2AMLogic/gf180-rcosc/spec/README.md

# spec — ratified spec + decision records

The ratified target spec table lives in the top-level
[`README.md`](../README.md#target-specification-ratified-2026-08-20-see-issues-1-and-3).
This directory holds the **decision records** that justify each ratified
value and any future change to it: per CLAUDE.md, spec changes go through a
decision record here — agents do not relax the ratified spec to make
results pass.

```
spec/
  README.md               this file
  decision-records/
    TEMPLATE.md            copy this to start a new record
    NNNN-<slug>.md          one decision per record, numbered sequentially
```

## Decision records

One page per decision: the context that forced it, the decision itself
(stated as a concrete spec change), alternatives considered, and
consequences. See [`decision-records/TEMPLATE.md`](decision-records/TEMPLATE.md)
for the format and the numbering rule (next unused `NNNN`, checked against
every filename in this directory on `main`, including superseded records).

| Record | Title | Status |
|---|---|---|
| [0001](decision-records/0001-relaxation-oscillator-topology.md) | Relaxation-oscillator topology for the trimmable RC core | Ratified |
| [0002](decision-records/0002-target-spec-ratification.md) | Target spec ratification — frequency, trim, and PVT accuracy budget | Ratified (process spread, trim range/resolution, post-trim accuracy, and Iq rows superseded by 0003) |
| [0003](decision-records/0003-pdk-sourced-process-spread-tcr-and-iq.md) | PDK-sourced process spread, temperature drift, and Iq — superseding four rows of 0002 | Ratified (Row 3 — post-trim PVT accuracy — superseded by 0016; Rows 1, 2, 4 stand) |
| [0004](decision-records/0004-no-active-tc-compensation-runtime-discipline.md) | No active temperature-coefficient compensation — rely on runtime discipline | Ratified |
| [0005](decision-records/0005-pvt-campaign-frequency-shortfall-spec-unchanged.md) | PVT campaign confirms a frequency/accuracy shortfall in the current schematic — ratified spec unchanged | Ratified (records evidence; supersedes nothing) |
| [0006](decision-records/0006-post-resize-pvt-campaign-trim-range-and-accuracy-still-unmet.md) | Post-#16-resize PVT campaign — trim range and post-trim accuracy still unmet, ratified spec unchanged | Ratified (records evidence; realized trim-curve figures superseded by 0008) |
| [0007](decision-records/0007-quiescent-current-exceeds-target-post-resize.md) | Post-#16 quiescent current exceeds DR-0003 Row 4's target — ratified spec unchanged | Ratified (records evidence; Row 4 verdict superseded by 0008) |
| [0008](decision-records/0008-iq-metric-correction-and-bias-rebalance.md) | Bias re-balance brings Iq under DR-0003 Row 4 — and the `.op` figure 0007 used is not the quantity Row 4 names | Ratified (supersedes 0007's Row 4 verdict and 0006's trim-curve figures; supersedes no ratified target; `RBIAS` sizing and trim-curve figures superseded by 0009, metric finding not) |
| [0009](decision-records/0009-running-iq-metric-basis-and-partial-trim-range-recovery.md) | Row 4's verdict basis moves to the running Iq metric — `RBIAS` re-derived, partial trim-range recovery | Ratified (supersedes 0008's `RBIAS` sizing and trim-curve figures, not its metric finding; supersedes no ratified target) |
| [0010](decision-records/0010-postlayout-pex-pvt-frequency-shift.md) | Post-layout (PEX-extracted) PVT re-verification — layout parasitics shift frequency further below the schematic-level model, ratified spec unchanged | Ratified (records evidence; supersedes nothing; post-layout figures for the post-#39 schematic superseded by 0013 — 0010 remains valid for the pre-#39 GDS pair) |
| [0011](decision-records/0011-iq-pvt-corner-factorial-row-4-exceeds-off-reference.md) | Quiescent-current PVT-corner factorial — DR-0003 Row 4 met at the reference corner, exceeds off-reference (fast process corner, hot, high supply); ratified spec unchanged | Ratified (records evidence; supersedes nothing) |
| [0012](decision-records/0012-comparator-bias-path-pvt-revision.md) | Comparator/bias-path PVT revision — self-biased current reference, post-trim residuals re-measured, ratified rows unchanged | Ratified (records evidence; supersedes no ratified row; its "layout consequence" paragraph retired by 0013) |
| [0013](decision-records/0013-bias-cell-respin-postlayout-pex-reverification.md) | Bias-cell layout re-spin against the post-#39 schematic + post-layout (PEX) PVT re-verification — parasitic shift deepens (−11.24 % … −41.42 %), ratified rows unchanged | Ratified (records evidence; supersedes 0010's post-layout figures for the post-#39 schematic) |
| [0014](decision-records/0014-trim-bank-pass-switch-restructure.md) | Trim-bank pass-switch restructure — per-position transmission-gate shunts with locally inverted pfet gates, trim range restored (±51.36 %, first `met` since DR-0005), residual supply sensitivity re-attributed | Ratified (records evidence; supersedes no ratified row; its "layout consequence" paragraph retired by 0015) |
| [0015](decision-records/0015-trim-bank-respin-postlayout-pex-reverification.md) | Trim-bank layout re-spin against the post-#43 schematic + post-layout (PEX) PVT re-verification — parasitic shift deepens on the mean (−17.46 % … −40.92 %, mean −27.32 %), ratified rows unchanged | Ratified (records evidence; supersedes 0010's and 0013's post-layout figures for the post-#43 schematic — 0013 remains valid for the post-#39, pre-#43 GDS pair) |
| [0016](decision-records/0016-comparator-latch-delay-residue-budget.md) | Comparator/latch delay residue measured and budgeted — the delay term (62–82% of the post-trim supply span) enters the post-trim accuracy arithmetic; schematic unchanged | Ratified (supersedes 0003 Row 3: at-calibration −9.2%/+6.5%, full-range +13.4%/−17.1%; circuit-side follow-up is #57) |
| [0017](decision-records/0017-low-side-comparator-pmos-respin-supply-slope.md) | Low-side comparator re-referenced to a complementary PMOS-input cell — `t_cmp_l`'s supply span collapses 24× (delay share 62–82% → 7.6–33%), Row 4's Iq margin widens 1.24 → 24.2 µA | Ratified (supersedes 0016's Row-3 re-derivation: at-calibration −2.9%/+2.0%, full-range +8.8%/−10.8%; DR-0016's instrumentation and stage findings stand) |
| [0018](decision-records/0018-comparator-pmos-respin-postlayout-pex-reverification.md) | Comparator PMOS re-spin post-layout (PEX) PVT re-verification — always-slower −18.78%…−36.86% (mean −25.65%), worst `ff`/−40 °C/3.6 V; both DR-0017 guardrails hold extracted-side (guardrail cell −31.16% under basis; every corner calibrates inner-range, `ss` at `0xF7` with ≈+4.7% headroom — the named risk) | Ratified (supersedes 0010/0013/0015 post-layout figures for the post-#60 hierarchy; no ratified spec row changes; retires 0017's post-layout deferral) |
| [0019](decision-records/0019-statistical-vs-deterministic-spec-rows-and-monte-carlo-evidence-plan.md) | Statistical vs deterministic spec rows, and the Monte Carlo evidence plan (`klt yield`, batch-fleet `monte_carlo`, after #66) | Proposed (classification and evidence plan only; no ratified spec row changes) |
| [0020](decision-records/0020-startup-time-trimmed-accuracy-band-definition.md) | Startup-time row — "within trimmed accuracy" band definition left ambiguous, bench reports all readings | Ratified (operator ruling 2026-10-16; ratified bound not changed) |
| [0021](decision-records/0021-runtime-discipline-trim-resolution-sof-loop-model.md) | Runtime-discipline row: behavioural SOF-loop model on the committed freq-vs-code data - 8-bit/0.314 %/code interface does not meet +/-0.25 % per frame (realized step 0.41-0.47 %/code mean, 0.83 % max, four non-monotone carries); meets it as a 16-64 ms mean only with a fractional-code dither; post-layout `ss` saturates at -40 C/3.0 V (-0.343 %) | Proposed (evidence record; no ratified row changed, DR-0019 row 6 stays reserved) |
| [0022](decision-records/0022-mc-matching-model-trim-ladder-resistors-and-mim-capacitor.md) | Monte Carlo matching model for the trim-ladder resistors and MIM capacitor - injected area-scaled mismatch (flagged-assumption sigmas), netlist-body multipliers, controls, claim limits | Proposed (no ratified row changed) |
| [0024](decision-records/0024-free-running-interface-no-enable-pin.md) | `rcosc_top` stays free-running - no enable/standby pin, Iq-off is not a specified quantity (operator ruling, #131); startup origin left to #82 / 0020 | Proposed (no ratified row changed) |
| [0030](decision-records/0030-item-6-monte-carlo-campaign-results-s2-ss-and-s3-ff-fail-controls-incomplete.md) | Item-6 Monte Carlo campaign results (#202): row 4 fails at `ss` (supply span wider than the ratified window), row 5 fails at `ff`, negative controls incomplete so passing cells carry no verdict; ratified spec unchanged | Proposed (records evidence; no ratified row changed) |
| [0031](decision-records/0031-row45-cause-attribution-process-offset-dominates.md) | Rows 4/5 at the fixed code (#236): process offset (ff +28.7 %, ss -20.3 %) dominates, supply/temperature terms are a few points; ideal supply or TC levers still fail (9/21, 27/63); on the DR-0017 per-die basis both rows pass; ratified spec unchanged | Proposed (records attribution; no ratified row changed) |
| [0032](decision-records/0032-rows-4-5-per-die-calibrated-basis-and-monte-carlo-on-dr0028.md) | Rows 4/5 on the DR-0017 per-die-calibrated basis (#236, ruling 2026-11-11): Monte Carlo on the DR-0028 netlist still fails row 4 at `ss` (0 %, span 5.5-6.7 vs 4.9 points) and row 5 at `ff` (92.6 %, 85 C / 3.0 V); design change proposed, ratified spec unchanged | Proposed (records basis and evidence; no ratified row changed) |
| [0033](decision-records/0033-rows-4-5-stage-attribution-and-candidate-levers.md) | Rows 4/5 stage-level attribution on the DR-0028 netlist (#314): `ss` supply span is 49 % trim-bank charge path (3.03 of 6.13 pt), `ff` 85 C / 3.0 V skew is comparator H (+6.27 of +6.88 pt); one candidate lever per row proposed, ratified spec unchanged | Proposed (attribution only; no ratified row changed) |
(docs(spec): renumber the delay-residue record 0015 -> 0016 (collision with the concurrently-landed trim-bank re-spin record))

A record is never deleted or rewritten once ratified — a later change
supersedes it with a new record rather than editing history in place (same
append-only convention as `sim/`, see [`sim/README.md`](../sim/README.md)).
A record that supersedes only *part* of an earlier one leaves that record's
own Status field alone (0002 is still "Ratified" in its own file) and is
annotated here in the index instead — `TEMPLATE.md`'s Status field models
supersession as all-or-nothing, and rewriting it would violate the
append-only rule above.
