2AMLogic/gf180-rcosc/sim/pvt-postlayout/README.md

# sim/pvt-postlayout — post-layout (PEX-extracted) PVT re-verification (issue #28)

Per `CLAUDE.md` ("Verification is the product... `sim/` results are
append-only evidence"), this directory holds the post-layout counterpart to
`sim/pvt/`'s schematic-level PVT campaign: the same corner-endpoint subset
(process = `tt`/`ff`/`ss` x temperature = -40/+27/+85 C x
VDD = 3.0/3.3/3.6 V, 27 points) re-simulated against a parasitic-annotated
netlist extracted from the full-hierarchy `layout/cells/rcosc_top.gds`
(issue #27), at the fixed post-#24 (DR-0009) single-code post-trim
methodology's own calibration code.

```
sim/pvt-postlayout/
  README.md               this file
  pex_pvt_sweep.py         the driver (issue #28)
  run-pex-pvt-sweep.sh     wrapper: regenerates netlists, then runs pex_pvt_sweep.py
  corners/<runid>/         raw ngspice logs, one per (side, operating point)
  results/<runid>/         results.csv, manifest.json, summary.md, plus the
                            extracted netlist (rcosc_top.pex.spice) and the
                            `klt extract` JSON report -- exactly what was
                            compared, committed as evidence
```

**Regenerate / extend the evidence**:

```bash
# Requires: ngspice, xschem, klt, python3, and a gf180mcuC PDK resolvable
# the same way design/regen-netlist.sh resolves it.
sim/pvt-postlayout/run-pex-pvt-sweep.sh
```

Default `--jobs` is 2 (shared hosts); grids of more than a handful of corners belong in a `klt sim` corners request (see sim/startup/README.md, Run section); this driver is for single-unit/debug use or dedicated simulation hosts.

Two knobs added by issue #61, both opt-in (the default path is
byte-identical to issue #28's flow):

- `--guardrails` additionally re-verifies the current decision record's
  schematic-basis guardrails against the extracted netlist inside the same
  run — since DR-0018, DR-0017's two: the Row-4 guardrail cell
  (`0x80`/`ff`/85 °C/3.6 V) on both sides vs the schematic baseline's own
  `pretrim` row at that cell, and a per-process (`tt`/`ff`/`ss`)
  single-point trim calibration at 27 °C/3.3 V against the ratified
  48.000 MHz target on both sides (the same binary search
  `sim/pvt/pvt_sweep.py`'s `calibrate` performs). Results land in the
  run's `guardrails.csv`, the manifest's `guardrails` key, and the
  summary's guardrail sections.
- `--baseline-runid <runid>` selects the schematic campaign explicitly.
  The default auto-picks the newest `sim/pvt/results/<runid>/` — which is
  wrong the moment the newest run is a probe campaign whose manifest
  carries no `calibration_spec_target` (exactly what happened when
  DR-0017's `20260923T030905Z` delay-probe run landed): pass
  `--baseline-runid` naming the calibration campaign the comparison
  should anchor to.

## Methodology

Each of the 27 points is simulated **twice**, sharing everything (the
`design/netlist/pvt_tb.spice` harness -- VDD/VT0..VT7 sources, transient
measurement window) except the DUT body:

- **schematic side**: `design/netlist/pvt_tb.spice` unmodified -- the exact
  netlist `sim/pvt/pvt_sweep.py` itself simulates.
- **extracted side**: the same harness with only the embedded
  `.subckt rcosc_top ... .ends` region swapped for `klt extract
  --parasitics`'s own output (header pin order rewritten to match, see
  `pex_pvt_sweep.py`'s `reorder_extracted_header` docstring).

## Why not `klt pex` / `klt sim` request JSON files verbatim

`klt pex --help` (confirmed on the installed build, `klt 0.4.0`) is real and
does exactly what its docstring says: "extract a parasitic-annotated
netlist from a routed layout (`klt extract --parasitics`), re-run one or
more `klt sim` testbench requests against it per corner, and report a
per-corner, per-spec-row schematic-vs-extracted delta." It was not used
directly here for two concrete, checked reasons:

1. **No `--deck-option`/`--pins` passthrough.** `klt extract` (the
   subcommand `klt pex` drives internally) accepts `--deck-option
   poly_res=1k --deck-option mim_cap=cap_mim_1f0_m4m5_noshield` to select
   the exact resistor sheet-rho and MiM-cap density this design commits to
   (`layout/run_checks.sh`, DR-0003 sec 5.1/6.1) -- `klt pex`'s own
   `--help` output has no equivalent flags. `poly_res` happens to default
   to this design's `1k` choice, but `mim_cap` defaults to
   `cap_mim_2f0_m4m5_noshield` (2x this design's actual 1.0 fF/um^2
   density) -- running `klt pex` directly would silently extract the
   *wrong* MiM-cap density for this design's own drawn timing capacitor,
   invalidating every delta it reports. Confirmed by reading
   `klayout_tools/decks/gf180mcu.py`'s own flavour-default documentation,
   not assumed.
2. Even with that gap fixed, `klt sim`'s request-JSON `corners.supply_v`
   axis only supports `alter <source>=<value>` (an independent-source
   magnitude), not a `.param` sweep -- and this testbench's `.meas ...
   when v(clk)=<vdd/2> rise=N` threshold needs the VDD value at `.meas`-card
   authoring time, not post-elaboration. Reusing `sim/pvt/pvt_sweep.py`'s
   own already-proven deck composition (`compose_deck`, run per point) both
   sidesteps this and is the literal "reuse `sim/pvt/`'s existing
   testbench/sweep infrastructure" the issue asks for.

`klt extract --parasitics` (the extraction half) **is** used directly, with
the correct deck options -- see `pex_pvt_sweep.py`'s `run_extract`. Both
gaps above, plus a third (`klt extract --pdk <variant> --parasitics`
annotating its one recognised MiM-cap *device* card with a non-numeric,
non-`.model`-backed flavour-name token that ngspice's native `C`-element
parser refuses to parse -- see `pex_pvt_sweep.py`'s
`CAP_MODEL_TAG_RE`/`strip_capacitor_model_annotations` docstring for the
full mechanism and the one-line fix applied here) were filed as friction
against `2AMLogic/klayout-tools` per `CLAUDE.md`'s friction protocol
(tool-generic description, no design-specific detail):
[2AMLogic/klayout-tools#1558](https://github.com/2AMLogic/klayout-tools/issues/1558).

## Committed runs

| Run id | Notes |
|---|---|
| [`20260907T131703Z`](results/20260907T131703Z/summary.md) | First post-layout PEX PVT re-verification (issue #27's `rcosc_top.gds`, issue #28). 27-point corner-endpoint subset, both sides, 0 failed runs. **Materially diverges**: schematic-vs-extracted delta is negative (slower) at every point, -1.88% to -29.52%, exceeding the +-1.1% calibration-point accuracy budget on its own. See [DR-0010](../../spec/decision-records/0010-postlayout-pex-pvt-frequency-shift.md). *Superseded for the post-#39 schematic by the issue-#44 run below; figures valid only against the pre-#39 GDS pair.* |
| [`20260921T164434Z`](results/20260921T164434Z/summary.md) | Post-layout PEX PVT re-verification of the **re-spun** bias cell (issue #44's `rcosc_bias.gds`/`rcosc_top.gds`, against the post-#39 schematic campaign `sim/pvt/results/20260921T075822Z/` at its own calibration code `0xD0`). 27-point corner-endpoint subset, both sides, 0 failed runs, 203.4 s at 8 jobs. **Materially diverges, deeper than the pre-#39 pass**: delta negative (slower) at every point, -11.24% to -41.42% (mean -19.56%), worst at `ff`/-40 C/3.6 V; in-run schematic-side cross-check vs the committed campaign: 0.00% at matched points. See [DR-0013](../../spec/decision-records/0013-bias-cell-respin-postlayout-pex-reverification.md). *Superseded for the post-#43 schematic by the issue-#50 run below; figures valid only against the pre-#43 GDS pair.* |
| [`20260922T004322Z`](results/20260922T004322Z/summary.md) | Post-layout PEX PVT re-verification of the **re-spun** trim bank (issue #50's `rcosc_trim_bank.gds`/`rcosc_top.gds`, against the post-#43 schematic campaign `sim/pvt/results/20260921T173529Z/` at its own auto-read ratified-target calibration code `0x9D`). 27-point corner-endpoint subset, both sides, 0 failed runs, 338.0 s at 8 jobs. **Materially diverges, deeper on the mean than the pre-#43 pass**: delta negative (slower) at every point, -17.46% to -40.92% (mean -27.32%), worst at `ff`/-40 C/3.6 V; in-run schematic-side cross-check vs the committed post-#43 campaign: 0.18% at matched points. See [DR-0015](../../spec/decision-records/0015-trim-bank-respin-postlayout-pex-reverification.md). *Superseded for the post-#60 schematic by the issue-#61 run below; figures valid only against the pre-#57 GDS pair.* |
| [`20260923T152954Z`](results/20260923T152954Z/summary.md) | Post-layout PEX PVT re-verification of the **DR-0017 re-spun** comparator hierarchy (`rcosc_comparator_p`/`rcosc_top.gds`, against the post-#60 schematic campaign `sim/pvt/results/20260923T030125Z/` at its own calibration code `0xA3`, selected via `--baseline-runid` — the newest `sim/pvt/results/` run is DR-0017's delay-probe campaign, which carries no calibration manifest). 27-point corner-endpoint subset, both sides, 0 failed runs, 166.3 s at 8 jobs (`klt 0.4.0` pinned per `layout/run_checks.sh`, ngspice-46, Linux host). **Materially diverges, same always-slower sign and worst-corner signature**: delta negative at every point, -18.78% to -36.86% (mean -25.65%), worst at `ff`/-40 C/3.6 V; in-run schematic-side cross-check vs the committed DR-0017 campaign: 0.00% at matched points. **Both DR-0017 guardrails hold extracted-side** (this run's `--guardrails` pass): the Row-4 guardrail cell `0x80`/`ff`/85 C/3.6 V runs 31.16% below its DR-0017 campaign basis, and every corner still calibrates inner-range against 48.000 MHz (`tt 0xA3→0xD9`, `ff 0x59→0xB3`, `ss 0xCD→0xF7`), none saturated — `ss` with 8 LSBs / ≈+4.7% headroom to `0xFF`. See [DR-0018](../../spec/decision-records/0018-comparator-pmos-respin-postlayout-pex-reverification.md). |

## `klt pex` layer (issue #70)

`klt-pex/` holds the `klt pex` testbench requests for the grader-readable
item-7 layer (`signoff/README.md`): `gen_requests.py` writes three requests
(one per VDD, tt/ff/ss x -40/27/85 C), their testbench bodies, and a schematic
DUT wrapper from `design/netlist/pvt_tb.spice`. Trim code `0xA3`. The earlier
"why not `klt pex`" reasons are resolved in the pinned build: `--deck-option` and
`--pins` now exist. Two remaining gaps are filed as klayout-tools#2890 (pin
order) and #2891 (relative include on the local backend).

Status: the 27-point grid is **not yet run**; the batch fleet runner (klt 0.5.0)
rejects every batch-capable client. The only committed `klt pex` output is the
single-corner probe in `results/20261008T220500Z/klt-pex-probe/` (tt / 27 C /
3.3 V; command in `COMMAND.txt`). The probe's testbench carries an absolute
include path (local backend), so it is not portable. To produce the full report
once a compatible client exists, run `klt pex layout/cells/rcosc_top.gds
sim/pvt-postlayout/klt-pex/request_v{30,33,36}.json` with the flags in
`COMMAND.txt` and `--backend batch`, one run per request.

## PDK revision provenance (issue #65)

New manifests carry `pdk_revision` (an open_pdks commit, or `"unknown"` with
`pdk_revision_reason`), `pdk_revision_source`, and a root-relative
`model_dir`; no absolute install paths. See [`../README.md`](../README.md)
and [`../pdk_provenance.py`](../pdk_provenance.py).

Committed runs predate the field and are not rewritten. The simulation half
of each records only family and install path; the only revision evidence is
the committed `klt extract` envelope: `open_pdks c6d73a35...` for
`20260923T152954Z`, `open_pdks f6eeac7d...` for `20260921T164434Z` and
`20260922T004322Z`. Earlier runs are not asserted here.
