2AMLogic/gf180-rcosc/WORK_PLAN.md

# Work Plan

This roadmap is generated from the current GitHub label state by the Loom Guide role.

<!-- guide:plan-body:start -->
## Operator Attention: Merge-Risk-Hold Pileup

Judge-approved PRs under a hold (`loom:blocked` or `loom:operator`) — only a human merge decision is missing.

_None._

## Very Important

`loom:very-important` (one counts per workspace); every stage takes these first.

_None._

## Important

`loom:important`; taken before unlabelled work.

- **#70**: Item 7: produce a grader-readable klt pex report for the current rcosc_top layout
- **#87**: Dense 256-code freq-vs-code sweep and trim-bank monotonicity verdict (DR-0021 follow-ups a, b)

## Ready

Human-approved issues ready for implementation (`loom:issue`).

_None._

## In Progress

Issues currently being built (`loom:building`).

- **#87**: Dense 256-code freq-vs-code sweep and trim-bank monotonicity verdict (DR-0021 follow-ups a, b)
- **#321**: Row 5: make comparator-H trip track supply to fix ff hot/low-V delay collapse

## PRs Awaiting Review

PRs waiting on Judge (`loom:review-requested`).

- **#312**: sim(trim-dense): run slice 41, 42 more sch_ff curve jobs on batch fleet (948/1536)

## Approved (Awaiting Merge)

PRs that passed review and are queued for Champion auto-merge (`loom:pr`).

_None._

## Proposed

Issues carrying `loom:curated`.

- **#87**: Dense 256-code freq-vs-code sweep and trim-bank monotonicity verdict (DR-0021 follow-ups a, b) *(curated)*
- **#204**: Move layout geometry pin klt 0.4.0 → 0.8.0 and regenerate committed cells/reports *(curated)*
- **#321**: Row 5: make comparator-H trip track supply to fix ff hot/low-V delay collapse *(curated)*

## Proposed (Architect / Hermit)

_None._

## Epics

- **#5**: Track the gap to T1 sim-validated / bronze (klayout-tools design-evidence tiers)

## Backlog Balance

| Bucket | Count |
|---|---|
| Operator merge-risk holds | 0 |
| Very important | 0 |
| Important | 2 |
| Ready (`loom:issue`) | 0 |
| In Progress (`loom:building`) | 2 |
| PRs awaiting review | 1 |
| Approved PRs awaiting merge | 0 |
| Curated | 3 |
| Architect / Hermit proposals | 0 |
| Active epics | 1 |
<!-- guide:plan-body:end -->
