2AMLogic/gf180-rcosc/.loom/docs/repo-owned-files.md

# Repo-owned files inside `.loom/`

`.loom/` is a Loom-managed tree, but it is not *exclusively* Loom's. Some of it
is an **extension point**: `.loom/hooks/post-worktree.sh`, for example, is a
file Loom never ships and always invokes (`worktree.sh` runs it after creating
a worktree), so a repo that wants per-worktree setup is *expected* to add its
own file there.

This page states the ownership rule the installer applies, and how a repo
declares "this file is mine" so an upgrade cannot delete it.

## The rule

On reinstall (`install.sh --confirm-reinstall`, `loom update`, a direct
`loom-daemon init --force`), Loom cleans each managed `.loom/` directory —
`roles/`, `scripts/`, `hooks/`, `docs/`, `runtimes/`, `bin/` — before copying
the new version in. A file already sitting in one of those directories is
**deleted only when Loom can attribute it to itself**:

| Evidence | Outcome |
|---|---|
| The current `defaults/` tree ships a file at that path | **Removed**, then immediately re-copied (net effect: refreshed) |
| The path is pinned in `.loom/resync-ignore` | **Preserved** — declared repo-owned |
| The path is listed in `.loom/install-metadata.json`'s `installed_files` | **Removed** — Loom installed it, so Loom may retire it |
| None of the above | **Preserved** and reported as unmanaged |
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
