2AMLogic/gf180-rcosc/signoff/testbench-inventory.md

# Testbench inventory (T1 item 9)

The audited artifact `signoff/testbench-envelope.json` is bound to (the
envelope pins this file's sha256; `klt signoff` re-hashes it on every grade,
and `signoff/verify-report.py` re-checks the pin in CI). Editing this file
without refreshing the envelope and the manifest pin turns item 9 `unmet`
(`stale_evidence`) and fails the verifier.

What the binding proves, and what it does not: it proves that this list is
the exact text that was audited. `klt signoff` does not re-audit a testbench
list, and it does not open the benches or the result directories named here.
`signoff/verify-report.py` additionally checks that every path in the first
column of the tables below exists in the tree. Whether each claim is
*correct* is a separate question, answered by the ratified-spec verdicts in
`docs/chipalooza/challenge-5-proposal.md` §4 (item 8), not by this list.

## Benches and their cold-start commands

Commands run from the repository root on a host with `ngspice`, `xschem`,
`python3` and a gf180mcuC PDK install (resolved from `PDK_ROOT`, or
`klt pdk find --pdk gf180mcuC`). The post-layout bench also needs `klt`.
Every wrapper regenerates `design/netlist/*.spice` from the committed
schematics first (`design/regen-netlist.sh`), so a cold start always runs
against the current design.

| path | bench | cold-start command |
|---|---|---|
| `sim/pvt/run-pvt-sweep.sh` | PVT-corner campaign: `design/pvt_tb.sch` (netlisted to `design/netlist/pvt_tb.spice`) driven by `sim/pvt/pvt_sweep.py` (full 7-process x 3-temperature x 3-supply factorial, trim curve, single-point calibration, pre-/post-trim passes) | `sim/pvt/run-pvt-sweep.sh` |
| `sim/pvt/delay_probe.py` | comparator/latch stage-delay instrumentation (issue #51); reuses `pvt_sweep.py`'s deck composition. **No wrapper script**: it does not regenerate the netlist itself | `design/regen-netlist.sh && python3 sim/pvt/delay_probe.py --cal-from sim/pvt/results/<calibration runid>` |
| `sim/iq/run-iq-sweep.sh` | quiescent-current sweep: `design/smoke_test.sch` (netlisted to `design/netlist/smoke_test.spice`, its `.control` replaced) driven by `sim/iq/iq_sweep.py` over the full 63-point PVT grid at a fixed code set | `sim/iq/run-iq-sweep.sh` |
| `sim/pvt-postlayout/run-pex-pvt-sweep.sh` | post-layout re-verification: `klt extract --parasitics` on `layout/cells/rcosc_top.gds`, then `sim/pvt-postlayout/pex_pvt_sweep.py` simulates schematic vs extracted netlist on the 27-point corner-endpoint subset | `sim/pvt-postlayout/run-pex-pvt-sweep.sh --guardrails --baseline-runid <calibration runid>` |
| `sim/startup/gen_requests.py` | startup-time bench (issue #78): `klt sim` corners requests `sim/startup/request_v{30,33,36}.json` (7 process x 3 T each, one per supply = 63 points; corner definitions imported from `sim/pvt/pvt_sweep.py`), post-processed by `sim/startup/startup_report.py`. No ngspice wrapper: the factorial is a `klt sim` batch request | `python3 sim/startup/gen_requests.py && klt sim sim/startup/request_v33.json -o OUT/v33 --format json` (see `sim/startup/README.md`) |
| `sim/mc-groundwork/run-groundwork.sh` | item-6 Monte Carlo **groundwork** (issue #77), not a spec-row claim: per-sample trim-code selection bench (`sim/mc-groundwork/tb_trimsel_nomm.spice`, `tb_trimsel_mm.spice`), fixed-code reference (`tb_fixedcode.spice`) and the `klt sim` requests, generated by `sim/mc-groundwork/gen_bench.py` from `design/netlist/pvt_tb.spice`; the committed smoke run (3-sample zero-mismatch control, 5-sample mismatch smoke) is `sim/mc-groundwork/results/20261008T235620Z/`. Records the model mismatch-feasibility verdict in `sim/mc-groundwork/README.md`. **No yield is run or claimed** | `sim/mc-groundwork/run-groundwork.sh` (needs `klt`; the multi-sample requests go to the batch fleet on a host exporting `KLT_SIM_BACKEND=batch`, which was not usable on 2026-10-08; the committed smoke run was a `--backend local` fallback, a deviation from the batch-only host rule, see its README) |
| `sim/mc/run-campaign.sh` | item-6 Monte Carlo **campaign** (issue #202; DR-0019 S1-S3, DR-0022 matching model): per-die trim-selection bench on the **P3 extracted netlist** (`sim/recentre/p3/rcosc_top_p3.spice`, DR-0023, proposed) with the DR-0022 injector applied, generated by `sim/mc/gen_campaign.py`; each die is calibrated at 27 C / 3.3 V then holds its code at 3 supplies x 3 temperatures; 500 samples per process corner (tt/ff/ss), seed 20261008, `klt sim` `monte_carlo` requests sharded on the batch fleet; controls: zero-mismatch, 3x inflated, injected-term sensitivity. Graded by `sim/mc/grade.sh` (`klt yield` at the repo pin) into `sim/mc/results/20261106T072000Z/`; raw reports in `sim/mc/results/20261106T051700Z/`, `20261106T061800Z/`, `20261106T070700Z/`. Pipeline validation runs: `20261106T052000Z`, `20261106T052500Z`, `20261106T053000Z`. Result and verdict: `sim/mc/README.md`, DR-0030 | `sim/mc/run-campaign.sh <new runid> [case ...]` then `sim/mc/grade.sh <new gradeid> <run dir> ...` (needs `klt` with batch access; every case is a `klt sim` request and none runs a local ngspice loop) |
| `sim/temperature/prepare.py` | interior-temperature curvature bench (issue #125), **offline preparation only, measured status pending**: three `klt sim` requests (tt/ss/ff, 12 temperatures -40..85 C including 27 C, 3.3 V, no added clk load = 36 points) at the per-process ratified-target codes held from `sim/pvt/results/20260923T030125Z` (0xA3/0xCD/0x59), reusing `sim/waveform/prepare.py`'s DUT extraction, bench and request builders; post-processed by `sim/temperature/analyze.py` (slopes, residual vs the -40/27/85 C piecewise-linear interpolation, 100 ppm diagnostic tolerance). Generated files are written to a new directory, not committed. Schematic equivalence with the calibration revision is recorded as unverified. **No measurement exists and no figure is claimed** | `python3 -I sim/temperature/prepare.py --cal-run sim/pvt/results/20260923T030125Z --out <new dir>`, then `klt sim <new dir>/request_t12_<proc>.json -o OUT/<proc> --format json --backend batch` (later campaign; see `sim/temperature/README.md`) |
| `design/run-smoke-test.sh` | functional/DC bring-up bench `design/smoke_test.sch`: `.op` plus a short transient at code `0x80`. Appends to `design/netlist/smoke_test.log`. **Not a spec-row claim** | `design/run-smoke-test.sh` |

Supporting bench sources (each listed so it is visible that it is committed):

| path | role |
|---|---|
| `design/pvt_tb.sch` | the PVT testbench schematic (DUT + VDD/VT0..VT7 sources + measurement window) |
| `design/smoke_test.sch` | the bring-up testbench schematic; also the DUT harness the Iq sweep reuses |
| `sim/pvt/pvt_sweep.py` | PVT campaign driver; owns the process-corner, temperature and supply definitions the other drivers import |
| `sim/iq/iq_sweep.py` | Iq sweep driver |
| `sim/pvt-postlayout/pex_pvt_sweep.py` | post-layout sweep driver |
| `sim/startup/startup_report.py` | startup-time post-processor |
| `sim/mc-groundwork/gen_bench.py` | Monte Carlo groundwork bench and request generator (issue #77) |
| `sim/mc/gen_campaign.py` | item-6 campaign bench, request and limits generator (issue #202); offline tests in `sim/mc/test_gen_campaign.py` |
| `sim/mc/analyze.py` | control and per-die summary of a graded campaign (issue #202) |
| `sim/mc/grade.sh` | `klt yield-samples` + `klt yield` grading of the campaign reports (issue #202) |
| `sim/temperature/analyze.py` | interior-temperature slope/curvature analyzer (issue #125); tested on synthetic fixtures only |

A cold start reproduces the *method* against the *current* design. It does
not reproduce a historical run's numbers when the design has changed since
then. To reproduce a historical figure, check out the run's recorded
`git_sha`. Several runs below record `git_dirty: true` (uncommitted changes
were present when they ran), so that checkout is close to the run's tree,
not guaranteed identical to it.

## Claimed measurements, bench, and recorded PDK identity

Every measured figure the top-level `README.md` spec table and maturity
ladder, or `docs/chipalooza/challenge-5-proposal.md` §4, currently quotes is
listed here against the committed run it comes from. Superseded runs under
`sim/*/results/` were produced by the same benches and remain as
append-only history (indexed in `sim/README.md`). They are not current
claims, so they are not listed one by one.

| path | claim(s) it backs | bench | git sha (dirty?) | PDK identity the run records |
|---|---|---|---|---|
| `sim/pvt/results/20260907T090653Z/summary.md` | char. report rows 1-4, 8, 11: max reachable 58.9870 MHz; trim range ±35.50%; 0.4317 %/code average step; untrimmed spread −26.34%/+42.68%; 3.0/3.3/3.6 V and −40/27/85 °C exercised | `sim/pvt/run-pvt-sweep.sh` | `1362e1a` (dirty) | family `gf180mcuC` + install root path only. **No revision** |
| `sim/pvt/results/20260921T075822Z/summary.md` | char. report rows 5-6: post-trim accuracy, global-code and per-corner-code methodologies, calibration point and full temperature range | `sim/pvt/run-pvt-sweep.sh` | `1ac4434` (dirty) | family `gf180mcuC` + install root path only. **No revision** |
| `sim/pvt/results/20260923T030125Z/summary.md` | README spec table: measured supply span at per-corner calibrated codes (−2.07%/+1.17%) behind the DR-0017 post-trim rows; also the calibration baseline the post-layout run anchors to | `sim/pvt/run-pvt-sweep.sh` | `ed26786` (clean) | family `gf180mcuC` + install root path only. **No revision** |
| `sim/pvt/results/20260922T004823Z/summary.md` | README spec table: delay share of the supply span before the issue #57 re-reference (62-82%, DR-0016) | `sim/pvt/delay_probe.py` | `bd57830` (dirty) | family `gf180mcuC` + install root path only. **No revision** |
| `sim/pvt/results/20260923T030905Z/summary.md` | README spec table: delay share of the supply span after the issue #57 re-reference (7.6-33%) | `sim/pvt/delay_probe.py` (`--cal-from` `20260923T030125Z`) | `ed26786` (dirty) | family `gf180mcuC` + install root path only. **No revision** |
| `sim/iq/results/20260921T091042Z/README.md` | char. report row 9: running Iq at the reference corner (worst 330.38 µA at `0xFF`) and over the full 63-point grid (541.85 µA at `0xC0`, `ff`/85 °C/3.6 V) | `sim/iq/run-iq-sweep.sh` | `1ac4434` (dirty) | `manifest.json` records the install root path only. The family name `gf180mcuC` appears only in the generated `README.md`. **No revision** |
| `sim/pvt-postlayout/results/20260923T152954Z/summary.md` | char. report post-layout divergence note and README maturity ladder: extracted runs −18.78% to −36.86% slower than the schematic at `0xA3` (mean −25.65%); DR-0017 guardrails held extracted-side; `ss` calibrates at `0xF7` | `sim/pvt-postlayout/run-pex-pvt-sweep.sh` (`--guardrails --baseline-runid 20260923T030125Z`) | `89399c6` (dirty) | `manifest.json`: family `gf180mcuC` + install root path. The committed `rcosc_top.pex.extract.json` (the `klt extract` half) records `open_pdks c6d73a35f524070e85faff4a6a9eef49553ebc2b` for the install it resolved under the same root. The simulation half does not record a revision of its own |
| `sim/startup/results/20261106T052948Z/summary.md` | char. report row 10, **simulated** (ngspice-46, pre-layout schematic netlist) on the **pre-re-centre schematic at `0xA3`** (before DR-0023/DR-0028; history, not the current design): 61/63 PASS, 2 FAIL, under the DR-0020 definition (+/-1.1% of final mean period, 8-cycle windows, <= 10 µs from ramp start, trim `0xA3`): worst passing settle 1.174 µs (`ss`/-40 °C/3.0 V); `ff`/-40 °C at 3.3 V and 3.6 V FAIL the settled-tail steadiness check (0.78% / 0.61% vs 0.5%). Relative settling only: not a target-accurate / USB-ready clock claim | `sim/startup/gen_requests.py` + `klt sim` on the batch backend (jobs `klt-sim-971dfc731fe7`, `klt-sim-b591e450d02c`, `klt-sim-fbe71ced6e21`) + `startup_report.py` | `d157152e` (base; tree dirty with the result dir only) | `klt sim` reports record the models-lib sha256; runner `eda-batch-runner` v11, family `gf180mcuC`, open_pdks `f6eeac7`; no revision |
| `sim/startup-settled/results/20261106T061500Z/summary.md` | char. report row 10, **simulated**, current design before DR-0028 (settled P3 netlist, trim `0xA9`, DR-0020 analysis): 61/63 start; `fs`/-40 °C at 3.3 V and 3.6 V NON-START (#227) | `sim/startup-settled/` requests + `klt sim` on the batch backend + `settled_report.py` | per the run's `manifest.json` | batch-fleet `klt sim` reports; PDK revision not independently re-checked in this PR |
| `sim/startup-settled/results/20261106T0735Z/summary.md` | char. report row 10, **simulated**, current design on the DR-0028 comparator-H stage (trim `0xA9`): 63/63 pass the primary band, worst settle 1.54 µs, 0 NON-START | same, with `sim/cmph-fix/` netlist (#229) | per the run's `manifest.json` | batch-fleet `klt sim` reports (jobs `klt-sim-829a270ff52b`, `klt-sim-58ef1d67a0ce`, `klt-sim-4e366a98ed46`); PDK revision not independently re-checked in this PR |
| `sim/startup/results/20261008T235538Z/summary.md` | char. report row 10 (**partial**): two single-corner local probes only (`ss`/-40 °C/3.0 V settles 1.174 µs, `tt`/27 °C/3.3 V 0.891 µs, at ±1.1%); the 63-point factorial did not run (fleet runner klt 0.5.0 vs client 0.7.0; failed submissions in `sim/startup/batch-attempts/`) | `sim/startup/gen_requests.py` + `klt sim` (`--backend local` for the probes) | `b5d4f5c` (base; the bench files were uncommitted when run) | `klt sim` report records the models-lib sha256; family `gf180mcuC`; no revision |
| `design/netlist/smoke_test.log` | bring-up only: the block oscillates at `0x80`, `.op` sanity values. **No spec-row claim** | `design/run-smoke-test.sh` | not recorded | **None**: the log records the ngspice version and run time, not the PDK family or revision |

### PDK identity, stated plainly

- **Family name only, no revision:** every pre-layout PVT campaign and both
  delay-probe runs above. Their manifests record `pdk: "gf180mcuC"` and the
  install root path, nothing that identifies the open_pdks/volare revision
  of the model files.
- **Install path only in the manifest, family name only in the README:**
  the Iq run.
- **Revision recorded (extraction only):** the current post-layout run's
  `klt extract` envelope records an open_pdks commit. The ngspice side of
  the same run records family and root only. Earlier post-layout runs
  record a different commit
  (`20260921T164434Z`/`20260922T004322Z`: `open_pdks
  f6eeac7dad085ffcc829ccfd721f7b4ce39edcf7`). Different runs were
  therefore not guaranteed to use the same PDK revision.
- **Nothing recorded:** the smoke-test log.

The historical revision behind a family-only run is **unknown**. It is not
reconstructed here and must not be assumed. New runs
(issue #65) record `pdk_revision`, or an explicit `"unknown"` with a reason,
through the shared `sim/pdk_provenance.py`, with no absolute install path.
Every record listed above predates that and is unchanged; its PDK identity
stays as disclosed here.

## Spec rows with no measurement claimed (no bench expected)

- Ratified row "Runtime-disciplined accuracy" (characterization report
  row 7): reserved, not designed (DR-0004). No measurement is claimed and
  no bench exists.
- Ratified row "Startup time" (characterization report row 10): **simulated
  (not measured; no silicon exists)** (issue #82) under the operator-ratified
  DR-0020 definition (relative settling, +/-1.1% of final mean period,
  <= 10 µs from ramp start). Two designs are graded: the pre-re-centre
  schematic at fixed trim `0xA3` (`sim/startup/results/20261106T052948Z/`,
  history) is 61/63 PASS, 2 FAIL (`ff`/-40 °C at 3.3 V and 3.6 V fail the
  settled-tail steadiness check); the current design is in
  `sim/startup-settled/results/` at trim `0xA9`: 61/63 on the DR-0023 settled
  netlist (`fs`/-40 °C NON-START, #227) and 63/63 on the DR-0028 stage (worst
  settle 1.54 µs). The trim-code clause of DR-0020 (`0xA3` vs the design's
  `0xA9`) awaits an operator ruling, so the row is not claimed as passed
  under a conforming code. Relative
  settling does not imply target-accurate or USB-ready clock availability;
  that is graded by the separate frequency and PVT-accuracy rows.
- Monte Carlo / statistical (item 6): **run, and not a pass.** The campaign
  (issue #202, `sim/mc/`) ran 500 samples per process corner on the P3 netlist
  under the DR-0022 flagged matching model. Row 4 fails at `ss` (0 % yield) and
  row 5 fails at `ff` (60.4 % yield); the remaining row sets pass at the
  point-estimate level, but the negative controls were not detected for most of
  them and the sensitivity control missed on one transition, so those carry no
  verdict (`sim/mc/README.md`, DR-0030). Item 6 grades `unmet`. The
  groundwork `sim/mc-groundwork/` (issue #77) holds the per-sample bench
  and the mismatch-model feasibility verdict.
- Interior-temperature curvature (between the -40/27/85 C grid points):
  **prepared offline only, measured status pending** (issue #125). The
  bench `sim/temperature/` exists and is exercised by synthetic-fixture
  tests; no corner has been simulated, so no curvature or monotonicity is
  claimed. The discipline plant (DR-0021, `sim/discipline/`) stays based on
  the three committed temperatures.

## Audit (issue #64, against `origin/main` @ `dfb95bf`)

- Every path above is committed (`git ls-files`).
- Each claim row was checked against the cited run's committed
  `manifest.json`/`summary.md` (git sha, dirty flag, PDK fields) and the
  figure as quoted in `README.md` / `docs/chipalooza/challenge-5-proposal.md`.
- The committed testbench netlists `design/netlist/pvt_tb.spice` and
  `design/netlist/smoke_test.spice` were re-derived from the committed
  schematics into a scratch directory and compared after the same
  normalisation as item 1's audit (continuations, blank lines, `sch_path`/
  `sym_path` comments): **identical**.
- No simulation was re-run for this audit.
