2AMLogic/gf180-rcosc/sim/iq/results/20260923T031214Z/README.md

# Quiescent current (Iq) PVT-corner sweep 20260923T031214Z — issue #35

Generated by `sim/iq/iq_sweep.py` (issue #22, extended #24, extended
to a full PVT-corner factorial by issue #35). Append-only evidence:
this file, `results.csv`, `manifest.json` and every raw log under
`sim/iq/corners/20260923T031214Z/` belong to this run id and are never
rewritten by a later run.

| | |
|---|---|
| git sha | `ed26786191202a85a71b6938563c45a1eaaa5582` (dirty tree) |
| ngspice | ** ngspice-46 : Circuit level simulation program |
| PDK | gf180mcuC @ `/home/ubuntu/.volare` |
| netlist | `design/netlist/smoke_test.spice` (from `design/smoke_test.sch`) |
| sizing | `as-committed` only (see module docstring for why `pre-22` is not part of the grid) |
| subset | `full` (7 process corner(s) x 3 T x 3 V = 63 points/code) |
| codes | 0x00, 0x80, 0xC0, 0xFF |
| total grid points | 252 (0 failed) |
| wall clock | 221.7 s at 8 jobs |
| target | DR-0003 Row 4: `< 500 µA` (running) |
| Row 4 verdict basis | `iq_run` (DR-0009) -- `iq_op` reported for continuity only, per DR-0008/DR-0009 |

## Two metrics, reported together

- **`iq_op`** — `-1e6*i(vdd)` at the `.op` point: the measurement
  issue #20 introduced and [DR-0007] quoted. A relaxation oscillator
  has no stable DC operating point, so this solve converges on the
  unstable equilibrium, which pins the charge-complete comparator
  `XCMPH` at its own output inverter's trip point — holding that
  buffer, and the SR-latch NOR gate its mid-rail output drives, in
  full crowbar conduction, a state the running circuit passes through
  but never rests in. The `.op` node voltages printed into every raw
  log under `../../corners/` show this directly. Reported unchanged
  for continuity with DR-0007.
- **`iq_run`** — `-i(vdd)` averaged over 20 whole oscillation periods
  (rising edges 5..25 of `clk`, startup skipped). This is the quantity
  DR-0003 Row 4 names: `< 500 µA` **(running)**, anchored to ST
  DS9826's `IDDA(HSI48)` — a datasheet supply current for an
  oscillator that is oscillating.

**Issue #35 addition**: both metrics are now measured at every grid
point of the full process x temperature x supply factorial, not just
the single reference corner (`tt`/27 °C/3.3 V) prior runs used. Row 4's
verdict per code below is stated at the **worst-case corner** (the
grid point with the highest `iq_run` at that code), with the
reference-corner value given alongside it for continuity with
DR-0009's own reference-corner figures.

## Sweep matrix

| Axis | Values | Count |
|---|---|---|
| process (fets / res / mimcap `.lib` sections) | `tt`, `ff`, `ss`, `fs`, `sf`, `rc_f`, `rc_s` | 7 |
| temperature | -40 °C, 27 °C, 85 °C | 3 |
| supply | 3 V, 3.3 V, 3.6 V | 3 |
| trim code | 0x00, 0x80, 0xC0, 0xFF | 4 |
| **grid points, this run** | | **252** |

Corner definitions (`PROCESS_CORNERS`/`TEMPS_C`/`VDDS_V`/
`corner_include()`) are imported from `sim/pvt/pvt_sweep.py`
verbatim, not re-typed, so the frequency and Iq campaigns cannot
disagree about what a corner is (issue #35).

## Full grid results (every point)

One matrix per trim code. Each cell is `iq_run (iq_op)` in µA;
`iq_run` is **bold** where it is at or above the 500 µA target
(Row 4's verdict basis, DR-0009). `iq_op` is reported alongside for
continuity only — see "Two metrics" above.

### code `0x00`

| process | T (°C) | 3 V | 3.3 V | 3.6 V |
|---|---|---|---|---|
| `tt` | -40 | 156.21 (414.15) | 180.38 (542.75) | 210.82 (685.83) |
| `tt` | 27 | 202.36 (437.19) | 226.48 (547.21) | 255.75 (668.68) |
| `tt` | 85 | 249.06 (470.60) | 273.95 (569.32) | 302.77 (677.26) |
| `ff` | -40 | 227.38 (592.30) | 264.26 (747.89) | 308.49 (916.97) |
| `ff` | 27 | 293.17 (616.50) | 329.25 (748.62) | 370.34 (891.06) |
| `ff` | 85 | 361.45 (659.83) | 398.82 (777.08) | 438.88 (902.57) |
| `ss` | -40 | 113.96 (272.22) | 130.43 (149.89) | 150.99 (505.42) |
| `ss` | 27 | 149.12 (309.28) | 165.78 (398.51) | 185.79 (499.50) |
| `ss` | 85 | 183.82 (338.93) | 201.01 (419.80) | 221.25 (510.32) |
| `fs` | -40 | 166.13 (415.26) | 193.18 (544.95) | 224.32 (689.10) |
| `fs` | 27 | 209.53 (436.81) | 235.01 (547.42) | 264.13 (669.33) |
| `fs` | 85 | 253.78 (468.42) | 279.06 (567.32) | 307.56 (675.15) |
| `sf` | -40 | 150.13 (414.98) | 173.97 (541.58) | 204.71 (682.57) |
| `sf` | 27 | 199.43 (439.09) | 223.87 (547.87) | 253.46 (668.05) |
| `sf` | 85 | 249.55 (474.22) | 274.75 (572.14) | 304.19 (679.35) |
| `rc_f` | -40 | 203.93 (455.76) | 231.22 (586.55) | 264.94 (732.13) |
| `rc_f` | 27 | 272.87 (501.54) | 300.75 (614.20) | 333.52 (738.45) |
| `rc_f` | 85 | 337.70 (560.14) | 372.85 (662.62) | 407.24 (773.82) |
| `rc_s` | -40 | 127.26 (389.41) | 149.42 (516.55) | 177.41 (657.97) |
| `rc_s` | 27 | 161.18 (400.42) | 183.20 (508.77) | 209.99 (628.41) |
| `rc_s` | 85 | 194.86 (420.64) | 217.20 (517.40) | 243.40 (623.26) |

### code `0x80`

| process | T (°C) | 3 V | 3.3 V | 3.6 V |
|---|---|---|---|---|
| `tt` | -40 | 176.70 (175.97) | 204.22 (146.33) | 237.46 (693.06) |
| `tt` | 27 | 224.00 (443.63) | 251.41 (554.44) | 283.61 (676.77) |
| `tt` | 85 | 271.61 (477.54) | 299.68 (577.18) | 331.58 (686.23) |
| `ff` | -40 | 253.78 (599.73) | 294.90 (756.25) | 342.57 (926.35) |
| `ff` | 27 | 321.38 (624.85) | 360.95 (758.20) | 406.23 (902.11) |
| `ff` | 85 | 390.94 (669.49) | 431.97 (788.11) | 475.78 (915.30) |
| `ss` | -40 | 130.09 (288.98) | 149.10 (355.00) | 172.53 (511.36) |
| `ss` | 27 | 166.36 (314.56) | 185.57 (404.40) | 208.39 (506.05) |
| `ss` | 85 | 201.77 (344.53) | 221.55 (426.09) | 244.61 (517.34) |
| `fs` | -40 | 186.54 (421.07) | 216.73 (551.42) | 250.93 (696.27) |
| `fs` | 27 | 231.24 (443.27) | 259.78 (554.65) | 292.25 (677.44) |
| `fs` | 85 | 276.95 (475.77) | 305.09 (575.42) | 336.91 (684.31) |
| `sf` | -40 | 170.52 (420.91) | 197.23 (548.20) | 231.23 (689.94) |
| `sf` | 27 | 220.90 (445.60) | 248.24 (555.17) | 280.86 (676.22) |
| `sf` | 85 | 271.74 (481.17) | 300.01 (580.00) | 332.47 (688.25) |
| `rc_f` | -40 | 228.42 (463.06) | 259.97 (594.75) | 297.60 (741.25) |
| `rc_f` | 27 | 299.32 (509.61) | 330.82 (623.27) | 367.43 (748.58) |
| `rc_f` | 85 | 366.33 (569.39) | 404.64 (672.67) | 442.45 (785.01) |
| `rc_s` | -40 | 144.47 (130.45) | 169.58 (521.91) | 200.36 (663.91) |
| `rc_s` | 27 | 179.60 (405.74) | 204.25 (514.75) | 233.66 (635.12) |
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
| `rc_f` | 85 | 403.96 (582.27) | 446.56 (686.94) | 489.17 (801.04) |
| `rc_s` | -40 | 168.49 (401.62) | 197.31 (530.37) | 232.21 (673.46) |
| `rc_s` | 27 | 204.78 (413.77) | 233.21 (523.97) | 266.60 (645.55) |
| `rc_s` | 85 | 240.03 (434.88) | 268.93 (533.74) | 301.38 (642.01) |

### code `0xFF`

| process | T (°C) | 3 V | 3.3 V | 3.6 V |
|---|---|---|---|---|
| `tt` | -40 | 311.37 (462.20) | 362.31 (598.98) | 419.37 (751.38) |
| `tt` | 27 | 354.70 (485.10) | 405.66 (603.79) | 461.65 (734.97) |
| `tt` | 85 | 399.03 (518.85) | 449.86 (626.50) | **504.78** (744.60) |
| `ff` | -40 | 424.63 (653.52) | 493.65 (820.68) | **569.41** (1002.84) |
| `ff` | 27 | 486.63 (678.53) | **554.20** (822.75) | **627.59** (978.98) |
| `ff` | 85 | **556.87** (726.04) | **622.25** (854.61) | **691.71** (993.85) |
| `ss` | -40 | 239.29 (323.85) | 277.59 (433.21) | 321.00 (558.25) |
| `ss` | 27 | 271.80 (348.37) | 310.87 (444.19) | 353.91 (552.49) |
| `ss` | 85 | 303.67 (377.64) | 343.14 (465.37) | 386.10 (563.45) |
| `fs` | -40 | 320.71 (461.71) | 374.90 (600.71) | 434.12 (755.38) |
| `fs` | 27 | 363.24 (483.83) | 415.73 (603.89) | 472.07 (736.31) |
| `fs` | 85 | 409.81 (519.21) | 459.13 (626.02) | **512.98** (743.71) |
| `sf` | -40 | 306.88 (465.68) | 355.51 (599.83) | 412.11 (749.22) |
| `sf` | 27 | 351.39 (489.21) | 401.23 (606.01) | 456.81 (735.11) |
| `sf` | 85 | 397.73 (524.05) | 448.10 (630.37) | **503.33** (746.97) |
| `rc_f` | -40 | 381.38 (510.62) | 440.43 (650.98) | **506.29** (807.41) |
| `rc_f` | 27 | 446.01 (555.88) | **504.10** (678.48) | **568.64** (813.83) |
| `rc_f` | 85 | **514.70** (618.17) | **575.81** (729.00) | **638.33** (850.63) |
| `rc_s` | -40 | 264.50 (432.16) | 310.00 (566.43) | 361.13 (716.01) |
| `rc_s` | 27 | 297.86 (443.38) | 343.16 (559.40) | 392.96 (687.67) |
| `rc_s` | 85 | 329.87 (463.95) | 374.86 (568.80) | 423.79 (683.90) |

## Per-code worst case (Row 4 verdict basis)

| code | worst-case corner | `iq_run` (µA) | verdict | reference corner (`tt`/27 °C/3.3 V) `iq_run` (µA) | verdict |
|---|---|---|---|---|---|
| `0x00` | `ff` / 85 °C / 3.6 V | 438.88 | met | 226.48 | met |
| `0x80` | `ff` / 85 °C / 3.6 V | 475.78 | met | 251.41 | met |
| `0xC0` | `ff` / 85 °C / 3.6 V | 525.07 | **exceeds** | 285.21 | met |
| `0xFF` | `ff` / 85 °C / 3.6 V | 691.71 | **exceeds** | 405.66 | met |

**DR-0003 Row 4 verdict, per code, at the worst-case corner over the
full grid** — see table above. A code's verdict is `met`
only if `iq_run` stays under 500 µA at every one of that code's
63 grid points; the worst-case
row is exactly the maximum over that grid, so "met" in the table
above means met everywhere for that code.

[DR-0007]: ../../../../spec/decision-records/0007-quiescent-current-exceeds-target-post-resize.md
