2AMLogic/gf180-rcosc/sim/iq/results/20260921T181049Z/README.md

# Quiescent current (Iq) PVT-corner sweep 20260921T181049Z — issue #35

Generated by `sim/iq/iq_sweep.py` (issue #22, extended #24, extended
to a full PVT-corner factorial by issue #35). Append-only evidence:
this file, `results.csv`, `manifest.json` and every raw log under
`sim/iq/corners/20260921T181049Z/` belong to this run id and are never
rewritten by a later run.

| | |
|---|---|
| git sha | `bfeb95d917d10a18201b232296ea0cefff7586c4` (dirty tree) |
| ngspice | ** ngspice-46 : Circuit level simulation program |
| PDK | gf180mcuC @ `/Users/rwalters/.ciel` |
| netlist | `design/netlist/smoke_test.spice` (from `design/smoke_test.sch`) |
| sizing | `as-committed` only (see module docstring for why `pre-22` is not part of the grid) |
| subset | `full` (7 process corner(s) x 3 T x 3 V = 63 points/code) |
| codes | 0x00, 0x80, 0xC0, 0xFF |
| total grid points | 252 (0 failed) |
| wall clock | 699.7 s at 6 jobs |
| target | DR-0003 Row 4: `< 500 µA` (running) |
| Row 4 verdict basis | `iq_run` (DR-0009) -- `iq_op` reported for continuity only, per DR-0008/DR-0009 |

## Two metrics, reported together

- **`iq_op`** — `-1e6*i(vdd)` at the `.op` point: the measurement
  issue #20 introduced and [DR-0007] quoted. A relaxation oscillator
  has no stable DC operating point, so this solve converges on the
  unstable equilibrium, which pins the charge-complete comparator
  `XCMPH` at its own output inverter's trip point — holding that
  buffer, and the SR-latch NOR gate its mid-rail output drives, in
  full crowbar conduction, a state the running circuit passes through
  but never rests in. The `.op` node voltages printed into every raw
  log under `../../corners/` show this directly. Reported unchanged
  for continuity with DR-0007.
- **`iq_run`** — `-i(vdd)` averaged over 20 whole oscillation periods
  (rising edges 5..25 of `clk`, startup skipped). This is the quantity
  DR-0003 Row 4 names: `< 500 µA` **(running)**, anchored to ST
  DS9826's `IDDA(HSI48)` — a datasheet supply current for an
  oscillator that is oscillating.

**Issue #35 addition**: both metrics are now measured at every grid
point of the full process x temperature x supply factorial, not just
the single reference corner (`tt`/27 °C/3.3 V) prior runs used. Row 4's
verdict per code below is stated at the **worst-case corner** (the
grid point with the highest `iq_run` at that code), with the
reference-corner value given alongside it for continuity with
DR-0009's own reference-corner figures.

## Sweep matrix

| Axis | Values | Count |
|---|---|---|
| process (fets / res / mimcap `.lib` sections) | `tt`, `ff`, `ss`, `fs`, `sf`, `rc_f`, `rc_s` | 7 |
| temperature | -40 °C, 27 °C, 85 °C | 3 |
| supply | 3 V, 3.3 V, 3.6 V | 3 |
| trim code | 0x00, 0x80, 0xC0, 0xFF | 4 |
| **grid points, this run** | | **252** |

Corner definitions (`PROCESS_CORNERS`/`TEMPS_C`/`VDDS_V`/
`corner_include()`) are imported from `sim/pvt/pvt_sweep.py`
verbatim, not re-typed, so the frequency and Iq campaigns cannot
disagree about what a corner is (issue #35).

## Full grid results (every point)

One matrix per trim code. Each cell is `iq_run (iq_op)` in µA;
`iq_run` is **bold** where it is at or above the 500 µA target
(Row 4's verdict basis, DR-0009). `iq_op` is reported alongside for
continuity only — see "Two metrics" above.

### code `0x00`

| process | T (°C) | 3 V | 3.3 V | 3.6 V |
|---|---|---|---|---|
| `tt` | -40 | 166.14 (445.08) | 194.02 (578.58) | 226.05 (727.64) |
| `tt` | 27 | 214.27 (480.36) | 242.34 (595.00) | 273.08 (721.83) |
| `tt` | 85 | 260.57 (525.44) | 290.10 (629.16) | 321.31 (742.37) |
| `ff` | -40 | 243.74 (638.93) | 282.34 (801.50) | 325.05 (978.68) |
| `ff` | 27 | 311.33 (680.05) | 349.37 (818.70) | 390.69 (968.38) |
| `ff` | 85 | 374.02 (734.92) | 417.87 (863.26) | 460.06 (996.54) |
| `ss` | -40 | 119.24 (156.92) | 138.95 (412.05) | 162.54 (534.52) |
| `ss` | 27 | 155.52 (340.27) | 176.32 (432.70) | 199.61 (537.64) |
| `ss` | 85 | 190.25 (379.04) | 212.44 (463.33) | 236.30 (557.73) |
| `fs` | -40 | 180.14 (449.66) | 211.68 (585.25) | 247.29 (736.34) |
| `fs` | 27 | 226.80 (482.54) | 257.31 (598.55) | 290.79 (726.57) |
| `fs` | 85 | 270.87 (524.28) | 303.36 (629.30) | 336.57 (743.10) |
| `sf` | -40 | 156.25 (69.25) | 180.42 (573.95) | 208.83 (719.98) |
| `sf` | 27 | 204.88 (480.30) | 230.47 (592.98) | 259.01 (717.84) |
| `sf` | 85 | 252.10 (528.09) | 280.12 (630.30) | 309.48 (742.17) |
| `rc_f` | -40 | 215.19 (496.94) | 247.83 (633.13) | 284.44 (785.25) |
| `rc_f` | 27 | 284.76 (560.75) | 318.89 (678.90) | 355.48 (809.28) |
| `rc_f` | 85 | 338.00 (620.15) | 385.54 (740.58) | 427.51 (862.22) |
| `rc_s` | -40 | 136.03 (414.36) | 160.78 (546.08) | 189.70 (693.09) |
| `rc_s` | 27 | 172.11 (434.30) | 196.52 (546.86) | 223.53 (671.43) |
| `rc_s` | 85 | 206.61 (463.27) | 231.37 (564.16) | 258.05 (674.67) |

### code `0x80`

| process | T (°C) | 3 V | 3.3 V | 3.6 V |
|---|---|---|---|---|
| `tt` | -40 | 186.94 (450.90) | 218.01 (585.09) | 253.02 (734.87) |
| `tt` | 27 | 236.67 (486.80) | 267.97 (602.23) | 301.96 (729.93) |
| `tt` | 85 | 284.18 (532.38) | 316.91 (637.02) | 351.25 (751.34) |
| `ff` | -40 | 270.63 (646.35) | 313.36 (809.85) | 360.05 (988.06) |
| `ff` | 27 | 340.37 (688.40) | 382.30 (828.27) | 427.70 (979.43) |
| `ff` | 85 | 405.31 (744.57) | 452.75 (874.28) | 498.76 (1009.27) |
| `ss` | -40 | 135.80 (310.60) | 157.99 (186.39) | 184.29 (540.45) |
| `ss` | 27 | 173.28 (345.54) | 196.84 (438.60) | 222.70 (544.19) |
| `ss` | 85 | 209.01 (384.63) | 233.79 (469.61) | 260.21 (564.75) |
| `fs` | -40 | 201.12 (455.47) | 235.82 (591.73) | 274.80 (743.50) |
| `fs` | 27 | 249.28 (488.99) | 283.05 (605.77) | 319.67 (734.67) |
| `fs` | 85 | 295.07 (531.63) | 330.57 (637.40) | 366.75 (752.26) |
| `sf` | -40 | 176.95 (258.20) | 204.41 (580.56) | 236.31 (727.34) |
| `sf` | 27 | 227.02 (486.81) | 255.90 (600.28) | 287.67 (726.01) |
| `sf` | 85 | 275.34 (535.03) | 306.65 (638.16) | 339.19 (751.07) |
| `rc_f` | -40 | 240.30 (504.24) | 276.78 (641.32) | 317.49 (794.37) |
| `rc_f` | 27 | 312.08 (568.82) | 350.06 (687.98) | 390.58 (819.42) |
| `rc_f` | 85 | 367.78 (629.40) | 418.62 (750.62) | 464.22 (873.41) |
| `rc_s` | -40 | 153.78 (419.16) | 181.26 (551.44) | 212.95 (699.03) |
| `rc_s` | 27 | 190.87 (439.63) | 218.28 (552.84) | 248.25 (678.14) |
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
| `rc_s` | -40 | 178.08 (426.57) | 209.40 (559.90) | 245.09 (708.58) |
| `rc_s` | 27 | 216.84 (447.66) | 247.79 (562.06) | 281.72 (688.57) |
| `rc_s` | 85 | 253.29 (477.51) | 284.72 (580.51) | 318.01 (693.43) |

### code `0xFF`

| process | T (°C) | 3 V | 3.3 V | 3.6 V |
|---|---|---|---|---|
| `tt` | -40 | 327.17 (493.13) | 376.93 (634.80) | 434.15 (793.19) |
| `tt` | 27 | 375.05 (528.27) | 426.16 (651.59) | 481.72 (788.13) |
| `tt` | 85 | 421.07 (573.69) | 474.09 (686.34) | **529.92** (809.71) |
| `ff` | -40 | 443.62 (700.15) | **512.36** (874.29) | **586.50** (1064.55) |
| `ff` | 27 | **513.33** (742.08) | **581.13** (892.82) | **653.15** (1056.30) |
| `ff` | 85 | **582.26** (801.13) | **653.23** (940.78) | **724.42** (1087.82) |
| `ss` | -40 | 258.50 (345.47) | 292.21 (458.04) | 333.89 (587.34) |
| `ss` | 27 | 290.74 (379.35) | 328.23 (478.39) | 370.84 (590.63) |
| `ss` | 85 | 322.62 (417.75) | 363.08 (508.90) | 406.69 (610.86) |
| `fs` | -40 | 340.00 (496.11) | 396.06 (641.01) | 457.14 (802.62) |
| `fs` | 27 | 388.09 (529.56) | 442.90 (655.02) | **501.52** (793.54) |
| `fs` | 85 | 437.20 (575.07) | 491.38 (688.00) | **548.24** (811.65) |
| `sf` | -40 | 322.94 (494.13) | 365.64 (632.20) | 415.98 (786.63) |
| `sf` | 27 | 367.50 (530.43) | 414.21 (651.12) | 466.36 (784.90) |
| `sf` | 85 | 412.28 (577.92) | 462.95 (688.52) | **516.59** (809.79) |
| `rc_f` | -40 | 403.69 (551.80) | 461.25 (697.56) | **526.42** (860.53) |
| `rc_f` | 27 | 471.70 (615.08) | **532.36** (743.18) | **597.61** (884.67) |
| `rc_f` | 85 | **530.88** (678.17) | **602.64** (806.95) | **671.61** (939.04) |
| `rc_s` | -40 | 277.35 (457.11) | 321.64 (595.96) | 372.69 (751.13) |
| `rc_s` | 27 | 313.55 (477.27) | 358.48 (597.49) | 407.39 (730.69) |
| `rc_s` | 85 | 348.07 (506.58) | 393.59 (615.56) | 442.14 (735.32) |

## Per-code worst case (Row 4 verdict basis)

| code | worst-case corner | `iq_run` (µA) | verdict | reference corner (`tt`/27 °C/3.3 V) `iq_run` (µA) | verdict |
|---|---|---|---|---|---|
| `0x00` | `ff` / 85 °C / 3.6 V | 460.06 | met | 242.34 | met |
| `0x80` | `ff` / 85 °C / 3.6 V | 498.76 | met | 267.97 | met |
| `0xC0` | `ff` / 85 °C / 3.6 V | 550.20 | **exceeds** | 302.21 | met |
| `0xFF` | `ff` / 85 °C / 3.6 V | 724.42 | **exceeds** | 426.16 | met |

**DR-0003 Row 4 verdict, per code, at the worst-case corner over the
full grid** — see table above. A code's verdict is `met`
only if `iq_run` stays under 500 µA at every one of that code's
63 grid points; the worst-case
row is exactly the maximum over that grid, so "met" in the table
above means met everywhere for that code.

[DR-0007]: ../../../../spec/decision-records/0007-quiescent-current-exceeds-target-post-resize.md
