2AMLogic/gf180-rcosc/sim/iq/results/20260921T091042Z/README.md

# Quiescent current (Iq) PVT-corner sweep 20260921T091042Z — issue #35

Generated by `sim/iq/iq_sweep.py` (issue #22, extended #24, extended
to a full PVT-corner factorial by issue #35). Append-only evidence:
this file, `results.csv`, `manifest.json` and every raw log under
`sim/iq/corners/20260921T091042Z/` belong to this run id and are never
rewritten by a later run.

| | |
|---|---|
| git sha | `1ac4434a7b1d51f20341824ffd67febc7438082a` (dirty tree) |
| ngspice | ** ngspice-46 : Circuit level simulation program |
| PDK | gf180mcuC @ `/Users/rwalters/.ciel` |
| netlist | `design/netlist/smoke_test.spice` (from `design/smoke_test.sch`) |
| sizing | `as-committed` only (see module docstring for why `pre-22` is not part of the grid) |
| subset | `full` (7 process corner(s) x 3 T x 3 V = 63 points/code) |
| codes | 0x00, 0x80, 0xC0, 0xFF |
| total grid points | 252 (0 failed) |
| wall clock | 2058.8 s at 10 jobs |
| target | DR-0003 Row 4: `< 500 µA` (running) |
| Row 4 verdict basis | `iq_run` (DR-0009) -- `iq_op` reported for continuity only, per DR-0008/DR-0009 |

## Two metrics, reported together

- **`iq_op`** — `-1e6*i(vdd)` at the `.op` point: the measurement
  issue #20 introduced and [DR-0007] quoted. A relaxation oscillator
  has no stable DC operating point, so this solve converges on the
  unstable equilibrium, which pins the charge-complete comparator
  `XCMPH` at its own output inverter's trip point — holding that
  buffer, and the SR-latch NOR gate its mid-rail output drives, in
  full crowbar conduction, a state the running circuit passes through
  but never rests in. The `.op` node voltages printed into every raw
  log under `../../corners/` show this directly. Reported unchanged
  for continuity with DR-0007.
- **`iq_run`** — `-i(vdd)` averaged over 20 whole oscillation periods
  (rising edges 5..25 of `clk`, startup skipped). This is the quantity
  DR-0003 Row 4 names: `< 500 µA` **(running)**, anchored to ST
  DS9826's `IDDA(HSI48)` — a datasheet supply current for an
  oscillator that is oscillating.

**Issue #35 addition**: both metrics are now measured at every grid
point of the full process x temperature x supply factorial, not just
the single reference corner (`tt`/27 °C/3.3 V) prior runs used. Row 4's
verdict per code below is stated at the **worst-case corner** (the
grid point with the highest `iq_run` at that code), with the
reference-corner value given alongside it for continuity with
DR-0009's own reference-corner figures.

## Sweep matrix

| Axis | Values | Count |
|---|---|---|
| process (fets / res / mimcap `.lib` sections) | `tt`, `ff`, `ss`, `fs`, `sf`, `rc_f`, `rc_s` | 7 |
| temperature | -40 °C, 27 °C, 85 °C | 3 |
| supply | 3 V, 3.3 V, 3.6 V | 3 |
| trim code | 0x00, 0x80, 0xC0, 0xFF | 4 |
| **grid points, this run** | | **252** |

Corner definitions (`PROCESS_CORNERS`/`TEMPS_C`/`VDDS_V`/
`corner_include()`) are imported from `sim/pvt/pvt_sweep.py`
verbatim, not re-typed, so the frequency and Iq campaigns cannot
disagree about what a corner is (issue #35).

## Full grid results (every point)

One matrix per trim code. Each cell is `iq_run (iq_op)` in µA;
`iq_run` is **bold** where it is at or above the 500 µA target
(Row 4's verdict basis, DR-0009). `iq_op` is reported alongside for
continuity only — see "Two metrics" above.

### code `0x00`

| process | T (°C) | 3 V | 3.3 V | 3.6 V |
|---|---|---|---|---|
| `tt` | -40 | 166.19 (171.20) | 194.00 (578.58) | 225.88 (727.64) |
| `tt` | 27 | 214.28 (480.36) | 242.13 (595.00) | 272.87 (721.83) |
| `tt` | 85 | 260.41 (525.44) | 289.87 (629.16) | 320.92 (742.37) |
| `ff` | -40 | 243.42 (638.93) | 281.85 (801.50) | 324.83 (978.68) |
| `ff` | 27 | 311.06 (680.05) | 349.15 (818.70) | 390.05 (968.38) |
| `ff` | 85 | 373.84 (734.92) | 417.29 (863.26) | 459.46 (996.54) |
| `ss` | -40 | 119.31 (80.27) | 138.94 (117.52) | 162.33 (534.52) |
| `ss` | 27 | 155.55 (340.27) | 176.25 (432.70) | 199.58 (537.64) |
| `ss` | 85 | 190.21 (379.04) | 212.34 (463.33) | 236.01 (557.73) |
| `fs` | -40 | 180.03 (246.72) | 211.34 (194.76) | 247.12 (320.53) |
| `fs` | 27 | 226.57 (482.54) | 257.17 (598.55) | 290.39 (726.57) |
| `fs` | 85 | 270.51 (524.28) | 302.94 (629.30) | 336.12 (743.10) |
| `sf` | -40 | 156.20 (139.47) | 180.62 (113.41) | 209.16 (420.68) |
| `sf` | 27 | 204.76 (480.30) | 230.55 (592.98) | 258.94 (717.84) |
| `sf` | 85 | 251.98 (528.09) | 279.87 (630.30) | 309.04 (742.17) |
| `rc_f` | -40 | 215.19 (263.89) | 247.59 (633.13) | 284.50 (785.25) |
| `rc_f` | 27 | 284.59 (560.75) | 318.73 (678.90) | 355.26 (809.28) |
| `rc_f` | 85 | 337.60 (620.15) | 385.18 (740.58) | 427.04 (862.22) |
| `rc_s` | -40 | 135.94 (119.62) | 160.81 (546.08) | 189.54 (693.09) |
| `rc_s` | 27 | 172.06 (434.30) | 196.29 (546.86) | 223.45 (671.43) |
| `rc_s` | 85 | 206.55 (463.27) | 231.19 (564.16) | 257.71 (674.67) |

### code `0x80`

| process | T (°C) | 3 V | 3.3 V | 3.6 V |
|---|---|---|---|---|
| `tt` | -40 | 183.51 (445.08) | 214.34 (578.58) | 249.78 (727.66) |
| `tt` | 27 | 234.27 (480.37) | 265.14 (595.05) | 299.32 (722.07) |
| `tt` | 85 | 282.75 (525.51) | 315.13 (629.41) | 349.40 (743.17) |
| `ff` | -40 | 267.43 (638.96) | 310.37 (801.73) | 358.52 (979.82) |
| `ff` | 27 | 338.28 (680.35) | 380.72 (819.81) | 426.29 (971.71) |
| `ff` | 85 | 404.98 (736.82) | 452.27 (866.61) | 498.05 (1002.95) |
| `ss` | -40 | 132.69 (175.21) | 154.40 (164.82) | 180.49 (534.52) |
| `ss` | 27 | 170.97 (203.24) | 193.77 (157.16) | 219.52 (537.65) |
| `ss` | 85 | 207.56 (379.04) | 231.74 (463.34) | 257.89 (557.78) |
| `fs` | -40 | 198.18 (126.88) | 233.09 (585.31) | 272.62 (736.72) |
| `fs` | 27 | 247.20 (482.64) | 280.97 (598.97) | 318.04 (727.95) |
| `fs` | 85 | 294.38 (525.40) | 329.40 (630.96) | 365.81 (746.18) |
| `sf` | -40 | 173.33 (218.46) | 200.43 (187.25) | 231.94 (719.98) |
| `sf` | 27 | 224.54 (480.30) | 252.84 (592.98) | 284.41 (717.87) |
| `sf` | 85 | 274.29 (528.09) | 304.87 (630.33) | 337.21 (742.30) |
| `rc_f` | -40 | 236.91 (496.94) | 272.71 (151.11) | 313.42 (785.27) |
| `rc_f` | 27 | 309.73 (560.76) | 347.19 (678.96) | 387.60 (809.54) |
| `rc_f` | 85 | 367.66 (620.47) | 417.74 (741.05) | 463.05 (863.28) |
| `rc_s` | -40 | 150.71 (414.36) | 178.34 (110.93) | 210.55 (693.11) |
| `rc_s` | 27 | 188.60 (434.31) | 215.76 (546.91) | 245.94 (671.65) |
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
63 grid points; the worst-case
row is exactly the maximum over that grid, so "met" in the table
above means met everywhere for that code.

[DR-0007]: ../../../../spec/decision-records/0007-quiescent-current-exceeds-target-post-resize.md
