2AMLogic/gf180-rcosc/sim/iq/results/20260909T225306Z/README.md

# Quiescent current (Iq) PVT-corner sweep 20260909T225306Z — issue #35

Generated by `sim/iq/iq_sweep.py` (issue #22, extended #24, extended
to a full PVT-corner factorial by issue #35). Append-only evidence:
this file, `results.csv`, `manifest.json` and every raw log under
`sim/iq/corners/20260909T225306Z/` belong to this run id and are never
rewritten by a later run.

| | |
|---|---|
| git sha | `07d88bd89c4d253699f81f4dce9dfe5ef7d4bab8` (dirty tree) |
| ngspice | ** ngspice-46 : Circuit level simulation program |
| PDK | gf180mcuC @ `/home/ubuntu/.volare` |
| netlist | `design/netlist/smoke_test.spice` (from `design/smoke_test.sch`) |
| sizing | `as-committed` only (see module docstring for why `pre-22` is not part of the grid) |
| subset | `full` (7 process corner(s) x 3 T x 3 V = 63 points/code) |
| codes | 0x00, 0x80, 0xC0, 0xFF |
| total grid points | 252 (0 failed) |
| wall clock | 162.9 s at 6 jobs |
| target | DR-0003 Row 4: `< 500 µA` (running) |
| Row 4 verdict basis | `iq_run` (DR-0009) -- `iq_op` reported for continuity only, per DR-0008/DR-0009 |

## Two metrics, reported together

- **`iq_op`** — `-1e6*i(vdd)` at the `.op` point: the measurement
  issue #20 introduced and [DR-0007] quoted. A relaxation oscillator
  has no stable DC operating point, so this solve converges on the
  unstable equilibrium, which pins the charge-complete comparator
  `XCMPH` at its own output inverter's trip point — holding that
  buffer, and the SR-latch NOR gate its mid-rail output drives, in
  full crowbar conduction, a state the running circuit passes through
  but never rests in. The `.op` node voltages printed into every raw
  log under `../../corners/` show this directly. Reported unchanged
  for continuity with DR-0007.
- **`iq_run`** — `-i(vdd)` averaged over 20 whole oscillation periods
  (rising edges 5..25 of `clk`, startup skipped). This is the quantity
  DR-0003 Row 4 names: `< 500 µA` **(running)**, anchored to ST
  DS9826's `IDDA(HSI48)` — a datasheet supply current for an
  oscillator that is oscillating.

**Issue #35 addition**: both metrics are now measured at every grid
point of the full process x temperature x supply factorial, not just
the single reference corner (`tt`/27 °C/3.3 V) prior runs used. Row 4's
verdict per code below is stated at the **worst-case corner** (the
grid point with the highest `iq_run` at that code), with the
reference-corner value given alongside it for continuity with
DR-0009's own reference-corner figures.

## Sweep matrix

| Axis | Values | Count |
|---|---|---|
| process (fets / res / mimcap `.lib` sections) | `tt`, `ff`, `ss`, `fs`, `sf`, `rc_f`, `rc_s` | 7 |
| temperature | -40 °C, 27 °C, 85 °C | 3 |
| supply | 3 V, 3.3 V, 3.6 V | 3 |
| trim code | 0x00, 0x80, 0xC0, 0xFF | 4 |
| **grid points, this run** | | **252** |

Corner definitions (`PROCESS_CORNERS`/`TEMPS_C`/`VDDS_V`/
`corner_include()`) are imported from `sim/pvt/pvt_sweep.py`
verbatim, not re-typed, so the frequency and Iq campaigns cannot
disagree about what a corner is (issue #35).

## Full grid results (every point)

One matrix per trim code. Each cell is `iq_run (iq_op)` in µA;
`iq_run` is **bold** where it is at or above the 500 µA target
(Row 4's verdict basis, DR-0009). `iq_op` is reported alongside for
continuity only — see "Two metrics" above.

### code `0x00`

| process | T (°C) | 3 V | 3.3 V | 3.6 V |
|---|---|---|---|---|
| `tt` | -40 | 276.96 (595.17) | 325.28 (749.95) | 373.65 (915.88) |
| `tt` | 27 | 293.78 (594.13) | 345.34 (735.40) | 396.80 (884.59) |
| `tt` | 85 | 296.70 (585.77) | 353.29 (722.51) | 409.36 (864.81) |
| `ff` | -40 | 370.38 (807.10) | 430.74 (992.57) | 491.42 (1187.99) |
| `ff` | 27 | 387.21 (789.61) | 454.09 (960.96) | **519.52** (1137.25) |
| `ff` | 85 | 387.44 (769.32) | 459.08 (931.83) | **531.18** (1099.89) |
| `ss` | -40 | 213.32 (209.34) | 253.51 (249.02) | 293.89 (268.70) |
| `ss` | 27 | 228.20 (209.90) | 270.68 (563.21) | 312.90 (688.91) |
| `ss` | 85 | 232.18 (446.72) | 278.83 (560.92) | 324.35 (680.53) |
| `fs` | -40 | 292.92 (207.23) | 341.54 (750.72) | 390.83 (914.98) |
| `fs` | 27 | 304.14 (592.94) | 360.71 (736.59) | 414.65 (885.55) |
| `fs` | 85 | 303.15 (584.92) | 363.27 (721.98) | 423.51 (864.99) |
| `sf` | -40 | 260.64 (385.99) | 308.62 (746.59) | 357.05 (913.19) |
| `sf` | 27 | 278.51 (589.94) | 328.49 (730.80) | 378.89 (880.34) |
| `sf` | 85 | 286.03 (586.12) | 339.38 (721.10) | 392.28 (861.23) |
| `rc_f` | -40 | 334.45 (664.26) | 394.23 (830.24) | 454.97 (1007.00) |
| `rc_f` | 27 | 340.50 (651.28) | 408.38 (809.83) | 475.71 (975.64) |
| `rc_f` | 85 | 336.22 (637.55) | 405.54 (786.47) | 476.31 (943.84) |
| `rc_s` | -40 | 235.97 (294.68) | 276.55 (694.67) | 317.32 (853.37) |
| `rc_s` | 27 | 253.41 (545.77) | 295.94 (678.04) | 338.86 (819.28) |
| `rc_s` | 85 | 262.87 (545.20) | 308.15 (669.74) | 352.90 (800.12) |

### code `0x80`

| process | T (°C) | 3 V | 3.3 V | 3.6 V |
|---|---|---|---|---|
| `tt` | -40 | 298.99 (595.17) | 349.92 (216.54) | 401.62 (915.91) |
| `tt` | 27 | 317.44 (594.14) | 372.26 (735.46) | 426.75 (884.90) |
| `tt` | 85 | 322.14 (586.01) | 381.98 (723.08) | 441.16 (866.18) |
| `ff` | -40 | 398.19 (807.14) | 462.49 (992.84) | **527.79** (1189.28) |
| `ff` | 27 | 418.22 (790.32) | 489.24 (962.80) | **558.19** (1141.65) |
| `ff` | 85 | 421.23 (774.59) | 496.72 (939.54) | **572.67** (1109.99) |
| `ss` | -40 | 231.41 (342.20) | 273.77 (299.35) | 316.15 (357.23) |
| `ss` | 27 | 247.59 (446.33) | 292.39 (563.21) | 337.06 (688.91) |
| `ss` | 85 | 252.50 (446.72) | 301.82 (560.94) | 349.83 (680.60) |
| `fs` | -40 | 314.72 (597.64) | 366.35 (750.82) | 418.66 (915.45) |
| `fs` | 27 | 329.14 (594.15) | 388.39 (738.49) | 445.31 (888.80) |
| `fs` | 85 | 330.10 (591.75) | 393.47 (729.53) | 456.44 (873.50) |
| `sf` | -40 | 283.11 (590.82) | 333.52 (275.71) | 384.80 (913.19) |
| `sf` | 27 | 302.54 (589.94) | 355.21 (730.81) | 408.87 (880.37) |
| `sf` | 85 | 310.80 (586.13) | 367.67 (721.14) | 423.89 (861.38) |
| `rc_f` | -40 | 361.41 (361.33) | 425.04 (830.24) | 488.98 (1007.04) |
| `rc_f` | 27 | 370.22 (651.33) | 441.71 (810.00) | **512.71** (976.16) |
| `rc_f` | 85 | 368.54 (638.90) | 441.89 (788.78) | **516.95** (947.71) |
| `rc_s` | -40 | 254.56 (189.99) | 297.32 (694.67) | 340.58 (853.40) |
| `rc_s` | 27 | 273.39 (545.78) | 318.15 (678.10) | 363.99 (819.54) |
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
| `rc_s` | -40 | 273.92 (380.39) | 319.64 (269.97) | 366.73 (853.40) |
| `rc_s` | 27 | 294.29 (545.78) | 342.84 (678.10) | 392.41 (819.54) |
| `rc_s` | 85 | 306.36 (545.30) | 358.00 (670.05) | 409.87 (801.06) |

### code `0xFF`

| process | T (°C) | 3 V | 3.3 V | 3.6 V |
|---|---|---|---|---|
| `tt` | -40 | 366.57 (595.17) | 428.41 (749.95) | 493.93 (915.91) |
| `tt` | 27 | 384.62 (594.14) | 451.91 (735.46) | **521.21** (884.90) |
| `tt` | 85 | 391.94 (586.01) | 464.40 (723.08) | **538.36** (866.18) |
| `ff` | -40 | 487.17 (807.14) | **569.68** (992.84) | **658.09** (1189.28) |
| `ff` | 27 | **511.48** (790.32) | **600.95** (962.80) | **691.95** (1141.65) |
| `ff` | 85 | **524.86** (774.60) | **618.76** (939.68) | **713.68** (1110.83) |
| `ss` | -40 | 288.80 (477.56) | 335.90 (489.00) | 387.09 (704.82) |
| `ss` | 27 | 301.46 (446.33) | 354.27 (563.21) | 408.75 (688.91) |
| `ss` | 85 | 305.25 (446.72) | 363.31 (560.94) | 421.76 (680.60) |
| `fs` | -40 | 387.01 (597.64) | 451.93 (750.82) | **521.71** (915.45) |
| `fs` | 27 | 412.11 (594.15) | 484.32 (738.49) | **556.44** (888.80) |
| `fs` | 85 | 426.22 (592.70) | **502.99** (730.92) | **580.50** (875.64) |
| `sf` | -40 | 349.74 (324.00) | 408.24 (415.69) | 470.58 (913.19) |
| `sf` | 27 | 365.38 (589.94) | 429.01 (730.81) | 495.22 (880.37) |
| `sf` | 85 | 371.33 (586.13) | 439.95 (721.14) | **509.88** (861.38) |
| `rc_f` | -40 | 441.81 (568.72) | **517.68** (830.06) | **597.16** (1007.04) |
| `rc_f` | 27 | 451.20 (651.33) | **536.75** (810.00) | **623.76** (976.16) |
| `rc_f` | 85 | 455.60 (638.90) | **544.50** (788.78) | **636.28** (947.71) |
| `rc_s` | -40 | 312.57 (277.76) | 365.19 (277.38) | 421.69 (853.40) |
| `rc_s` | 27 | 331.93 (545.78) | 388.04 (678.10) | 447.04 (819.54) |
| `rc_s` | 85 | 343.39 (545.30) | 403.32 (670.05) | 464.62 (801.06) |

## Per-code worst case (Row 4 verdict basis)

| code | worst-case corner | `iq_run` (µA) | verdict | reference corner (`tt`/27 °C/3.3 V) `iq_run` (µA) | verdict |
|---|---|---|---|---|---|
| `0x00` | `ff` / 85 °C / 3.6 V | 531.18 | **exceeds** | 345.34 | met |
| `0x80` | `ff` / 85 °C / 3.6 V | 572.67 | **exceeds** | 372.26 | met |
| `0xC0` | `ff` / 85 °C / 3.6 V | 623.68 | **exceeds** | 400.87 | met |
| `0xFF` | `ff` / 85 °C / 3.6 V | 713.68 | **exceeds** | 451.91 | met |

**DR-0003 Row 4 verdict, per code, at the worst-case corner over the
full grid** — see table above. A code's verdict is `met`
only if `iq_run` stays under 500 µA at every one of that code's
63 grid points; the worst-case
row is exactly the maximum over that grid, so "met" in the table
above means met everywhere for that code.

[DR-0007]: ../../../../spec/decision-records/0007-quiescent-current-exceeds-target-post-resize.md
