2AMLogic/gf180-rcosc/sim/iq/results/20260907T090639Z/README.md

# Quiescent current (Iq) sweep 20260907T090639Z — issue #22 / #24

Generated by `sim/iq/iq_sweep.py` (issue #22, extended #24). Append-only evidence:
this file, `results.csv`, `manifest.json` and every raw log under
`sim/iq/corners/20260907T090639Z/` belong to this run id and are never
rewritten by a later run.

| | |
|---|---|
| git sha | `1362e1aaf2bcc2305042f166e1232dba7a824726` (dirty tree) |
| ngspice | ** ngspice-46 : Circuit level simulation program |
| PDK | gf180mcuC @ `/home/ubuntu/.ciel` |
| netlist | `design/netlist/smoke_test.spice` (from `design/smoke_test.sch`) |
| corner | `tt` / 27 °C / VDD = 3.3 V (the repo's reference corner) |
| target | DR-0003 Row 4: `< 500 µA` (running) |
| Row 4 verdict basis | `iq_run` (DR-0009) -- `iq_op` reported for continuity only, per DR-0008/DR-0009 |

## Two metrics, reported together

- **`iq_op`** — `-1e6*i(vdd)` at the `.op` point: the measurement
  issue #20 introduced and [DR-0007] quoted. A relaxation oscillator
  has no stable DC operating point, so this solve converges on the
  unstable equilibrium, which pins the charge-complete comparator
  `XCMPH` at its own output inverter's trip point — holding that
  buffer, and the SR-latch NOR gate its mid-rail output drives, in
  full crowbar conduction, a state the running circuit passes through
  but never rests in. The `.op` node voltages printed into every raw
  log under `../../corners/` show this directly. Reported unchanged
  for continuity with DR-0007.
- **`iq_run`** — `-i(vdd)` averaged over 20 whole oscillation periods
  (rising edges 5..25 of `clk`, startup skipped). This is the quantity
  DR-0003 Row 4 names: `< 500 µA` **(running)**, anchored to ST
  DS9826's `IDDA(HSI48)` — a datasheet supply current for an
  oscillator that is oscillating.

## Results

| sizing | code | `iq_op` (µA) | verdict | `iq_run` (µA) | verdict | f (MHz) |
|---|---|---|---|---|---|---|
| `as-committed` | `0x00` | 754.82 | **exceeds** | 359.74 | met | 28.0769 |
| `as-committed` | `0x80` | 754.90 | **exceeds** | 387.09 | met | 39.1203 |
| `as-committed` | `0xFF` | 754.90 | **exceeds** | 468.61 | met | 58.9870 |
| `pre-22` | `0x00` | 914.40 | **exceeds** | 470.39 | met | 29.5123 |
| `pre-22` | `0x80` | 914.99 | **exceeds** | 502.23 | **exceeds** | 42.0390 |
| `pre-22` | `0xFF` | 914.99 | **exceeds** | 605.57 | **exceeds** | 65.9332 |

`pre-22` is issue #16's sizing (`RBIAS L = 25 µm`, `MTAIL W = 4 µm
nf = 1`), the sizing DR-0007 measured. `as-committed` is this run's
`design/*.sch` as checked in.

Both metrics are reported at every code so neither can be quoted
alone, and so the direction of the verdict can be checked against
both. **The two metrics are not expected to agree on verdict**: as
of issue #24 / DR-0009, `as-committed` is sized against `iq_run`
specifically (the quantity DR-0003 Row 4 names), which can leave
`iq_op` (a DC-equilibrium artifact, not a running-current figure --
see DR-0008) above the same 500 µA number without that meaning
anything about Row 4's actual verdict. Read the `iq_run` column
for Row 4's disposition; `iq_op` is reported for continuity with
DR-0007's original methodology, not as a second acceptance gate.

[DR-0007]: ../../../../spec/decision-records/0007-quiescent-current-exceeds-target-post-resize.md
