2AMLogic/gf180-rcosc/sim/iq/results/20260906T062311Z/README.md

# Quiescent current (Iq) sweep 20260906T062311Z — issue #22

Generated by `sim/iq/iq_sweep.py` (issue #22). Append-only evidence:
this file, `results.csv`, `manifest.json` and every raw log under
`sim/iq/corners/20260906T062311Z/` belong to this run id and are never
rewritten by a later run.

| | |
|---|---|
| git sha | `7404fc80780f1415f72ec6aaca7f012ed80db126` (dirty tree) |
| ngspice | ** ngspice-46 : Circuit level simulation program |
| PDK | gf180mcuC @ `/Users/rwalters/.volare` |
| netlist | `design/netlist/smoke_test.spice` (from `design/smoke_test.sch`) |
| corner | `tt` / 27 °C / VDD = 3.3 V (the repo's reference corner) |
| target | DR-0003 Row 4: `< 500 µA` (running) |

## Two metrics, reported together

- **`iq_op`** — `-1e6*i(vdd)` at the `.op` point: the measurement
  issue #20 introduced and [DR-0007] quoted. A relaxation oscillator
  has no stable DC operating point, so this solve converges on the
  unstable equilibrium, which pins the charge-complete comparator
  `XCMPH` at its own output inverter's trip point — holding that
  buffer, and the SR-latch NOR gate its mid-rail output drives, in
  full crowbar conduction, a state the running circuit passes through
  but never rests in. The `.op` node voltages printed into every raw
  log under `../../corners/` show this directly. Reported unchanged
  for continuity with DR-0007.
- **`iq_run`** — `-i(vdd)` averaged over 20 whole oscillation periods
  (rising edges 5..25 of `clk`, startup skipped). This is the quantity
  DR-0003 Row 4 names: `< 500 µA` **(running)**, anchored to ST
  DS9826's `IDDA(HSI48)` — a datasheet supply current for an
  oscillator that is oscillating.

## Results

| sizing | code | `iq_op` (µA) | verdict | `iq_run` (µA) | verdict | f (MHz) |
|---|---|---|---|---|---|---|
| `as-committed` | `0x00` | 467.13 | met | 136.45 | met | 26.5059 |
| `as-committed` | `0x80` | 467.18 | met | 157.27 | met | 35.9557 |
| `as-committed` | `0xFF` | 467.18 | met | 218.54 | met | 51.9414 |
| `pre-22` | `0x00` | 914.40 | **exceeds** | 470.40 | met | 29.5072 |
| `pre-22` | `0x80` | 914.99 | **exceeds** | 502.31 | **exceeds** | 42.0677 |
| `pre-22` | `0xFF` | 914.99 | **exceeds** | 605.50 | **exceeds** | 65.9204 |

`pre-22` is issue #16's sizing (`RBIAS L = 25 µm`, `MTAIL W = 4 µm
nf = 1`), the sizing DR-0007 measured. `as-committed` is this run's
`design/*.sch` as checked in.

Both metrics are reported at every code so neither can be quoted
alone, and so the direction of the verdict can be checked against
both: at the `pre-22` sizing **both** metrics exceed the 500 µA
target at the representative code, and at the `as-committed` sizing
**both** are under it. The re-size is therefore not an artifact of
choosing a more favourable metric.

[DR-0007]: ../../../../spec/decision-records/0007-quiescent-current-exceeds-target-post-resize.md
