2AMLogic/gf180-rcosc/sim/row45-rerun/results/20261112T203500Z-stage-extracted-l07/table.md

| die | T C | 3.0 V | 3.3 V | 3.6 V | span (3.6-3.0) |
|---|---|---|---|---|---|
| tt | ref f(3.3 V, 27 C) = 47.911 MHz | | | | |
| tt | -40 | -4.28 | -2.35 | -0.78 | 3.50 |
| tt | 27 | -1.95 | +0.00 | +1.56 | 3.51 |
| tt | 85 | -0.28 | +1.52 | +2.94 | 3.22 |
| ff | ref f(3.3 V, 27 C) = 47.967 MHz | | | | |
| ff | -40 | -4.40 | -3.21 | -2.24 | 2.16 |
| ff | 27 | -1.06 | +0.00 | +0.94 | 2.00 |
| ff | 85 | +1.66 | +2.43 | +3.07 | 1.40 |
| ss | ref f(3.3 V, 27 C) = 48.038 MHz | | | | |
| ss | -40 | -4.09 | -0.73 | +2.02 | 6.11 |
| ss | 27 | -3.37 | +0.00 | +2.72 | 6.09 |
| ss | 85 | -2.81 | +0.40 | +2.96 | 5.77 |
