2AMLogic/gf180-rcosc/sim/row45-rerun/results/20261112T112000Z-screen-cmph-first/table.md

| variant | f(3.3 V, 27 C) MHz | 3.0 V / 85 C pt | 3.0 V / -40 C pt |
|---|---|---|---|
| base | 47.956 | +6.91 | -4.85 |
| ll05 | 47.705 | +1.24 | -4.42 |
| ll06 | 47.753 | +1.40 | -4.48 |
| ll08 | 47.816 | +2.50 | -4.59 |
| ll09 | 47.863 | +4.19 | -4.68 |
| ll11 | 48.114 | +10.40 | -5.16 |
| tk055 | 46.626 | +1.24 | -4.76 |
| tk085 | 47.533 | +3.20 | -4.72 |
