2AMLogic/gf180-rcosc/sim/mc/results/20261112T060000Z/summary.md

# Item-6 Monte Carlo campaign summary (generated by analyze.py)

DUT: P3 extracted netlist (DR-0023, proposed); DR-0019 (proposed) claims S1-S3; DR-0022 matching model A_R = A_C = 1.0 %.um (flagged assumption). Seed 20261008, 500 samples per process corner.

## Yield (klt yield, 95 % two-sided, target yield 0.99)

| process | row | measurement | n | pass | yield lower bound | sample-size | negative control | status |
|---|---|---|---|---|---|---|---|---|
| tt | 2 | s1_resid_abs_pct | 500 | 1 | 0.9926 | sufficient | not_detected | pass |
| tt | 2 | s1_headroom | 500 | 1 | 0.9926 | sufficient | not_detected | pass |
| tt | 4 | s2_margin_pct | 500 | 1 | 0.9926 | sufficient | detected | pass |
| tt | 5 | s3_margin_pct | 500 | 1 | 0.9926 | sufficient | not_detected | pass |
| ff | 2 | s1_resid_abs_pct | 500 | 1 | 0.9926 | sufficient | not_detected | pass |
| ff | 2 | s1_headroom | 500 | 1 | 0.9926 | sufficient | not_detected | pass |
| ff | 4 | s2_margin_pct | 500 | 1 | 0.9926 | sufficient | not_detected | pass |
| ff | 5 | s3_margin_pct | 500 | 0.926 | 0.8994 | insufficient | detected | fail |
| ss | 2 | s1_resid_abs_pct | 500 | 1 | 0.9926 | sufficient | not_detected | pass |
| ss | 2 | s1_headroom | 500 | 1 | 0.9926 | sufficient | not_detected | pass |
| ss | 4 | s2_margin_pct | 500 | 0 | 0 | sufficient | not_detected | fail |
| ss | 5 | s3_margin_pct | 500 | 1 | 0.9926 | sufficient | not_detected | pass |

## Per-die spread (main runs)

| process | code min/median/max | calibration residual |e| p99 (%) | S2 margin min (%) | S3 margin min (%) |
|---|---|---|---|---|---|
| tt | 161/165/168 | 0.271 | 0.052 | 5.051 |
| ff | 73/78/83 | 0.213 | 0.863 | -2.241 |
| ss | 210/212/215 | 0.356 | -1.353 | 5.228 |

## Control 1: zero mismatch (plumbing)

| process | draws identical | code | expected code | f_hold (MHz) | expected (MHz) | delta (%) | within 0.25 % |
|---|---|---|---|---|---|---|---|
| tt | yes | 164 | 169 | 47.8868 | 48.060 | -0.360 | NO |
| ff | yes | 78 | 89 | 47.9490 | 48.092 | -0.297 | NO |
| ss | yes | 212 | 215 | 47.9405 | 48.129 | -0.392 | NO |

## Control 2: inflated 3x (negative control, via klt yield-samples)

See the `negative control` column above: the verdict is klt yield's own.

* tt: n=500, calibration residual |e| median 0.135 % (main run: see per-die table), code spread sd 3.36
* ff: n=500, calibration residual |e| median 0.086 % (main run: see per-die table), code spread sd 5.45
* ss: n=500, calibration residual |e| median 0.173 % (main run: see per-die table), code spread sd 2.66

## Control 3: injected-term sensitivity (MOS off)

(sensitivity reports missing)
