2AMLogic/gf180-rcosc/sim/mc/results/20261106T072000Z/summary.md

# Item-6 Monte Carlo campaign summary (generated by analyze.py)

DUT: P3 extracted netlist (DR-0023, proposed); DR-0019 (proposed) claims S1-S3; DR-0022 matching model A_R = A_C = 1.0 %.um (flagged assumption). Seed 20261008, 500 samples per process corner.

## Yield (klt yield, 95 % two-sided, target yield 0.99)

| process | row | measurement | n | pass | yield lower bound | sample-size | negative control | status |
|---|---|---|---|---|---|---|---|---|
| tt | 2 | s1_resid_abs_pct | 500 | 1 | 0.9926 | sufficient | not_detected | pass |
| tt | 2 | s1_headroom | 500 | 1 | 0.9926 | sufficient | not_detected | pass |
| tt | 4 | s2_margin_pct | 500 | 1 | 0.9926 | sufficient | not_detected | pass |
| tt | 5 | s3_margin_pct | 500 | 1 | 0.9926 | sufficient | not_detected | pass |
| ff | 2 | s1_resid_abs_pct | 500 | 1 | 0.9926 | sufficient | not_detected | pass |
| ff | 2 | s1_headroom | 500 | 1 | 0.9926 | sufficient | not_detected | pass |
| ff | 4 | s2_margin_pct | 500 | 1 | 0.9926 | sufficient | detected | pass |
| ff | 5 | s3_margin_pct | 500 | 0.604 | 0.5596 | insufficient | detected | fail |
| ss | 2 | s1_resid_abs_pct | 500 | 1 | 0.9926 | sufficient | not_detected | pass |
| ss | 2 | s1_headroom | 500 | 1 | 0.9926 | sufficient | not_detected | pass |
| ss | 4 | s2_margin_pct | 500 | 0 | 0 | sufficient | not_detected | fail |
| ss | 5 | s3_margin_pct | 500 | 1 | 0.9926 | sufficient | not_detected | pass |

## Per-die spread (main runs)

| process | code min/median/max | calibration residual |e| p99 (%) | S2 margin min (%) | S3 margin min (%) |
|---|---|---|---|---|---|
| tt | 165/169/172 | 0.267 | 0.689 | 5.571 |
| ff | 82/89/95 | 0.191 | 1.071 | -4.303 |
| ss | 212/215/217 | 0.340 | -0.895 | 5.552 |

## Control 1: zero mismatch (plumbing)

| process | draws identical | code | expected code | f_hold (MHz) | expected (MHz) | delta (%) | within 0.25 % |
|---|---|---|---|---|---|---|---|
| tt | yes | 169 | 169 | 48.0488 | 48.060 | -0.023 | yes |
| ff | yes | 89 | 89 | 48.0844 | 48.092 | -0.016 | yes |
| ss | yes | 215 | 215 | 48.1229 | 48.129 | -0.013 | yes |

## Control 2: inflated 3x (negative control, via klt yield-samples)

See the `negative control` column above: the verdict is klt yield's own.

* tt: n=500, calibration residual |e| median 0.132 % (main run: see per-die table), code spread sd 3.69
* ff: n=500, calibration residual |e| median 0.087 % (main run: see per-die table), code spread sd 6.70
* ss: n=500, calibration residual |e| median 0.173 % (main run: see per-die table), code spread sd 2.76

## Control 3: injected-term sensitivity (MOS off)

| quantity | sigma at 1x | sigma at 10x | ratio | in 7..13 |
|---|---|---|---|---|
| step_0x7f_0x80_hz | 3.067e+04 Hz | 2.961e+05 Hz | 9.65 | yes |
| step_0x7e_0x7f_hz | 4470 Hz | 2.232e+04 Hz | 4.99 | NO |

code-selection spread (reported, not gated: discrete): sd 0.099 at 1x, 1.437 at 10x
zero-mismatch baseline step 0x7F->0x80: -4121700 Hz (3 identical draws: yes)

Sensitivity control: FAIL (no verdict)
