2AMLogic/gf180-rcosc/sim/trim-dense/results/20261106T1115Z-campaign/SLICE-10.md

# Slice 10 (#87, `Part of #87`)

Ran `run_batch.py --limit 40` (concurrency cap 2) on the batch fleet (`uvx --from klayout-tools==0.9.0 klt`) against
the bench regenerated with the manifest's netlists and `--capacity-wait-s 1200`; its `provenance.json` hashed to
`manifest.json:provenance_sha256` (`d1d24253...`).

The invocation was stopped by the host's 10-minute background time limit before reaching `--limit 40`; the driver
was not resumed in this session. No local process of this run is left running. Every submission that the driver
finished before the stop is complete in the ledger (appended per job); two further submissions were in flight at the
stop and are NOT in the ledger (see "In-flight at the stop" below). Nothing was resubmitted or overwritten.

Result: ledger now holds 289 of 1536 jobs, all `done`, 289 distinct tags, all submitted with `--backend batch`.
This slice: 28 done, 0 not done (`ext_ss_m40C_3p0V_c05..c20`; of the intended 40, 28 were ledgered, 2 were in flight at the stop and are not
ledgered, and 10 were never submitted). The
`ext_ff_85C_3p6V` curve is complete (256 codes); `ext_ss_m40C_3p0V` now covers `c00..c20`. Supersedes the counts in
`README.md` and earlier `SLICE-*.md` (append-only, left unedited).

No step, monotonicity or carry claim follows; 1247 jobs remain, then `analyze.py --manifest` and the verdict DR (0030).
`test_harness.py` was not re-run this slice (no code changed).

## In-flight at the stop (corrected disclosure)

Two batch jobs were submitted by the driver and were still in flight when the 10-minute limit stopped it, so their
results were never retrieved and no ledger line, report or `stderr.txt` was written. Their
`jobs/<tag>/batch-receipt.json` files are committed in this slice with `"state": null`:

| tag | fleet job id | launched (UTC) | receipt state | fleet state (observed) |
|---|---|---|---|---|
| `ext_ss_m40C_3p0V_c21` | `klt-sim-ecbbb910a191` | 2026-11-07T07:52:21Z | `null` | `done`, 23 s, updated 07:52:55Z |
| `ext_ss_m40C_3p0V_c22` | `klt-sim-232cc73f7292` | 2026-11-07T07:52:37Z | `null` | `done`, 11 s, updated 07:53:00Z |

Fleet state was read (read-only) with `klt sim <request> --backend batch --job-status <job_id>` (client
`klayout-tools==0.9.0`), using the request regenerated by `prepare.py` with the manifest's netlists (its
`provenance.json` hashes to `manifest.json:provenance_sha256`). Both jobs completed on the fleet, so there are no
orphaned running jobs; their outputs were not downloaded, no sim was run for this correction, and the ledger and
all other existing files are untouched.

Consequences for the counts above: ledger = 289 jobs (c21, c22 not included); the intended 40 split as 28 ledgered,
2 submitted-but-unledgered (c21, c22), 10 not submitted. The earlier wording "12 not run / nothing resubmitted /
no leftover processes" was wrong for c21/c22; "nothing resubmitted" remains true (no tag was submitted twice
in this slice).

Next slice: `run_batch.py` skips a tag only if its receipt has `state == "done"` and its report exists. These two
receipts have `state: null` and no report, so the driver as written will treat c21 and c22 as pending and resubmit
them as new jobs (the ledger stays one-line-per-tag, but fleet jobs `klt-sim-ecbbb910a191` and `klt-sim-232cc73f7292`
would then be unused duplicates). To avoid the duplicate, the next slice should retrieve those two jobs with
`klt sim <request> --backend batch --attach <job_id>` and ledger them (append-only) instead of rerunning; that
choice is left to the next slice and is not made here.
