2AMLogic/gf180-rcosc/sim/discipline/results/20261009T010000Z/summary.md

# Discipline-loop model run 20261009T010000Z

Generated by `discipline_model.py`; plant = committed runs `sim/pvt/results/20260923T030125Z/results.csv` (schematic, post-#60, DR-0017) and `sim/pvt-postlayout/results/20260923T152954Z/results.csv` + `guardrails.csv` (post-layout, DR-0018). No analogue simulation. Interpretation: `sim/discipline/README.md` and DR-0021.

## Plant model validation

| plant | check | model MHz | measured MHz | err % | max g(code) dependence % |
|---|---|---|---|---|---|
| tt/sch | model f at measured per-corner cal code vs measured | 47.982 | 47.982 | +0.00 | 1.19 |
| ff/sch | model f at measured per-corner cal code vs measured | 47.836 | 48.046 | -0.44 | 1.15 |
| ss/sch | model f at measured per-corner cal code vs measured | 47.604 | 47.878 | -0.57 | 1.18 |
| fs/sch | model f at measured per-corner cal code vs measured | 47.963 | 48.068 | -0.22 | 1.24 |
| sf/sch | model f at measured per-corner cal code vs measured | 47.826 | 47.887 | -0.13 | 1.09 |
| rc_f/sch | model f at measured per-corner cal code vs measured | 48.042 | 47.910 | +0.28 | 1.05 |
| rc_s/sch | model f at measured per-corner cal code vs measured | 47.902 | 48.020 | -0.25 | 0.95 |
| tt/ext | model f at measured per-corner cal code (independent check) vs measured | 49.285 | 48.025 | +2.62 |  |
| tt/ext | model f at 0xA3 27C/3.3V vs measured extracted f(0xA3) (independent check) | 36.395 | 35.815 | +1.62 |  |
| ff/ext | model f at measured per-corner cal code (independent check) vs measured | 48.159 | 48.016 | +0.30 |  |
| ff/ext | model f at 0xA3 27C/3.3V vs measured extracted f(0xA3) (independent check) | 44.170 | 43.654 | +1.18 |  |
| ss/ext | model f at measured per-corner cal code (independent check) vs measured | 48.498 | 48.019 | +1.00 |  |
| ss/ext | model f at 0xA3 27C/3.3V vs measured extracted f(0xA3) (independent check) | 30.277 | 29.924 | +1.18 |  |

## Static trim math (no loop)

Realized per-code step (interpolated committed curve; ratified nominal 0.314 %/code), and the best achievable single-code error to 48 MHz over the 9 T/V points.

| plant | mean step %/code | max step | min step | negative steps | f(0x00) MHz | f(0xFF) MHz | best-code |err| range over 9 T/V % | saturated T/V points | max target crossings (>1 = non-monotone) |
|---|---|---|---|---|---|---|---|---|---|
| tt/sch | 0.447 | 0.790 | -6.036 | 4 | 26.47 | 82.51 | 0.038..0.278 | none | 1 |
| ff/sch | 0.440 | 0.778 | -5.951 | 4 | 35.33 | 108.32 | 0.052..0.161 | none | 1 |
| ss/sch | 0.451 | 0.798 | -6.094 | 4 | 20.65 | 65.10 | 0.070..0.387 | none | 1 |
| fs/sch | 0.453 | 0.800 | -6.112 | 4 | 26.72 | 84.54 | 0.077..0.240 | none | 1 |
| sf/sch | 0.441 | 0.779 | -5.961 | 4 | 26.13 | 80.28 | 0.005..0.240 | none | 1 |
| rc_f/sch | 0.425 | 0.751 | -5.752 | 4 | 35.16 | 103.72 | 0.025..0.204 | none | 1 |
| rc_s/sch | 0.470 | 0.830 | -6.332 | 4 | 20.69 | 68.33 | 0.015..0.350 | none | 1 |
| tt/ext | 0.420 | 0.742 | -5.684 | 4 | 20.81 | 60.58 | 0.062..0.329 | none | 1 |
| ff/ext | 0.409 | 0.722 | -5.537 | 4 | 25.63 | 72.53 | 0.010..0.313 | none | 3 |
| ss/ext | 0.418 | 0.739 | -5.658 | 4 | 17.35 | 50.28 | 0.039..0.343 | -40C/3.0V | 1 |

Per-point detail: `trim_math.csv`.

## Steady state, cold start from 0x80 at 27 C / 3.3 V (last 2000 of 8000 frames)

`inst` = per-frame true frequency error; `avg16` = 16-frame moving average (16 ms). Band = +/-0.25 %. Lock = first frame after which the quantity stays in band for 256 frames (`none` = never). Jitter = uniform +/-J on each SOF arrival (an assumed parameter).

### SOF jitter +/-0 ns

| plant | policy | lock inst | lock avg16 | inst min..max % | inst frac in band | avg16 absmax % | avg64 absmax % | codes used |
|---|---|---|---|---|---|---|---|---|
| tt/sch | bangbang | none | none | -0.038..+0.545 | 0.500 | 0.253 | 0.253 | 0xA3..0xA4 |
| tt/sch | deadband | 35 | 33 | -0.038..-0.038 | 1.000 | 0.038 | 0.038 | 0xA3..0xA3 |
| tt/sch | avg32 | 1120 | 1115 | -0.038..-0.038 | 1.000 | 0.038 | 0.038 | 0xA3..0xA3 |
| tt/sch | fracdither | none | 5 | -0.617..+0.545 | 0.630 | 0.037 | 0.010 | 0xA2..0xA4 |
| ff/sch | bangbang | none | 34 | -0.341..+0.063 | 0.500 | 0.139 | 0.139 | 0x59..0x5A |
| ff/sch | deadband | 38 | 35 | +0.063..+0.063 | 1.000 | 0.063 | 0.063 | 0x5A..0x5A |
| ff/sch | avg32 | 1216 | 1209 | +0.063..+0.063 | 1.000 | 0.063 | 0.063 | 0x5A..0x5A |
| ff/sch | fracdither | none | 7 | -0.341..+0.063 | 0.845 | 0.013 | 0.007 | 0x59..0x5A |
| ss/sch | bangbang | none | 75 | -0.118..+0.593 | 0.500 | 0.237 | 0.237 | 0xCE..0xCF |
| ss/sch | deadband | 78 | 77 | -0.118..-0.118 | 1.000 | 0.118 | 0.118 | 0xCE..0xCE |
| ss/sch | avg32 | 2496 | 2494 | -0.118..-0.118 | 1.000 | 0.118 | 0.118 | 0xCE..0xCE |
| ss/sch | fracdither | none | 6 | -0.824..+0.593 | 0.704 | 0.060 | 0.015 | 0xCD..0xCF |
| fs/sch | bangbang | none | 28 | -0.077..+0.513 | 0.500 | 0.218 | 0.218 | 0xA0..0xA1 |
| fs/sch | deadband | 32 | 30 | -0.077..-0.077 | 1.000 | 0.077 | 0.077 | 0xA0..0xA0 |
| fs/sch | avg32 | 1024 | 1019 | -0.077..-0.077 | 1.000 | 0.077 | 0.077 | 0xA0..0xA0 |
| fs/sch | fracdither | none | 5 | -0.630..+0.513 | 0.763 | 0.038 | 0.011 | 0x9F..0xA1 |
| sf/sch | bangbang | none | 36 | -0.363..+0.211 | 0.500 | 0.076 | 0.076 | 0xA6..0xA7 |
| sf/sch | deadband | none | 36 | -0.363..+0.211 | 0.500 | 0.076 | 0.076 | 0xA6..0xA7 |
| sf/sch | avg32 | none | none | -0.363..+0.211 | 0.504 | 0.363 | 0.076 | 0xA6..0xA7 |
| sf/sch | fracdither | none | 5 | -0.363..+0.211 | 0.633 | 0.040 | 0.005 | 0xA6..0xA7 |
| rc_f/sch | bangbang | none | 30 | -0.302..+0.088 | 0.500 | 0.107 | 0.107 | 0x5D..0x5E |
| rc_f/sch | deadband | 34 | 31 | +0.088..+0.088 | 1.000 | 0.088 | 0.088 | 0x5E..0x5E |
| rc_f/sch | avg32 | 1088 | 1082 | +0.088..+0.088 | 1.000 | 0.088 | 0.088 | 0x5E..0x5E |
| rc_f/sch | fracdither | none | 7 | -0.302..+0.088 | 0.774 | 0.015 | 0.003 | 0x5D..0x5E |
| rc_s/sch | bangbang | none | 70 | -0.204..+0.536 | 0.500 | 0.166 | 0.166 | 0xC9..0xCA |
| rc_s/sch | deadband | none | 70 | -0.204..+0.536 | 0.500 | 0.166 | 0.166 | 0xC9..0xCA |
| rc_s/sch | avg32 | none | none | -0.204..+0.536 | 0.504 | 0.536 | 0.166 | 0xC9..0xCA |
| rc_s/sch | fracdither | none | 6 | -0.937..+0.536 | 0.701 | 0.028 | 0.007 | 0xC8..0xCA |
| tt/ext | bangbang | none | 82 | -0.253..+0.471 | 0.000 | 0.109 | 0.109 | 0xD5..0xD6 |
| tt/ext | deadband | none | 82 | -0.253..+0.471 | 0.000 | 0.109 | 0.109 | 0xD5..0xD6 |
| tt/ext | avg32 | none | none | -0.253..+0.471 | 0.000 | 0.471 | 0.109 | 0xD5..0xD6 |
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
| tt/ext | fracdither | -0.931..+0.978 | 0.466 | 0.069 | 0.020 | rail_frac=0.0000 |
| ff/ext | bangbang | -0.574..+0.582 | 0.447 | 0.278 | 0.230 | rail_frac=0.0000 |
| ff/ext | deadband | -0.419..+0.424 | 0.723 | 0.145 | 0.097 | rail_frac=0.0000 |
| ff/ext | avg32 | -0.380..+0.518 | 0.677 | 0.503 | 0.229 | rail_frac=0.0000 |
| ff/ext | fracdither | -0.710..+0.717 | 0.600 | 0.058 | 0.017 | rail_frac=0.0000 |
| ss/ext | bangbang | -0.478..+0.467 | 0.535 | 0.220 | 0.201 | rail_frac=0.0000 |
| ss/ext | deadband | -0.322..+0.468 | 0.894 | 0.168 | 0.137 | rail_frac=0.0000 |
| ss/ext | avg32 | -0.280..+0.459 | 0.890 | 0.453 | 0.306 | rail_frac=0.0000 |
| ss/ext | fracdither | -0.513..+0.513 | 0.702 | 0.111 | 0.037 | rail_frac=0.0000 |

### SOF jitter +/-500 ns

| plant | policy | inst min..max % | inst frac in band | avg16 absmax % | avg64 absmax % | extra |
|---|---|---|---|---|---|---|
| tt/sch | bangbang | -0.652..+0.638 | 0.435 | 0.273 | 0.222 | rail_frac=0.0000 |
| tt/sch | deadband | -0.510..+0.516 | 0.670 | 0.134 | 0.090 | rail_frac=0.0000 |
| tt/sch | avg32 | -0.394..+0.496 | 0.669 | 0.485 | 0.206 | rail_frac=0.0000 |
| tt/sch | fracdither | -0.724..+0.747 | 0.594 | 0.064 | 0.017 | rail_frac=0.0000 |
| ff/sch | bangbang | -0.518..+0.491 | 0.613 | 0.194 | 0.148 | rail_frac=0.0000 |
| ff/sch | deadband | -0.349..+0.345 | 0.921 | 0.118 | 0.083 | rail_frac=0.0000 |
| ff/sch | avg32 | -0.231..+0.313 | 0.911 | 0.303 | 0.174 | rail_frac=0.0000 |
| ff/sch | fracdither | -0.500..+0.490 | 0.781 | 0.041 | 0.013 | rail_frac=0.0000 |
| ss/sch | bangbang | -0.840..+0.856 | 0.345 | 0.360 | 0.317 | rail_frac=0.0000 |
| ss/sch | deadband | -0.688..+0.705 | 0.532 | 0.227 | 0.179 | rail_frac=0.0000 |
| ss/sch | avg32 | -0.585..+0.688 | 0.550 | 0.676 | 0.299 | rail_frac=0.0000 |
| ss/sch | fracdither | -1.047..+1.076 | 0.427 | 0.075 | 0.020 | rail_frac=0.0000 |
| fs/sch | bangbang | -0.656..+0.657 | 0.441 | 0.277 | 0.239 | rail_frac=0.0000 |
| fs/sch | deadband | -0.495..+0.515 | 0.680 | 0.148 | 0.095 | rail_frac=0.0000 |
| fs/sch | avg32 | -0.404..+0.465 | 0.687 | 0.455 | 0.177 | rail_frac=0.0000 |
| fs/sch | fracdither | -0.734..+0.710 | 0.594 | 0.058 | 0.017 | rail_frac=0.0000 |
| sf/sch | bangbang | -0.647..+0.658 | 0.432 | 0.283 | 0.241 | rail_frac=0.0000 |
| sf/sch | deadband | -0.495..+0.537 | 0.661 | 0.142 | 0.085 | rail_frac=0.0000 |
| sf/sch | avg32 | -0.398..+0.469 | 0.678 | 0.459 | 0.182 | rail_frac=0.0000 |
| sf/sch | fracdither | -0.708..+0.734 | 0.585 | 0.067 | 0.018 | rail_frac=0.0000 |
| rc_f/sch | bangbang | -0.489..+0.507 | 0.624 | 0.202 | 0.132 | rail_frac=0.0000 |
| rc_f/sch | deadband | -0.342..+0.341 | 0.939 | 0.125 | 0.081 | rail_frac=0.0000 |
| rc_f/sch | avg32 | -0.234..+0.322 | 0.911 | 0.310 | 0.183 | rail_frac=0.0000 |
| rc_f/sch | fracdither | -0.457..+0.462 | 0.801 | 0.044 | 0.014 | rail_frac=0.0000 |
| rc_s/sch | bangbang | -0.810..+0.882 | 0.340 | 0.370 | 0.300 | rail_frac=0.0000 |
| rc_s/sch | deadband | -0.656..+0.661 | 0.524 | 0.211 | 0.164 | rail_frac=0.0000 |
| rc_s/sch | avg32 | -0.561..+0.617 | 0.545 | 0.606 | 0.248 | rail_frac=0.0000 |
| rc_s/sch | fracdither | -0.980..+0.997 | 0.442 | 0.072 | 0.020 | rail_frac=0.0000 |
| tt/ext | bangbang | -0.798..+0.811 | 0.352 | 0.356 | 0.308 | rail_frac=0.0000 |
| tt/ext | deadband | -0.641..+0.660 | 0.541 | 0.209 | 0.163 | rail_frac=0.0000 |
| tt/ext | avg32 | -0.539..+0.615 | 0.575 | 0.607 | 0.253 | rail_frac=0.0000 |
| tt/ext | fracdither | -0.983..+1.024 | 0.468 | 0.076 | 0.018 | rail_frac=0.0000 |
| ff/ext | bangbang | -0.649..+0.638 | 0.447 | 0.265 | 0.218 | rail_frac=0.0000 |
| ff/ext | deadband | -0.499..+0.518 | 0.686 | 0.135 | 0.079 | rail_frac=0.0000 |
| ff/ext | avg32 | -0.380..+0.518 | 0.675 | 0.503 | 0.229 | rail_frac=0.0000 |
| ff/ext | fracdither | -0.697..+0.727 | 0.609 | 0.066 | 0.016 | rail_frac=0.0000 |
| ss/ext | bangbang | -0.532..+0.533 | 0.534 | 0.212 | 0.185 | rail_frac=0.0000 |
| ss/ext | deadband | -0.400..+0.467 | 0.831 | 0.117 | 0.079 | rail_frac=0.0000 |
| ss/ext | avg32 | -0.280..+0.459 | 0.890 | 0.453 | 0.306 | rail_frac=0.0000 |
| ss/ext | fracdither | -0.517..+0.521 | 0.705 | 0.130 | 0.039 | rail_frac=0.0000 |

## Supply steps 3.3 -> 3.0 -> 3.6 -> 3.3 V at +27 C (1500 frames each after an 8000-frame warm-up at 3.3 V; last 500 frames of final segment reported)

Re-lock (avg16 in band for 128 frames) in frames after each step, 3.0|3.6|3.3 V.

| plant | policy | re-lock frames | final-segment inst min..max % | avg16 absmax % |
|---|---|---|---|---|
| tt/sch | bangbang | 0|0|none | -0.038..+0.545 | 0.253 |
| tt/sch | deadband | 0|1|0 | -0.038..-0.038 | 0.038 |
| tt/sch | avg32 | 26|none|39 | -0.038..-0.038 | 0.038 |
| tt/sch | fracdither | 0|1|0 | -0.617..+0.545 | 0.037 |
| ff/sch | bangbang | 0|0|0 | -0.341..+0.063 | 0.139 |
| ff/sch | deadband | 0|1|0 | +0.063..+0.063 | 0.063 |
| ff/sch | avg32 | 61|67|32 | +0.063..+0.063 | 0.063 |
| ff/sch | fracdither | 0|1|0 | -0.341..+0.063 | 0.013 |
| ss/sch | bangbang | none|0|0 | -0.118..+0.593 | 0.237 |
| ss/sch | deadband | 0|0|1 | -0.118..-0.118 | 0.118 |
| ss/sch | avg32 | 33|none|10 | -0.118..-0.118 | 0.118 |
| ss/sch | fracdither | 0|1|0 | -0.824..+0.593 | 0.060 |
| fs/sch | bangbang | 1|0|0 | -0.077..+0.513 | 0.218 |
| fs/sch | deadband | 0|0|0 | -0.077..-0.077 | 0.077 |
| fs/sch | avg32 | 27|none|39 | -0.077..-0.077 | 0.077 |
| fs/sch | fracdither | 0|0|0 | -0.630..+0.513 | 0.038 |
| sf/sch | bangbang | none|0|0 | -0.363..+0.211 | 0.076 |
| sf/sch | deadband | 0|0|0 | -0.363..+0.211 | 0.076 |
| sf/sch | avg32 | 29|none|none | -0.363..+0.211 | 0.363 |
| sf/sch | fracdither | 0|0|0 | -0.363..+0.211 | 0.040 |
| rc_f/sch | bangbang | 0|0|0 | -0.302..+0.088 | 0.107 |
| rc_f/sch | deadband | 0|1|0 | +0.088..+0.088 | 0.088 |
| rc_f/sch | avg32 | none|97|31 | +0.088..+0.088 | 0.088 |
| rc_f/sch | fracdither | 0|1|0 | -0.302..+0.088 | 0.015 |
| rc_s/sch | bangbang | 0|0|0 | -0.204..+0.536 | 0.166 |
| rc_s/sch | deadband | 0|0|0 | -0.204..+0.536 | 0.166 |
| rc_s/sch | avg32 | none|none|none | -0.204..+0.536 | 0.536 |
| rc_s/sch | fracdither | 0|0|0 | -0.937..+0.536 | 0.028 |
| tt/ext | bangbang | none|0|0 | -0.253..+0.471 | 0.109 |
| tt/ext | deadband | 0|0|0 | -0.253..+0.471 | 0.109 |
| tt/ext | avg32 | 61|none|none | -0.253..+0.471 | 0.471 |
| tt/ext | fracdither | 0|0|0 | -0.253..+0.471 | 0.027 |
| ff/ext | bangbang | 0|1|0 | -0.248..+0.331 | 0.042 |
| ff/ext | deadband | 0|1|0 | -0.248..+0.331 | 0.042 |
| ff/ext | avg32 | 33|none|none | -0.248..+0.331 | 0.331 |
| ff/ext | fracdither | 0|0|0 | -0.248..+0.331 | 0.042 |
| ss/ext | bangbang | 2|2|0 | -0.316..+0.133 | 0.092 |
| ss/ext | deadband | 1|5|0 | +0.133..+0.133 | 0.133 |
| ss/ext | avg32 | none|196|63 | +0.133..+0.133 | 0.133 |
| ss/ext | fracdither | 1|2|0 | -0.316..+0.133 | 0.021 |

## Supply steps 3.3 -> 3.0 -> 3.6 -> 3.3 V at -40 C (1500 frames each after an 8000-frame warm-up at 3.3 V; last 500 frames of final segment reported)

Re-lock (avg16 in band for 128 frames) in frames after each step, 3.0|3.6|3.3 V.

| plant | policy | re-lock frames | final-segment inst min..max % | avg16 absmax % |
|---|---|---|---|---|
| tt/sch | bangbang | 0|1|0 | -0.310..+0.271 | 0.019 |
| tt/sch | deadband | 0|2|0 | -0.310..+0.271 | 0.019 |
| tt/sch | avg32 | 57|101|none | -0.310..+0.271 | 0.310 |
| tt/sch | fracdither | 0|1|0 | -0.310..+0.271 | 0.019 |
| ff/sch | bangbang | 0|0|0 | -0.328..+0.101 | 0.113 |
| ff/sch | deadband | 0|2|0 | +0.101..+0.101 | 0.101 |
| ff/sch | avg32 | 62|100|31 | +0.101..+0.101 | 0.101 |
| ff/sch | fracdither | 0|1|0 | -0.328..+0.101 | 0.021 |
| ss/sch | bangbang | 1|0|none | -0.705..+0.070 | 0.318 |
| ss/sch | deadband | 0|1|0 | +0.070..+0.070 | 0.070 |
| ss/sch | avg32 | none|none|38 | +0.070..+0.070 | 0.070 |
| ss/sch | fracdither | 0|0|0 | -0.705..+0.851 | 0.075 |
| fs/sch | bangbang | 0|1|0 | -0.194..+0.395 | 0.101 |
| fs/sch | deadband | 0|2|0 | -0.194..+0.395 | 0.101 |
| fs/sch | avg32 | none|69|none | -0.194..+0.395 | 0.395 |
| fs/sch | fracdither | 0|1|0 | -0.194..+0.395 | 0.027 |
| sf/sch | bangbang | none|0|0 | -0.398..+0.226 | 0.086 |
| sf/sch | deadband | 0|1|0 | -0.398..+0.226 | 0.086 |
| sf/sch | avg32 | 30|67|none | -0.398..+0.226 | 0.398 |
| sf/sch | fracdither | 0|0|0 | -0.398..+0.226 | 0.047 |
| rc_f/sch | bangbang | 0|2|0 | -0.211..+0.204 | 0.004 |
| rc_f/sch | deadband | 1|2|0 | -0.211..+0.204 | 0.004 |
| rc_f/sch | avg32 | 63|128|43 | -0.211..+0.204 | 0.211 |
| rc_f/sch | fracdither | 0|2|0 | -0.211..+0.204 | 0.030 |
| rc_s/sch | bangbang | 0|0|none | -0.015..+0.797 | 0.391 |
| rc_s/sch | deadband | 0|0|0 | -0.015..-0.015 | 0.015 |
| rc_s/sch | avg32 | none|none|39 | -0.015..-0.015 | 0.015 |
| rc_s/sch | fracdither | 0|0|0 | -0.750..+0.797 | 0.051 |
| tt/ext | bangbang | none|none|0 | -0.297..+0.427 | 0.065 |
| tt/ext | deadband | 0|0|0 | -0.297..+0.427 | 0.065 |
| tt/ext | avg32 | 30|37|none | -0.297..+0.427 | 0.427 |
| tt/ext | fracdither | 0|0|0 | -0.297..+0.427 | 0.025 |
| ff/ext | bangbang | 1|14|7 | -0.208..+0.435 | 0.114 |
| ff/ext | deadband | 0|15|8 | -0.208..+0.435 | 0.114 |
| ff/ext | avg32 | 58|none|none | -0.208..+0.435 | 0.435 |
| ff/ext | fracdither | 0|3|2 | -0.208..+0.435 | 0.047 |
| ss/ext | bangbang | none|2|0 | -0.286..+0.163 | 0.061 |
| ss/ext | deadband | none|4|0 | -0.286..+0.163 | 0.061 |
| ss/ext | avg32 | none|163|none | -0.286..+0.163 | 0.286 |
| ss/ext | fracdither | none|2|0 | -0.286..+0.163 | 0.033 |
