2AMLogic/gf180-rcosc/sim/pvt-postlayout/results/20260923T152954Z/summary.md

# Post-layout (PEX-extracted) PVT re-verification 20260923T152954Z

Generated by `sim/pvt-postlayout/pex_pvt_sweep.py` (issue #28). Append-only evidence: this file, `results.csv`, `manifest.json`, the extracted netlist and `klt extract` JSON report, and every raw log under `sim/pvt-postlayout/corners/20260923T152954Z/` belong to this run id and are never rewritten by a later run.

| | |
|---|---|
| git sha | `89399c6e080656f1eb5c8ac77e027f1b826d45f1` (dirty: True) |
| ngspice | ** ngspice-46 : Circuit level simulation program |
| klt | klt 0.4.0 |
| PDK | gf180mcuC @ `/home/ubuntu/.volare` |
| layout | `layout/cells/rcosc_top.gds` |
| extraction | `klt extract --deck gf180mcu --top rcosc_top --pdk gf180mcuC --deck-option poly_res=1k --deck-option mim_cap=cap_mim_1f0_m4m5_noshield --pins vdd,vss,clk,t0,t1,t2,t3,t4,t5,t6,t7 --parasitics` |
| schematic baseline | `sim/pvt/results/20260923T030125Z/` |
| trim code (fixed) | `0xA3` (163) |
| measurement | `tran 200p 1200n`, f averaged over 20 whole periods (rising edges 5..25, startup skipped) -- identical methodology to `sim/pvt/pvt_sweep.py` |
| points | 27 (process x temp x VDD corner-endpoint subset) |
| guardrails | DR-0017 Row-4 guardrail cell + per-process trim calibration, both sides (issue #61 `--guardrails`) -- see the guardrail verification section below |
| failed runs | 0 |
| wall clock | 166.3 s at 8 jobs |

## Corner-endpoint subset

| Axis | Values |
|---|---|
| process | `tt`, `ff`, `ss` |
| temperature | -40 C, 27 C, 85 C |
| supply | 3.0 V, 3.3 V, 3.6 V |

## Schematic vs. extracted (parasitic-annotated) frequency, per point

| process | T (C) | VDD (V) | schematic f (MHz) | extracted f (MHz) | delta |
|---|---|---|---|---|---|
| `tt` | -40 | 3 | 45.0962 | 34.1533 | -24.2658% |
| `tt` | -40 | 3.3 | 45.6780 | 34.5267 | -24.4129% |
| `tt` | -40 | 3.6 | 46.1489 | 34.6617 | -24.8917% |
| `tt` | 27 | 3 | 47.5037 | 35.4184 | -25.4406% |
| `tt` | 27 | 3.3 | 47.9819 | 35.8147 | -25.3578% |
| `tt` | 27 | 3.6 | 48.4263 | 36.0570 | -25.5423% |
| `tt` | 85 | 3 | 49.2452 | 36.6603 | -25.5556% |
| `tt` | 85 | 3.3 | 49.6345 | 36.8142 | -25.8294% |
| `tt` | 85 | 3.6 | 49.9635 | 37.0031 | -25.9398% |
| `ff` | -40 | 3 | 59.7911 | 41.4919 | -30.6052% |
| `ff` | -40 | 3.3 | 60.4137 | 40.8218 | -32.4295% |
| `ff` | -40 | 3.6 | 60.9576 | 38.4873 | -36.8621% |
| `ff` | 27 | 3 | 62.9051 | 43.8113 | -30.3534% |
| `ff` | 27 | 3.3 | 63.4892 | 43.6542 | -31.2415% |
| `ff` | 27 | 3.6 | 63.7795 | 43.0778 | -32.4583% |
| `ff` | 85 | 3 | 66.4868 | 47.5695 | -28.4526% |
| `ff` | 85 | 3.3 | 65.9634 | 46.3834 | -29.6831% |
| `ff` | 85 | 3.6 | 65.9624 | 45.5346 | -30.9688% |
| `ss` | -40 | 3 | 35.2895 | 28.4715 | -19.3203% |
| `ss` | -40 | 3.3 | 35.7749 | 29.0051 | -18.9234% |
| `ss` | -40 | 3.6 | 36.1695 | 29.3771 | -18.7794% |
| `ss` | 27 | 3 | 37.1302 | 29.3979 | -20.8249% |
| `ss` | 27 | 3.3 | 37.6537 | 29.9242 | -20.5278% |
| `ss` | 27 | 3.6 | 38.0329 | 30.3293 | -20.2552% |
| `ss` | 85 | 3 | 38.3927 | 30.1663 | -21.4268% |
| `ss` | 85 | 3.3 | 38.8682 | 30.6292 | -21.1973% |
| `ss` | 85 | 3.6 | 39.2416 | 30.9883 | -21.0320% |

## Verdict

Max |schematic-vs-extracted delta| across the 27-point subset: **36.8621%**

**Materially diverges**: max |delta| 36.86% exceeds the ratified post-trim calibration-point accuracy budget (+-1.1%, DR-0002/DR-0003) -- layout parasitics alone consume more margin than that budget allows, on top of the pre-existing process-spread shortfall every schematic-level campaign since DR-0005 already reports.

This is a comparison of the schematic-level RC-timed oscillator core against the same core re-simulated with `klt extract --parasitics`'s first-order lumped-RC model of `rcosc_top.gds`'s actual routing (one series R + one ground C per net, plus vertical-overlap coupling) -- it is **not** a re-verification of the process-spread/post-trim shortfall already reported against every schematic-level PVT campaign since DR-0005; that finding is unaffected by this record.

## Cross-check: environment/host numerical noise

This run's own **schematic**-side re-simulation (same host, same invocation as the extracted side above) differs from the already-committed `sim/pvt/results/20260923T030125Z/` campaign's own `posttrim_spec` pass at the same trim code -- an independent run of the *same* unmodified schematic and methodology, on a different host -- by up to **0.00%** at matched (process, T, VDD) points. This is cross-host/cross-run ngspice numerical variance (see DR-0009's own environment note), not a design or tooling change, and it is over an order of magnitude smaller than the schematic-vs-extracted delta this record reports (max 36.86%), so it does not call the main finding into question. The schematic-vs-extracted comparison above is always computed within one run/host (never against the older committed baseline), which is what keeps this cross-check orthogonal to it.

## DR-0017 guardrail verification (issue #61, `--guardrails`)

The two guardrails DR-0017 verified at the schematic level (issue #57) re-measured here against the parasitic-annotated netlist -- same run, same host, both sides simulated by this invocation, so every comparison below is in-run.

### Guardrail 1 -- f must not increase at the Row-4 guardrail cell (`0x80` / `ff` / 85 C / 3.6 V)

| side | f (MHz) |
|---|---|
| schematic (this run) | 55.3154 |
| extracted (this run) | 38.0790 |
| DR-0017 campaign basis | 55.3154 |

In-run extracted-vs-schematic delta at the cell: **-31.16%** (same sign and magnitude class as the 27-point subset above -- the guardrail cell is not an outlier).
Verdict: **holds**: the extracted side runs 31.16% *below* DR-0017's campaign basis (55.3154 MHz, this baseline's own `pretrim` row at the cell -- the "campaign 55.32" figure DR-0017 quotes).

### Guardrail 2 -- trim range must not regress (per-process calibration at 27 C / 3.3 V against the ratified 48.000 MHz target)

The same single-point trim search `sim/pvt/pvt_sweep.py`'s `calibrate` performs, run here on both sides of this campaign (DR-0017's schematic-level finding: every corner inner-range, codes `0x59`..`0xCD`, none saturated).

| process | side | f(0x00) (MHz) | f(0xFF) (MHz) | cal code | f at cal code (MHz) | saturated | DR-0017 campaign code |
|---|---|---|---|---|---|---|---|
| `tt` | schematic | 26.3375 | 83.2292 | `0xA3` | 47.9819 | False | `0xA3` |
| `tt` | extracted | 20.8063 | 60.5821 | `0xD9` | 48.0250 | False | `0xA3` |
| `ff` | schematic | 35.4096 | 108.6096 | `0x59` | 48.0463 | False | `0x59` |
| `ff` | extracted | 25.6300 | 72.5320 | `0xB3` | 48.0158 | False | `0x59` |
| `ss` | schematic | 20.4581 | 66.0540 | `0xCD` | 47.8777 | False | `0xCD` |
| `ss` | extracted | 17.3544 | 50.2762 | `0xF7` | 48.0188 | False | `0xCD` |

Verdict: **holds** -- every extracted-side corner still calibrates inner-range (none saturated) against the ratified target; the code movement vs the schematic side (table above) is the layout-parasitic frequency penalty being trimmed out, and the remaining headroom to `0xFF` is visible in each row's `f(0xFF)`.
