2AMLogic/gf180-rcosc/sim/discipline/results/20261009T010000Z/results.csv

exp | plant | policy | jitter_ns | lock_inst_frames | lock_avg16_frames | ss_min | ss_max | ss_pp | ss_absmax | ss_frac_in_band | ss_avg16_absmax | ss_avg64_absmax | ss_code_min | ss_code_max | extra
cold_start_27C_3p3V | tt/sch | bangbang | 0.0000 | none | none | -0.0378 | 0.5447 | 0.5825 | 0.5447 | 0.5000 | 0.2535 | 0.2535 | 163 | 164
ramp_1C_per_s | tt/sch | bangbang | 0.0000 |  |  | -0.5789 | 0.5828 | 1.1617 | 0.5828 | 0.4361 | 0.2904 | 0.2886 | 157 | 172 | rail_frac=0.0000
ramp_20C_per_s | tt/sch | bangbang | 0.0000 |  |  | -0.5769 | 0.5837 | 1.1606 | 0.5837 | 0.4366 | 0.2828 | 0.2547 | 157 | 172 | rail_frac=0.0000
vdd_steps_+27C | tt/sch | bangbang | 0.0000 |  | 0|0|None | -0.0378 | 0.5447 | 0.5825 | 0.5447 | 0.5000 | 0.2535 |  | 163 | 164 | relock_avg16 after 3.0|3.6|3.3 V
vdd_steps_-40C | tt/sch | bangbang | 0.0000 |  | 0|1|0 | -0.3097 | 0.2712 | 0.5809 | 0.3097 | 0.0000 | 0.0192 |  | 171 | 172 | relock_avg16 after 3.0|3.6|3.3 V
cold_start_27C_3p3V | tt/sch | deadband | 0.0000 | 35 | 33 | -0.0378 | -0.0378 | 0.0000 | 0.0378 | 1.0000 | 0.0378 | 0.0378 | 163 | 163
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
