2AMLogic/gf180-rcosc/sim/row45-rerun/results/20261113T064105Z-iq-extracted-l07/table.md

| code | VDD | die | T (C) | L 0.7 (uA) | control L 1.0 (uA) | delta (%) |
|---|---|---|---|---|---|---|
| 0x00 | 3.0 | ff | -40 | 292.2 | 292.0 | +0.04 |
| 0x00 | 3.0 | ff | 27 | 333.5 | 333.6 | -0.04 |
| 0x00 | 3.0 | ff | 85 | 391.4 | 392.6 | -0.31 |
| 0x00 | 3.0 | ss | -40 | 153.7 | 153.7 | -0.00 |
| 0x00 | 3.0 | ss | 27 | 174.0 | 174.0 | +0.02 |
| 0x00 | 3.0 | ss | 85 | 202.3 | 202.2 | +0.04 |
| 0x00 | 3.0 | tt | -40 | 208.0 | 207.9 | +0.03 |
| 0x00 | 3.0 | tt | 27 | 234.5 | 234.4 | +0.03 |
| 0x00 | 3.0 | tt | 85 | 272.5 | 272.7 | -0.07 |
| 0x00 | 3.3 | ff | -40 | 341.0 | 341.0 | +0.01 |
| 0x00 | 3.3 | ff | 27 | 377.7 | 377.8 | -0.02 |
| 0x00 | 3.3 | ff | 85 | 432.8 | 435.0 | -0.51 |
| 0x00 | 3.3 | ss | -40 | 181.3 | 181.4 | -0.01 |
| 0x00 | 3.3 | ss | 27 | 197.7 | 197.8 | -0.00 |
| 0x00 | 3.3 | ss | 85 | 224.0 | 224.0 | +0.02 |
| 0x00 | 3.3 | tt | -40 | 243.4 | 243.4 | +0.00 |
| 0x00 | 3.3 | tt | 27 | 266.2 | 266.2 | -0.03 |
| 0x00 | 3.3 | tt | 85 | 302.3 | 302.5 | -0.06 |
| 0x00 | 3.6 | ff | -40 | 396.5 | 396.6 | -0.02 |
| 0x00 | 3.6 | ff | 27 | 427.0 | 427.2 | -0.05 |
| 0x00 | 3.6 | ff | 85 | 479.1 | 481.1 | -0.41 |
| 0x00 | 3.6 | ss | -40 | 212.5 | 212.5 | -0.00 |
| 0x00 | 3.6 | ss | 27 | 224.9 | 224.9 | -0.02 |
| 0x00 | 3.6 | ss | 85 | 249.2 | 249.3 | -0.02 |
| 0x00 | 3.6 | tt | -40 | 284.5 | 284.5 | +0.00 |
| 0x00 | 3.6 | tt | 27 | 303.0 | 303.1 | -0.02 |
| 0x00 | 3.6 | tt | 85 | 336.4 | 336.6 | -0.05 |
| 0x80 | 3.0 | ff | -40 | 326.5 | 326.4 | +0.05 |
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
| 0xFF | 3.6 | ss | 85 | 431.1 | 431.2 | -0.02 |
| 0xFF | 3.6 | tt | -40 | 509.9 | 509.3 | +0.11 |
| 0xFF | 3.6 | tt | 27 | 528.3 | 528.2 | +0.02 |
| 0xFF | 3.6 | tt | 85 | 559.8 | 562.3 | -0.45 |

max L 0.7: 759.0 uA (n=108); max control: 779.4 uA (n=108); limit 500 uA
