2AMLogic/gf180-rcosc/sim/trim-dense/results/20261106T1115Z-campaign/SLICE-36.md

# Slice 36 (#87, `Part of #87`)

Ran `run_batch.py --limit 36` (concurrency cap 2) on the batch fleet
(`uvx --from klayout-tools==0.9.0 klt`, `KLT_SIM_BACKEND=batch`) against the bench regenerated with the manifest's
netlists and `--capacity-wait-s 1200`; its `provenance.json` hash was `d1d24253...`, identical to
`manifest.json:provenance_sha256`. The run was a bounded in-turn poll; no local process of this run is left running.

Result: ledger now holds 756 of 1536 jobs (756 distinct tags), all `done`, all submitted with `--backend batch`.
This slice: 36 done, 0 not done (`ext_tt_27C_3p3V` c(D0..F3)). `ext_tt_27C_3p3V` is now 244 of 256.
Per-job `reports/report_<tag>.json` and `jobs/<tag>/` receipts are committed; no existing receipt was rewritten.
No step or carry claim is made here; that is for `analyze.py` once the curves are complete.
Supersedes the counts in `README.md` and earlier `SLICE-*.md` (append-only, left unedited).

780 jobs remain (`ext_tt_27C_3p3V` c(F4..FF) = 12, plus 768 `sch`), then `analyze.py --manifest` and the verdict DR (0030).
`test_harness.py` was not re-run (no code changed).
