2AMLogic/gf180-rcosc/sim/trim-dense/results/20261106T1115Z-campaign/SLICE-29.md

# Slice 29 (#87, `Part of #87`)

Ran `run_batch.py --limit 12` (concurrency cap 2) in the foreground on the batch fleet
(`uvx --from klayout-tools==0.9.0 klt`, `KLT_SIM_BACKEND=batch`) against the bench regenerated with the manifest's
netlists and `--capacity-wait-s 1200`; its `provenance.json` was byte-identical to the committed one (`d1d24253...`,
`manifest.json:provenance_sha256`). Wall time ~5.9 min for 12 jobs. The run finished inside the session cap; no local
process of this run is left running.

Result: ledger now holds 576 of 1536 jobs, all `done`, all submitted with `--backend batch`.
This slice: 12 done, 0 not done (`ext_tt_27C_3p3V` c34..c3F). `ext_tt_27C_3p3V` now covers c00..c3F.
Per-job `reports/report_<tag>.json` and `jobs/<tag>/` receipts are committed; no existing receipt was rewritten.
No step or carry claim is made here; that is for `analyze.py` once the curves are complete.
Supersedes the counts in `README.md` and earlier `SLICE-*.md` (append-only, left unedited).

960 jobs remain, then `analyze.py --manifest` and the verdict DR (0030).
`test_harness.py` was not re-run (no code changed).
