2AMLogic/gf180-rcosc/sim/trim-dense/results/20261106T1115Z-campaign/SLICE-20.md

# Slice 20 (#87, `Part of #87`)

Ran `run_batch.py --limit 14` (concurrency cap 2) in the foreground on the batch fleet
(`uvx --from klayout-tools==0.9.0 klt`) against the bench regenerated with the manifest's netlists and
`--capacity-wait-s 1200`; its `provenance.json` was byte-identical to the committed one (`d1d24253...`,
`manifest.json:provenance_sha256`). No local process of this run is left running.

Result: ledger now holds 447 of 1536 jobs, all `done`, all submitted with `--backend batch`.
This slice: 14 done, 0 not done (`ext_ss_m40C_3p0V_cB1..cBE`, hex codes 0xB1..0xBE; every report status `pass`).
`ext_ss_m40C_3p0V` now covers `c00..cBE`. No step or carry claim is made here; that is for `analyze.py` once the
curve is complete. No resubmissions in this slice.
Supersedes the counts in `README.md` and earlier `SLICE-*.md` (append-only, left unedited).

1089 jobs remain, then `analyze.py --manifest` and the verdict DR (0030).
`test_harness.py` was not re-run (no code changed).
