2AMLogic/gf180-rcosc/sim/startup-settled/results/20261106T061500Z/summary.md

# Startup-time sweep on the settled netlist 20261106T061500Z (issue #227)

Generated by `sim/startup-settled/settled_report.py` (analysis reused from `sim/startup/startup_report.py`)
from `klt sim` reports of `sim/startup-settled/request_v*.json`. DUT: settled P3 netlist, trim code 0xA9.
t = 0 is the start of a 1000 ns linear 0 -> VDD ramp. Spec: startup time <= 10 us;
primary band 1.1% (DR-0020). Append-only evidence.

**Run note: fs/-40 C at 3.3 V and 3.6 V are NON-START on the settled netlist (root cause: sim/startup-fs-m40c/results/20261106T061000Z/summary.md); bench, bands and tail tolerance unchanged.**

## Batch job provenance

- `report_v30.json` (VDD 3 V): status `pass`, 21 corners, aws-batch-fleet job `klt-sim-8bfc88ec9089`, runner klt 0.9.0, client klt 0.9.2.dev47+g581de87616d8
- `report_v33.json` (VDD 3.3 V): status `error`, 21 corners, aws-batch-fleet job `klt-sim-077f87f7e2da`, runner klt 0.9.0, client klt 0.9.2.dev47+g581de87616d8
- `report_v36.json` (VDD 3.6 V): status `error`, 21 corners, aws-batch-fleet job `klt-sim-bc8b7ef559f9`, runner klt 0.9.0, client klt 0.9.2.dev47+g581de87616d8

## Verdict: 61/63 points pass the primary band; 2 NON-START

| process | T (C) | VDD (V) | status | f settled (MHz) | first edge (us) | settle +/-1.1% (us) | settle +/-2.9% (us) | settle +/-10.8% (us) | verdict |
|---|---|---|---|---|---|---|---|---|---|
| `ff` | -40 | 3 | STARTED | 57.01 | 0.587 | 2.505 | 1.381 | 0.933 | pass |
| `ff` | 27 | 3 | STARTED | 60.38 | 0.583 | 1.184 | 0.768 | 0.664 | pass |
| `ff` | 85 | 3 | STARTED | 65.85 | 0.576 | 0.944 | 0.900 | 0.777 | pass |
| `fs` | -40 | 3 | STARTED | 26.08 | 0.627 | 2.422 | 2.124 | 1.490 | pass |
| `fs` | 27 | 3 | STARTED | 46.06 | 0.619 | 2.563 | 1.347 | 0.754 | pass |
| `fs` | 85 | 3 | STARTED | 52.25 | 0.610 | 0.948 | 0.894 | 0.793 | pass |
| `rc_f` | -40 | 3 | STARTED | 56.82 | 0.580 | 1.014 | 0.888 | 0.580 | pass |
| `rc_f` | 27 | 3 | STARTED | 59.13 | 0.578 | 0.835 | 0.786 | 0.665 | pass |
| `rc_f` | 85 | 3 | STARTED | 65.47 | 0.575 | 0.966 | 0.907 | 0.756 | pass |
| `rc_s` | -40 | 3 | STARTED | 38.43 | 0.572 | 0.990 | 0.856 | 0.572 | pass |
| `rc_s` | 27 | 3 | STARTED | 39.38 | 0.572 | 0.914 | 0.808 | 0.572 | pass |
| `rc_s` | 85 | 3 | STARTED | 40.08 | 0.568 | 0.878 | 0.656 | 0.568 | pass |
| `sf` | -40 | 3 | STARTED | 45.85 | 0.549 | 0.860 | 0.792 | 0.600 | pass |
| `sf` | 27 | 3 | STARTED | 46.93 | 0.533 | 0.872 | 0.783 | 0.533 | pass |
| `sf` | 85 | 3 | STARTED | 47.76 | 0.534 | 0.850 | 0.534 | 0.534 | pass |
| `ss` | -40 | 3 | STARTED | 37.09 | 0.584 | 0.913 | 0.828 | 0.648 | pass |
| `ss` | 27 | 3 | STARTED | 37.88 | 0.571 | 0.903 | 0.820 | 0.571 | pass |
| `ss` | 85 | 3 | STARTED | 38.59 | 0.550 | 0.698 | 0.650 | 0.550 | pass |
| `tt` | -40 | 3 | STARTED | 46.08 | 0.570 | 1.006 | 0.872 | 0.570 | pass |
| `tt` | 27 | 3 | STARTED | 47.31 | 0.568 | 0.944 | 0.625 | 0.568 | pass |
| `tt` | 85 | 3 | STARTED | 48.74 | 0.565 | 0.858 | 0.800 | 0.671 | pass |
| `ff` | -40 | 3.3 | STARTED | 55.26 | 0.570 | 1.646 | 1.239 | 0.967 | pass |
| `ff` | 27 | 3.3 | STARTED | 59.95 | 0.564 | 1.352 | 1.011 | 0.605 | pass |
| `ff` | 85 | 3.3 | STARTED | 63.91 | 0.568 | 0.889 | 0.859 | 0.733 | pass |
| `fs` | -40 | 3.3 | NON-START | nan | 0.603 | — | — | — | FAIL: NON-START |
| `fs` | 27 | 3.3 | STARTED | 40.26 | 0.610 | 2.325 | 1.615 | 1.058 | pass |
| `fs` | 85 | 3.3 | STARTED | 49.79 | 0.600 | 1.080 | 0.860 | 0.772 | pass |
| `rc_f` | -40 | 3.3 | STARTED | 57.56 | 0.574 | 1.045 | 0.885 | 0.574 | pass |
| `rc_f` | 27 | 3.3 | STARTED | 59.55 | 0.568 | 0.952 | 0.702 | 0.597 | pass |
| `rc_f` | 85 | 3.3 | STARTED | 63.64 | 0.568 | 0.917 | 0.872 | 0.744 | pass |
| `rc_s` | -40 | 3.3 | STARTED | 38.84 | 0.564 | 1.055 | 0.843 | 0.564 | pass |
| `rc_s` | 27 | 3.3 | STARTED | 39.93 | 0.562 | 0.930 | 0.801 | 0.562 | pass |
| `rc_s` | 85 | 3.3 | STARTED | 40.57 | 0.556 | 0.899 | 0.578 | 0.556 | pass |
| `sf` | -40 | 3.3 | STARTED | 46.67 | 0.540 | 0.866 | 0.777 | 0.565 | pass |
| `sf` | 27 | 3.3 | STARTED | 47.68 | 0.545 | 0.859 | 0.772 | 0.545 | pass |
| `sf` | 85 | 3.3 | STARTED | 48.35 | 0.524 | 0.860 | 0.732 | 0.524 | pass |
| `ss` | -40 | 3.3 | STARTED | 37.92 | 0.573 | 0.894 | 0.811 | 0.636 | pass |
| `ss` | 27 | 3.3 | STARTED | 38.70 | 0.558 | 0.888 | 0.807 | 0.558 | pass |
| `ss` | 85 | 3.3 | STARTED | 39.30 | 0.562 | 0.867 | 0.562 | 0.562 | pass |
| `tt` | -40 | 3.3 | STARTED | 46.64 | 0.554 | 1.053 | 0.855 | 0.554 | pass |
| `tt` | 27 | 3.3 | STARTED | 47.94 | 0.569 | 0.952 | 0.802 | 0.569 | pass |
| `tt` | 85 | 3.3 | STARTED | 48.98 | 0.565 | 0.747 | 0.709 | 0.600 | pass |
| `ff` | -40 | 3.6 | STARTED | 51.65 | 0.561 | 1.236 | 1.077 | 0.561 | pass |
| `ff` | 27 | 3.6 | STARTED | 58.85 | 0.565 | 1.239 | 1.013 | 0.565 | pass |
| `ff` | 85 | 3.6 | STARTED | 62.46 | 0.566 | 0.998 | 0.824 | 0.694 | pass |
| `fs` | -40 | 3.6 | NON-START | nan | 0.608 | — | — | — | FAIL: NON-START |
| `fs` | 27 | 3.6 | STARTED | 30.62 | 0.593 | 1.267 | 1.132 | 1.022 | pass |
| `fs` | 85 | 3.6 | STARTED | 46.41 | 0.596 | 1.471 | 1.096 | 0.760 | pass |
| `rc_f` | -40 | 3.6 | STARTED | 57.83 | 0.559 | 1.047 | 0.852 | 0.559 | pass |
| `rc_f` | 27 | 3.6 | STARTED | 59.91 | 0.565 | 0.959 | 0.625 | 0.565 | pass |
| `rc_f` | 85 | 3.6 | STARTED | 62.61 | 0.564 | 0.874 | 0.828 | 0.698 | pass |
| `rc_s` | -40 | 3.6 | STARTED | 38.90 | 0.562 | 1.047 | 0.783 | 0.562 | pass |
| `rc_s` | 27 | 3.6 | STARTED | 40.25 | 0.561 | 0.952 | 0.773 | 0.561 | pass |
| `rc_s` | 85 | 3.6 | STARTED | 40.90 | 0.550 | 0.898 | 0.747 | 0.550 | pass |
| `sf` | -40 | 3.6 | STARTED | 47.31 | 0.535 | 0.876 | 0.767 | 0.535 | pass |
| `sf` | 27 | 3.6 | STARTED | 48.25 | 0.541 | 0.850 | 0.764 | 0.541 | pass |
| `sf` | 85 | 3.6 | STARTED | 48.75 | 0.537 | 0.832 | 0.705 | 0.537 | pass |
| `ss` | -40 | 3.6 | STARTED | 38.48 | 0.568 | 0.881 | 0.800 | 0.599 | pass |
| `ss` | 27 | 3.6 | STARTED | 39.34 | 0.551 | 0.880 | 0.800 | 0.551 | pass |
| `ss` | 85 | 3.6 | STARTED | 39.89 | 0.554 | 0.887 | 0.783 | 0.554 | pass |
| `tt` | -40 | 3.6 | STARTED | 46.76 | 0.546 | 1.041 | 0.821 | 0.546 | pass |
| `tt` | 27 | 3.6 | STARTED | 48.34 | 0.559 | 0.965 | 0.795 | 0.559 | pass |
| `tt` | 85 | 3.6 | STARTED | 49.26 | 0.553 | 0.904 | 0.643 | 0.553 | pass |
