2AMLogic/gf180-rcosc/sim/recentre/results/20261011T033717Z/ERRATUM.md

# Erratum: raw-log collision in run 20261011T033717Z (PR #158 review)

`explore.py points` named each raw log `<candidate>_pt_<code>.log`, without the corner, so points of
this run that share a trim code wrote the same file and only the last one survived. The `log` column of
`results.csv` is therefore wrong for the rows marked *overwritten* below: the file it names holds a
different corner (its first line states which). `results.csv` and the surviving logs are left as
committed. Each overwritten row was re-run as its own single-corner `explore.py points` invocation
(one ngspice process) under a new run id, with the corner in the log name; every re-run reproduced
`f_hz` and `iq_a` bit-identically. `report_explore.py` takes the newest run per key, so summaries
generated after this erratum cite the re-run logs.

| corner | code | f_hz | committed log | status | re-run (new run id) and its log |
|---|---|---|---|---|---|
| tt:27:3.3 | 0xAF | 47940420.0 | `r070_20x10_pt_0xAF.log` | overwritten | `sim/recentre/results/20261011T035358Z/`, `sim/recentre/corners/explore-20261011T035358Z-points/r070_20x10_pt_tt_27C_3.3V_0xAF.log` |
| tt:-40:3 | 0xAF | 45216260.0 | `r070_20x10_pt_0xAF.log` | overwritten | `sim/recentre/results/20261011T035405Z/`, `sim/recentre/corners/explore-20261011T035405Z-points/r070_20x10_pt_tt_m40C_3V_0xAF.log` |
| tt:85:3.6 | 0xAF | 49655890.0 | `r070_20x10_pt_0xAF.log` | intact (last writer of that file) | - |
| ff:27:3.3 | 0x59 | 48032560.0 | `r070_20x10_pt_0x59.log` | overwritten | `sim/recentre/results/20261011T035412Z/`, `sim/recentre/corners/explore-20261011T035412Z-points/r070_20x10_pt_ff_27C_3.3V_0x59.log` |
| ff:-40:3.6 | 0x59 | 46319200.0 | `r070_20x10_pt_0x59.log` | overwritten | `sim/recentre/results/20261011T035422Z/`, `sim/recentre/corners/explore-20261011T035422Z-points/r070_20x10_pt_ff_m40C_3.6V_0x59.log` |
| ff:85:3 | 0x59 | 50086270.0 | `r070_20x10_pt_0x59.log` | intact (last writer of that file) | - |
| ss:27:3.3 | 0xE7 | 48119010.0 | `r070_20x10_pt_0xE7.log` | overwritten | `sim/recentre/results/20261011T035429Z/`, `sim/recentre/corners/explore-20261011T035429Z-points/r070_20x10_pt_ss_27C_3.3V_0xE7.log` |
| ss:-40:3 | 0xE7 | 44671100.0 | `r070_20x10_pt_0xE7.log` | overwritten | `sim/recentre/results/20261011T035436Z/`, `sim/recentre/corners/explore-20261011T035436Z-points/r070_20x10_pt_ss_m40C_3V_0xE7.log` |
| ss:85:3.6 | 0xE7 | 50480450.0 | `r070_20x10_pt_0xE7.log` | intact (last writer of that file) | - |
