2AMLogic/gf180-rcosc/sim/recentre/results/20261011T034200Z/summary.md

# P3 27-point range / post-trim confirmation: batch submission FAILED (no measurements)

Requests: `sim/recentre/p3/request_{tt,ff,ss}.json` (3 x 9 corners = the 27-point subset),
generated by `sim/recentre/gen_requests.py`, submitted with
`KLT_SIM_BACKEND=batch klt sim sim/recentre/p3/request_<p>.json -o <outdir> --format json`
from client `klt 0.7.0+g0d0312b30708` on 2026-10-11.

| request | batch job id | state | exit | runner klt | corners errored |
|---|---|---|---|---|---|
| tt | `klt-sim-71b47285a46d` | failed | 87 | 0.5.0 | 9 of 9 |
| ff | `klt-sim-06e10de5dae5` | failed | 87 | 0.5.0 | 9 of 9 |
| ss | `klt-sim-4e4b4ff9a358` | failed | 87 | 0.5.0 | 9 of 9 |

Diagnostic (every corner, code `batch_job_failed`): the fleet runner runs klt 0.5.0 but the
submitting client is 0.7.0; the job exits 87 before simulating. This is the open fleet
blocker 2AMLogic/klayout-tools#2851 (same signature as `sim/startup/batch-attempts/`).
Raw reports: `report_{tt,ff,ss}.json`; client stderr: `stderr_*.txt`.

Per host policy the grid was NOT run locally as a fallback. There is therefore **no 27-point
result in this directory and none may be claimed**. What does exist for the proposed sizing is a
set of single-corner probes (see the explore summary `../20261011T035649Z/summary.md`), which are not a substitute for the grid.
To complete the evidence, re-submit the same three requests once the runner image matches the
client, then post-process the `ta_*`/`tb_*` edge times as
f = 20 / (t25 - t5) (`gen_requests.py` docstring) and grade: f(0x00) <= 48 MHz <= f(0xFF) at each
point, and f(cal code) against 48 MHz.
