2AMLogic/gf180-rcosc/sim/recentre/results/20261011T035649Z/summary.md

# Re-centre exploration summary (issue #66)

Generated by `sim/recentre/report_explore.py` from every explore run `sim/recentre/results/<runid>/results.csv` (driver `explore.py`; each row is one serial single-corner ngspice transient, logs in `sim/recentre/corners/explore-*`; the `log` column names the raw log behind each T/V row; newest run wins per key). Model A = netlist as extracted (1 Tohm substrate shunt); model B = same with `vsubs` hard-tied to ground.

## Candidates

* `base`: committed sizing, fixed-value MiM C card as extracted (217.2 fF)
* `base_subckt`: committed sizing, PDK cap_mim_1f0fF 20x10 subckt (corner-aware MiM)
* `prop_r080_17x10`: P1: ladder R x0.80, MiM 17x10 um (185.6 fF)
* `optB_r066_24x10`: P2: ladder R x0.66, MiM 24x10 um (260 fF)
* `r070_20x10`: P3: ladder R x0.70, MiM unchanged 20x10 um (217.2 fF)

## Trim-range endpoints at tt / 27 C / 3.3 V (ratified range: 28.800 - 67.200 MHz)

| candidate | substrate | f(0x00) MHz | f(0xFF) MHz | margin below 28.8 | margin above 67.2 | ratio f(0xFF)/f(0x00) |
|---|---|---|---|---|---|---|
| `base` | as-extracted | 20.806 | 60.582 | +38.4 % | -9.8 % | 2.912 |
| `base_subckt` | as-extracted | 20.804 | 60.553 | +38.4 % | -9.9 % | 2.911 |
| `prop_r080_17x10` | as-extracted | 27.371 | 70.759 | +5.2 % | +5.3 % | 2.585 |
| `prop_r080_17x10` | hard-tied | 26.835 | 66.069 | +7.3 % | -1.7 % | 2.462 |
| `optB_r066_24x10` | as-extracted | 26.860 | 72.728 | +7.2 % | +8.2 % | 2.708 |
| `optB_r066_24x10` | hard-tied | 26.428 | 68.648 | +9.0 % | +2.2 % | 2.598 |
| `r070_20x10` | as-extracted | 28.203 | 73.524 | +2.1 % | +9.4 % | 2.607 |
| `r070_20x10` | hard-tied | 27.705 | 69.043 | +4.0 % | +2.7 % | 2.492 |

## Calibration to 48.000 MHz at 27 C / 3.3 V (code = closest of the final bisection bracket)

| candidate | substrate | process | cal code | f (MHz) | error vs 48 MHz | f(code+1)/f(code)-1 (LSB) | Iq at code (uA) |
|---|---|---|---|---|---|---|---|
| `base_subckt` | as-extracted | tt | 0xD9 (217) | 48.024 | +0.05 % | 0.87 % | 335.3 |
| `prop_r080_17x10` | as-extracted | tt | 0xAE (174) | 47.895 | -0.22 % | 0.57 % | 321.5 |
| `prop_r080_17x10` | as-extracted | ff | 0x5F (95) | 48.007 | +0.01 % | 0.51 % | 410.4 |
| `prop_r080_17x10` | as-extracted | ss | 0xDB (219) | 48.042 | +0.09 % | 0.78 % | 275.5 |
| `optB_r066_24x10` | as-extracted | tt | 0xAF (175) | 47.886 | -0.24 % | 0.52 % | 332.8 |
| `optB_r066_24x10` | as-extracted | ff | 0x65 (101) | 47.993 | -0.02 % | 0.33 % | 420.5 |
| `optB_r066_24x10` | as-extracted | ss | 0xDB (219) | 48.017 | +0.04 % | 0.75 % | 288.2 |
| `r070_20x10` | as-extracted | tt | 0xA9 (169) | 48.048 | +0.10 % | 0.50 % | 327.0 |
| `r070_20x10` | as-extracted | ff | 0x59 (89) | 48.081 | +0.17 % | 0.33 % | 415.0 |
| `r070_20x10` | as-extracted | ss | 0xD7 (215) | 48.124 | +0.26 % | 0.69 % | 281.2 |
| `r070_20x10` | hard-tied | tt | 0xAF (175) | 47.940 | -0.12 % | 0.30 % | 308.4 |
| `r070_20x10` | hard-tied | ff | 0x59 (89) | 48.033 | +0.07 % | 0.34 % | 384.1 |
| `r070_20x10` | hard-tied | ss | 0xE7 (231) | 48.119 | +0.25 % | 0.36 % | 291.7 |

## Post-trim drift of proposed P3 at the T/V extremes of the 0xA3 27-point record

Per-process calibrated code held; the two extreme points per process are the min/max-frequency points of the 0xA3 27-point record (`sim/pvt-postlayout/results/20260923T152954Z/`). 9 single-corner probes per substrate model, not the 27-point grid.

### P3, substrate model as-extracted

| process | code | point | f (MHz) | vs 48 MHz | vs own 27C/3.3V calibration point | log |
|---|---|---|---|---|---|---|
| tt | 0xA9 | tt:27:3.3 | 48.048 | +0.10 % | +0.00 % | `sim/recentre/corners/explore-20261011T035323Z-points/r070_20x10_pt_tt_27C_3.3V_0xA9.log` |
| tt | 0xA9 | tt:-40:3 | 46.193 | -3.76 % | -3.86 % | `sim/recentre/corners/explore-20261011T035327Z-points/r070_20x10_pt_tt_m40C_3V_0xA9.log` |
| tt | 0xA9 | tt:85:3.6 | 49.345 | +2.80 % | +2.70 % | `sim/recentre/corners/explore-20261011T033428Z-points/r070_20x10_pt_0xA9.log` |
| ff | 0x59 | ff:27:3.3 | 48.081 | +0.17 % | +0.00 % | `sim/recentre/corners/explore-20261011T035337Z-points/r070_20x10_pt_ff_27C_3.3V_0x59.log` |
| ff | 0x59 | ff:-40:3.6 | 43.482 | -9.41 % | -9.56 % | `sim/recentre/corners/explore-20261011T035313Z-points/r070_20x10_pt_ff_m40C_3.6V_0x59.log` |
| ff | 0x59 | ff:85:3 | 51.916 | +8.16 % | +7.98 % | `sim/recentre/corners/explore-20261011T033428Z-points/r070_20x10_pt_0x59.log` |
| ss | 0xD7 | ss:27:3.3 | 48.124 | +0.26 % | +0.00 % | `sim/recentre/corners/explore-20261011T035344Z-points/r070_20x10_pt_ss_27C_3.3V_0xD7.log` |
| ss | 0xD7 | ss:-40:3 | 46.461 | -3.21 % | -3.46 % | `sim/recentre/corners/explore-20261011T035350Z-points/r070_20x10_pt_ss_m40C_3V_0xD7.log` |
| ss | 0xD7 | ss:85:3.6 | 49.363 | +2.84 % | +2.58 % | `sim/recentre/corners/explore-20261011T033428Z-points/r070_20x10_pt_0xD7.log` |

### P3, substrate model hard-tied

| process | code | point | f (MHz) | vs 48 MHz | vs own 27C/3.3V calibration point | log |
|---|---|---|---|---|---|---|
| tt | 0xAF | tt:27:3.3 | 47.940 | -0.12 % | +0.00 % | `sim/recentre/corners/explore-20261011T035358Z-points/r070_20x10_pt_tt_27C_3.3V_0xAF.log` |
| tt | 0xAF | tt:-40:3 | 45.216 | -5.80 % | -5.68 % | `sim/recentre/corners/explore-20261011T035405Z-points/r070_20x10_pt_tt_m40C_3V_0xAF.log` |
| tt | 0xAF | tt:85:3.6 | 49.656 | +3.45 % | +3.58 % | `sim/recentre/corners/explore-20261011T033717Z-points/r070_20x10_pt_0xAF.log` |
| ff | 0x59 | ff:27:3.3 | 48.033 | +0.07 % | +0.00 % | `sim/recentre/corners/explore-20261011T035412Z-points/r070_20x10_pt_ff_27C_3.3V_0x59.log` |
| ff | 0x59 | ff:-40:3.6 | 46.319 | -3.50 % | -3.57 % | `sim/recentre/corners/explore-20261011T035422Z-points/r070_20x10_pt_ff_m40C_3.6V_0x59.log` |
| ff | 0x59 | ff:85:3 | 50.086 | +4.35 % | +4.28 % | `sim/recentre/corners/explore-20261011T033717Z-points/r070_20x10_pt_0x59.log` |
| ss | 0xE7 | ss:27:3.3 | 48.119 | +0.25 % | +0.00 % | `sim/recentre/corners/explore-20261011T035429Z-points/r070_20x10_pt_ss_27C_3.3V_0xE7.log` |
| ss | 0xE7 | ss:-40:3 | 44.671 | -6.94 % | -7.17 % | `sim/recentre/corners/explore-20261011T035436Z-points/r070_20x10_pt_ss_m40C_3V_0xE7.log` |
| ss | 0xE7 | ss:85:3.6 | 50.480 | +5.17 % | +4.91 % | `sim/recentre/corners/explore-20261011T033717Z-points/r070_20x10_pt_0xE7.log` |

## Binding corners of the 0xA3 27-point record, P3

The slowest corner of the record (ss/-40 C/3.0 V) must still reach 48 MHz at the top code; the fastest (ff/85 C/3.0 V) must still be at or below 48 MHz at the bottom code. Two single-corner probes per substrate model.

| substrate | point | trim code | f (MHz) | need | margin | log |
|---|---|---|---|---|---|---|
| as-extracted | ss:-40:3 | 0xFF | 57.705 | >= 48 | +20.2 % | `sim/recentre/corners/explore-20261011T034349Z-points/r070_20x10_pt_0xFF.log` |
| as-extracted | ff:85:3 | 0x00 | 39.990 | <= 48 | +20.0 % | `sim/recentre/corners/explore-20261011T034349Z-points/r070_20x10_pt_0x00.log` |
| hard-tied | ss:-40:3 | 0xFF | 50.418 | >= 48 | +5.0 % | `sim/recentre/corners/explore-20261011T034355Z-points/r070_20x10_pt_0xFF.log` |
| hard-tied | ff:85:3 | 0x00 | 38.537 | <= 48 | +24.6 % | `sim/recentre/corners/explore-20261011T034355Z-points/r070_20x10_pt_0x00.log` |

## Same T/V extreme probes for the alternatives (model A)

| candidate | process | code | point | f (MHz) | vs 48 MHz | log |
|---|---|---|---|---|---|---|
| `prop_r080_17x10` | tt | 0xAE | tt:27:3.3 | 47.895 | -0.22 % | `sim/recentre/corners/explore-20261011T035524Z-points/prop_r080_17x10_pt_tt_27C_3.3V_0xAE.log` |
| `prop_r080_17x10` | tt | 0xAE | tt:-40:3 | 46.157 | -3.84 % | `sim/recentre/corners/explore-20261011T035530Z-points/prop_r080_17x10_pt_tt_m40C_3V_0xAE.log` |
| `prop_r080_17x10` | tt | 0xAE | tt:85:3.6 | 49.144 | +2.38 % | `sim/recentre/corners/explore-20261011T032737Z-points/prop_r080_17x10_pt_0xAE.log` |
| `prop_r080_17x10` | ff | 0x5F | ff:27:3.3 | 48.007 | +0.01 % | `sim/recentre/corners/explore-20261011T035537Z-points/prop_r080_17x10_pt_ff_27C_3.3V_0x5F.log` |
| `prop_r080_17x10` | ff | 0x5F | ff:-40:3.6 | 43.744 | -8.87 % | `sim/recentre/corners/explore-20261011T035543Z-points/prop_r080_17x10_pt_ff_m40C_3.6V_0x5F.log` |
| `prop_r080_17x10` | ff | 0x5F | ff:85:3 | 51.699 | +7.71 % | `sim/recentre/corners/explore-20261011T032737Z-points/prop_r080_17x10_pt_0x5F.log` |
| `prop_r080_17x10` | ss | 0xDB | ss:27:3.3 | 48.042 | +0.09 % | `sim/recentre/corners/explore-20261011T035550Z-points/prop_r080_17x10_pt_ss_27C_3.3V_0xDB.log` |
| `prop_r080_17x10` | ss | 0xDB | ss:-40:3 | 46.331 | -3.48 % | `sim/recentre/corners/explore-20261011T035556Z-points/prop_r080_17x10_pt_ss_m40C_3V_0xDB.log` |
| `prop_r080_17x10` | ss | 0xDB | ss:85:3.6 | 49.322 | +2.75 % | `sim/recentre/corners/explore-20261011T032737Z-points/prop_r080_17x10_pt_0xDB.log` |
| `optB_r066_24x10` | tt | 0xAF | tt:27:3.3 | 47.886 | -0.24 % | `sim/recentre/corners/explore-20261011T035443Z-points/optB_r066_24x10_pt_tt_27C_3.3V_0xAF.log` |
| `optB_r066_24x10` | tt | 0xAF | tt:-40:3 | 46.219 | -3.71 % | `sim/recentre/corners/explore-20261011T035450Z-points/optB_r066_24x10_pt_tt_m40C_3V_0xAF.log` |
| `optB_r066_24x10` | tt | 0xAF | tt:85:3.6 | 49.089 | +2.27 % | `sim/recentre/corners/explore-20261011T033138Z-points/optB_r066_24x10_pt_0xAF.log` |
| `optB_r066_24x10` | ff | 0x65 | ff:27:3.3 | 47.993 | -0.02 % | `sim/recentre/corners/explore-20261011T035457Z-points/optB_r066_24x10_pt_ff_27C_3.3V_0x65.log` |
| `optB_r066_24x10` | ff | 0x65 | ff:-40:3.6 | 43.323 | -9.74 % | `sim/recentre/corners/explore-20261011T035503Z-points/optB_r066_24x10_pt_ff_m40C_3.6V_0x65.log` |
| `optB_r066_24x10` | ff | 0x65 | ff:85:3 | 51.827 | +7.97 % | `sim/recentre/corners/explore-20261011T033138Z-points/optB_r066_24x10_pt_0x65.log` |
| `optB_r066_24x10` | ss | 0xDB | ss:27:3.3 | 48.017 | +0.04 % | `sim/recentre/corners/explore-20261011T035510Z-points/optB_r066_24x10_pt_ss_27C_3.3V_0xDB.log` |
| `optB_r066_24x10` | ss | 0xDB | ss:-40:3 | 46.293 | -3.56 % | `sim/recentre/corners/explore-20261011T035517Z-points/optB_r066_24x10_pt_ss_m40C_3V_0xDB.log` |
| `optB_r066_24x10` | ss | 0xDB | ss:85:3.6 | 49.308 | +2.72 % | `sim/recentre/corners/explore-20261011T033138Z-points/optB_r066_24x10_pt_0xDB.log` |

## Sensitivity: vc net-to-substrate C scaled with MiM area (P1 only, tt, code 0xAE)

vc C unscaled 47.895 MHz; scaled x0.85 48.579 MHz (+1.43 %).
