2AMLogic/gf180-rcosc/sim/discipline/results/20261009T010000Z/trace_ss_ext_cold_start.csv

frame | bangbang_code | bangbang_err_pct | deadband_code | deadband_err_pct | avg32_code | avg32_err_pct | fracdither_code | fracdither_err_pct
0 | 128 | -46.8596 | 128 | -46.8596 | 128 | -46.8596 | 128 | -46.8596
1 | 129 | -46.6162 | 129 | -46.6162 | 128 | -46.8596 | 165 | -36.2342
2 | 130 | -46.3718 | 130 | -46.3718 | 128 | -46.8596 | 195 | -26.6060
3 | 131 | -46.1262 | 131 | -46.1262 | 128 | -46.8596 | 215 | -15.9269
4 | 132 | -45.8794 | 132 | -45.8794 | 128 | -46.8596 | 229 | -8.8081
5 | 133 | -45.6316 | 133 | -45.6316 | 128 | -46.8596 | 235 | -4.6918
6 | 134 | -45.3826 | 134 | -45.3826 | 128 | -46.8596 | 240 | -2.0947
7 | 135 | -45.1325 | 135 | -45.1325 | 128 | -46.8596 | 241 | -1.6531
8 | 136 | -44.8812 | 136 | -44.8812 | 128 | -46.8596 | 242 | -1.2096
9 | 137 | -44.6288 | 137 | -44.6288 | 128 | -46.8596 | 243 | -0.7640
10 | 138 | -44.3752 | 138 | -44.3752 | 128 | -46.8596 | 244 | -0.3165
11 | 139 | -44.1205 | 139 | -44.1205 | 128 | -46.8596 | 244 | -0.3165
12 | 140 | -43.8646 | 140 | -43.8646 | 128 | -46.8596 | 245 | 0.1331
13 | 141 | -43.6075 | 141 | -43.6075 | 128 | -46.8596 | 244 | -0.3165
14 | 142 | -43.3493 | 142 | -43.3493 | 128 | -46.8596 | 244 | -0.3165
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
