2AMLogic/gf180-rcosc/sim/discipline/results/20261009T010000Z/trim_math.csv

plant | T_c | V | best_code | best_err_pct | saturated | local_step_pct | target_crossings | f255_err_pct | f0_err_pct
tt/sch | -40.0 | 3.0 | 174 | 0.1511 | False | 0.5827 | 1 | 61.566 | -48.177
tt/sch | -40.0 | 3.3 | 172 | 0.2712 | False | 0.5827 | 1 | 63.650 | -47.508
tt/sch | -40.0 | 3.6 | 170 | 0.1345 | False | 0.5827 | 1 | 65.337 | -46.967
tt/sch | 27.0 | 3.0 | 165 | 0.1227 | False | 0.5827 | 1 | 70.191 | -45.410
tt/sch | 27.0 | 3.3 | 163 | -0.0378 | False | 0.5827 | 1 | 71.904 | -44.861
tt/sch | 27.0 | 3.6 | 161 | -0.2776 | False | 0.5827 | 1 | 73.496 | -44.350
tt/sch | 85.0 | 3.0 | 159 | 0.2705 | False | 0.5494 | 1 | 76.430 | -43.409
tt/sch | 85.0 | 3.3 | 157 | -0.0380 | False | 0.5494 | 1 | 77.825 | -42.962
tt/sch | 85.0 | 3.6 | 156 | 0.0747 | False | 0.5494 | 1 | 79.004 | -42.584
ff/sch | -40.0 | 3.0 | 104 | -0.0759 | False | 0.4304 | 1 | 112.528 | -30.692
ff/sch | -40.0 | 3.3 | 102 | 0.1012 | False | 0.4304 | 1 | 114.741 | -29.970
ff/sch | -40.0 | 3.6 | 100 | 0.1386 | False | 0.4304 | 1 | 116.674 | -29.340
ff/sch | 27.0 | 3.0 | 92 | -0.0524 | False | 0.4053 | 1 | 123.597 | -27.082
ff/sch | 27.0 | 3.3 | 90 | 0.0628 | False | 0.4053 | 1 | 125.673 | -26.405
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
