2AMLogic/gf180-rcosc/sim/discipline/results/20261010T120000Z/outage_results.csv

case | plant | policy | jitter_ns | outage_start_frame | lost_sofs | true_err_at_outage_start | true_err_at_holdover_end | true_drift_during_holdover | true_absmax_during_holdover | frozen_code | observed_during_outage | last_valid_count_err_before | first_valid_count_err_after | update_resume_frames_after_outage_end | max_excursion_pct | baseline_max_excursion_pct | rail_contact | baseline_rail_contact | final_code | final_err_pct | reachable_inst | reachable_avg16 | reacq_inst_frames | status_inst | baseline_reacq_inst_frames | baseline_status_inst | reacq_avg16_frames | status_avg16 | baseline_reacq_avg16_frames | baseline_status_avg16
constant_27C_3p3V | tt/sch | bangbang | 0.0000 | 8000 | 1 | 0.5447 | 0.5447 | 0.0000 | 0.5447 | 164 | none | -18 | 261 | 1 | 0.5447 | 0.5447 | False | False | 164 | 0.5447 | True | True | none | controller_not_recovered | none | controller_not_recovered | none | controller_not_recovered | none | controller_not_recovered
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
