2AMLogic/gf180-rcosc/sim/startup/results/20261008T235538Z/summary.md

# Startup-time sweep 20261008T235538Z (issue #78)

Generated by `sim/startup/startup_report.py` from `klt sim` reports of
`sim/startup/request_v*.json`. Append-only evidence. t = 0 is the start of a
1000 ns linear 0 -> VDD ramp; trim code 0xA3 held at every point.
Spec: startup time <= 10 us. Primary band 1.1% (strictest ratified figure, DR-0020).

**Run note: SINGLE-CORNER LOCAL PROBES ONLY (ss/-40C/3.0V and tt/27C/3.3V via klt sim --backend local); NOT the 63-point factorial, which could not run on the fleet: see batch-attempts/**

## Batch/sim job provenance

- `st-probe.json` (VDD 3 V): status `pass`, 1 corners, remote `None`
- `st-probe2.json` (VDD 3.3 V): status `pass`, 1 corners, remote `None`

## Verdict per band (points with settle time <= 10 us)

| band (of own settled period) | pass | worst settle time (us) |
|---|---|---|
| +/-1.1% | 2/2 | 1.174 |
| +/-2.9% | 2/2 | 1.174 |
| +/-10.8% | 2/2 | 1.067 |

## Per-corner startup time (us from ramp start; bands as columns)

| process | T (C) | VDD (V) | status | f settled (MHz) | first edge | settle +/-1.1% | settle +/-2.9% | settle +/-10.8% | verdict (primary) |
|---|---|---|---|---|---|---|---|---|---|
| `ss` | -40 | 3 | STARTED | 35.62 | 0.910 | 1.174 | 1.174 | 1.067 | pass |
| `tt` | 27 | 3.3 | STARTED | 48.14 | 0.596 | 0.891 | 0.870 | 0.793 | pass |
