2AMLogic/gf180-rcosc/sim/pvt/results/20260923T030125Z/summary.md

# PVT corner campaign 20260923T030125Z

Generated by `sim/pvt/pvt_sweep.py` (issue #12). Append-only evidence: this file, `results.csv`, `manifest.json` and every raw log under `sim/pvt/corners/20260923T030125Z/` belong to this run id and are never rewritten by a later run.

| | |
|---|---|
| git sha | `ed26786191202a85a71b6938563c45a1eaaa5582` |
| ngspice | ** ngspice-46 : Circuit level simulation program |
| PDK | gf180mcuC @ `/home/ubuntu/.volare` |
| netlist | `design/netlist/pvt_tb.spice` (from `design/pvt_tb.sch`) |
| measurement | `tran 200p 1200n`, f averaged over 20 whole periods (rising edges 5..25, startup skipped) |
| unique points simulated | 363 |
| recorded rows | 282 |
| failed points | 0 |
| wall clock | 403.6 s at 8 jobs |

## Sweep matrix

Full factorial, **every** combination simulated — no corner-by-corner spot check, no silently skipped point.

| Axis | Values | Count |
|---|---|---|
| process (fets / res / mimcap `.lib` sections) | `tt` (typical/res_typical/mimcap_typical), `ff` (ff/res_ff/mimcap_ff), `ss` (ss/res_ss/mimcap_ss), `fs` (fs/res_typical/mimcap_typical), `sf` (sf/res_typical/mimcap_typical), `rc_f` (typical/res_ff/mimcap_ff), `rc_s` (typical/res_ss/mimcap_ss) | 7 |
| temperature | -40 °C, 27 °C, 85 °C | 3 |
| supply | 3 V, 3.3 V, 3.6 V | 3 |
| **points per pass** | | **63** |

## Realized trim curve (tt, 27 °C, 3.3 V)

The sampled code set includes the block-boundary pairs (`0x0F`/`0x10` … `0xEF`/`)0xF0`) since issue #43; the *step* column is vs. the previous *sampled* code.  A negative step at a `0xkF` → `0x(k+1)0` pair is the characterized sub-LSB-margin local dip of the real shunt switches (measured magnitude, not absorbed): the frozen R map leaves ~1 LSB-R (~374 ohm) of ideal-switch monotonicity margin per boundary pair, below a realizable switch residual at slow corners.

| code | f (MHz) | Δ vs. code 0x00 | step vs. previous sampled code |
|---|---|---|---|
| `0x00` | 26.3375 | +0.00% | — |
| `0x0F` | 27.5208 | +4.49% | +4.49% |
| `0x10` | 27.6523 | +4.99% | +0.48% |
| `0x1F` | 28.9561 | +9.94% | +4.71% |
| `0x20` | 29.1709 | +10.76% | +0.74% |
| `0x30` | 30.8223 | +17.03% | +5.66% |
| `0x3F` | 32.4717 | +23.29% | +5.35% |
| `0x40` | 32.5988 | +23.77% | +0.39% |
| `0x50` | 34.6372 | +31.51% | +6.25% |
| `0x60` | 37.0175 | +40.55% | +6.87% |
| `0x70` | 39.7237 | +50.83% | +7.31% |
| `0x7F` | 42.5463 | +61.54% | +7.11% |
| `0x80` | 39.9484 | +51.68% | **-6.11%** (local dip) |
| `0x90` | 43.2357 | +64.16% | +8.23% |
| `0xA0` | 47.2459 | +79.39% | +9.28% |
| `0xB0` | 51.9060 | +97.08% | +9.86% |
| `0xBF` | 57.1384 | +116.95% | +10.08% |
| `0xC0` | 55.4540 | +110.55% | **-2.95%** (local dip) |
| `0xD0` | 62.1335 | +135.91% | +12.05% |
| `0xDF` | 69.8362 | +165.16% | +12.40% |
| `0xE0` | 68.8511 | +161.42% | **-1.41%** (local dip) |
| `0xEF` | 77.5824 | +194.57% | +12.68% |
| `0xF0` | 77.3688 | +193.76% | **-0.28%** (local dip) |
| `0xFF` | 83.2292 | +216.01% | +7.57% |

Realized trim range: **26.3375 … 83.2292 MHz** (ratio 3.1601, ±51.92% about the midpoint), average step **0.8471 %/code**.

| Spec row | Ratified | Simulated | Verdict |
|---|---|---|---|
| Output frequency | 48.000 MHz | max reachable 83.2292 MHz at code `0xFF` | met |
| Trim range | ±40% (28.8–67.2 MHz) | ±51.92% (26.3375–83.2292 MHz) | met |
| Trim step | 0.314 %/code | 0.8471 %/code | met |

## Single-point trim calibration

Binary search over the 8-bit code at each process corner's own 27 °C / 3.3 V point. `f(code)` is monotonically non-decreasing in the ideal-switch model of the trim bank; with the real shunt switches of issue #43 the block staircase stays monotone at every sampled code, while a block-boundary pair can carry a small characterized local dip (see the trim-curve table above) — a dip can make a search pick locally suboptimal by at most the dip magnitude, never unmeasured: the picked code's own f is re-simulated and printed here.

- **Ratified target**: 48.000 MHz (repo README target-spec table).
- **Surrogate target**: 39.9484 MHz — the design's own realized frequency at `tt / 27 °C / 3.3 V / code 0x80`. The ratified target is now reached inner-range at every corner (none saturated, below), so this row is no longer the only way to get a meaningful post-trim residual; it is reported unchanged anyway for continuity with every prior campaign — the trim-every-die residual is banded by which target the die is trimmed against, and this is the `f(0x80)` anchor of the pre-#43 pass.

| process | code @ 48.000 MHz target | f (MHz) | saturated? | code @ surrogate | f (MHz) | saturated? |
|---|---|---|---|---|---|---|
| `tt` | `0xA3` | 47.9819 | no | `0x71` | 39.9154 | no |
| `ff` | `0x59` | 48.0463 | no | `0x26` | 39.9252 | no |
| `ss` | `0xCD` | 47.8777 | no | `0xAD` | 39.9597 | no |
| `fs` | `0xA0` | 48.0683 | no | `0x6F` | 39.8462 | no |
| `sf` | `0xA6` | 47.8865 | no | `0x75` | 40.0291 | no |
| `rc_f` | `0x5E` | 47.9095 | no | `0x2B` | 39.9341 | no |
| `rc_s` | `0xC9` | 48.0203 | no | `0xA8` | 39.8966 | no |

## Untrimmed / free-running spread

Fixed mid-scale code `0x80` across the whole factorial. Percentages are referenced to the nominal point `tt / 27 °C / 3.3 V` = 39.9484 MHz.

| process | T (°C) | 3 V | 3.3 V | 3.6 V |
|---|---|---|---|---|
| `tt` | -40 | 37.3879 (-6.41%) | 37.6416 (-5.77%) | 37.9709 (-4.95%) |
| `tt` | 27 | 39.6534 (-0.74%) | 39.9484 (+0.00%) | 40.1477 (+0.50%) |
| `tt` | 85 | 41.3340 (+3.47%) | 41.4946 (+3.87%) | 41.6896 (+4.36%) |
| `ff` | -40 | 49.5599 (+24.06%) | 50.0522 (+25.29%) | 50.3105 (+25.94%) |
| `ff` | 27 | 52.7509 (+32.05%) | 53.0007 (+32.67%) | 53.1984 (+33.17%) |
| `ff` | 85 | 55.9493 (+40.05%) | 55.4587 (+38.83%) | 55.3154 (+38.47%) |
| `ss` | -40 | 29.2133 (-26.87%) | 29.5024 (-26.15%) | 29.7078 (-25.63%) |
| `ss` | 27 | 31.0281 (-22.33%) | 31.2926 (-21.67%) | 31.4992 (-21.15%) |
| `ss` | 85 | 32.2383 (-19.30%) | 32.4783 (-18.70%) | 32.6626 (-18.24%) |
| `fs` | -40 | 38.1479 (-4.51%) | 38.4998 (-3.63%) | 38.7437 (-3.02%) |
| `fs` | 27 | 40.3116 (+0.91%) | 40.5475 (+1.50%) | 40.7220 (+1.94%) |
| `fs` | 85 | 42.9180 (+7.43%) | 42.3309 (+5.96%) | 42.1844 (+5.60%) |
| `sf` | -40 | 36.5120 (-8.60%) | 36.7652 (-7.97%) | 37.0060 (-7.37%) |
| `sf` | 27 | 39.0072 (-2.36%) | 39.2325 (-1.79%) | 39.4105 (-1.35%) |
| `sf` | 85 | 40.6521 (+1.76%) | 40.8214 (+2.19%) | 40.9732 (+2.57%) |
| `rc_f` | -40 | 48.5996 (+21.66%) | 48.9292 (+22.48%) | 49.3751 (+23.60%) |
| `rc_f` | 27 | 51.6843 (+29.38%) | 52.0153 (+30.21%) | 52.2418 (+30.77%) |
| `rc_f` | 85 | 55.8237 (+39.74%) | 54.9017 (+37.43%) | 54.6673 (+36.84%) |
| `rc_s` | -40 | 29.8910 (-25.18%) | 30.1342 (-24.57%) | 30.3631 (-23.99%) |
| `rc_s` | 27 | 31.6789 (-20.70%) | 31.8889 (-20.17%) | 32.0784 (-19.70%) |
| `rc_s` | 85 | 32.9007 (-17.64%) | 33.0660 (-17.23%) | 33.2062 (-16.88%) |

Cells are MHz (Δ vs. nominal).

| Condition | n | min (MHz) | max (MHz) | vs. nominal |
|---|---|---|---|---|
| process only (27 °C, 3.3 V) | 7 | 31.2926 | 53.0007 | -21.67% / +32.67% |
| full P×T×V factorial | 63 | 29.2133 | 55.9493 | -26.87% / +40.05% |

| Spec row | Ratified | Simulated (process only, fixed T/V) | Verdict |
|---|---|---|---|
| Free-running untrimmed process spread | ±35% (-27.7% / +47.6% exact) | -21.67% / +32.67% | within the ratified bound |

## Post-trim — single code `0xA3` from the ratified-target calibration

Calibration target: 48.000 MHz (ratified).

| process | code | T (°C) | 3 V | 3.3 V | 3.6 V |
|---|---|---|---|---|---|
| `tt` | `0xA3` | -40 | 45.0962 (-6.01%) | 45.6780 (-4.80%) | 46.1489 (-3.82%) |
| `tt` | `0xA3` | 27 | 47.5037 (-1.00%) | 47.9819 (+0.00%) | 48.4263 (+0.93%) |
| `tt` | `0xA3` | 85 | 49.2452 (+2.63%) | 49.6345 (+3.44%) | 49.9635 (+4.13%) |
| `ff` | `0xA3` | -40 | 59.7911 (+24.61%) | 60.4137 (+25.91%) | 60.9576 (+27.04%) |
| `ff` | `0xA3` | 27 | 62.9051 (+31.10%) | 63.4892 (+32.32%) | 63.7795 (+32.92%) |
| `ff` | `0xA3` | 85 | 66.4868 (+38.57%) | 65.9634 (+37.48%) | 65.9624 (+37.47%) |
| `ss` | `0xA3` | -40 | 35.2895 (-26.45%) | 35.7749 (-25.44%) | 36.1695 (-24.62%) |
| `ss` | `0xA3` | 27 | 37.1302 (-22.62%) | 37.6537 (-21.53%) | 38.0329 (-20.73%) |
| `ss` | `0xA3` | 85 | 38.3927 (-19.99%) | 38.8682 (-18.99%) | 39.2416 (-18.22%) |
| `fs` | `0xA3` | -40 | 46.1666 (-3.78%) | 46.7922 (-2.48%) | 47.2238 (-1.58%) |
| `fs` | `0xA3` | 27 | 48.3260 (+0.72%) | 48.8174 (+1.74%) | 49.2404 (+2.62%) |
| `fs` | `0xA3` | 85 | 51.1248 (+6.55%) | 50.6302 (+5.52%) | 50.6005 (+5.46%) |
| `sf` | `0xA3` | -40 | 44.0054 (-8.29%) | 44.3742 (-7.52%) | 44.8250 (-6.58%) |
| `sf` | `0xA3` | 27 | 46.6454 (-2.79%) | 47.0102 (-2.03%) | 47.3387 (-1.34%) |
| `sf` | `0xA3` | 85 | 48.3728 (+0.81%) | 48.7579 (+1.62%) | 48.9976 (+2.12%) |
| `rc_f` | `0xA3` | -40 | 58.1038 (+21.10%) | 58.7684 (+22.48%) | 59.3979 (+23.79%) |
| `rc_f` | `0xA3` | 27 | 61.2895 (+27.73%) | 61.9218 (+29.05%) | 62.3974 (+30.04%) |
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

> Both figures above are stated together, never one without the other: the calibration-point number alone is not the accuracy of this block.

## Post-trim — per-corner code from the ratified-target calibration (issue #43)

Calibration target: 48.000 MHz (ratified).

| process | code | T (°C) | 3 V | 3.3 V | 3.6 V |
|---|---|---|---|---|---|
| `tt` | `0xA3` | -40 | 45.0962 (-6.01%) | 45.6780 (-4.80%) | 46.1489 (-3.82%) |
| `tt` | `0xA3` | 27 | 47.5037 (-1.00%) | 47.9819 (+0.00%) | 48.4263 (+0.93%) |
| `tt` | `0xA3` | 85 | 49.2452 (+2.63%) | 49.6345 (+3.44%) | 49.9635 (+4.13%) |
| `ff` | `0x59` | -40 | 45.2419 (-5.71%) | 45.6260 (-4.91%) | 45.9090 (-4.32%) |
| `ff` | `0x59` | 27 | 47.7539 (-0.48%) | 48.0463 (+0.13%) | 48.2733 (+0.61%) |
| `ff` | `0x59` | 85 | 50.5422 (+5.34%) | 50.1348 (+4.49%) | 50.0066 (+4.22%) |
| `ss` | `0xCD` | -40 | 44.9385 (-6.34%) | 45.7829 (-4.58%) | 46.4613 (-3.17%) |
| `ss` | `0xCD` | 27 | 46.9895 (-2.07%) | 47.8777 (-0.22%) | 48.5338 (+1.15%) |
| `ss` | `0xCD` | 85 | 48.2886 (+0.64%) | 49.1482 (+2.43%) | 49.8232 (+3.84%) |
| `fs` | `0xA0` | -40 | 45.2897 (-5.61%) | 45.9372 (-4.26%) | 46.3657 (-3.37%) |
| `fs` | `0xA0` | 27 | 47.6135 (-0.77%) | 48.0683 (+0.18%) | 48.3883 (+0.85%) |
| `fs` | `0xA0` | 85 | 50.4389 (+5.12%) | 49.9275 (+4.05%) | 49.9089 (+4.02%) |
| `sf` | `0xA6` | -40 | 44.6990 (-6.84%) | 45.2122 (-5.77%) | 45.6659 (-4.83%) |
| `sf` | `0xA6` | 27 | 47.4656 (-1.08%) | 47.8865 (-0.20%) | 48.1803 (+0.41%) |
| `sf` | `0xA6` | 85 | 49.1861 (+2.51%) | 49.5855 (+3.34%) | 49.8591 (+3.91%) |
| `rc_f` | `0x5E` | -40 | 45.2200 (-5.76%) | 45.5350 (-5.10%) | 45.9610 (-4.21%) |
| `rc_f` | `0x5E` | 27 | 47.6395 (-0.71%) | 47.9095 (-0.15%) | 48.3242 (+0.71%) |
| `rc_f` | `0x5E` | 85 | 51.2137 (+6.74%) | 50.4070 (+5.05%) | 50.2472 (+4.72%) |
| `rc_s` | `0xC9` | -40 | 45.2253 (-5.75%) | 45.8969 (-4.35%) | 46.5315 (-3.02%) |
| `rc_s` | `0xC9` | 27 | 47.4343 (-1.14%) | 48.0203 (+0.08%) | 48.5437 (+1.17%) |
| `rc_s` | `0xC9` | 85 | 48.8247 (+1.76%) | 49.4310 (+3.02%) | 49.8448 (+3.88%) |

Cells are MHz (Δ vs. the calibrated nominal point).

| Condition | n | min (MHz) | max (MHz) | vs. calibrated nominal |
|---|---|---|---|---|
| calibration point (27 °C, VDD ±10%) | 21 | 46.9895 | 48.5437 | -2.07% / +1.17% |
| full temperature range (−40…+85 °C, VDD ±10%) | 63 | 44.6990 | 51.2137 | -6.84% / +6.74% |

| Spec row | Ratified | Simulated | Verdict |
|---|---|---|---|
| Post-trim, at calibration point | ±1.1% | -2.07% / +1.17% | **exceeds** |
| Post-trim, full temperature range | -9% / +8% | -6.84% / +6.74% | within |

> Both figures above are stated together, never one without the other: the calibration-point number alone is not the accuracy of this block.

## Isolated sensitivities (post-trim, per-corner surrogate calibration)

| process | code | f(−40 °C) | f(27 °C) | f(85 °C) | ΔT coefficient |
|---|---|---|---|---|---|
| `tt` | `0x71` | 37.9312 | 39.9154 | 41.2147 | +658 ppm/K |
| `ff` | `0x26` | 37.7115 | 39.9252 | 41.8150 | +822 ppm/K |
| `ss` | `0xAD` | 38.0786 | 39.9597 | 41.1507 | +615 ppm/K |
| `fs` | `0x6F` | 38.2901 | 39.8462 | 41.3088 | +606 ppm/K |
| `sf` | `0x75` | 37.8864 | 40.0291 | 41.5058 | +723 ppm/K |
| `rc_f` | `0x2B` | 37.6902 | 39.9341 | 42.1774 | +899 ppm/K |
| `rc_s` | `0xA8` | 37.9534 | 39.8966 | 41.1187 | +635 ppm/K |

| process | code | f(3.0 V) | f(3.3 V) | f(3.6 V) | supply sensitivity |
|---|---|---|---|---|---|
| `tt` | `0x71` | 39.6002 | 39.9154 | 40.1258 | +1.32% over 3.0→3.6 V |
| `ff` | `0x26` | 39.7931 | 39.9252 | 40.0444 | +0.63% over 3.0→3.6 V |
| `ss` | `0xAD` | 39.3911 | 39.9597 | 40.4190 | +2.57% over 3.0→3.6 V |
| `fs` | `0x6F` | 39.5468 | 39.8462 | 40.0802 | +1.34% over 3.0→3.6 V |
| `sf` | `0x75` | 39.8023 | 40.0291 | 40.2963 | +1.23% over 3.0→3.6 V |
| `rc_f` | `0x2B` | 39.7585 | 39.9341 | 40.1244 | +0.92% over 3.0→3.6 V |
| `rc_s` | `0xA8` | 39.4804 | 39.8966 | 40.2194 | +1.85% over 3.0→3.6 V |

## Isolated sensitivities (post-trim, per-corner ratified-target calibration (issue #43))

| process | code | f(−40 °C) | f(27 °C) | f(85 °C) | ΔT coefficient |
|---|---|---|---|---|---|
| `tt` | `0xA3` | 45.6780 | 47.9819 | 49.6345 | +660 ppm/K |
| `ff` | `0x59` | 45.6260 | 48.0463 | 50.1348 | +751 ppm/K |
| `ss` | `0xCD` | 45.7829 | 47.8777 | 49.1482 | +562 ppm/K |
| `fs` | `0xA0` | 45.9372 | 48.0683 | 49.9275 | +664 ppm/K |
| `sf` | `0xA6` | 45.2122 | 47.8865 | 49.5855 | +731 ppm/K |
| `rc_f` | `0x5E` | 45.5350 | 47.9095 | 50.4070 | +814 ppm/K |
| `rc_s` | `0xC9` | 45.8969 | 48.0203 | 49.4310 | +589 ppm/K |

| process | code | f(3.0 V) | f(3.3 V) | f(3.6 V) | supply sensitivity |
|---|---|---|---|---|---|
| `tt` | `0xA3` | 47.5037 | 47.9819 | 48.4263 | +1.92% over 3.0→3.6 V |
| `ff` | `0x59` | 47.7539 | 48.0463 | 48.2733 | +1.08% over 3.0→3.6 V |
| `ss` | `0xCD` | 46.9895 | 47.8777 | 48.5338 | +3.23% over 3.0→3.6 V |
| `fs` | `0xA0` | 47.6135 | 48.0683 | 48.3883 | +1.61% over 3.0→3.6 V |
| `sf` | `0xA6` | 47.4656 | 47.8865 | 48.1803 | +1.49% over 3.0→3.6 V |
| `rc_f` | `0x5E` | 47.6395 | 47.9095 | 48.3242 | +1.43% over 3.0→3.6 V |
| `rc_s` | `0xC9` | 47.4343 | 48.0203 | 48.5437 | +2.31% over 3.0→3.6 V |

## Issue #43 switch acceptance — per-code supply sensitivity at the `ss` corner (27 °C)

The pre-#43 instrumentation measured ~+11.0–11.3% (3.0→3.6 V) at `ss`/code `0x80` but ~+20.0–20.8% at `ss`/code `0xEF` — the un-switched trailing segments' phantom series resistance, whose magnitude grows as the switch drive thins. This pass re-measures exactly that pairing against the restructured trim tree: the two rows should now be of the same order, the high-code row no longer materially worse.

| code | f(3.0 V) | f(3.3 V) | f(3.6 V) | supply sensitivity |
|---|---|---|---|---|
| `0x80` | 31.0281 | 31.2926 | 31.4992 | +1.51% over 3.0→3.6 V |
| `0xEF` | 59.6177 | 61.3376 | 62.7294 | +5.07% over 3.0→3.6 V |
