2AMLogic/gf180-rcosc/sim/pvt/results/20260923T030905Z/summary.md

# Delay-probe instrumentation 20260923T030905Z

Driver: `sim/pvt/delay_probe.py` against `/home/ubuntu/GitHub/gf180-rcosc/.loom/worktrees/issue-57/design/netlist/pvt_tb.spice` (schematic-unchanged
reproduction basis; calibrated codes read from `sim/pvt/results/20260923T030125Z`).
138 ok / 0 failed points, 140.7s wall clock at 8 jobs.

Stage-delay decomposition of steady-state cycles (median of the
decomposed candidates, edges 10..12): all
cells ns; `dsum` = t_cmp_h + t_lat_h + t_cmp_l + t_lat_l is the
comparator/latch delay paid into the period per cycle.

## Calibrated-code set: ratified target

### Per-stage delays and dsum (27 C)

| proc | code | VDD | period | t_cmp_h | t_lat_h | t_cmp_l | t_lat_l | dsum | charge | overshoot (mV) |
|---|---|---|---|---|---|---|---|---|---|---|
| tt | 0xA3 | 3 | 21.0124 | 2.1046 | 0.5569 | 1.5917 | 0.2614 | 4.5130 | 16.3791 | 149.1 |
| tt | 0xA3 | 3.3 | 20.8025 | 2.0744 | 0.5151 | 1.6325 | 0.2418 | 4.4631 | 16.2425 | 162.0 |
| tt | 0xA3 | 3.6 | 20.6276 | 2.0392 | 0.4779 | 1.6655 | 0.2306 | 4.4132 | 16.1348 | 172.9 |
| ff | 0x59 | 3 | 20.9074 | 1.7472 | 0.4796 | 1.2916 | 0.2200 | 3.7381 | 17.1070 | 119.7 |
| ff | 0x59 | 3.3 | 20.8007 | 1.7497 | 0.4489 | 1.3260 | 0.2108 | 3.7344 | 17.0168 | 132.9 |
| ff | 0x59 | 3.6 | 20.6870 | 1.7433 | 0.4153 | 1.3629 | 0.1986 | 3.7214 | 16.9230 | 145.5 |
| ss | 0xCD | 3 | 21.2440 | 2.4464 | 0.6691 | 1.9207 | 0.3128 | 5.3494 | 15.7051 | 176.9 |
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
| 0xCF | 3.3 | 20.5565 | 5.2442 | 15.1574 | 25.5% |
| 0xCF | 3.6 | 20.2599 | 5.1635 | 14.9674 | 25.5% |
| 0xEF | 3 | 16.7333 | 5.1274 | 11.4112 | 30.6% |
| 0xEF | 3.3 | 16.2650 | 5.0455 | 11.0563 | 31.0% |
| 0xEF | 3.6 | 15.9147 | 4.9776 | 10.7989 | 31.3% |
