2AMLogic/gf180-rcosc/sim/pvt/results/20260922T004823Z/summary.md

# Delay-probe instrumentation 20260922T004823Z

Driver: `sim/pvt/delay_probe.py` against `/Users/rwalters/GitHub/gf180-rcosc/.loom/worktrees/issue-51/design/netlist/pvt_tb.spice` (schematic-unchanged
reproduction basis; calibrated codes read from `/Users/rwalters/GitHub/gf180-rcosc/.loom/worktrees/issue-51/sim/pvt/results/20260921T173529Z`).
138 ok / 0 failed points, 538.7s wall clock at 12 jobs.

Stage-delay decomposition of steady-state cycles (median of the
decomposed candidates, edges 10..12): all
cells ns; `dsum` = t_cmp_h + t_lat_h + t_cmp_l + t_lat_l is the
comparator/latch delay paid into the period per cycle.

## Calibrated-code set: ratified target

### Per-stage delays and dsum (27 C)

| proc | code | VDD | period | t_cmp_h | t_lat_h | t_cmp_l | t_lat_l | dsum | charge | overshoot (mV) |
|---|---|---|---|---|---|---|---|---|---|---|
| tt | 0x9D | 3 | 21.7065 | 2.1162 | 0.5622 | 2.0707 | 0.2858 | 5.0374 | 16.5603 | 144.7 |
| tt | 0x9D | 3.3 | 20.8699 | 2.0868 | 0.5123 | 1.5586 | 0.2610 | 4.4185 | 16.3555 | 154.0 |
| tt | 0x9D | 3.6 | 20.3338 | 2.0502 | 0.4782 | 1.2659 | 0.2401 | 4.0335 | 16.2164 | 167.2 |
| ff | 0x4C | 3 | 21.2739 | 1.7746 | 0.4794 | 1.3082 | 0.2319 | 3.7946 | 17.4258 | 119.0 |
| ff | 0x4C | 3.3 | 20.8296 | 1.7840 | 0.4457 | 1.0618 | 0.2110 | 3.5020 | 17.2864 | 131.7 |
| ff | 0x4C | 3.6 | 20.5022 | 1.7806 | 0.4192 | 0.9023 | 0.1994 | 3.3001 | 17.1678 | 142.2 |
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
| 0xCF | 3.3 | 20.8166 | 5.8096 | 14.8574 | 27.9% |
| 0xCF | 3.6 | 19.7294 | 5.0517 | 14.5431 | 25.6% |
| 0xEF | 3 | 18.8075 | 7.0297 | 11.5858 | 37.4% |
| 0xEF | 3.3 | 16.7442 | 5.6035 | 10.9848 | 33.5% |
| 0xEF | 3.6 | 15.5229 | 4.8578 | 10.5275 | 31.3% |
