2AMLogic/gf180-rcosc/sim/pvt/results/20260922T010039Z/summary.md

# PVT corner campaign 20260922T010039Z

Generated by `sim/pvt/pvt_sweep.py` (issue #12). Append-only evidence: this file, `results.csv`, `manifest.json` and every raw log under `sim/pvt/corners/20260922T010039Z/` belong to this run id and are never rewritten by a later run.

| | |
|---|---|
| git sha | `bd5783061f40335628c6489f7c9c05b1f4fb9dfb` (dirty tree) |
| ngspice | ** ngspice-46 : Circuit level simulation program |
| PDK | gf180mcuC @ `/Users/rwalters/.ciel` |
| netlist | `design/netlist/pvt_tb.spice` (from `design/pvt_tb.sch`) |
| measurement | `tran 200p 1200n`, f averaged over 20 whole periods (rising edges 5..25, startup skipped) |
| unique points simulated | 361 |
| recorded rows | 282 |
| failed points | 0 |
| wall clock | 3547.6 s at 12 jobs |

## Sweep matrix

Full factorial, **every** combination simulated — no corner-by-corner spot check, no silently skipped point.

| Axis | Values | Count |
|---|---|---|
| process (fets / res / mimcap `.lib` sections) | `tt` (typical/res_typical/mimcap_typical), `ff` (ff/res_ff/mimcap_ff), `ss` (ss/res_ss/mimcap_ss), `fs` (fs/res_typical/mimcap_typical), `sf` (sf/res_typical/mimcap_typical), `rc_f` (typical/res_ff/mimcap_ff), `rc_s` (typical/res_ss/mimcap_ss) | 7 |
| temperature | -40 °C, 27 °C, 85 °C | 3 |
| supply | 3 V, 3.3 V, 3.6 V | 3 |
| **points per pass** | | **63** |

## Realized trim curve (tt, 27 °C, 3.3 V)

The sampled code set includes the block-boundary pairs (`0x0F`/`0x10` … `0xEF`/`)0xF0`) since issue #43; the *step* column is vs. the previous *sampled* code.  A negative step at a `0xkF` → `0x(k+1)0` pair is the characterized sub-LSB-margin local dip of the real shunt switches (measured magnitude, not absorbed): the frozen R map leaves ~1 LSB-R (~374 ohm) of ideal-switch monotonicity margin per boundary pair, below a realizable switch residual at slow corners.

| code | f (MHz) | Δ vs. code 0x00 | step vs. previous sampled code |
|---|---|---|---|
| `0x00` | 27.2955 | +0.00% | — |
| `0x0F` | 28.5456 | +4.58% | +4.58% |
| `0x10` | 28.6676 | +5.03% | +0.43% |
| `0x1F` | 30.0393 | +10.05% | +4.79% |
| `0x20` | 30.2251 | +10.73% | +0.62% |
| `0x30` | 31.9396 | +17.01% | +5.67% |
| `0x3F` | 33.6431 | +23.26% | +5.33% |
| `0x40` | 33.7767 | +23.74% | +0.40% |
| `0x50` | 35.8838 | +31.46% | +6.24% |
| `0x60` | 38.3636 | +40.55% | +6.91% |
| `0x70` | 41.1289 | +50.68% | +7.21% |
| `0x7F` | 44.0411 | +61.35% | +7.08% |
| `0x80` | 41.2235 | +51.03% | **-6.40%** (local dip) |
| `0x90` | 44.6728 | +63.66% | +8.37% |
| `0xA0` | 48.6851 | +78.36% | +8.98% |
| `0xB0` | 53.5431 | +96.16% | +9.98% |
| `0xBF` | 58.9325 | +115.91% | +10.07% |
| `0xC0` | 57.0398 | +108.97% | **-3.21%** (local dip) |
| `0xD0` | 63.8897 | +134.07% | +12.01% |
| `0xDF` | 71.7298 | +162.79% | +12.27% |
| `0xE0` | 70.4944 | +158.26% | **-1.72%** (local dip) |
| `0xEF` | 79.4779 | +191.18% | +12.74% |
| `0xF0` | 79.1420 | +189.95% | **-0.42%** (local dip) |
| `0xFF` | 84.9384 | +211.18% | +7.32% |

Realized trim range: **27.2955 … 84.9384 MHz** (ratio 3.1118, ±51.36% about the midpoint), average step **0.8282 %/code**.

| Spec row | Ratified | Simulated | Verdict |
|---|---|---|---|
| Output frequency | 48.000 MHz | max reachable 84.9384 MHz at code `0xFF` | met |
| Trim range | ±40% (28.8–67.2 MHz) | ±51.36% (27.2955–84.9384 MHz) | met |
| Trim step | 0.314 %/code | 0.8282 %/code | met |

## Single-point trim calibration

Binary search over the 8-bit code at each process corner's own 27 °C / 3.3 V point. `f(code)` is monotonically non-decreasing in the ideal-switch model of the trim bank; with the real shunt switches of issue #43 the block staircase stays monotone at every sampled code, while a block-boundary pair can carry a small characterized local dip (see the trim-curve table above) — a dip can make a search pick locally suboptimal by at most the dip magnitude, never unmeasured: the picked code's own f is re-simulated and printed here.

- **Ratified target**: 48.000 MHz (repo README target-spec table).
- **Surrogate target**: 41.2235 MHz — the design's own realized frequency at `tt / 27 °C / 3.3 V / code 0x80`. The ratified target is now reached inner-range at every corner (none saturated, below), so this row is no longer the only way to get a meaningful post-trim residual; it is reported unchanged anyway for continuity with every prior campaign — the trim-every-die residual is banded by which target the die is trimmed against, and this is the `f(0x80)` anchor of the pre-#43 pass.

| process | code @ 48.000 MHz target | f (MHz) | saturated? | code @ surrogate | f (MHz) | saturated? |
|---|---|---|---|---|---|---|
| `tt` | `0x9D` | 47.8622 | no | `0x71` | 41.3154 | no |
| `ff` | `0x4C` | 47.9568 | no | `0x21` | 41.2258 | no |
| `ss` | `0xCF` | 48.0051 | no | `0xB3` | 41.2977 | no |
| `fs` | `0x9B` | 47.9806 | no | `0x6F` | 41.2180 | no |
| `sf` | `0xA3` | 48.0625 | no | `0x75` | 41.2182 | no |
| `rc_f` | `0x58` | 48.0222 | no | `0x2D` | 41.3089 | no |
| `rc_s` | `0xBE` | 48.0603 | no | `0xA7` | 41.1309 | no |

## Untrimmed / free-running spread

Fixed mid-scale code `0x80` across the whole factorial. Percentages are referenced to the nominal point `tt / 27 °C / 3.3 V` = 41.2235 MHz.

| process | T (°C) | 3 V | 3.3 V | 3.6 V |
|---|---|---|---|---|
| `tt` | -40 | 37.5550 (-8.90%) | 39.0521 (-5.27%) | 39.8785 (-3.26%) |
| `tt` | 27 | 39.9080 (-3.19%) | 41.2235 (+0.00%) | 42.0919 (+2.11%) |
| `tt` | 85 | 41.3989 (+0.43%) | 42.5103 (+3.12%) | 43.3521 (+5.16%) |
| `ff` | -40 | 51.6098 (+25.20%) | 52.8964 (+28.32%) | 53.6645 (+30.18%) |
| `ff` | 27 | 54.2358 (+31.57%) | 55.4710 (+34.56%) | 56.4271 (+36.88%) |
| `ff` | 85 | 57.3398 (+39.10%) | 57.5566 (+39.62%) | 58.1310 (+41.01%) |
| `ss` | -40 | 27.3548 (-33.64%) | 29.4931 (-28.46%) | 30.6092 (-25.75%) |
| `ss` | 27 | 29.8321 (-27.63%) | 31.4461 (-23.72%) | 32.4542 (-21.27%) |
| `ss` | 85 | 31.2402 (-24.22%) | 32.6133 (-20.89%) | 33.5241 (-18.68%) |
| `fs` | -40 | 38.8305 (-5.80%) | 39.7925 (-3.47%) | 40.4947 (-1.77%) |
| `fs` | 27 | 40.8891 (-0.81%) | 41.8038 (+1.41%) | 42.4876 (+3.07%) |
| `fs` | 85 | 43.5192 (+5.57%) | 43.4702 (+5.45%) | 43.7856 (+6.22%) |
| `sf` | -40 | 35.4628 (-13.97%) | 37.8518 (-8.18%) | 39.1397 (-5.05%) |
| `sf` | 27 | 38.2973 (-7.10%) | 40.1407 (-2.63%) | 41.2990 (+0.18%) |
| `sf` | 85 | 40.0383 (-2.88%) | 41.6244 (+0.97%) | 42.6867 (+3.55%) |
| `rc_f` | -40 | 48.1400 (+16.78%) | 50.3799 (+22.21%) | 51.7465 (+25.53%) |
| `rc_f` | 27 | 50.9713 (+23.65%) | 52.9457 (+28.44%) | 54.3293 (+31.79%) |
| `rc_f` | 85 | 55.2877 (+34.12%) | 55.5419 (+34.73%) | 56.1599 (+36.23%) |
| `rc_s` | -40 | 30.2494 (-26.62%) | 31.2693 (-24.15%) | 31.8881 (-22.65%) |
| `rc_s` | 27 | 32.2015 (-21.89%) | 33.0942 (-19.72%) | 33.6881 (-18.28%) |
| `rc_s` | 85 | 33.3819 (-19.02%) | 34.2017 (-17.03%) | 34.7812 (-15.63%) |

Cells are MHz (Δ vs. nominal).

| Condition | n | min (MHz) | max (MHz) | vs. nominal |
|---|---|---|---|---|
| process only (27 °C, 3.3 V) | 7 | 31.4461 | 55.4710 | -23.72% / +34.56% |
| full P×T×V factorial | 63 | 27.3548 | 58.1310 | -33.64% / +41.01% |

| Spec row | Ratified | Simulated (process only, fixed T/V) | Verdict |
|---|---|---|---|
| Free-running untrimmed process spread | ±35% (-27.7% / +47.6% exact) | -23.72% / +34.56% | within the ratified bound |

## Post-trim — single code `0x9D` from the ratified-target calibration

Calibration target: 48.000 MHz (ratified).

| process | code | T (°C) | 3 V | 3.3 V | 3.6 V |
|---|---|---|---|---|---|
| `tt` | `0x9D` | -40 | 43.7304 (-8.63%) | 45.8364 (-4.23%) | 47.0720 (-1.65%) |
| `tt` | `0x9D` | 27 | 46.0241 (-3.84%) | 47.8622 (+0.00%) | 49.1299 (+2.65%) |
| `tt` | `0x9D` | 85 | 47.4181 (-0.93%) | 48.9720 (+2.32%) | 50.1817 (+4.85%) |
| `ff` | `0x9D` | -40 | 60.3355 (+26.06%) | 62.1058 (+29.76%) | 63.3680 (+32.40%) |
| `ff` | `0x9D` | 27 | 62.5816 (+30.75%) | 64.3672 (+34.48%) | 65.5684 (+36.99%) |
| `ff` | `0x9D` | 85 | 65.5921 (+37.04%) | 66.1743 (+38.26%) | 67.0390 (+40.07%) |
| `ss` | `0x9D` | -40 | 31.5204 (-34.14%) | 34.4864 (-27.95%) | 36.0834 (-24.61%) |
| `ss` | `0x9D` | 27 | 34.2035 (-28.54%) | 36.4376 (-23.87%) | 37.8047 (-21.01%) |
| `ss` | `0x9D` | 85 | 35.6591 (-25.50%) | 37.5556 (-21.53%) | 38.8453 (-18.84%) |
| `fs` | `0x9D` | -40 | 45.3333 (-5.28%) | 46.7733 (-2.28%) | 47.7231 (-0.29%) |
| `fs` | `0x9D` | 27 | 47.1864 (-1.41%) | 48.5681 (+1.47%) | 49.5454 (+3.52%) |
| `fs` | `0x9D` | 85 | 49.8039 (+4.06%) | 50.0294 (+4.53%) | 50.6016 (+5.72%) |
| `sf` | `0x9D` | -40 | 41.0310 (-14.27%) | 44.2937 (-7.46%) | 46.1431 (-3.59%) |
| `sf` | `0x9D` | 27 | 44.0335 (-8.00%) | 46.5908 (-2.66%) | 48.2071 (+0.72%) |
| `sf` | `0x9D` | 85 | 45.7631 (-4.39%) | 47.9342 (+0.15%) | 49.4470 (+3.31%) |
| `rc_f` | `0x9D` | -40 | 55.4545 (+15.86%) | 58.5700 (+22.37%) | 60.5783 (+26.57%) |
| `rc_f` | `0x9D` | 27 | 58.0364 (+21.26%) | 60.7934 (+27.02%) | 62.7351 (+31.07%) |
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

> Both figures above are stated together, never one without the other: the calibration-point number alone is not the accuracy of this block.

## Post-trim — per-corner code from the ratified-target calibration (issue #43)

Calibration target: 48.000 MHz (ratified).

| process | code | T (°C) | 3 V | 3.3 V | 3.6 V |
|---|---|---|---|---|---|
| `tt` | `0x9D` | -40 | 43.7304 (-8.63%) | 45.8364 (-4.23%) | 47.0720 (-1.65%) |
| `tt` | `0x9D` | 27 | 46.0241 (-3.84%) | 47.8622 (+0.00%) | 49.1299 (+2.65%) |
| `tt` | `0x9D` | 85 | 47.4181 (-0.93%) | 48.9720 (+2.32%) | 50.1817 (+4.85%) |
| `ff` | `0x4C` | -40 | 44.7697 (-6.46%) | 45.8033 (-4.30%) | 46.5221 (-2.80%) |
| `ff` | `0x4C` | 27 | 46.9851 (-1.83%) | 47.9568 (+0.20%) | 48.6975 (+1.75%) |
| `ff` | `0x4C` | 85 | 49.6088 (+3.65%) | 49.6905 (+3.82%) | 50.0450 (+4.56%) |
| `ss` | `0xCF` | -40 | 40.4498 (-15.49%) | 45.7345 (-4.45%) | 48.7054 (+1.76%) |
| `ss` | `0xCF` | 27 | 43.9719 (-8.13%) | 48.0051 (+0.30%) | 50.6324 (+5.79%) |
| `ss` | `0xCF` | 85 | 45.7376 (-4.44%) | 49.1584 (+2.71%) | 51.5876 (+7.78%) |
| `fs` | `0x9B` | -40 | 44.8126 (-6.37%) | 46.1999 (-3.47%) | 47.1920 (-1.40%) |
| `fs` | `0x9B` | 27 | 46.6844 (-2.46%) | 47.9806 (+0.25%) | 48.9748 (+2.32%) |
| `fs` | `0x9B` | 85 | 49.3161 (+3.04%) | 49.4675 (+3.35%) | 50.0754 (+4.62%) |
| `sf` | `0xA3` | -40 | 42.1635 (-11.91%) | 45.6584 (-4.60%) | 47.6438 (-0.46%) |
| `sf` | `0xA3` | 27 | 45.3264 (-5.30%) | 48.0625 (+0.42%) | 49.8918 (+4.24%) |
| `sf` | `0xA3` | 85 | 47.1434 (-1.50%) | 49.5261 (+3.48%) | 51.1608 (+6.89%) |
| `rc_f` | `0x58` | -40 | 44.0021 (-8.07%) | 45.8900 (-4.12%) | 47.1559 (-1.48%) |
| `rc_f` | `0x58` | 27 | 46.3562 (-3.15%) | 48.0222 (+0.33%) | 49.2515 (+2.90%) |
| `rc_f` | `0x58` | 85 | 50.0429 (+4.56%) | 50.1739 (+4.83%) | 50.7858 (+6.11%) |
| `rc_s` | `0xBE` | -40 | 44.0090 (-8.05%) | 46.3106 (-3.24%) | 47.7747 (-0.18%) |
| `rc_s` | `0xBE` | 27 | 46.0402 (-3.81%) | 48.0603 (+0.41%) | 49.5337 (+3.49%) |
| `rc_s` | `0xBE` | 85 | 47.0893 (-1.61%) | 48.9555 (+2.28%) | 50.3561 (+5.21%) |

Cells are MHz (Δ vs. the calibrated nominal point).

| Condition | n | min (MHz) | max (MHz) | vs. calibrated nominal |
|---|---|---|---|---|
| calibration point (27 °C, VDD ±10%) | 21 | 43.9719 | 50.6324 | -8.13% / +5.79% |
| full temperature range (−40…+85 °C, VDD ±10%) | 63 | 40.4498 | 51.5876 | -15.49% / +7.78% |

| Spec row | Ratified | Simulated | Verdict |
|---|---|---|---|
| Post-trim, at calibration point | ±1.1% | -8.13% / +5.79% | **exceeds** |
| Post-trim, full temperature range | -9% / +8% | -15.49% / +7.78% | **exceeds** |

> Both figures above are stated together, never one without the other: the calibration-point number alone is not the accuracy of this block.

## Isolated sensitivities (post-trim, per-corner surrogate calibration)

| process | code | f(−40 °C) | f(27 °C) | f(85 °C) | ΔT coefficient |
|---|---|---|---|---|---|
| `tt` | `0x71` | 39.4554 | 41.3154 | 42.3405 | +559 ppm/K |
| `ff` | `0x21` | 39.2076 | 41.2258 | 42.8548 | +708 ppm/K |
| `ss` | `0xB3` | 39.2132 | 41.2977 | 42.4818 | +633 ppm/K |
| `fs` | `0x6F` | 39.6765 | 41.2180 | 42.5637 | +560 ppm/K |
| `sf` | `0x75` | 39.1288 | 41.2182 | 42.3886 | +633 ppm/K |
| `rc_f` | `0x2D` | 39.3559 | 41.3089 | 43.2594 | +756 ppm/K |
| `rc_s` | `0xA7` | 39.3039 | 41.1309 | 42.2140 | +566 ppm/K |

| process | code | f(3.0 V) | f(3.3 V) | f(3.6 V) | supply sensitivity |
|---|---|---|---|---|---|
| `tt` | `0x71` | 39.9663 | 41.3154 | 42.2718 | +5.58% over 3.0→3.6 V |
| `ff` | `0x21` | 40.5391 | 41.2258 | 41.7417 | +2.92% over 3.0→3.6 V |
| `ss` | `0xB3` | 38.3657 | 41.2977 | 43.2222 | +11.76% over 3.0→3.6 V |
| `fs` | `0x6F` | 40.2702 | 41.2180 | 41.9960 | +4.19% over 3.0→3.6 V |
| `sf` | `0x75` | 39.2636 | 41.2182 | 42.4514 | +7.73% over 3.0→3.6 V |
| `rc_f` | `0x2D` | 40.0593 | 41.3089 | 42.1344 | +5.02% over 3.0→3.6 V |
| `rc_s` | `0xA7` | 39.6867 | 41.1309 | 42.1902 | +6.09% over 3.0→3.6 V |

## Isolated sensitivities (post-trim, per-corner ratified-target calibration (issue #43))

| process | code | f(−40 °C) | f(27 °C) | f(85 °C) | ΔT coefficient |
|---|---|---|---|---|---|
| `tt` | `0x9D` | 45.8364 | 47.8622 | 48.9720 | +524 ppm/K |
| `ff` | `0x4C` | 45.8033 | 47.9568 | 49.6905 | +648 ppm/K |
| `ss` | `0xCF` | 45.7345 | 48.0051 | 49.1584 | +571 ppm/K |
| `fs` | `0x9B` | 46.1999 | 47.9806 | 49.4675 | +545 ppm/K |
| `sf` | `0xA3` | 45.6584 | 48.0625 | 49.5261 | +644 ppm/K |
| `rc_f` | `0x58` | 45.8900 | 48.0222 | 50.1739 | +714 ppm/K |
| `rc_s` | `0xBE` | 46.3106 | 48.0603 | 48.9555 | +440 ppm/K |

| process | code | f(3.0 V) | f(3.3 V) | f(3.6 V) | supply sensitivity |
|---|---|---|---|---|---|
| `tt` | `0x9D` | 46.0241 | 47.8622 | 49.1299 | +6.49% over 3.0→3.6 V |
| `ff` | `0x4C` | 46.9851 | 47.9568 | 48.6975 | +3.57% over 3.0→3.6 V |
| `ss` | `0xCF` | 43.9719 | 48.0051 | 50.6324 | +13.87% over 3.0→3.6 V |
| `fs` | `0x9B` | 46.6844 | 47.9806 | 48.9748 | +4.77% over 3.0→3.6 V |
| `sf` | `0xA3` | 45.3264 | 48.0625 | 49.8918 | +9.50% over 3.0→3.6 V |
| `rc_f` | `0x58` | 46.3562 | 48.0222 | 49.2515 | +6.03% over 3.0→3.6 V |
| `rc_s` | `0xBE` | 46.0402 | 48.0603 | 49.5337 | +7.27% over 3.0→3.6 V |

## Issue #43 switch acceptance — per-code supply sensitivity at the `ss` corner (27 °C)

The pre-#43 instrumentation measured ~+11.0–11.3% (3.0→3.6 V) at `ss`/code `0x80` but ~+20.0–20.8% at `ss`/code `0xEF` — the un-switched trailing segments' phantom series resistance, whose magnitude grows as the switch drive thins. This pass re-measures exactly that pairing against the restructured trim tree: the two rows should now be of the same order, the high-code row no longer materially worse.

| code | f(3.0 V) | f(3.3 V) | f(3.6 V) | supply sensitivity |
|---|---|---|---|---|
| `0x80` | 29.8321 | 31.4461 | 32.4542 | +8.34% over 3.0→3.6 V |
| `0xEF` | 53.0976 | 59.6472 | 64.3014 | +18.78% over 3.0→3.6 V |
