2AMLogic/gf180-rcosc/sim/pvt/results/20260921T065703Z/summary.md

# PVT corner campaign 20260921T065703Z

Generated by `sim/pvt/pvt_sweep.py` (issue #12). Append-only evidence: this file, `results.csv`, `manifest.json` and every raw log under `sim/pvt/corners/20260921T065703Z/` belong to this run id and are never rewritten by a later run.

| | |
|---|---|
| git sha | `42b28556fd8c27ade5d4b21c52e805d2ae3e2d86` (dirty tree) |
| ngspice | ** ngspice-46 : Circuit level simulation program |
| PDK | gf180mcuC @ `/Users/rwalters/.ciel` |
| netlist | `design/netlist/pvt_tb.spice` (from `design/pvt_tb.sch`) |
| measurement | `tran 200p 1200n`, f averaged over 20 whole periods (rising edges 5..25, startup skipped) |
| unique points simulated | 285 |
| recorded rows | 206 |
| failed points | 0 |
| wall clock | 2629.3 s at 14 jobs |

## Sweep matrix

Full factorial, **every** combination simulated — no corner-by-corner spot check, no silently skipped point.

| Axis | Values | Count |
|---|---|---|
| process (fets / res / mimcap `.lib` sections) | `tt` (typical/res_typical/mimcap_typical), `ff` (ff/res_ff/mimcap_ff), `ss` (ss/res_ss/mimcap_ss), `fs` (fs/res_typical/mimcap_typical), `sf` (sf/res_typical/mimcap_typical), `rc_f` (typical/res_ff/mimcap_ff), `rc_s` (typical/res_ss/mimcap_ss) | 7 |
| temperature | -40 °C, 27 °C, 85 °C | 3 |
| supply | 3 V, 3.3 V, 3.6 V | 3 |
| **points per pass** | | **63** |

## Realized trim curve (tt, 27 °C, 3.3 V)

| code | f (MHz) | Δ vs. code 0x00 |
|---|---|---|
| `0x00` | 27.8199 | +0.00% |
| `0x10` | 27.8299 | +0.04% |
| `0x20` | 27.8346 | +0.05% |
| `0x30` | 27.8130 | -0.02% |
| `0x40` | 29.0287 | +4.35% |
| `0x50` | 29.0086 | +4.27% |
| `0x60` | 29.0205 | +4.32% |
| `0x70` | 29.0232 | +4.33% |
| `0x80` | 38.5212 | +38.47% |
| `0x90` | 38.5123 | +38.43% |
| `0xA0` | 39.8925 | +43.40% |
| `0xB0` | 39.9518 | +43.61% |
| `0xC0` | 47.6591 | +71.31% |
| `0xD0` | 48.8041 | +75.43% |
| `0xE0` | 53.4162 | +92.01% |
| `0xF0` | 56.1141 | +101.71% |
| `0xFF` | 57.5794 | +106.97% |

Realized trim range: **27.8199 … 57.5794 MHz** (ratio 2.0697, ±34.85% about the midpoint), average step **0.4195 %/code**.

| Spec row | Ratified | Simulated | Verdict |
|---|---|---|---|
| Output frequency | 48.000 MHz | max reachable 57.5794 MHz at code `0xFF` | met |
| Trim range | ±40% (28.8–67.2 MHz) | ±34.85% (27.8199–57.5794 MHz) | **not met** |
| Trim step | 0.314 %/code | 0.4195 %/code | met |

## Single-point trim calibration

Binary search over the 8-bit code at each process corner's own 27 °C / 3.3 V point (`f(code)` is monotonically non-decreasing by construction of the trim bank, so the search is valid).

- **Ratified target**: 48.000 MHz (repo README target-spec table).
- **Surrogate target**: 38.5212 MHz — the design's own realized frequency at `tt / 27 °C / 3.3 V / code 0x80`. Used only because the ratified target is unreachable at every corner (below); it lets the post-trim residual still be measured with the spec's own single-point methodology instead of being reported as "undefined".

| process | code @ 48.000 MHz target | f (MHz) | saturated? | code @ surrogate | f (MHz) | saturated? |
|---|---|---|---|---|---|---|
| `tt` | `0xCF` | 47.7339 | no | `0x9F` | 38.4939 | no |
| `ff` | `0x80` | 54.3089 | no | `0x3F` | 37.9632 | no |
| `ss` | `0xFF` | 40.2557 | **yes** | `0xEF` | 38.2459 | no |
| `fs` | `0xC0` | 51.6769 | no | `0x80` | 40.4155 | no |
| `sf` | `0xE0` | 48.6950 | no | `0xBF` | 37.7456 | no |
| `rc_f` | `0x80` | 50.7864 | no | `0x40` | 38.7816 | no |
| `rc_s` | `0xFC` | 48.0470 | no | `0xC0` | 38.8350 | no |

## Untrimmed / free-running spread

Fixed mid-scale code `0x80` across the whole factorial. Percentages are referenced to the nominal point `tt / 27 °C / 3.3 V` = 38.5212 MHz.

| process | T (°C) | 3 V | 3.3 V | 3.6 V |
|---|---|---|---|---|
| `tt` | -40 | 34.0377 (-11.64%) | 35.8542 (-6.92%) | 37.3120 (-3.14%) |
| `tt` | 27 | 36.8113 (-4.44%) | 38.5212 (+0.00%) | 40.0203 (+3.89%) |
| `tt` | 85 | 43.2818 (+12.36%) | 42.2526 (+9.69%) | 42.4751 (+10.26%) |
| `ff` | -40 | 48.2084 (+25.15%) | 50.3472 (+30.70%) | 52.1575 (+35.40%) |
| `ff` | 27 | 53.3500 (+38.50%) | 54.3089 (+40.98%) | 55.9002 (+45.12%) |
| `ff` | 85 | 69.9644 (+81.63%) | 65.8791 (+71.02%) | 62.8948 (+63.27%) |
| `ss` | -40 | 24.2885 (-36.95%) | 26.3786 (-31.52%) | 27.7467 (-27.97%) |
| `ss` | 27 | 26.7070 (-30.67%) | 28.5052 (-26.00%) | 29.8142 (-22.60%) |
| `ss` | 85 | 29.4902 (-23.44%) | 30.2370 (-21.51%) | 31.3145 (-18.71%) |
| `fs` | -40 | 35.8699 (-6.88%) | 37.4518 (-2.78%) | 38.8066 (+0.74%) |
| `fs` | 27 | 39.8986 (+3.58%) | 40.4155 (+4.92%) | 41.6439 (+8.11%) |
| `fs` | 85 | 51.6051 (+33.97%) | 48.1705 (+25.05%) | 46.0024 (+19.42%) |
| `sf` | -40 | 31.6770 (-17.77%) | 34.1296 (-11.40%) | 35.7293 (-7.25%) |
| `sf` | 27 | 34.6367 (-10.08%) | 36.7795 (-4.52%) | 38.4035 (-0.31%) |
| `sf` | 85 | 37.7771 (-1.93%) | 38.9371 (+1.08%) | 40.3142 (+4.65%) |
| `rc_f` | -40 | 43.8415 (+13.81%) | 46.4720 (+20.64%) | 48.5261 (+25.97%) |
| `rc_f` | 27 | 50.6657 (+31.53%) | 50.7864 (+31.84%) | 52.0814 (+35.20%) |
| `rc_f` | 85 | 67.5877 (+75.46%) | 67.0013 (+73.93%) | 63.8553 (+65.77%) |
| `rc_s` | -40 | 27.2784 (-29.19%) | 28.6127 (-25.72%) | 29.7132 (-22.87%) |
| `rc_s` | 27 | 29.5277 (-23.35%) | 30.8733 (-19.85%) | 32.0303 (-16.85%) |
| `rc_s` | 85 | 31.5439 (-18.11%) | 32.5328 (-15.55%) | 33.6534 (-12.64%) |

Cells are MHz (Δ vs. nominal).

| Condition | n | min (MHz) | max (MHz) | vs. nominal |
|---|---|---|---|---|
| process only (27 °C, 3.3 V) | 7 | 28.5052 | 54.3089 | -26.00% / +40.98% |
| full P×T×V factorial | 63 | 24.2885 | 69.9644 | -36.95% / +81.63% |

| Spec row | Ratified | Simulated (process only, fixed T/V) | Verdict |
|---|---|---|---|
| Free-running untrimmed process spread | ±35% (-27.7% / +47.6% exact) | -26.00% / +40.98% | within the ratified bound |

## Post-trim — single code `0xCF` from the ratified-target calibration

Calibration target: 48.000 MHz (ratified).

| process | code | T (°C) | 3 V | 3.3 V | 3.6 V |
|---|---|---|---|---|---|
| `tt` | `0xCF` | -40 | 40.8965 (-14.32%) | 44.3394 (-7.11%) | 47.3441 (-0.82%) |
| `tt` | `0xCF` | 27 | 44.3889 (-7.01%) | 47.7339 (+0.00%) | 50.8873 (+6.61%) |
| `tt` | `0xCF` | 85 | 53.6623 (+12.42%) | 52.9878 (+11.01%) | 54.2285 (+13.61%) |
| `ff` | `0xCF` | -40 | 59.6776 (+25.02%) | 64.1182 (+34.32%) | 68.3743 (+43.24%) |
| `ff` | `0xCF` | 27 | 66.5208 (+39.36%) | 69.3724 (+45.33%) | 73.2091 (+53.37%) |
| `ff` | `0xCF` | 85 | 93.1087 (+95.06%) | 88.1151 (+84.60%) | 84.4265 (+76.87%) |
| `ss` | `0xCF` | -40 | 28.2795 (-40.76%) | 31.6613 (-33.67%) | 34.1681 (-28.42%) |
| `ss` | `0xCF` | 27 | 31.3046 (-34.42%) | 34.3331 (-28.07%) | 36.8105 (-22.88%) |
| `ss` | `0xCF` | 85 | 34.9104 (-26.86%) | 36.5429 (-23.44%) | 38.7347 (-18.85%) |
| `fs` | `0xCF` | -40 | 44.4227 (-6.94%) | 47.7839 (+0.10%) | 50.9245 (+6.68%) |
| `fs` | `0xCF` | 27 | 50.0408 (+4.83%) | 51.8155 (+8.55%) | 54.7318 (+14.66%) |
| `fs` | `0xCF` | 85 | 69.0570 (+44.67%) | 64.4333 (+34.98%) | 61.7369 (+29.34%) |
| `sf` | `0xCF` | -40 | 36.9845 (-22.52%) | 41.0227 (-14.06%) | 44.1363 (-7.54%) |
| `sf` | `0xCF` | 27 | 40.6037 (-14.94%) | 44.2975 (-7.20%) | 47.3863 (-0.73%) |
| `sf` | `0xCF` | 85 | 44.6229 (-6.52%) | 47.0268 (-1.48%) | 49.8105 (+4.35%) |
| `rc_f` | `0xCF` | -40 | 51.7753 (+8.47%) | 56.4229 (+18.20%) | 60.4221 (+26.58%) |
| `rc_f` | `0xCF` | 27 | 60.7664 (+27.30%) | 61.9250 (+29.73%) | 64.8163 (+35.79%) |
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
| `fs` | `0x80` | 39.8986 | 40.4155 | 41.6439 | +4.32% over 3.0→3.6 V |
| `sf` | `0xBF` | 35.2635 | 37.7456 | 39.7655 | +11.93% over 3.0→3.6 V |
| `rc_f` | `0x40` | 39.0260 | 38.7816 | 39.2626 | +0.61% over 3.0→3.6 V |
| `rc_s` | `0xC0` | 36.1459 | 38.8350 | 41.3584 | +13.42% over 3.0→3.6 V |
