2AMLogic/gf180-rcosc/sim/pvt/results/20260921T075822Z/summary.md

# PVT corner campaign 20260921T075822Z

Generated by `sim/pvt/pvt_sweep.py` (issue #12). Append-only evidence: this file, `results.csv`, `manifest.json` and every raw log under `sim/pvt/corners/20260921T075822Z/` belong to this run id and are never rewritten by a later run.

| | |
|---|---|
| git sha | `1ac4434a7b1d51f20341824ffd67febc7438082a` (dirty tree) |
| ngspice | ** ngspice-46 : Circuit level simulation program |
| PDK | gf180mcuC @ `/Users/rwalters/.ciel` |
| netlist | `design/netlist/pvt_tb.spice` (from `design/pvt_tb.sch`) |
| measurement | `tran 200p 1200n`, f averaged over 20 whole periods (rising edges 5..25, startup skipped) |
| unique points simulated | 276 |
| recorded rows | 206 |
| failed points | 0 |
| wall clock | 3978.3 s at 14 jobs |
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
