2AMLogic/gf180-rcosc/layout/reports/rcosc_top.extracted.spice

* extracted by klt extract --deck gf180mcu

* cell rcosc_top
* pin clk
* pin t0
* pin t1
* pin t2
* pin t3
* pin t4
* pin t5
* pin t6
* pin t7
* pin vdd
* pin vss
.SUBCKT rcosc_top clk t0 t1 t2 t3 t4 t5 t6 t7 vdd vss
* device instance $1 r0 *1 317.05,1 nfet
M$1 \$37 \$37 vss vsubs nfet L=1U W=2U AS=0.84P AD=0.84P PS=4.84U PD=4.84U
* device instance $2 r0 *1 385.01,1 nfet
M$2 \$9 \$8 vss vsubs nfet L=20U W=2U AS=0.84P AD=0.84P PS=4.84U PD=4.84U
* device instance $3 r0 *1 448.146,12 nfet
M$3 \$10 t0 \$11 vsubs nfet L=0.28U W=24U AS=10.08P AD=10.08P PS=48.84U
+ PD=48.84U
* device instance $4 r0 *1 453.376,1 nfet
M$4 \$13 t0 vss vsubs nfet L=0.5U W=2U AS=0.84P AD=0.84P PS=4.84U PD=4.84U
* device instance $5 r0 *1 464.943,8 nfet
M$5 \$11 t1 \$14 vsubs nfet L=0.28U W=16U AS=6.72P AD=6.72P PS=32.84U PD=32.84U
* device instance $6 r0 *1 470.173,1 nfet
M$6 \$15 t1 vss vsubs nfet L=0.5U W=2U AS=0.84P AD=0.84P PS=4.84U PD=4.84U
* device instance $7 r0 *1 483.236,6 nfet
M$7 \$14 t2 \$16 vsubs nfet L=0.28U W=12U AS=5.04P AD=5.04P PS=24.84U PD=24.84U
* device instance $8 r0 *1 488.466,1 nfet
M$8 \$17 t2 vss vsubs nfet L=0.5U W=2U AS=0.84P AD=0.84P PS=4.84U PD=4.84U
* device instance $9 r0 *1 504.522,4 nfet
M$9 \$16 t3 \$18 vsubs nfet L=0.28U W=8U AS=3.36P AD=3.36P PS=16.84U PD=16.84U
* device instance $10 r0 *1 509.752,1 nfet
M$10 \$19 t3 vss vsubs nfet L=0.5U W=2U AS=0.84P AD=0.84P PS=4.84U PD=4.84U
* device instance $11 r0 *1 531.794,3 nfet
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
* device instance $97 r0 *1 554.086,1 ppolyf_u_1k
R$97 \$20 \$22 vsubs 11972 ppolyf_u_1k
* device instance $98 r0 *1 605.302,1 ppolyf_u_1k
R$98 \$22 \$24 vsubs 23944 ppolyf_u_1k
* device instance $99 r0 *1 692.433,1 ppolyf_u_1k
R$99 \$24 \$26 vsubs 47887.5 ppolyf_u_1k
.ENDS rcosc_top
