2AMLogic/gf180-rcosc/layout/reports/rcosc_trim_bank.extracted.spice

* extracted by klt extract --deck gf180mcu

* cell rcosc_trim_bank
* pin m
* pin p
* pin t0
* pin t1
* pin t2
* pin t3
* pin t4
* pin t5
* pin t6
* pin t7
* pin vdd
* pin vss
.SUBCKT rcosc_trim_bank m p t0 t1 t2 t3 t4 t5 t6 t7 vdd vss
* device instance $1 r0 *1 33.416,1 nfet
M$1 \$9 t0 vss vsubs nfet L=0.5U W=2U AS=0.84P AD=0.84P PS=4.84U PD=4.84U
* device instance $2 r0 *1 50.213,1 nfet
M$2 \$11 t1 vss vsubs nfet L=0.5U W=2U AS=0.84P AD=0.84P PS=4.84U PD=4.84U
* device instance $3 r0 *1 68.506,1 nfet
M$3 \$13 t2 vss vsubs nfet L=0.5U W=2U AS=0.84P AD=0.84P PS=4.84U PD=4.84U
* device instance $4 r0 *1 89.792,1 nfet
M$4 \$15 t3 vss vsubs nfet L=0.5U W=2U AS=0.84P AD=0.84P PS=4.84U PD=4.84U
* device instance $5 r0 *1 117.064,1 nfet
M$5 \$17 t4 vss vsubs nfet L=0.5U W=2U AS=0.84P AD=0.84P PS=4.84U PD=4.84U
* device instance $6 r0 *1 156.308,1 nfet
M$6 \$19 t5 vss vsubs nfet L=0.5U W=2U AS=0.84P AD=0.84P PS=4.84U PD=4.84U
* device instance $7 r0 *1 219.496,1 nfet
M$7 \$21 t6 vss vsubs nfet L=0.5U W=2U AS=0.84P AD=0.84P PS=4.84U PD=4.84U
* device instance $8 r0 *1 330.571,1 nfet
M$8 \$23 t7 vss vsubs nfet L=0.5U W=2U AS=0.84P AD=0.84P PS=4.84U PD=4.84U
* device instance $9 r0 *1 325.341,1.5 nfet
M$9 \$20 t7 m vsubs nfet L=0.28U W=3U AS=1.26P AD=1.26P PS=6.84U PD=6.84U
* device instance $10 r0 *1 214.266,2 nfet
M$10 \$18 t6 \$20 vsubs nfet L=0.28U W=4U AS=1.68P AD=1.68P PS=8.84U PD=8.84U
* device instance $11 r0 *1 151.078,2.5 nfet
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
* device instance $39 r0 *1 134.126,1 ppolyf_u_1k
R$39 \$16 \$18 vsubs 11972 ppolyf_u_1k
* device instance $40 r0 *1 185.342,1 ppolyf_u_1k
R$40 \$18 \$20 vsubs 23944 ppolyf_u_1k
* device instance $41 r0 *1 272.473,1 ppolyf_u_1k
R$41 \$20 m vsubs 47887.5 ppolyf_u_1k
.ENDS rcosc_trim_bank
