2AMLogic/gf180-rcosc/sim/row45-rerun/results/20261112T201500Z-calib-extracted-l07/rcosc_top_variant.spice

* rcosc_top, settled P3 sizing (DR-0023) on the comparator-H output-stage fix (DR-0028, issue #229):
* parasitic-annotated extraction of the revised layout/cells/rcosc_top.gds (MBUFN W=1u) with the
* nine trim-ladder poly resistor lengths x0.70 and the PDK cap_mim_1f0fF 20u x 10u timing MiM.
* Same transformation as sim/recentre/p3/rcosc_top_p3.spice; nothing else edited.
* extracted by klt extract --deck gf180mcu
* parasitic model (--parasitics):
* - capacitance: net-to-ground for every net's own (non-coupled) area/perimeter, plus net-to-net for the vertical-overlap coupling `coupling` describes below -- a coupled net pair gets a direct capacitor between their two hub nodes, not just capacitors to the deck's ground/substrate net
* - coupling: vertical overlap (crossover) unconditionally -- where one net's conductor on an adjacent metal level sits directly over another *distinct* net's conductor, that overlap area is charged between the two nets instead of to ground (issue #760) -- plus lateral (same-layer, sidewall) coupling, but only for a net pair naming one of the caller's declared `--critical-net` nets (issue #976): facing-edge length within that layer's own minimum-spacing lookback is charged between the two nets, *additively* (not deducted from either net's substrate fringe term, unlike the vertical case -- a known simplification). Any same-layer pair with neither side named `--critical-net`, and fringe shielding in general, are still not modelled
* - resistance: single lumped series resistance per net, distributed as a star across that net's device terminals (issue #592) -- not a per-segment, distributed RC ladder, *unless* `--distributed-rc` names this net via `--critical-net` (issue #977, Epic #709 Phase 2b): then the net's terminals are ordered along their approximate physical spread and its total R/C is broken into a chain of per-segment resistors (segment length proportional to inter-terminal distance) with a ground capacitor at each terminal node (proportional to its adjacent segment length/2), instead of one star hub -- still an approximation (terminal position is a device-placement proxy, not true per-segment routing geometry), but a strictly finer-grained one than the single-hub star
* - frequency: quasi-static -- one frequency-independent R and C per net; no skin effect, no distributed transmission-line behavior

* cell rcosc_top
* pin clk
* pin t0
* pin t1
* pin t2
* pin t3
* pin t4
* pin t5
* pin t6
* pin t7
* pin vdd
* pin vss
.SUBCKT rcosc_top vdd vss clk t0 t1 t2 t3 t4 t5 t6 t7
* device instance $1 r0 *1 317.05,1 nfet
X$1 \$37__t0 \$37__t1 vss__t0 vsubs nfet_03v3 L=1U W=2U AS=0.84P AD=0.84P PS=4.84U PD=4.84U
* device instance $2 r0 *1 385.01,1 nfet
X$2 \$9__t0 \$8__t0 vss__t2 vsubs nfet_03v3 L=20U W=2U AS=0.84P AD=0.84P PS=4.84U PD=4.84U
* device instance $3 r0 *1 448.146,12 nfet
X$3 \$10__t2 t0__t0 \$11__t1 vsubs nfet_03v3 L=0.28U W=24U AS=10.08P AD=10.08P PS=48.84U PD=48.84U
* device instance $4 r0 *1 453.376,1 nfet
X$4 \$13__t0 t0__t1 vss__t3 vsubs nfet_03v3 L=0.5U W=2U AS=0.84P AD=0.84P PS=4.84U PD=4.84U
* device instance $5 r0 *1 464.943,8 nfet
X$5 \$11__t3 t1__t0 \$14__t1 vsubs nfet_03v3 L=0.28U W=16U AS=6.72P AD=6.72P PS=32.84U PD=32.84U
* device instance $6 r0 *1 470.173,1 nfet
X$6 \$15__t2 t1__t2 vss__t14 vsubs nfet_03v3 L=0.5U W=2U AS=0.84P AD=0.84P PS=4.84U PD=4.84U
* device instance $7 r0 *1 483.236,6 nfet
X$7 \$14__t3 t2__t0 \$16__t1 vsubs nfet_03v3 L=0.28U W=12U AS=5.04P AD=5.04P PS=24.84U PD=24.84U
* device instance $8 r0 *1 488.466,1 nfet
X$8 \$17__t2 t2__t2 vss__t13 vsubs nfet_03v3 L=0.5U W=2U AS=0.84P AD=0.84P PS=4.84U PD=4.84U
* device instance $9 r0 *1 504.522,4 nfet
X$9 \$16__t3 t3__t0 \$18__t1 vsubs nfet_03v3 L=0.28U W=8U AS=3.36P AD=3.36P PS=16.84U PD=16.84U
* device instance $10 r0 *1 509.752,1 nfet
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
* device instance _43_t1 r0 *1 0,0 
R_43_t1 \$43__t1 \$43 19.2263332126
* device instance _43_t2 r0 *1 0,0 
R_43_t2 \$43__t2 \$43 10.7871363747
* device instance _43_t3 r0 *1 0,0 
R_43_t3 \$43__t3 \$43 6.905283797
* device instance _43_t4 r0 *1 0,0 
R_43_t4 \$43__t4 \$43 6.27245570917
* device instance _43_t5 r0 *1 0,0 
R_43_t5 \$43__t5 \$43 5.63965081426
* device instance _43_t6 r0 *1 0,0 
R_43_t6 \$43__t6 \$43 5.00687790615
* device instance _43 r0 *1 0,0 
C_43 \$43 vsubs 7.840062e-15
* device instance _45_t0 r0 *1 0,0 
R_45_t0 \$45__t0 \$45 14.41135
* device instance _45_t1 r0 *1 0,0 
R_45_t1 \$45__t1 \$45 14.41135
* device instance _45 r0 *1 0,0 
C_45 \$45 vsubs 9.932517e-15
* device instance _6_t0 r0 *1 0,0 
R_6_t0 \$6__t0 \$6 0.23358638158
* device instance _6_t1 r0 *1 0,0 
R_6_t1 \$6__t1 \$6 0.371168543125
* device instance _6_t2 r0 *1 0,0 
R_6_t2 \$6__t2 \$6 2.15175068841
* device instance _6_t3 r0 *1 0,0 
R_6_t3 \$6__t3 \$6 1.56527939798
* device instance _6_t4 r0 *1 0,0 
R_6_t4 \$6__t4 \$6 1.76073740053
* device instance _6_t5 r0 *1 0,0 
R_6_t5 \$6__t5 \$6 1.95623107124
* device instance _6_t6 r0 *1 0,0
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
