2AMLogic/gf180-rcosc/sim/row45-rerun/results/20261112T190000Z-stage-schematic/tb_ff_v33.spice

* rcosc_top stage-attribution bench, ff code 0x55, VDD=3.3 V (generated by gen_stage_requests.py)
.param sw_stat_global=0 sw_stat_mismatch=0 mc_skew=3 res_mc_skew=3 cap_mc_skew=3 fnoicor=0
.include "rcosc_top_p3_probed.spice"
XXDUT vdd 0 clk t0 t1 t2 t3 t4 t5 t6 t7 pvc pvh pvl pcmph pcmpl pqbar pibias ppb rcosc_top
VDD vdd 0 DC 3.3
VT0 t0 0 DC 3.3
VT1 t1 0 DC 0
VT2 t2 0 DC 3.3
VT3 t3 0 DC 0
VT4 t4 0 DC 3.3
VT5 t5 0 DC 0
VT6 t6 0 DC 3.3
VT7 t7 0 DC 0
