2AMLogic/gf180-rcosc/(commit log)

2026-08-20 Initial commit: trimmable free-running RC oscillator on gf180mcu
    Scaffolds the block: spec, schematics, ngspice sim, and klayout-tools-driven
    layout signoff.
    A new block, not a port. The fleet's existing clocking canaries are PLLs;
    nothing covers an internal RC-based clock source with a digital trim
    interface. The anchor accuracy class is the one shipped MCUs use for
    crystal-less full-speed USB — public, well-precedented (vendor clock-recovery
    peripherals disciplining an internal RC oscillator against USB start-of-frame
    timing), so the spec can be derived entirely from public sources: the USB 2.0
    frequency-tolerance clauses and shipped RC-oscillator datasheets.
    The sibling analog canarie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
2026-08-20 docs: ratify target spec with trim math and PVT accuracy budget (#2)
    - Add spec/decision-records/TEMPLATE.md following gf180-bandgap's
    decision-record convention.
    - Add DR-0001: relaxation-oscillator topology selection (vs.
    ring-with-RC-reference), with PVT-sensitivity, trim-granularity,
    supply-sensitivity, and area/power tradeoffs.
    - Add DR-0002: target-spec ratification — 48 MHz nominal, 8-bit/±35%
    digital trim with explicit LSB-step arithmetic, and a PVT accuracy
    budget separating free-running/untrimmed spread, free-running
    post-trim residual, and the runtime-discipline gap reserved for a
    future USB-SOF-style correction loop. Every numeric claim is either
    cited to a pub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
2026-08-20 docs: add DR-0003 correcting process spread, TCR, and Iq figures (#4)
    Re-fetched and re-read all five primary sources DR-0002 cited from
    recollection (USB 2.0 Rev 2.0 §7.1.11; ST RM0091 Rev 10 §6.2.3/§7;
    ST DS9826 Rev 6 §6.3.8 Table 43; Silicon Labs CP2102N Rev 1.5 Table 3.5;
    google/gf180mcu-pdk docs/analog/spice/elec_specs/). Four DR-0002 rows do
    not survive the PDK's own published device data:
    - Untrimmed process spread: ±30% (assumed) → ±35% first-order, sourced
    from poly-resistor ±20% + MIM-cap ±15.33%; exact frequency form is
    −27.7%/+47.6%.
    - Trim range: ±35% → ±40% to restore DR-0002's intended margin; 8-bit
    word retained, LSB recomputed to 150.588 kHz/code (0.31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
2026-08-25 Add rcosc design sources: relaxation-oscillator schematic + netlist (issue #6) (#8)
    First schematic-capture increment toward T1 sim-validated / bronze: an
    xschem relaxation-oscillator per DR-0001 (RC-timed core, switched-R trim
    bank, ratiometric bias generator), built from gf180mcu devices per DR-0003
    (ppolyf_u_1k poly resistor, cap_mim_1f0fF MIM cap -- deliberately avoiding
    the 1.5 fF/um^2 flavor DR-0003 flags as margin-thin). The 8-bit trim bank
    realizes the ratified +/-40% (28.8-67.2 MHz) range in 256 monotonic codes.
    design/regen-netlist.sh makes the derived SPICE netlist reproducible on
    schematic change; design/run-smoke-test.sh runs a functional/DC-only
    ngspice smoke test (bias/thresh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
    [rcosc_bias.sch, rcosc_comparator.sch, rcosc_top.sch, rcosc_trim_bank.sch, smoke_test.sch]
2026-09-05 feat(champion): standing authorization for design-evidence auto-merge (#6850)
    Operator ruling 2026-09-05: Judge-approved, green-CI PRs whose entire
    changed-file set lives in design/, sim/, layout/, measurements/,
    verification/, or docs/ auto-merge without the four-axis human hold.
    Rationale: canary design evidence is fully revertible with no fleet-infra
    blast radius, and the held-PR pattern (sky130-sar-adc#123 sat mergeable for
    days as the sole blocker of a layout chain) costs more than it protects
    here. spec/ and every tool surface fall outside the patterns, so the
    exact-subset rule keeps them on the four-axis judgment automatically.
    C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
2026-09-05 Add DR-0004: no active TC compensation, rely on runtime discipline (#15)
    Resolves the open architectural question DR-0003 flagged (active
    temperature-coefficient compensation vs. runtime discipline). After
    re-checking gf180mcu's published electrical-spec tables live, no
    resistor/diffusion/capacitor flavor with a usable positive TCR exists
    at a practical sheet resistance (only interconnect -- metal, contacts,
    vias -- publishes a positive TC, and canceling the timing resistor's
    -1200 ppm/K with it would need ~10^5-10^6 squares). Active closed-loop
    compensation is judged out of scope for a canary block verifying the
    PDK/tooling flow rather than a production part.
    - spec/decision-records/0004-n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
2026-09-05 feat(sim): full PVT-corner campaign evidence + DR-0005 (issue #12) (#17)
    * feat(sim): add parameterized PVT-corner testbench and sweep driver
    design/pvt_tb.sch instantiates the same DUT as smoke_test.sch but leaves
    every run-varying quantity as a .param (supply, eight trim bits) and defers
    the model-corner .lib selection, .temp, and the .control measurement block
    to a generated per-run half of the deck. sim/pvt/pvt_sweep.py composes a
    self-contained deck per operating point, runs the full process x temperature
    x supply factorial in parallel, and writes append-only evidence under a new
    UTC-stamped run id.
    pvt_tb is added to regen-netlist.sh's ENTRY_POINTS so the testbench netlist
    is regener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
    [pvt_tb.sch, results.csv]
2026-09-06 fix(design): re-derive trim-bank sizing from simulated behavior, not ln(3) (issue #16) (#19)
    Root-causes the ~2.3x frequency shortfall and compressed trim-bank ratio
    DR-0005's PVT campaign found: the discharge switch's RC time constant is
    far faster than comparator+latch propagation delay, so the timing node
    discharges past V_L to ~0V every cycle (making the real sawtooth a
    0V->V_H charge, not the V_L->V_H swing the ln(3) closed form assumes),
    and that same propagation delay is a fixed per-cycle overhead the closed
    form never budgeted.
    Re-sizes rcosc_bias.sch's RBIAS (~8x higher comparator tail current) and
    rcosc_trim_bank.sch's RFIX/R0..R7 from real, simulated reference-corner
    transient da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
    [rcosc_bias.sch, rcosc_trim_bank.sch, smoke_test.sch]
2026-09-06 feat(sim): full PVT-corner campaign against issue #16 resize + DR-0006 (issues #16, #18) (#21)
    Runs the process x temperature x supply factorial (sim/pvt/run-pvt-sweep.sh)
    against the schematic issue #16 (PR #19) landed, completing #16's last
    unmet acceptance-criteria bullet and issue #18's identical scope in one
    evidence run. New append-only evidence: sim/pvt/results/20260906T030219Z/
    and sim/pvt/corners/20260906T030219Z/ (278 points, 0 failures, 15.0 min at
    14 jobs) alongside the untouched issue #12 run (20260905T211140Z).
    Disposition recorded in DR-0006: the resize gets the output-frequency and
    free-running-spread rows to "met" and the trim range close (±38.16% vs
    ±40% ratified) with t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
    [results.csv]
2026-09-06 feat(sim): measure quiescent current, exceeds DR-0003 Row 4 target (#23)
    Extends design/smoke_test.sch's .op analysis to compute total vdd DC
    current (i(vdd), which sums every branch by KCL) and re-verifies it
    against DR-0003 Row 4 after issue #16's ~8x RBIAS tail-current resize.
    Measured 914.99 uA at the reference corner (tt/27C/3.3V), code 0x80 --
    1.83x the ratified < 500 uA target. An independent hand-estimate from
    the schematic's own device sizing corroborates the figure (~942 uA),
    ruling out a testbench artifact.
    Records the finding as DR-0007 (spec unchanged, per CLAUDE.md -- no
    relaxation), append-only evidence under sim/iq/results/20260906T032927Z/,
    and updates design/README.md's N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
    [smoke_test.sch]
2026-09-06 fix(design): re-balance RBIAS + tail-mirror ratio to meet the Iq target (issue #22) (#25)
    Issue #16's RBIAS resize (L=200u -> 25u) fixed the frequency/trim-range
    shortfall but pushed quiescent current to 914.99 uA -- 1.83x DR-0003 Row
    4's ratified < 500 uA (DR-0007). This re-derives the bias sizing from a
    simulated 2-D (RBIAS L) x (MTAIL W) grid at the reference corner, not a
    hand-estimated closed form.
    Sizing:
    rcosc_bias.sch RBIAS W=2u L=25u -> L=1000u
    rcosc_comparator.sch MTAIL W=4u nf=1 (2:1) -> W=16u nf=8 (8:1)
    Both knobs, not one: the bias budget is ibias*(1 + 2M), so at fixed total
    current a larger mirror ratio M spends less on the reference leg and more
    on com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
    [rcosc_bias.sch, rcosc_comparator.sch, results.csv, smoke_test.sch]
2026-09-07 fix(design): re-derive RBIAS against the running Iq metric to recover trim range (issue #24) (#26)
    * fix(design): re-derive RBIAS against the running Iq metric to recover trim range (issue #24)
    DR-0008 (issue #22) sized RBIAS/MTAIL against the stricter `.op` Iq figure
    rather than the running current DR-0003 Row 4 actually names, costing trim
    range (±38.16% -> ±32.42%). Re-derive RBIAS (L=1000um -> L=210um, MTAIL
    ratio unchanged at 8:1) against iq_run specifically: Row 4's verdict basis
    now reads iq_run (468.61 uA at worst code, met), recovering trim range to
    ±35.50% (~54% of DR-0008's loss). Full PVT campaign confirms output
    frequency and trim step remain met, and records a real, not-hid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
    [rcosc_bias.sch, rcosc_comparator.sch, results.csv]
2026-09-07 feat(layout): DRC-clean + LVS-matched GDS for rcosc_bias and rcosc_trim_bank (issue #13) (#29)
    Draws both sub-blocks from klt gen primitives (res_array/mos_array),
    composed and wired by a new layout/gen_lib.py Composer, with device
    geometry read directly out of design/netlist/rcosc_top.spice
    (layout/netlist_parse.py) so layout can never silently drift from the
    schematic. Both cells are DRC-clean (klt drc) and LVS-matched (klt lvs)
    against generated reference netlists, with fresh JSON evidence committed
    under layout/reports/. Resolves design/README.md's previously-flagged
    LSB trim-bank-segment DRC risk empirically (R0/R1 are DRC-clean; klt's
    curated deck has no resistor minimum-length rule).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
2026-09-07 feat(layout): DRC-clean + LVS-matched GDS for rcosc_comparator + rcosc_top (issue #27) (#30)
    Completes the rcosc_top layout hierarchy started in #13: rcosc_comparator
    (5T diff pair + buffer, the repo's first multi-finger device -- MTAIL is
    nfet_03v3 W=16u nf=8, folded via klt gen mos_array's parallel finger
    topology and recombined at LVS via options.combine_devices) and the
    rcosc_top top-level composition (inline SR latch, MDISCH, the CTIMING MiM
    cap, wiring rcosc_bias/rcosc_trim_bank/rcosc_comparator together as real
    GDS sub-cells).
    New gen_lib.py primitives needed by these two cells: a two-layer
    Row/Channel router (comparator's dn/dp crossing isn't planar in metal1
    alone), a shared n-well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
2026-09-07 feat(sim): post-layout (PEX-extracted) PVT re-verification subset (issue #28) (#31)
    Re-runs the process={tt,ff,ss} x temp={-40,+27,+85}C x VDD={3.0,3.3,3.6}V
    corner-endpoint subset (27 points) against a klt extract --parasitics
    netlist of the full-hierarchy layout/cells/rcosc_top.gds (issue #27), at
    the fixed post-#24 (DR-0009) single-code post-trim methodology's own
    calibration code (0xC0), by reusing sim/pvt/pvt_sweep.py's own deck
    composition with only the DUT body swapped.
    klt pex was not used verbatim: it has no --deck-option/--pins passthrough
    on the installed build, so it cannot select this design's non-default
    MiM-cap density and would silently extract the wrong parasitics. klt
    extr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
    [results.csv]
2026-09-07 docs: add Chipalooza Challenge #5 proposal document (issue #14) (#32)
    Synthesizes the epic-phase's brief-conformant proposal from the already-
    committed sim/ PVT/Iq/post-layout evidence and spec/decision-records
    (DR-0006 through DR-0010): block type, I/O list mapped to the slot
    budget, functional description referencing DR-0001/DR-0004, a spec table
    with per-row met/unmet verdicts (every calibration-point accuracy figure
    paired with its full-temperature-range figure), and a bench test plan.
    No new design, simulation, or layout work.
2026-09-07 docs: update stale maturity-status text to reflect post-layout evidence (#34)
    README.md's "Current position" line and design/README.md's top-of-file
    status and "No DRC/LVS claim"/"No layout" Non-goals bullets still read
    as pre-schematic / pre-layout, even though schematic capture, the full
    PVT-corner campaign, DRC-clean/LVS-matched layout (issues #6/#12/#13/
    #27), and a first post-layout PEX re-verification pass (issue #28,
    DR-0010) are all committed. Update both files to state the actual
    current position and cross-reference layout/README.md and DR-0010
    instead of restating stale claims.
    Closes #33
2026-09-09 feat(sim): PVT-corner factorial for quiescent current (Iq) — DR-0003 Row 4 exceeds off-reference (issue #35) (#36)
    Extends sim/iq/iq_sweep.py with the same 7-process x 3-temperature x
    3-supply corner grid sim/pvt/pvt_sweep.py uses for frequency (corner
    definitions imported, not duplicated), at codes 0x00/0x80/0xC0/0xFF.
    Finding, sim/iq/results/20260909T225306Z/ (252 points, 0 failures):
    DR-0003 Row 4 is met at the reference corner and across most of the
    grid, but exceeds at the fast corners (ff/rc_f) at hot/high-VDD, at
    every simulated code — worst case ff/85C/3.6V. Ratified spec unchanged
    per CLAUDE.md; recorded as DR-0011. Re-sizing is a follow-on.
    Closes #35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
    [results.csv]
2026-09-21 feat: add klt signoff block manifest with CI re-grade gate (#40)
    * feat: add klt signoff block manifest with CI re-grade gate
    Commit the block manifest that makes this block's T1 state graded rather
    than hand-read: kind+evidence citations with pinned content_hash, the
    graded 11-item signoff report (4 met / 7 unmet with reasons), a generic
    characterization envelope for T1 item 8, and the PDK-free CI gate that
    re-grades the manifest, re-verifies every pin against the artifacts, and
    fails on any drift from the committed verdict of record.
    Closes #38
    * docs: quote the characterization record's own verdict vocabulary
    During evaluation I verified the claim text against the record itself:
    docs/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
2026-09-21 feat(layout): add klt erc supply spec and report for T1 item 11 (#41)
    Structural power-delivery evidence: vdd and vss each resolve to exactly
    one electrical island on the layers they route on (Metal1-Metal4), with
    the input content-hash pinned to the committed GDS. Contact/Via4 and
    ties[] are deliberately omitted (klayout-tools#2183/#2169) with the
    cost disclosed: 32 erc.floating_gate artifacts, graded as absent by the
    item; the standing-in well-tie evidence is the LVS match carrying
    VDD/VSS in net_correspondence.
    Closes #37
2026-09-21 rcosc_bias: self-biased supply-independent current reference (comparator/bias-path PVT revision) (#45)
    * rcosc_bias: replace VDD-referenced current leg with self-biased core (issue #39)
    The pre-#39 reference ibias = (VDD - VGS)/RBIAS carried a measured
    +24.5% supply sensitivity over 3.0->3.6 V and ~+900 ppm/K drift; the
    comparator path pays its delay ~3x into the charge phase
    (slope-to-threshold conversion at vh), so that sensitivity dominated
    the post-trim supply rows (ss +20.77%, tt +8.52% at calibrated codes,
    campaign 20260907T090653Z). The new self-biased beta-multiplier core
    (P1/P2 pfet mirror pair, N1 reference diode driving the exported ibias
    node unchanged, N2 8x degenerated by RZ,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
    [rcosc_bias.sch, results.csv]
2026-09-21 feat(signoff): declare nwell supply tie and cite compound erc+lvs evidence to grade T1 item 11 met (#46)
    Flip the machine verdict of record for T1 item 11 (Power delivery,
    structural) from unmet/no_evidence to met, 4/11 -> 5/11 T1 items:
    - layout/erc-supply-spec.json: declare one ties[] entry -- the upstream
    deck's own gf180mcu tap boolean (Comp 22/0 covered by Nplus 32/0 inside
    Nwell 21/0, wired to Metal1, net vdd; klayout-tools#1084, spelled with
    the tap_requires intersection key the #2169 fix added). The pre-#2169
    collapse that made #37 omit ties[] is fixed in the pinned grader
    (0.5.0+g2b1e55e51bb8): a declared well is never a conductor and ties[]
    runs in its own extraction,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
2026-09-21 feat(layout): re-spin rcosc_bias (post-#39 core) + PEX re-verify (#48)
    * feat(layout): re-spin rcosc_bias for the self-biased core, re-verify DRC/LVS/PEX
    Re-draw the bias cell against the post-#39 device set (P1/P2 mirror
    pair, N1 reference diode, N2 degenerated by RZ, SEED startup pull-down),
    channel-routed like rcosc_comparator since the PMOS gate bus is no longer
    planar in metal1; recompose rcosc_top on the unchanged trim bank and
    comparator cells. Re-verify the hierarchy: DRC clean + LVS match (bias
    gains combine_devices for N2's folded fingers; trim/comparator byte
    untouched), supply ERC still one-island-per-supply (36 disclosed
    floating-gate artifacts), and the 27-point PEX PVT re-run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
    [results.csv]
2026-09-21 feat(design): replace trim-bank pass switches with per-position transmission gates — trim range restored (issue #43) (#52)
    * feat(design): replace trim-bank pass switches with per-position transmission gates
    Pre-#43 each trim segment R_i was shunted by a single nfet pass switch
    (gate = t_i, bulk = vss). Its effective drive t_i - v(low node)
    collapses into the body-effected subthreshold region as the timing node
    rises toward vh, so the switch duty dies exactly where the RC charge
    time concentrates: dead mid-block trim steps (0x00->0x10 measured
    +0.03% pre-fix) and a PVT-dependent phantom series resistance on every
    ON code (ss@0xEF supply sensitivity ~+20% vs ss@0x80 ~+11%; DR-0012).
    Each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
    [rcosc_top.sch, rcosc_trim_bank.sch, results.csv]
2026-09-21 docs: refresh §4 accuracy rows 5/6/9 + post-layout note to the DR-0012/DR-0013 evidence chain (issue #47) (#53)
    Re-derive the characterization record's §4 post-trim accuracy rows and the
    post-layout divergence note from the current committed evidence: row 5
    relabels the global calibration code 0xC0 -> 0xD0 (DR-0012 moved which code
    calibrates closest to the ratified 48.000 MHz target) and carries code 0xD0's
    own figures; row 6 carries the post-#39 per-corner figures and the new
    38.1812 MHz surrogate; row 9 carries the post-#39 Iq factorial figures and
    corrects the now-inaccurate "single-point post-trim calibration code"
    qualifier on 0xC0 (the fixed Iq code set never included 0xD0); the
    pos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
2026-09-21 docs: cite the DR-0013 post-re-spin PEX campaign in signoff item 7 (#54)
    Swap the item-7 evidence citation in signoff/README.md from the pre-re-spin
    post-layout PEX campaign (20260907T131703Z, DR-0010) to the DR-0013 re-spin
    re-verification (20260921T164434Z): campaign path, fixed trim code
    (0xC0 -> 0xD0, the DR-0013 run's code), and schematic-vs-extracted delta
    figures (-11.24% .. -41.42%). The graded verdict and its rationale
    (no_evidence / wrong_kind: the grader accepts only a klt pex report) are
    unchanged.
    Closes #49
2026-09-22 feat(layout): re-spin rcosc_trim_bank (post-#43 shunts) + PEX re-verify (#56)
    Re-draw the trim bank against the post-#43 device set (per-position
    SW<i>/PW<i> transmission gates at L=0.28u, per-bit 2u/4u complement
    inverters, new vdd pin, vss back as a real routed net), channel-routed
    like rcosc_comparator and the re-spun bias cell since the tb<i> buses and
    rails are not planar in metal1, with all sixteen PMOS sharing one drawn
    n-well; recompose rcosc_top on the unchanged bias/comparator cells (plus
    a collision fix in build_rcosc_top's sub-cell pad map that the new vdd
    pin exposed). Re-verify the hierarchy: DRC clean + LVS match
    (bias/comparator byte untouched), supply ERC one-island-per-supp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
    [results.csv]
2026-09-22 feat(spec): budget the measured comparator/latch delay residue into the post-trim rows (DR-0016) (#58)
    * feat(sim): add comparator/latch delay-probe instrumentation campaign (issue #51)
    Stage-delay decomposition of steady-state cycles at both per-corner
    calibrated-code sets across the 7x3x3 factorial, plus the DR-0014
    switchprobe code pairing at ss/27C. wrdata + Python crossing extraction
    with cycle alignment (edge-index matching desyncs across nodes; observed
    and documented in the driver docstring). 138 points, 0 failed.
    Headline measurements (surrogate calibrated codes, 27C): the comparator/
    latch delay paid into the period (dsum) carries 62-82% of the period's
    3.0->3.6V supply span; the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
    [results.csv]
2026-09-23 feat(design): re-reference the low-side comparator to a complementary PMOS-input cell — supply slope flattened, post-trim rows re-derived (DR-0017) (#60)
    * feat(design): swap XCMPL to a complementary PMOS-input comparator to flatten its supply-dependent delay (issue #57)
    Re-references the low-side (discharge-complete) comparison to the vdd
    rail: new rcosc_comparator_p cell (PMOS input pair, NMOS mirror load,
    pb-mirrored tail at 4:1, two-inverter buffer with a deliberately weak
    first pull-down), pb exported from rcosc_bias, XCMPL rewired at top.
    Measured on the DR-0016 probe cells: t_cmp_l supply span collapses from
    -1.92/-0.80/-1.38 ns (ss/tt/sf) to +0.08/+0.08/+0.13 ns, and the Row 4
    gua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
    [rcosc_bias.sch, rcosc_comparator.sch, rcosc_comparator_p.sch, rcosc_top.sch, results.csv]
2026-09-23 feat(sim): post-layout PEX re-verify of DR-0017 respin + guardrails (#62)
    Run the 27-point PEX PVT subset against the post-#60 hierarchy
    (rcosc_comparator_p-containing rcosc_top.gds) at DR-0017's calibration
    code 0xA3: schematic-vs-extracted -18.78% to -36.86% (mean -25.65%),
    always slower, worst at ff/-40C/3.6V, 0 failed runs. Extend
    pex_pvt_sweep.py with an opt-in --guardrails pass that measures
    DR-0017's two issue-#57 guardrails on both sides in-run: the Row-4
    guardrail cell (0x80/ff/85C/3.6V) runs 31.16% below its DR-0017 campaign
    basis, and every corner still calibrates inner-range against 48 MHz
    (0xD9/0xB3/0xF7, none saturated; ss ~+4.7% from the 0xFF rail -- the
    named risk). DR-0018 r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
    [guardrails.csv, results.csv]
2026-10-01 chore: resync installed Loom surfaces
    resynced_by: fleet-resync
    invocation: fleet-resync.sh --fleet-only --push
    <!-- loom:provenance v1 build=unknown 19f4e67fd0a0afbd3d8b6606ca91ceac911377a3 clean prompts=none sweep=none story=none trace=78a5dfbdfd8c530aecd1bb436fd096df host=loom-worker-2 base=86503950cc2975c1095061d1634b6a24e2287dad run=loom-run/v1:timer:loom-worker-2/fleet-resync:67c759f7ef3c43e38d3fa8d5f19a2dd1 installs=0.19.593 658650a4f0eff932ac66a8f690eaedf8123fc83b -->
    Loom-Story: none
    Loom-Trace-Id: 78a5dfbdfd8c530aecd1bb436fd096df
    Loom-Build: unknown 19f4e67fd0a0afbd3d8b6606ca91ceac911377a3 clean
2026-10-01 chore: resync installed Loom surfaces
    <!-- loom:provenance v1 build=unknown 56435bf476452911283e43940ecfd9a30f804af9 clean prompts=none sweep=none story=none trace=342405c5ebc99bdbf17afbd983c0c41c host=loom-worker-2 base=8b5a047c6a68dad4d1e48ddafd874b725e929255 run=loom-run/v1:timer:loom-worker-2/fleet-resync:20c09f231d424cd5b57ca7991848dd8a installs=0.19.603 8c39bf7cde8a8c03d1aaee441f397c017b6a3a9e -->
    Loom-Trace-Id: 342405c5ebc99bdbf17afbd983c0c41c
    Loom-Build: unknown 56435bf476452911283e43940ecfd9a30f804af9 clean
    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
2026-10-01 chore: resync installed Loom surfaces
    <!-- loom:provenance v1 build=unknown f2868e6b4d60d11a8ab47d25cad9e248229d2f66 clean prompts=none sweep=none story=none trace=4e2766ed5160781df891476246a9be2e host=robb-studio base=8e68f89cc45e75df7779974cb62f8f438ff37c9f run=loom-run/v1:timer:robb-studio/fleet-resync:2d3851d5-1673-43ae-bcc6-e5c971b37f33 installs=0.19.603 74778a6aeea5d9e06b489400942b35f33c8bb766 -->
    Loom-Trace-Id: 4e2766ed5160781df891476246a9be2e
    Loom-Build: unknown f2868e6b4d60d11a8ab47d25cad9e248229d2f66 clean
    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
2026-10-01 chore: resync installed Loom surfaces
    <!-- loom:provenance v1 build=unknown d6714830391f7596338b8de40ee2d0f45dcd12f5 clean prompts=none sweep=none story=none trace=af273f717e759e690d07f372734e9278 host=robb-pro base=bb165a1c77771d1a6bfd437830e5cd6f60824ff5 run=loom-run/v1:timer:robb-pro/fleet-resync:92e2f9ba-d083-411b-833b-ae52d169ef04 installs=0.19.605 6eb2b65a4496b7becb84ef1f944493a541fd01cd -->
    Loom-Trace-Id: af273f717e759e690d07f372734e9278
    Loom-Build: unknown d6714830391f7596338b8de40ee2d0f45dcd12f5 clean
    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
2026-10-01 chore: resync installed Loom surfaces
    <!-- loom:provenance v1 build=unknown e956e9fee69e53f08b887ca20e14d9058d6f9aee clean prompts=none sweep=none story=none trace=1077dafeb758858c149dd37f4ece3c77 host=loom-worker-2 base=34b32bcd17e3aa6823cc00a3ebfdf6ec62741429 run=loom-run/v1:timer:loom-worker-2/fleet-resync:e3773167b12d4b3aafa1f76848245174 installs=0.19.609 ff30576dacc8c2734b1c7434bedd29c47122caeb -->
    Loom-Trace-Id: 1077dafeb758858c149dd37f4ece3c77
    Loom-Build: unknown e956e9fee69e53f08b887ca20e14d9058d6f9aee clean
    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
2026-10-01 chore: resync installed Loom surfaces
    <!-- loom:provenance v1 build=unknown 617257919edc1b9b9ee27532c5ec1b8a64523388 clean prompts=none sweep=none story=none trace=dbafe4f8526617aa07c890721298a080 host=robb-studio base=9756a6a62a801ce0c9b85c7c2d5f7d097e939eac run=loom-run/v1:timer:robb-studio/fleet-resync:1817df66-02cc-4b27-927d-a38485da550a installs=0.19.610 c94891dd526cf6db5ee02045424c6913be522048 -->
    Loom-Trace-Id: dbafe4f8526617aa07c890721298a080
    Loom-Build: unknown 617257919edc1b9b9ee27532c5ec1b8a64523388 clean
    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
2026-10-01 chore: resync installed Loom surfaces
    <!-- loom:provenance v1 build=unknown a2a39ac2736eb2686e2c65412d939e67c0438a7d clean prompts=none sweep=none story=none trace=fc1a121767151aae5bd7427c683b7db6 host=robb-pro base=2fd7022a217f67c1384e5e4e2e6b404b0b7c60a5 run=loom-run/v1:timer:robb-pro/fleet-resync:708eb7c8-469d-4783-80b7-bafe142df3c4 installs=0.19.612 d25614656adcf70162da95c5e1035e99a0639a1a -->
    Loom-Trace-Id: fc1a121767151aae5bd7427c683b7db6
    Loom-Build: unknown a2a39ac2736eb2686e2c65412d939e67c0438a7d clean
    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
2026-10-01 chore: resync installed Loom surfaces
    <!-- loom:provenance v1 build=unknown 126c80914e42f913c4fc778d3ddce96daa2c7a77 clean prompts=none sweep=none story=none trace=15a20fbea7a00d0922b943088c80e19d host=loom-worker-1 base=b7e93dd52ddc7da0b27998abe81e63f3dc5ca2fe run=loom-run/v1:script:loom-worker-1/fleet-resync:ecc423da-4625-49de-b25a-692fd669a029 installs=0.19.612 53aeb18c5541af6b068247d82f62daed412cc2c6 -->
    Loom-Trace-Id: 15a20fbea7a00d0922b943088c80e19d
    Loom-Build: unknown 126c80914e42f913c4fc778d3ddce96daa2c7a77 clean
    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
2026-10-01 chore: resync installed Loom surfaces
    <!-- loom:provenance v1 build=unknown 126c80914e42f913c4fc778d3ddce96daa2c7a77 clean prompts=none sweep=none story=none trace=a0a42bd10fcfa6d7cbcc9c021c406848 host=loom-worker-2 base=46d1bc06c9f031974e63e796ec18209437ea3a65 run=loom-run/v1:timer:loom-worker-2/fleet-resync:9e174e6bb0fa41d786e4a86e45632b6f installs=0.19.612 6f0871dc66e62b36d8382ced980d2805bfd97e50 -->
    Loom-Trace-Id: a0a42bd10fcfa6d7cbcc9c021c406848
    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
2026-10-01 chore: resync installed Loom surfaces
    <!-- loom:provenance v1 build=unknown 8891f74a5d568fe3d13937ef37fd64371dd2738f clean prompts=none sweep=none story=none trace=1e216ea76cbd2b72542049c4c18c2817 host=loom-worker-1 base=1e894b3d25894ecd25b22b496bf151cd28112411 run=loom-run/v1:timer:loom-worker-1/fleet-resync:679feba6c0f347d39eb5943ed77dc87b installs=0.19.612 62fa67f8756bdf59fdf744be053e5ef1709f1335 -->
    Loom-Trace-Id: 1e216ea76cbd2b72542049c4c18c2817
    Loom-Build: unknown 8891f74a5d568fe3d13937ef37fd64371dd2738f clean
    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
2026-10-01 chore: resync installed Loom surfaces
    <!-- loom:provenance v1 build=unknown 6f3411c8a63e68097dde01bce8a8422230f54218 clean prompts=none sweep=none story=none trace=9aa0a46bb352b9665fdaa5f5b3b85dd7 host=robb-pro base=a3f1244828f2e2aa3e347390f90bac600a34f059 run=loom-run/v1:timer:robb-pro/fleet-resync:ca419e1d-6646-4678-ac7a-b263e4b5119e installs=0.19.612 7731400b3e3e1df39074564166edf656feb0999c -->
    Loom-Trace-Id: 9aa0a46bb352b9665fdaa5f5b3b85dd7
    Loom-Build: unknown 6f3411c8a63e68097dde01bce8a8422230f54218 clean
    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
2026-10-02 chore: resync installed Loom surfaces
    <!-- loom:provenance v1 build=unknown 13c0a3ef467a888520a6529ab34486ab8be826be clean prompts=none sweep=none story=none trace=41356080f367e491d5ff03f17bb98c27 host=loom-worker-2 base=d40c8428a1735a95e10238c4cad92de0f19cd747 run=loom-run/v1:timer:loom-worker-2/fleet-resync:44455fbcbab745abb92cea192fafbb1d installs=0.19.614 3c79f7b1d0cc14723e049cff4250ff7330804326 -->
    Loom-Trace-Id: 41356080f367e491d5ff03f17bb98c27
    Loom-Build: unknown 13c0a3ef467a888520a6529ab34486ab8be826be clean
    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
2026-10-02 chore: resync installed Loom surfaces
    <!-- loom:provenance v1 build=unknown ea2dd21f2ba310ec007d047ddfecc6cd27d220ac clean prompts=none sweep=none story=none trace=f04a67f3922788d2ccdd66578c8d18f9 host=loom-worker-1 base=c2d504c61792f8d2d99121c9377c9ce1e46acdc9 run=loom-run/v1:timer:loom-worker-1/fleet-resync:1c3b601dd998488595adc09040c007d4 installs=0.19.614 79f4897c5d3c78dbfc1b022f77d244838dbf4ccb -->
    Loom-Trace-Id: f04a67f3922788d2ccdd66578c8d18f9
    Loom-Build: unknown ea2dd21f2ba310ec007d047ddfecc6cd27d220ac clean
    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
2026-10-02 chore: resync installed Loom surfaces
    <!-- loom:provenance v1 build=unknown 6f3411c8a63e68097dde01bce8a8422230f54218 clean prompts=none sweep=none story=none trace=acb28d0049e0cc75536f96d503f6e814 host=robb-studio base=2da0bac599050682ff53967efc8a05563e7b2773 run=loom-run/v1:timer:robb-studio/fleet-resync:85d2b1b5-e81d-40c3-ab6a-9a00efbc4ee2 installs=0.19.616 d86523eeadb32b95777f3cd3a76dd2f72f0bf792 -->
    Loom-Trace-Id: acb28d0049e0cc75536f96d503f6e814
    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
2026-10-02 chore: resync installed Loom surfaces
    <!-- loom:provenance v1 build=unknown 2b50bd69eddd038dd738465aa58a9ebca11410ac clean prompts=none sweep=none story=none trace=324e4f607054d0396cfdf8fdc01e93ae host=robb-pro base=f2c9c7ddc36e78276fb72810c1ecf073601f5af3 run=loom-run/v1:timer:robb-pro/fleet-resync:a63799f1-2ad7-4946-b81d-2ec231bc2d2f installs=0.19.617 81cb2ad7e091b19d6a2b95d1add6938c2100d46b -->
    Loom-Trace-Id: 324e4f607054d0396cfdf8fdc01e93ae
    Loom-Build: unknown 2b50bd69eddd038dd738465aa58a9ebca11410ac clean
    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
2026-10-02 chore: resync installed Loom surfaces
    <!-- loom:provenance v1 build=unknown 00d92b326aed50280cd90dc116b7caec27668251 clean prompts=none sweep=none story=none trace=9a5d23cc82b6d3a1c83bfee47bd04970 host=loom-worker-2 base=5a2c1287874a9cad0a7a52f5286c1fdd82aba8fe run=loom-run/v1:timer:loom-worker-2/fleet-resync:12136a7a025d49f3a60b5edb04a3ff81 installs=0.19.619 4c0f505e4f0b76f8ccec07bda6d8b839030c077b -->
    Loom-Trace-Id: 9a5d23cc82b6d3a1c83bfee47bd04970
    Loom-Build: unknown 00d92b326aed50280cd90dc116b7caec27668251 clean
    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
2026-10-02 chore: resync installed Loom surfaces
    <!-- loom:provenance v1 build=unknown 456dad6d90259846313dc3bb80bf4e5471ef2d76 clean prompts=none sweep=none story=none trace=bb9688c03fb5211d06f48c8838a5505c host=robb-studio base=f41c26b58ec18b9c9fafc9ac7f63ddda6afc3117 run=loom-run/v1:timer:robb-studio/fleet-resync:e965c017-8ec7-485d-b46e-aeb399b81fb4 installs=0.19.620 0d28ba49f5a88fdb37271de9cb0144eb3442c6e3 -->
    Loom-Trace-Id: bb9688c03fb5211d06f48c8838a5505c
    Loom-Build: unknown 456dad6d90259846313dc3bb80bf4e5471ef2d76 clean
    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
2026-10-02 chore: resync installed Loom surfaces
    <!-- loom:provenance v1 build=unknown 6c6d2b6565dc13eff4c6811b9c670f452106516b clean prompts=none sweep=none story=none trace=539be979ae694d66ede516a7b5d17e41 host=robb-pro base=87a2a17cae279e6081d939aa969a25dc8a9d0e54 run=loom-run/v1:timer:robb-pro/fleet-resync:9444d216-de08-442f-8352-ba59f6e81bb3 installs=0.19.621 a90dc1d794eb9ff70aaf939ebf495abe716f3bdd -->
    Loom-Trace-Id: 539be979ae694d66ede516a7b5d17e41
    Loom-Build: unknown 6c6d2b6565dc13eff4c6811b9c670f452106516b clean
    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
2026-10-02 chore: resync installed Loom surfaces
    <!-- loom:provenance v1 build=unknown f6d28134bfe476967e005d97424073085f55e8a3 clean prompts=none sweep=none story=none trace=27eb90670d441065f593e941066ee005 host=loom-worker-2 base=f5d6f7bac177e65440f0c529b80d19747edd149a run=loom-run/v1:timer:loom-worker-2/fleet-resync:04001bba930241cf9e325bf304a9270a installs=0.19.623 ccc19c2bbe2aa65328427730fa53f70eb56128c6 -->
    Loom-Trace-Id: 27eb90670d441065f593e941066ee005
    Loom-Build: unknown f6d28134bfe476967e005d97424073085f55e8a3 clean
    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
2026-10-02 chore: resync installed Loom surfaces
    <!-- loom:provenance v1 build=unknown bc461736314499b6c2c4c0ad51fb2294f60336f5 clean prompts=none sweep=none story=none trace=c3ea68717dd3a908dbbd60a35bc8b5d6 host=robb-studio base=9b1c3e450e6b86937ef7c34ca9fe51b804fd8fe3 run=loom-run/v1:timer:robb-studio/fleet-resync:8d4c49e2-3258-4080-b0c8-082499053654 installs=0.19.623 a50aaf70069f8897c41a64b7d90783c5ab8294e0 -->
    Loom-Trace-Id: c3ea68717dd3a908dbbd60a35bc8b5d6
    Loom-Build: unknown bc461736314499b6c2c4c0ad51fb2294f60336f5 clean
    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
2026-10-02 chore: resync installed Loom surfaces
    <!-- loom:provenance v1 build=unknown bc461736314499b6c2c4c0ad51fb2294f60336f5 clean prompts=none sweep=none story=none trace=8bee8a664bfc89e0bbfbb3c2de7342ba host=loom-worker-2 base=6dbd67f38dc9d31f6dca47c9db625f15b4afe622 run=loom-run/v1:timer:loom-worker-2/fleet-resync:de2ceceb48ea4927a1334d08dc0082fe installs=0.19.624 5f49564fa78ae06f8c48d5224dae9ded04200bb7 -->
    Loom-Trace-Id: 8bee8a664bfc89e0bbfbb3c2de7342ba
    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
2026-10-03 chore: resync installed Loom surfaces
    <!-- loom:provenance v1 build=unknown 752d316233ed1a3da9e4f69ad760eb99bb477747 clean prompts=none sweep=none story=none trace=7851839b67c00a023e97cbdea1f580e1 host=robb-pro base=7ef4bddfd9526555c84b117c2620dcebf7a98e4d run=loom-run/v1:timer:robb-pro/fleet-resync:ae492b66-dca0-4da4-acab-8d26778f2d5c installs=0.19.624 121fac45f5006879bf58a18c951b9243d9099a18 -->
    Loom-Trace-Id: 7851839b67c00a023e97cbdea1f580e1
    Loom-Build: unknown 752d316233ed1a3da9e4f69ad760eb99bb477747 clean
    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
2026-10-03 chore: resync installed Loom surfaces
    <!-- loom:provenance v1 build=unknown b34a08286a42f47f917ec46647d4d167c1f5207c clean prompts=none sweep=none story=none trace=a8e453124b899b440f42c9d83837c7b6 host=loom-worker-2 base=417667f43967c59a17fb954b4a6cf2ba87f52839 run=loom-run/v1:timer:loom-worker-2/fleet-resync:f02dd5df715347fe90fe14b9353a1b66 installs=0.19.624 0162badc662fb30c070e70611aa8ff74a8486d54 -->
    Loom-Trace-Id: a8e453124b899b440f42c9d83837c7b6
    Loom-Build: unknown b34a08286a42f47f917ec46647d4d167c1f5207c clean
    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
2026-10-03 chore: resync installed Loom surfaces
    <!-- loom:provenance v1 build=unknown 3437cece5ab759f772122f8d18a6d2f05d246cde clean prompts=none sweep=none story=none trace=bba21427f750636f851279cfae92b4e5 host=loom-worker-1 base=fcff9f6f6c23eedafe5eeebd085130c6717084dc run=loom-run/v1:timer:loom-worker-1/fleet-resync:9440cda9476f404caa282e360a81ee03 installs=0.19.636 e41edfbb52c13982f7d8b0577f42957427a6514c -->
    Loom-Trace-Id: bba21427f750636f851279cfae92b4e5
    Loom-Build: unknown 3437cece5ab759f772122f8d18a6d2f05d246cde clean
    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
2026-10-03 chore: resync installed Loom surfaces
    <!-- loom:provenance v1 build=unknown 28040ed11a4369e20f3b7b0154a3fb2a2c35d38c clean prompts=none sweep=none story=none trace=0cd87d01c45d97a2ee57a99363fc0db2 host=robb-studio base=0c89ff367ce5000a6764c4355de8bbc46c702fb8 run=loom-run/v1:timer:robb-studio/fleet-resync:74b93657-6b04-4ac5-bc77-e0a1682b0595 installs=0.19.636 e41edfbb52c13982f7d8b0577f42957427a6514c -->
    Loom-Trace-Id: 0cd87d01c45d97a2ee57a99363fc0db2
    Loom-Build: unknown 28040ed11a4369e20f3b7b0154a3fb2a2c35d38c clean
    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
2026-10-03 chore: resync installed Loom surfaces
    <!-- loom:provenance v1 build=unknown 388c7fe0cad997f7a887f70c9f2cfe8781a2d512 clean prompts=none sweep=none story=none trace=2046ffd42f138a06b914f34851de3440 host=loom-worker-2 base=ab57c416860afd53ed9bf253f852285203247717 run=loom-run/v1:timer:loom-worker-2/fleet-resync:17c9456bb1934c70a545b12081496cce installs=0.19.647 d1fe5dead4202be12a964ab891fd5980e7836170 -->
    Loom-Trace-Id: 2046ffd42f138a06b914f34851de3440
    Loom-Build: unknown 388c7fe0cad997f7a887f70c9f2cfe8781a2d512 clean
    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
2026-10-03 chore: resync installed Loom surfaces
    <!-- loom:provenance v1 build=unknown 8078c29e691123d91cd761a786f99cfd25f1809d clean prompts=none sweep=none story=none trace=45869a6374635c036a11a6f379fe31a4 host=robb-pro base=cbe3027379fc9b4c997c3de413a6ec7e82697d92 run=loom-run/v1:timer:robb-pro/fleet-resync:b0a94991-052d-4e7d-ba2b-78b971096849 installs=0.19.647 709ca4396e074e5a4d1c5e19721f6ddac7154ca2 -->
    Loom-Trace-Id: 45869a6374635c036a11a6f379fe31a4
    Loom-Build: unknown 8078c29e691123d91cd761a786f99cfd25f1809d clean
    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
2026-10-03 chore: resync installed Loom surfaces
    <!-- loom:provenance v1 build=unknown f9cba29b0602624a23daa17ae04d31d82e10fa91 clean prompts=none sweep=none story=none trace=754b3688f97b6c34894d8cfbf272b81a host=loom-worker-1 base=9e6966086fe4effb2a16d106a05cf8267cdabd50 run=loom-run/v1:script:loom-worker-1/fleet-resync:11eb117a-9ff3-4411-88d4-fdd7d6748639 installs=0.19.649 6f2f13b1c31ce420e2250ae040d8e1050c0e761b -->
    Loom-Trace-Id: 754b3688f97b6c34894d8cfbf272b81a
    Loom-Build: unknown f9cba29b0602624a23daa17ae04d31d82e10fa91 clean
    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
2026-10-03 chore: resync installed Loom surfaces
    <!-- loom:provenance v1 build=unknown f9cba29b0602624a23daa17ae04d31d82e10fa91 clean prompts=none sweep=none story=none trace=544a028e3829d4020b8aaa144e5fa628 host=robb-studio base=2ea76e5cdb296383b09477f5a32bddc66d6872be run=loom-run/v1:script:robb-studio/fleet-resync:5b5b8b83-7139-447d-88bd-417dcf375aa6 installs=0.19.649 6f2f13b1c31ce420e2250ae040d8e1050c0e761b -->
    Loom-Trace-Id: 544a028e3829d4020b8aaa144e5fa628
    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
2026-10-03 chore: resync installed Loom surfaces
    <!-- loom:provenance v1 build=unknown f9cba29b0602624a23daa17ae04d31d82e10fa91 clean prompts=none sweep=none story=none trace=1057aaaf811f6dd2d64a3bb6d4b3ac49 host=robb-pro base=e122799052640d11c32b83bb0a970235b233c6f4 run=loom-run/v1:timer:robb-pro/fleet-resync:785c1ea0-d7f2-4810-99e9-cd9368aebe0c installs=0.19.649 2118aabb5a925f1ec4669b4d3d31176a46d8f2a6 -->
    Loom-Trace-Id: 1057aaaf811f6dd2d64a3bb6d4b3ac49
    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
2026-10-03 chore: resync installed Loom surfaces
    <!-- loom:provenance v1 build=unknown 72f61d9aa0fe08f1ef59f1a97a314e474455801e clean prompts=none sweep=none story=none trace=90666a75095c62a013be2ea121ab93f1 host=loom-worker-2 base=65a263d9a42cf696a4e3580011a97dc5fbf36fb2 run=loom-run/v1:script:loom-worker-2/fleet-resync:13865fad-1cac-4838-857f-34878fcba5d1 installs=0.19.652 235a64727b907d65529151af0a962b14f16462a0 -->
    Loom-Trace-Id: 90666a75095c62a013be2ea121ab93f1
    Loom-Build: unknown 72f61d9aa0fe08f1ef59f1a97a314e474455801e clean
    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
2026-10-03 chore: resync installed Loom surfaces
    <!-- loom:provenance v1 build=unknown 72f61d9aa0fe08f1ef59f1a97a314e474455801e clean prompts=none sweep=none story=none trace=845aaa0eb340f80f12095e2e8b421ed1 host=robb-pro base=16afdfce4a5992a26997faf5f06a9c38eab6bbff run=loom-run/v1:script:robb-pro/fleet-resync:344add4b-df8a-49e8-8563-2765673acc76 installs=0.19.652 235a64727b907d65529151af0a962b14f16462a0 -->
    Loom-Trace-Id: 845aaa0eb340f80f12095e2e8b421ed1
    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
2026-10-03 chore: resync installed Loom surfaces
    <!-- loom:provenance v1 build=unknown 21130104346fe9c464ce8a3fdf82c1d3e9667639 clean prompts=none sweep=none story=none trace=36308fff5a3c323c3d1bf6fffb6cd122 host=robb-studio base=8b7e1af7a1a34f8b3ecc62170016761b3809140c run=loom-run/v1:timer:robb-studio/fleet-resync:89972fbd-0774-4402-bbb7-26c33a851735 installs=0.19.652 fb69233bd8f1dfc2bdee37d8b934f99274dc0193 -->
    Loom-Trace-Id: 36308fff5a3c323c3d1bf6fffb6cd122
    Loom-Build: unknown 21130104346fe9c464ce8a3fdf82c1d3e9667639 clean
    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
2026-10-04 chore: resync installed Loom surfaces
    <!-- loom:provenance v1 build=unknown 61870b40779d205c1555e801c6e1d95df083cdea clean prompts=none sweep=none story=none trace=fb9213e215442932d2af05f3b14977de host=robb-pro base=dcca9475c950b49ea99977b8e8f9d8d52f5fd911 run=loom-run/v1:timer:robb-pro/fleet-resync:4c70cd1d-08cd-4add-8e2a-9a75160d163f installs=0.19.655 36c39e3c6f56e1979647ec235b4bd19c77db22f3 -->
    Loom-Trace-Id: fb9213e215442932d2af05f3b14977de
    Loom-Build: unknown 61870b40779d205c1555e801c6e1d95df083cdea clean
    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
2026-10-04 chore: resync installed Loom surfaces
    <!-- loom:provenance v1 build=unknown 61870b40779d205c1555e801c6e1d95df083cdea clean prompts=none sweep=none story=none trace=baa6c2cfcae1a320917c00ff2eb8b630 host=loom-worker-2 base=8c824e447a878ab5714c977d112139a9c8865dbf run=loom-run/v1:timer:loom-worker-2/fleet-resync:741a7f0f16df4fb1be4e657aeacd1244 installs=0.19.655 fc667a4faae1227f8a6837431f8a0c2d0aeaa7dd -->
    Loom-Trace-Id: baa6c2cfcae1a320917c00ff2eb8b630
    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
2026-10-04 chore: resync installed Loom surfaces
    <!-- loom:provenance v1 build=unknown b922acb2ac655cbccd71daa9e3f05a325a094ca5 clean prompts=none sweep=none story=none trace=833eeb34d4ca65c3f8c6f7824ddca3a3 host=robb-studio base=3db2ac4ed5dd1ef25133078883ea0447c362fb63 run=loom-run/v1:timer:robb-studio/fleet-resync:0d44f6dc-6a62-4d43-b49d-7cfdd7dbd823 installs=0.19.663 0a51e373e7fe1be156c5774b2c827d4b745368a3 -->
    Loom-Trace-Id: 833eeb34d4ca65c3f8c6f7824ddca3a3
    Loom-Build: unknown b922acb2ac655cbccd71daa9e3f05a325a094ca5 clean
    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
2026-10-04 chore: resync installed Loom surfaces
    <!-- loom:provenance v1 build=unknown 746ecb5f9d7e64ba1d2526f1e997530ad4f3dd43 clean prompts=none sweep=none story=none trace=f09501431241df2ec5688e334ba43dfe host=loom-worker-2 base=18353dc0f345aadd75b16ab7ddc6d525cb4920ca run=loom-run/v1:timer:loom-worker-2/fleet-resync:70797dad61fb4e21806716d54f1ce910 installs=0.19.669 59a1f84e3742827a8033bb153ebbedc1759bee72 -->
    Loom-Trace-Id: f09501431241df2ec5688e334ba43dfe
    Loom-Build: unknown 746ecb5f9d7e64ba1d2526f1e997530ad4f3dd43 clean
    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
2026-10-04 chore: resync installed Loom surfaces
    <!-- loom:provenance v1 build=unknown 8080d0485cc1312129ee642b084944c56d1be074 clean prompts=none sweep=none story=none trace=ed180bcab6828041123ad54d8ddb4037 host=robb-pro base=ce8c7d7bbb8007cf817574e3afea57258e7b4b13 run=loom-run/v1:timer:robb-pro/fleet-resync:e97b2f08-4ad9-4b66-a166-5b19820e2d1f installs=0.19.669 59a1f84e3742827a8033bb153ebbedc1759bee72 -->
    Loom-Trace-Id: ed180bcab6828041123ad54d8ddb4037
    Loom-Build: unknown 8080d0485cc1312129ee642b084944c56d1be074 clean
    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
2026-10-04 chore: resync installed Loom surfaces
    <!-- loom:provenance v1 build=unknown 83cb6647167ffc000d2c2f479b4e816b68f863f4 clean prompts=none sweep=none story=none trace=ccabffa1e1ba495895b262086030816c host=robb-studio base=250ce71a7d9ec3367fbd65923ff96dd4636ba3b9 run=loom-run/v1:timer:robb-studio/fleet-resync:88a78f1f-d978-47b5-99c3-2aabde811d17 installs=0.19.676 cd4f30bd892ea2595d8218b08150633504b0dd14 -->
    Loom-Trace-Id: ccabffa1e1ba495895b262086030816c
    Loom-Build: unknown 83cb6647167ffc000d2c2f479b4e816b68f863f4 clean
    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
2026-10-04 chore: resync installed Loom surfaces
    <!-- loom:provenance v1 build=unknown 32174d0f7e80508fa66c1a11a2c0fb28c515607e clean prompts=none sweep=none story=none trace=436d7c19b10cd5807625a7ce7190a82f host=loom-worker-2 base=3cec00a99ef4846614e08800a6cbba8e9b29ab6f run=loom-run/v1:timer:loom-worker-2/fleet-resync:19ae50771cc04d8db7b1403c1e66bbea installs=0.19.682 9eccfa110fa294fa32a62ffe8eff669cfcf1a3a6 -->
    Loom-Trace-Id: 436d7c19b10cd5807625a7ce7190a82f
    Loom-Build: unknown 32174d0f7e80508fa66c1a11a2c0fb28c515607e clean
    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
2026-10-04 chore: resync installed Loom surfaces
    <!-- loom:provenance v1 build=unknown 72290fa960e0773b2c50d74042e24914c7327637 clean prompts=none sweep=none story=none trace=f7b6952a649a174398a48b90b6ab4793 host=robb-pro base=65c2233dd4f155d7ce248e1f4acf429d516267f8 run=loom-run/v1:timer:robb-pro/fleet-resync:72f32482-5cc4-4b38-ab9e-4d2ef0b64e94 installs=0.19.684 bdb8fb331eb51c7def4cdd2c38b611af06f25f6d -->
    Loom-Trace-Id: f7b6952a649a174398a48b90b6ab4793
    Loom-Build: unknown 72290fa960e0773b2c50d74042e24914c7327637 clean
    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
2026-10-04 chore: resync installed Loom surfaces
    <!-- loom:provenance v1 build=unknown 76cda58637be0e74c4cb5b4c8dbc2000e2a9c3d4 clean prompts=none sweep=none story=none trace=614cbada5ce873c2b34a511816309cfc host=robb-studio base=75936bd8139aed116822bb067fce0152b134517c run=loom-run/v1:timer:robb-studio/fleet-resync:7e559a3b-ffdd-409b-8dd2-ae906a273b0a installs=0.19.692 d4974b9f5ff7843a3cfc06378ea2a69bc120e0f4 -->
    Loom-Trace-Id: 614cbada5ce873c2b34a511816309cfc
    Loom-Build: unknown 76cda58637be0e74c4cb5b4c8dbc2000e2a9c3d4 clean
    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
2026-10-04 chore: resync installed Loom surfaces
    <!-- loom:provenance v1 build=unknown f84bac5c232c093f83c1adc2533d8c75b021cda2 clean prompts=none sweep=none story=none trace=e687830614e4bd1c551ab6cf6186f8f3 host=loom-worker-2 base=32cac0f24c045f66fac09ed0456a9dc49977665b run=loom-run/v1:timer:loom-worker-2/fleet-resync:2db2c4373ac24de1b7a364e69eaea1ca installs=0.19.695 b0d5b09f207fda439390ea1dd249ad10e7009dfc -->
    Loom-Trace-Id: e687830614e4bd1c551ab6cf6186f8f3
    Loom-Build: unknown f84bac5c232c093f83c1adc2533d8c75b021cda2 clean
    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
2026-10-04 chore: resync installed Loom surfaces
    <!-- loom:provenance v1 build=unknown ac5c275d1c616a9723e747f5a66de93dc80d3512 clean prompts=none sweep=none story=none trace=c777c3912bd31972e9aa3ccab712ae01 host=loom-worker-1 base=f3120373679a10b0d22778710d079257afbae120 run=loom-run/v1:script:loom-worker-1/fleet-resync:b51a1b33-4958-4408-be36-166e12e8360b installs=0.19.697 ada83a5c7ff66b56b0060ef0be368c9fe56eb3c6 -->
    Loom-Trace-Id: c777c3912bd31972e9aa3ccab712ae01
    Loom-Build: unknown ac5c275d1c616a9723e747f5a66de93dc80d3512 clean
    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
2026-10-04 chore: resync installed Loom surfaces
    <!-- loom:provenance v1 build=unknown a19f642f5c09599c4c64827d81d228eb031be73e clean prompts=none sweep=none story=none trace=34a80e22764eb5055e37faec0eaf65fb host=robb-pro base=817e8c1994ea7c43ee94881bee476f7203e6e63d run=loom-run/v1:script:robb-pro/fleet-resync:689be620-3ff2-4ff5-a2ce-f6825f6379e2 installs=0.19.698 aa619a1d07e36e8d90ac01fea63dc39285c93567 -->
    Loom-Trace-Id: 34a80e22764eb5055e37faec0eaf65fb
    Loom-Build: unknown a19f642f5c09599c4c64827d81d228eb031be73e clean
    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
2026-10-04 chore: resync installed Loom surfaces
    <!-- loom:provenance v1 build=unknown 693bdd794cb34afdefd7f0c4596824cd53078a61 clean prompts=none sweep=none story=none trace=7e7be58c80b40f1ac882b00139fb0ca0 host=robb-pro base=7eb1675d581b6a1af6681a260458dd7eed438257 run=loom-run/v1:timer:robb-pro/fleet-resync:d64fbd6b-5d9b-491d-9e17-742b375bfba7 installs=0.19.698 b814428b8333c69174c977498d1d2db6bce3145c -->
    Loom-Trace-Id: 7e7be58c80b40f1ac882b00139fb0ca0
    Loom-Build: unknown 693bdd794cb34afdefd7f0c4596824cd53078a61 clean
    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
2026-10-04 chore: resync installed Loom surfaces
    <!-- loom:provenance v1 build=unknown 693bdd794cb34afdefd7f0c4596824cd53078a61 clean prompts=none sweep=none story=none trace=aa18f1ec102a98d77ffc51c9be6ffbb3 host=robb-studio base=3b7fac5e7c7369e363643469fcc934d3c50249e7 run=loom-run/v1:script:robb-studio/fleet-resync:3cb89ca8-62c2-4a69-8434-c4aaa3b64eaf installs=0.19.698 a58f00e0681c50d6bfc5089d0af4b3715198319f -->
    Loom-Trace-Id: aa18f1ec102a98d77ffc51c9be6ffbb3
    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
2026-10-04 chore: resync installed Loom surfaces
    <!-- loom:provenance v1 build=unknown 7a41c2e69ef89d60ed3bd190b94838021bf18d0f clean prompts=none sweep=none story=none trace=d0f04f38b507d85402723643fcf47197 host=loom-worker-1 base=443a0f85e72e47c90788ac1a878c87e29f40d166 run=loom-run/v1:script:loom-worker-1/fleet-resync:8fdc8c1c-f844-4c33-bc80-b424e5b4cf3d installs=0.19.703 89d5a428c652f957d7fad8a546589042d39911bc -->
    Loom-Trace-Id: d0f04f38b507d85402723643fcf47197
    Loom-Build: unknown 7a41c2e69ef89d60ed3bd190b94838021bf18d0f clean
    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
2026-10-05 chore: resync installed Loom surfaces
    <!-- loom:provenance v1 build=unknown ebb37db560de172930e261675a35bd52e429f650 clean prompts=none sweep=none story=none trace=a40e86a64366c7a1e36aea026901334f host=loom-worker-2 base=a35f1b8bfcaaf0d22d92b2f7d8cba4db99620940 run=loom-run/v1:script:loom-worker-2/fleet-resync:90b6cd74-6cc0-4f58-98ee-6ede0ac6f50c installs=0.19.703 f63c3c82e6bf202f2ca7b205b532f681c5ebb2c8 -->
    Loom-Trace-Id: a40e86a64366c7a1e36aea026901334f
    Loom-Build: unknown ebb37db560de172930e261675a35bd52e429f650 clean
    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
2026-10-05 chore: resync installed Loom surfaces
    <!-- loom:provenance v1 build=unknown 7a41c2e69ef89d60ed3bd190b94838021bf18d0f clean prompts=none sweep=none story=none trace=fc04851db12f586b5d58155325131b6e host=robb-studio base=4af69f666c7f6cf3555bb4d45df69c706c452f43 run=loom-run/v1:timer:robb-studio/fleet-resync:a7d5da6f-a896-4d6f-8d00-aebf47f9b266 installs=0.19.703 2ad9a08fb93de4d7dfac9d2b501d12c684c9c2cc -->
    Loom-Trace-Id: fc04851db12f586b5d58155325131b6e
    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
2026-10-05 chore: resync installed Loom surfaces
    <!-- loom:provenance v1 build=unknown afe7e99e397c242cc319fa80702fb3b23e23f5a7 clean prompts=none sweep=none story=none trace=e46782e1dd9c94461b4cf934ce05296b host=loom-worker-2 base=65b8c78007fa00401d0d8b8be8c4eec110b7aa69 run=loom-run/v1:timer:loom-worker-2/fleet-resync:caa89259b1fd414ebd2f07500621166d installs=0.19.703 972fe7321be6a9efe2653579379ea3bc40b899b2 -->
    Loom-Trace-Id: e46782e1dd9c94461b4cf934ce05296b
    Loom-Build: unknown afe7e99e397c242cc319fa80702fb3b23e23f5a7 clean
    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
2026-10-05 chore: resync installed Loom surfaces
    <!-- loom:provenance v1 build=unknown b44cb904ebb599db793066ccc631c846862abfbd clean prompts=none sweep=none story=none trace=9590fed7c1b1c9f549ccf3cba24292d7 host=robb-pro base=25723491dd87f288f54220e53cbf10ae07afce03 run=loom-run/v1:timer:robb-pro/fleet-resync:dbc6174e-403d-422d-98b6-73a4b6dbf44f installs=0.19.708 dc8faf1eae3143feda6301887c303b1ee45db7f4 -->
    Loom-Trace-Id: 9590fed7c1b1c9f549ccf3cba24292d7
    Loom-Build: unknown b44cb904ebb599db793066ccc631c846862abfbd clean
    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
2026-10-05 chore: resync installed Loom surfaces
    <!-- loom:provenance v1 build=unknown 4548905848fcb7cb875c1c0518f2fd88eb65818e clean prompts=none sweep=none story=none trace=aff5e139797705f6fa0811f102ecd103 host=loom-worker-1 base=77ec86703e49153b6f538c28f2823c472eb81211 run=loom-run/v1:timer:loom-worker-1/fleet-resync:ba6a9e5686a64abaa842d71acaeae2ca installs=0.19.718 00d99344506bcf00e1aec7e910abe3d13df2d240 -->
    Loom-Trace-Id: aff5e139797705f6fa0811f102ecd103
    Loom-Build: unknown 4548905848fcb7cb875c1c0518f2fd88eb65818e clean
    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
2026-10-05 chore: resync installed Loom surfaces
    <!-- loom:provenance v1 build=unknown e7efbaa6e7b97a7d72da6032044c67525291f4d1 clean prompts=none sweep=none story=none trace=d74a33a6f35e329b3e795991e790ebfd host=robb-studio base=93a6b00e8897bf05fbaf56f94740fc4742c93539 run=loom-run/v1:timer:robb-studio/fleet-resync:304f49c8-5b3e-46a9-a557-945b9ae177f0 installs=0.19.718 00d99344506bcf00e1aec7e910abe3d13df2d240 -->
    Loom-Trace-Id: d74a33a6f35e329b3e795991e790ebfd
    Loom-Build: unknown e7efbaa6e7b97a7d72da6032044c67525291f4d1 clean
    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
2026-10-05 chore: resync installed Loom surfaces
    <!-- loom:provenance v1 build=unknown 347b71e65e709d9fd49aba75d3fb67877fc08818 clean prompts=none sweep=none story=none trace=f9653dd318724c98136e7cef63e551ed host=robb-pro base=4597b78564a26db7e14d569a5297300d29ac9631 run=loom-run/v1:timer:robb-pro/fleet-resync:cdc95970-9fb1-49fa-a0e6-037a3fab2099 installs=0.19.728 991dcebf6f6b2de6571f1d3400bec083498c6438 -->
    Loom-Trace-Id: f9653dd318724c98136e7cef63e551ed
    Loom-Build: unknown 347b71e65e709d9fd49aba75d3fb67877fc08818 clean
    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
2026-10-05 chore: resync installed Loom surfaces
    <!-- loom:provenance v1 build=unknown 5c0d18101f48fecb656f10fa37afa9b09bf41631 clean prompts=none sweep=none story=none trace=ddcf49552af364cbf6e884bd59584c1f host=loom-worker-1 base=e570e48537dbedac5391492a1f20f57f2cf31264 run=loom-run/v1:timer:loom-worker-1/fleet-resync:5eb526a05f244f1985770579e7620ff1 installs=0.19.731 7484b71fce5179a025950e71a82855afaf6fd730 -->
    Loom-Trace-Id: ddcf49552af364cbf6e884bd59584c1f
    Loom-Build: unknown 5c0d18101f48fecb656f10fa37afa9b09bf41631 clean
    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
2026-10-05 chore: resync installed Loom surfaces
    <!-- loom:provenance v1 build=unknown 0b160514b6658e3ab26a71c6525791da25b46fcf clean prompts=none sweep=none story=none trace=311c3eb2c0ab9550d3de38df5523f3d7 host=robb-studio base=9ac96fd155765e117ccba8bfaed9fddd8c8a1a05 run=loom-run/v1:timer:robb-studio/fleet-resync:e6dec631-b42b-4cf2-b854-cc363cfde6e0 installs=0.19.731 d6146becf339a3d4e55e26e8807ac4571213a00b -->
    Loom-Trace-Id: 311c3eb2c0ab9550d3de38df5523f3d7
    Loom-Build: unknown 0b160514b6658e3ab26a71c6525791da25b46fcf clean
    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
2026-10-05 chore: resync installed Loom surfaces
    <!-- loom:provenance v1 build=unknown 5c0d18101f48fecb656f10fa37afa9b09bf41631 clean prompts=none sweep=none story=none trace=f1e8d4c6e73b8eec3e87a8da52e10f2d host=robb-pro base=7e16b281a58aac9d0eb2a678adf4a21cedacafc9 run=loom-run/v1:timer:robb-pro/fleet-resync:5518fd33-81cb-479f-93f0-287ea4b08876 installs=0.19.733 4e67131ce3a1317d8cb8904ec342541cc2f45665 -->
    Loom-Trace-Id: f1e8d4c6e73b8eec3e87a8da52e10f2d
    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
2026-10-05 chore: resync installed Loom surfaces
    <!-- loom:provenance v1 build=unknown ca170d11544ef499cc9500a45bbad152edacfbd1 clean prompts=none sweep=none story=none trace=6dcfc713b6a851b40932158c2eeb70af host=loom-worker-3 base=4d9d052654f9317d638b40043ef91bf02a14efd0 run=loom-run/v1:timer:loom-worker-3/fleet-resync:20ce0908ea5a468a9e055470104047ed installs=0.19.734 7ba6ea50c36dfdd2b5e2922dd22c65560980a5a2 -->
    Loom-Trace-Id: 6dcfc713b6a851b40932158c2eeb70af
    Loom-Build: unknown ca170d11544ef499cc9500a45bbad152edacfbd1 clean
    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
2026-10-05 chore: resync installed Loom surfaces
    <!-- loom:provenance v1 build=unknown 03f1c42302d15f8a83425a84a4e36ca484f3f625 clean prompts=none sweep=none story=none trace=f1bc879f8aa652d550764ffcd36e27d1 host=loom-worker-1 base=e92e3c528d5e728cae3f582eeca06356e6c8b071 run=loom-run/v1:timer:loom-worker-1/fleet-resync:f302a3cc8558413492093df510b02418 installs=0.19.734 967abe71d019ce6606018b4e57dee0223b84d96f -->
    Loom-Trace-Id: f1bc879f8aa652d550764ffcd36e27d1
    Loom-Build: unknown 03f1c42302d15f8a83425a84a4e36ca484f3f625 clean
    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
2026-10-05 chore: resync installed Loom surfaces
    <!-- loom:provenance v1 build=unknown ce7557ba58624d48fedbca2bc037dfa8ce3943e7 clean prompts=none sweep=none story=none trace=e1f2558834c47835cd9a53ec8c9a2ffa host=loom-worker-3 base=eda07dfb7c9e4c0f598666735079957a710db6bd run=loom-run/v1:timer:loom-worker-3/fleet-resync:50f5f0046e2c4890961b3221bd360247 installs=0.19.734 ba9edb650872e5265eaca0c47f75e3cb828ecad2 -->
    Loom-Trace-Id: e1f2558834c47835cd9a53ec8c9a2ffa
    Loom-Build: unknown ce7557ba58624d48fedbca2bc037dfa8ce3943e7 clean
    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
2026-10-05 chore: resync installed Loom surfaces
    <!-- loom:provenance v1 build=unknown f92eaec38470a7b0732e065f4864faec9a1905d6 clean prompts=none sweep=none story=none trace=07aa020a8179d52651250562e9808b98 host=robb-studio base=7b537d5602f256d9afba56da679fcc3bd7f916c1 run=loom-run/v1:timer:robb-studio/fleet-resync:3b3ebdf2-b5f7-48ed-b7bb-5fb945094061 installs=0.19.734 78f3e99c44d0af6d4598adf7577bb6676baf3e8f -->
    Loom-Trace-Id: 07aa020a8179d52651250562e9808b98
    Loom-Build: unknown f92eaec38470a7b0732e065f4864faec9a1905d6 clean
    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
2026-10-06 chore: resync installed Loom surfaces
    <!-- loom:provenance v1 build=unknown ca170d11544ef499cc9500a45bbad152edacfbd1 clean prompts=none sweep=none story=none trace=fca9c14d74d6d634726f5823c51bc62a host=loom-worker-2 base=ef4fcf2a07b9ba39b10f1b87f7559e37f1136841 run=loom-run/v1:timer:loom-worker-2/fleet-resync:23a23f0878c1494cb720941baddfea81 installs=0.19.741 3cede3920c6b567d5400789187a904970d46b0fb -->
    Loom-Trace-Id: fca9c14d74d6d634726f5823c51bc62a
    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
2026-10-06 chore: resync installed Loom surfaces
    <!-- loom:provenance v1 build=unknown e38a22941348fd8e83d1f4b06130d2a214adfb50 clean prompts=none sweep=none story=none trace=a7fe3a9a1fedfce89846c20f2e98ac31 host=robb-pro base=f528540da76aaad818be5f54add7c50d84eff01b run=loom-run/v1:timer:robb-pro/fleet-resync:2d770a42-f0e7-4695-abfa-b912e75382e6 installs=0.19.744 8bc5bcce93c4d9721817387afe8b4b6d79f26054 -->
    Loom-Trace-Id: a7fe3a9a1fedfce89846c20f2e98ac31
    Loom-Build: unknown e38a22941348fd8e83d1f4b06130d2a214adfb50 clean
    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
2026-10-06 chore: resync installed Loom surfaces
    <!-- loom:provenance v1 build=unknown f66ea90ff1bdec51aa4c8dc3f4b2e8d26e3dfd2d clean prompts=none sweep=none story=none trace=66d96c3bb00b04fae967865ee02fc4de host=loom-worker-3 base=58efead125f7fae9e308925e204e9205f1c82275 run=loom-run/v1:timer:loom-worker-3/fleet-resync:eb2dceb410e848a19d58f96f678c995e installs=0.19.749 6135634b053dc30ef5aa8e6d733bfe79bb2ac734 -->
    Loom-Trace-Id: 66d96c3bb00b04fae967865ee02fc4de
    Loom-Build: unknown f66ea90ff1bdec51aa4c8dc3f4b2e8d26e3dfd2d clean
    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
2026-10-06 chore: resync installed Loom surfaces
    <!-- loom:provenance v1 build=unknown ade8a2c60cc8370d04d72f331141acb6fb32e121 clean prompts=none sweep=none story=none trace=6245fb88b5bdf9f7ccecb6b2168dc335 host=robb-studio base=8eb981cb5b3c8dc8028d2d47d4b433cd0ecae944 run=loom-run/v1:timer:robb-studio/fleet-resync:b305aed2-1a25-4576-aca7-9b017ac4377e installs=0.19.755 8d97d322e1cb3723988504337089beca73d0511c -->
    Loom-Trace-Id: 6245fb88b5bdf9f7ccecb6b2168dc335
    Loom-Build: unknown ade8a2c60cc8370d04d72f331141acb6fb32e121 clean
    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
2026-10-06 chore: resync installed Loom surfaces
    <!-- loom:provenance v1 build=unknown 2489bb7d5203844b3fbe8efbe007f44aa074685d clean prompts=none sweep=none story=none trace=0b5c9263a55c09e6fbd870b2d9ff5d9b host=loom-worker-2 base=c5eff36be0eb0f5bc4de4c1d1c902769471cfacd run=loom-run/v1:timer:loom-worker-2/fleet-resync:d3f5a5beb1144f72ac8be575767b3e03 installs=0.19.760 3a509582b179d91c2d5b5a65a7ba4650c3c08985 -->
    Loom-Trace-Id: 0b5c9263a55c09e6fbd870b2d9ff5d9b
    Loom-Build: unknown 2489bb7d5203844b3fbe8efbe007f44aa074685d clean
    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
2026-10-06 chore: resync installed Loom surfaces
    <!-- loom:provenance v1 build=unknown 986d16b700174622774ff68af4ef323e8d0e23ba clean prompts=none sweep=none story=none trace=cb518f1f5785c258556383940a46c461 host=loom-worker-1 base=9f9a7c91078762bded7354966a85dc54d9479633 run=loom-run/v1:timer:loom-worker-1/fleet-resync:97df92c5eca846de85e979810663a94b installs=0.19.765 c6cec65c4f320f11153c72e840e49a5d6a6f1afc -->
    Loom-Trace-Id: cb518f1f5785c258556383940a46c461
    Loom-Build: unknown 986d16b700174622774ff68af4ef323e8d0e23ba clean
    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
2026-10-06 chore: resync installed Loom surfaces
    <!-- loom:provenance v1 build=unknown 85e52221261264d7f7643251de706f00c8db289f clean prompts=none sweep=none story=none trace=a2434124d73d8cca0ca77230fc85adf5 host=robb-pro base=4f6b4945e7ad8d751d2bbd57ba6cec81e36591a4 run=loom-run/v1:timer:robb-pro/fleet-resync:abffb067-59ed-4a6e-94b6-8cf3500c935c installs=0.19.768 c9f7ca975144d991bce40f492403b8292e8b7fae -->
    Loom-Trace-Id: a2434124d73d8cca0ca77230fc85adf5
    Loom-Build: unknown 85e52221261264d7f7643251de706f00c8db289f clean
    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
2026-10-06 chore: resync installed Loom surfaces
    <!-- loom:provenance v1 build=unknown 31b34ebfd7d4539094523eaa7b56a104bebe5fc0 clean prompts=none sweep=none story=none trace=16fac36f144dc183c71465eb36c89afc host=loom-worker-3 base=a44761713725e4de7d758bfe8952d6aabd1f4aeb run=loom-run/v1:timer:loom-worker-3/fleet-resync:c763e24590314b918c8ee8df5d2de1db installs=0.19.769 af995a5725fdadf708127f006aa8f248b482d7d7 -->
    Loom-Trace-Id: 16fac36f144dc183c71465eb36c89afc
    Loom-Build: unknown 31b34ebfd7d4539094523eaa7b56a104bebe5fc0 clean
    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
2026-10-06 chore: resync installed Loom surfaces
    <!-- loom:provenance v1 build=unknown 7bed309263b3785eae46a9cbc53b3b24a52b10d2 clean prompts=none sweep=none story=none trace=843adbd5eac450c43d3a2c43da1bf729 host=robb-studio base=49cdabbde3b2d3003e28514c84540a68d4cc2228 run=loom-run/v1:timer:robb-studio/fleet-resync:f83d5ba4-81f7-479a-9768-6af33d4cc825 installs=0.19.783 a9b459e0c2b1916ceb116db33053e7eb0df57e7b -->
    Loom-Trace-Id: 843adbd5eac450c43d3a2c43da1bf729
    Loom-Build: unknown 7bed309263b3785eae46a9cbc53b3b24a52b10d2 clean
    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
2026-10-06 chore: resync installed Loom surfaces
    <!-- loom:provenance v1 build=unknown 07bc40ba9ab0f7dfe7cd0990377b7ac07a52d220 clean prompts=none sweep=none story=none trace=563f186108419cf03cef002a62c3b201 host=loom-worker-2 base=2455d358646ae5da6259847a2bdbd4bde9cb01d2 run=loom-run/v1:timer:loom-worker-2/fleet-resync:944beccd157a4197b81feafdd19f443e installs=0.19.785 2f0a9dbb4f06053f747b8a5615a3519f8e30b527 -->
    Loom-Trace-Id: 563f186108419cf03cef002a62c3b201
    Loom-Build: unknown 07bc40ba9ab0f7dfe7cd0990377b7ac07a52d220 clean
    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
2026-10-06 chore: resync installed Loom surfaces
    <!-- loom:provenance v1 build=unknown 31b34ebfd7d4539094523eaa7b56a104bebe5fc0 clean prompts=none sweep=none story=none trace=ea6600df41a4b420b6d8e967f839ccfd host=loom-worker-3 base=743a942f9b1b9f66958e81e917dc3f6476babe0a run=loom-run/v1:timer:loom-worker-3/fleet-resync:c80415b48fd5404bbd599c4f6cc8a448 installs=0.19.793 7ceff96944c39d33e3c2f1141ca650c2c4c05679 -->
    Loom-Trace-Id: ea6600df41a4b420b6d8e967f839ccfd
    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
2026-10-06 chore: resync installed Loom surfaces
    <!-- loom:provenance v1 build=unknown 596a53e525683919daae1b43e6babe9bf847a02f clean prompts=none sweep=none story=none trace=b9c0cb42a5a72ecc21726229c957ef1f host=loom-worker-2 base=7f1e68321ee78f3e59359c1ec47d6c1709bc9a5f run=loom-run/v1:timer:loom-worker-2/fleet-resync:21d578f5cc0b4b7ba5f10759f5f30ae8 installs=0.19.801 524bdb33cb26c8355454d7550413c89e72c06fae -->
    Loom-Trace-Id: b9c0cb42a5a72ecc21726229c957ef1f
    Loom-Build: unknown 596a53e525683919daae1b43e6babe9bf847a02f clean
    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
2026-10-06 chore: resync installed Loom surfaces
    <!-- loom:provenance v1 build=unknown 40b591a33adb895d4f46977105f9b264d8a2599b clean prompts=none sweep=none story=none trace=e41c725fe0c176312eb412bc69fe5b01 host=robb-studio base=d2ef6c43a8b2a07041942c741bef8c385db4bd04 run=loom-run/v1:timer:robb-studio/fleet-resync:37d704dd-4dfd-4341-adb4-6551637ad147 installs=0.19.802 72ce1f7385747dd773d1644408ec22072b8a5d20 -->
    Loom-Trace-Id: e41c725fe0c176312eb412bc69fe5b01
    Loom-Build: unknown 40b591a33adb895d4f46977105f9b264d8a2599b clean
    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
2026-10-06 chore: resync installed Loom surfaces
    <!-- loom:provenance v1 build=unknown 31b34ebfd7d4539094523eaa7b56a104bebe5fc0 clean prompts=none sweep=none story=none trace=5ad0480c4b21b80f9c852c448319e7a1 host=loom-worker-3 base=3e51bdaa2ed1885bc9106035cc6302b5acd2862e run=loom-run/v1:timer:loom-worker-3/fleet-resync:48e836f11f9547ddb96de5aa0d072a05 installs=0.19.810 933f828e779602e492e4e157812988a4b8128111 -->
    Loom-Trace-Id: 5ad0480c4b21b80f9c852c448319e7a1
    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
2026-10-07 chore: resync installed Loom surfaces
    <!-- loom:provenance v1 build=unknown f71cf25de9e75bae6060da4a599df8fbabe75890 clean prompts=none sweep=none story=none trace=64943e35511da4833bbd385cf288be8a host=loom-worker-2 base=7e0c6a4eb19f5054e33bb000435004edcb3b2881 run=loom-run/v1:timer:loom-worker-2/fleet-resync:d69eb1b87d4849ae810a145b1b667d2f installs=0.19.822 1c6969ea8726c800a353c236d9f23456a5706f1a -->
    Loom-Trace-Id: 64943e35511da4833bbd385cf288be8a
    Loom-Build: unknown f71cf25de9e75bae6060da4a599df8fbabe75890 clean
    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
2026-10-07 chore: resync installed Loom surfaces
    <!-- loom:provenance v1 build=unknown 31b34ebfd7d4539094523eaa7b56a104bebe5fc0 clean prompts=none sweep=none story=none trace=cb192cb8f72cf6f2711f73f7ee12bebc host=loom-worker-3 base=f6cc197996a94299145349eec5562804544e9775 run=loom-run/v1:timer:loom-worker-3/fleet-resync:c1e385c3607e43ad8bed9c7d29811c66 installs=0.19.830 a966f7b89b714704fa1225b96e2dbee50480a4c6 -->
    Loom-Trace-Id: cb192cb8f72cf6f2711f73f7ee12bebc
    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
2026-10-07 chore: resync installed Loom surfaces
    <!-- loom:provenance v1 build=unknown 8abdd34fddc879aff407380278baa713eca6b758 clean prompts=none sweep=none story=none trace=ea945665dad5ccb3880de51c4448e8b9 host=robb-pro base=e6eb3bc469e85e597c6d765a5c86c24582c53cf3 run=loom-run/v1:timer:robb-pro/fleet-resync:1466e397-b80c-46ea-a42c-26a7fbd4e00e installs=0.19.831 61814c9c1912925cdff7418842ff3ea17cd56fe4 -->
    Loom-Trace-Id: ea945665dad5ccb3880de51c4448e8b9
    Loom-Build: unknown 8abdd34fddc879aff407380278baa713eca6b758 clean
    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
2026-10-07 chore: resync installed Loom surfaces
    <!-- loom:provenance v1 build=unknown 628be5bb140bcff803d159201bd61e1b868901b0 clean prompts=none sweep=none story=none trace=093df1dc315c5e78dcccfca9d699d5f5 host=loom-worker-2 base=5a433afeaffcdb6cc575fe69f1230a95f55c50b1 run=loom-run/v1:timer:loom-worker-2/fleet-resync:0b0ea5e184c0429a9c431fcca6c791ad installs=0.19.832 1a0fc15974bf0575a9155fb8276f7529fc813542 -->
    Loom-Trace-Id: 093df1dc315c5e78dcccfca9d699d5f5
    Loom-Build: unknown 628be5bb140bcff803d159201bd61e1b868901b0 clean
    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
2026-10-07 chore: resync installed Loom surfaces
    <!-- loom:provenance v1 build=unknown 069e3b45d86c08f0d60c8fc2b0096de441e99bdc clean prompts=none sweep=none story=none trace=b1ba9d6b2b581e47827d9c099f717b04 host=loom-worker-1 base=028be1baa6a9d548a61ce8f639f1741aac545dd6 run=loom-run/v1:timer:loom-worker-1/fleet-resync:aada8278bd4843bcaecce69fdf91251e installs=0.19.838 e70aa17f8dead31bda49cf044c3fc28119df6e90 -->
    Loom-Trace-Id: b1ba9d6b2b581e47827d9c099f717b04
    Loom-Build: unknown 069e3b45d86c08f0d60c8fc2b0096de441e99bdc clean
    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
2026-10-07 chore: resync installed Loom surfaces
    <!-- loom:provenance v1 build=unknown 31b34ebfd7d4539094523eaa7b56a104bebe5fc0 clean prompts=none sweep=none story=none trace=ef030e94bce76f728497f5927960865f host=loom-worker-3 base=6db97cdff4bab56198656971383abd2f068f0c41 run=loom-run/v1:timer:loom-worker-3/fleet-resync:28ba4284bfa446c888b501714eda0509 installs=0.19.840 59b533a2a1ed5e186fbf8446b5acbe42d7231854 -->
    Loom-Trace-Id: ef030e94bce76f728497f5927960865f
    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
2026-10-07 chore: resync installed Loom surfaces
    <!-- loom:provenance v1 build=unknown bc59c70c3412a87b31a0dbe65cd6abf968744328 clean prompts=none sweep=none story=none trace=766033e4e881801f24971d664c490ea3 host=robb-studio base=c0e610adb6320f68c6d0a5a15015e310654ed7d4 run=loom-run/v1:timer:robb-studio/fleet-resync:6b3b079a-890e-4a79-9c3a-0b4bb33ff7c4 installs=0.19.840 59b533a2a1ed5e186fbf8446b5acbe42d7231854 -->
    Loom-Trace-Id: 766033e4e881801f24971d664c490ea3
    Loom-Build: unknown bc59c70c3412a87b31a0dbe65cd6abf968744328 clean
    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
2026-10-07 chore: resync installed Loom surfaces
    <!-- loom:provenance v1 build=unknown a068938e7a6c13759bcb3943e408273a3d352257 clean prompts=none sweep=none story=none trace=76bec863c8f6aff2d49b3aa2be128619 host=robb-pro base=7c2f2f77699da37f18fc24a0196c9d9fe2f4ce5c run=loom-run/v1:timer:robb-pro/fleet-resync:d9927fc6-ee80-4b6a-ba2b-f13576bd5f9b installs=0.19.846 837b14d7440b89ae8a2cec6d045483ac33659af5 -->
    Loom-Trace-Id: 76bec863c8f6aff2d49b3aa2be128619
    Loom-Build: unknown a068938e7a6c13759bcb3943e408273a3d352257 clean
    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
2026-10-07 chore: resync installed Loom surfaces
    <!-- loom:provenance v1 build=unknown 628be5bb140bcff803d159201bd61e1b868901b0 clean prompts=none sweep=none story=none trace=5a6f676b4652a1a750bbce1386c68d06 host=loom-worker-2 base=b7e915d59590b34a2f8eef1d69e1928865ca8e2f run=loom-run/v1:timer:loom-worker-2/fleet-resync:bd416e653be04ef4b13353430625e379 installs=0.19.850 3bb4bfc90603b6ad65cabca9b3eb42a59f1a9d3a -->
    Loom-Trace-Id: 5a6f676b4652a1a750bbce1386c68d06
    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
2026-10-07 chore: resync installed Loom surfaces
    <!-- loom:provenance v1 build=unknown 40215645df8a13508180b248b44244dc488bb078 clean prompts=none sweep=none story=none trace=29fde30615e6e47f39b41aa314c2c883 host=loom-worker-1 base=c482fe647facc312d75dcb2f9cc8b2e61b81d379 run=loom-run/v1:timer:loom-worker-1/fleet-resync:d1fbedfcc7824ae59233c0ea94dc4650 installs=0.19.853 2889d5ed585b4da0935543cb916381cc03b19746 -->
    Loom-Trace-Id: 29fde30615e6e47f39b41aa314c2c883
    Loom-Build: unknown 40215645df8a13508180b248b44244dc488bb078 clean
    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
2026-10-07 chore: resync installed Loom surfaces
    <!-- loom:provenance v1 build=unknown 31b34ebfd7d4539094523eaa7b56a104bebe5fc0 clean prompts=none sweep=none story=none trace=cdf49c615da3f5ce46e9fcda1a24f787 host=loom-worker-3 base=e689eb2ea15a18441a4a6bef1ed473e7340070aa run=loom-run/v1:timer:loom-worker-3/fleet-resync:cab31e05b8a24df09bc88f53ee3fb501 installs=0.19.857 7a0b529e6f57a79713f6924bf58d8392ff404259 -->
    Loom-Trace-Id: cdf49c615da3f5ce46e9fcda1a24f787
    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
2026-10-07 chore: resync installed Loom surfaces
    <!-- loom:provenance v1 build=unknown 4b44e7c5db0de1d2b5927de7de229120d546aad3 clean prompts=none sweep=none story=none trace=dfa656ee3483a044378501f49d36f812 host=robb-studio base=36e9c49b3cc5b09b6d71df6293a5c4eedc4be08b run=loom-run/v1:timer:robb-studio/fleet-resync:d80d6bc0-eb68-4a07-8226-2d947d328b3a installs=0.19.859 0aefebd79aba8ab33470f1af4b96847fc794bd0d -->
    Loom-Trace-Id: dfa656ee3483a044378501f49d36f812
    Loom-Build: unknown 4b44e7c5db0de1d2b5927de7de229120d546aad3 clean
    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
2026-10-07 chore: resync installed Loom surfaces
    <!-- loom:provenance v1 build=unknown b591c8cf436f0d4aa5870a9bc7cd5f7194e0e778 dirty prompts=none sweep=none story=none trace=6eca4b0c47205457aae7a3d721c17f17 host=robb-pro base=79d371d9d030d31fac9b0eacc9656bf583af3a38 run=loom-run/v1:timer:robb-pro/fleet-resync:64af20b3-58cb-47f2-b770-117197cb41e9 installs=0.19.864 128a7eba2bb5f7bcf8891ba284b14cb7ebf8dd3d -->
    Loom-Trace-Id: 6eca4b0c47205457aae7a3d721c17f17
    Loom-Build: unknown b591c8cf436f0d4aa5870a9bc7cd5f7194e0e778 dirty
    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
2026-10-07 chore: resync installed Loom surfaces
    <!-- loom:provenance v1 build=unknown b551219fd5b8347113c0cbc79ea416e81c39fa9d clean prompts=none sweep=none story=none trace=5ac7c8c62dad54841e21dd94f0920de3 host=loom-worker-2 base=b39381eb2e43ba94f394c42fbb4fdf871a993b42 run=loom-run/v1:timer:loom-worker-2/fleet-resync:d10fb10789e94930ab1af368c15a8f8b installs=0.19.864 128a7eba2bb5f7bcf8891ba284b14cb7ebf8dd3d -->
    Loom-Trace-Id: 5ac7c8c62dad54841e21dd94f0920de3
    Loom-Build: unknown b551219fd5b8347113c0cbc79ea416e81c39fa9d clean
    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
2026-10-07 chore: resync installed Loom surfaces
    <!-- loom:provenance v1 build=unknown 90fbd167e4e376894396e651676cf58fc9aa223a clean prompts=none sweep=none story=none trace=196876656e912171b28029ceca9f772d host=loom-worker-1 base=cdf7747a9ebdee462ea5dca684620b0fa1d9c125 run=loom-run/v1:timer:loom-worker-1/fleet-resync:7b46720ff3a84a8184f2f2b3bc039260 installs=0.19.868 ee904e1c151bc9cf15b0eb55dfe9d57ad6136cff -->
    Loom-Trace-Id: 196876656e912171b28029ceca9f772d
    Loom-Build: unknown 90fbd167e4e376894396e651676cf58fc9aa223a clean
    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
2026-10-08 chore: resync installed Loom surfaces
    <!-- loom:provenance v1 build=unknown 5a3df331a0612dee585ef905015af01d08e3467f clean prompts=none sweep=none story=none trace=5690fa95febe608e500a46dde8a6ee92 host=loom-worker-2 base=f8b758c1e902cd4c85ee751e7b771a0afe022b62 run=loom-run/v1:timer:loom-worker-2/fleet-resync:5c9c35d59b704bff9d8bf096ee7ba7be installs=0.19.876 b16d54e63fbbec4d7f15f13c1f43a5e5b38145ce -->
    Loom-Trace-Id: 5690fa95febe608e500a46dde8a6ee92
    Loom-Build: unknown 5a3df331a0612dee585ef905015af01d08e3467f clean
    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
2026-10-08 chore: resync installed Loom surfaces
    <!-- loom:provenance v1 build=unknown 134eb3ff06c1a86f49a911c6c17464f55e719736 clean prompts=none sweep=none story=none trace=c7df110d490314040dcd1347b2481843 host=loom-worker-1 base=519b6274602e0c563c7561965aedcae2f6f195e2 run=loom-run/v1:timer:loom-worker-1/fleet-resync:53d0cec2cd61484eb9a0f8fb1f24ac5e installs=0.19.879 c15619905bdd8a24506c3853f45490d26e8f1cad -->
    Loom-Trace-Id: c7df110d490314040dcd1347b2481843
    Loom-Build: unknown 134eb3ff06c1a86f49a911c6c17464f55e719736 clean
    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
2026-10-08 chore: resync installed Loom surfaces
    <!-- loom:provenance v1 build=unknown 8f86de23319d8f6cf049557dcc9cf2e321211d9d clean prompts=none sweep=none story=none trace=17de45f778fbfd714af8afad02c96375 host=loom-worker-3 base=8e49a61ba85506effcb7d4351e662b5170023732 run=loom-run/v1:timer:loom-worker-3/fleet-resync:9e3e5d4a08824de3b7bc02940be2a0da installs=0.19.882 c9f85af3d967986cdd7a3f27e088a16f88712b05 -->
    Loom-Trace-Id: 17de45f778fbfd714af8afad02c96375
    Loom-Build: unknown 8f86de23319d8f6cf049557dcc9cf2e321211d9d clean
    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
2026-10-08 chore: resync installed Loom surfaces
    <!-- loom:provenance v1 build=unknown 4a5fb2b6276e17ff26ee1382acfe2ea7360ebea5 clean prompts=none sweep=none story=none trace=67857e1b7189785825a2dfc70921cf85 host=loom-worker-2 base=ca83e5f1f05670551e93bb376c60215b5394f2c1 run=loom-run/v1:timer:loom-worker-2/fleet-resync:dd6a5f3dceff4d8d8602a07a1dc89c95 installs=0.19.892 ce93e8a919d79a6f027bab268846a52084f9d94e -->
    Loom-Trace-Id: 67857e1b7189785825a2dfc70921cf85
    Loom-Build: unknown 4a5fb2b6276e17ff26ee1382acfe2ea7360ebea5 clean
    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
2026-10-08 chore: resync installed Loom surfaces
    <!-- loom:provenance v1 build=unknown b591c8cf436f0d4aa5870a9bc7cd5f7194e0e778 dirty prompts=none sweep=none story=none trace=28e7ca5fdb768489aa38bf002407d5a5 host=robb-pro base=72ab15c9291036e43274dda2aec1c911f966f4bd run=loom-run/v1:timer:robb-pro/fleet-resync:eb5f838e-a774-4e20-8102-c37ee3ff31ca installs=0.19.895 9b30d293bcba1e79d49cabfc1c5bb5b6f4c0dc77 -->
    Loom-Trace-Id: 28e7ca5fdb768489aa38bf002407d5a5
    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
2026-10-08 chore: resync installed Loom surfaces
    <!-- loom:provenance v1 build=unknown 5684fc8c8ac418d95ad66a002d001eaea1283c9a clean prompts=none sweep=none story=none trace=c864acd3b9a5dbb419fddd8bd2a6283b host=loom-worker-3 base=d9f4ad4b13c82c6a616477461dd8ac490efb9af0 run=loom-run/v1:timer:loom-worker-3/fleet-resync:4771e7c630c34445b7f28539669d76e3 installs=0.19.898 3d55b9a1669c132d130d98f10a292c1325322c30 -->
    Loom-Trace-Id: c864acd3b9a5dbb419fddd8bd2a6283b
    Loom-Build: unknown 5684fc8c8ac418d95ad66a002d001eaea1283c9a clean
    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
2026-10-08 chore: resync installed Loom surfaces
    <!-- loom:provenance v1 build=unknown 04a1189116c7320def7d9ce357d2d9268405ae92 clean prompts=none sweep=none story=none trace=8e55b27fc60ffb045554bd413ad8f3c8 host=robb-pro base=dd1ccf6c49a63ee9753cf3d6be25feaa51970617 run=loom-run/v1:timer:robb-pro/fleet-resync:83b69005-7c5b-44b3-96f8-33f07bf82f4b installs=0.19.917 d3c1ea3a4c81e01ce5487dc3e4bbdd86534e677e -->
    Loom-Trace-Id: 8e55b27fc60ffb045554bd413ad8f3c8
    Loom-Build: unknown 04a1189116c7320def7d9ce357d2d9268405ae92 clean
    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
2026-10-08 feat(signoff): bind T1 items 1, 2, 9, 10 to audited artifacts; move grader pin to klayout-tools 3a75c3ae
    Move the klt signoff grader pin from 2b1e55e5 to 3a75c3ae (the merge
    of klayout-tools#2843). Before any manifest change, the unchanged
    manifest was graded under both builds. No row changed status or
    reason. The differences were the rulebook hash, three item texts, the
    new build/build_t1_item_count/graded_by_build/input_verified fields,
    and item 11's ERC part now reporting input_verified true.
    Add artifact-bound generic envelopes:
    - item 1 -> signoff/design-sources-inventory.md
    - item 2 -> layout/cells/rcosc_top.gds (replaces the klt extract citation)
    - item 9 -> signoff/testbench-invento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
2026-10-08 chore: resync installed Loom surfaces
    <!-- loom:provenance v1 build=unknown d2a55ce217b3ad1793611a2c54946676bb55b512 clean prompts=none sweep=none story=none trace=459637e4e8503593bdf58360865a7524 host=robb-pro base=a26bfa2907b771a1315ea45e929824134cdf2c22 run=loom-run/v1:timer:robb-pro/fleet-resync:95b3cf92-9cd9-4c36-8bbd-bdcace7c3874 installs=0.19.935 d347079cd0bad2db2c11ee4f0b760f04b2601d21 -->
    Loom-Trace-Id: 459637e4e8503593bdf58360865a7524
    Loom-Build: unknown d2a55ce217b3ad1793611a2c54946676bb55b512 clean
    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
2026-10-08 chore(signoff): move grader pin from klayout-tools 3a75c3ae to the 0.7.0 release
    Unchanged manifest graded identically under 0.7.0; envelope, manifest pin
    and report refreshed together.
    Loom-Story: 2AMLogic/gf180-rcosc#72
    Loom-Trace-Id: a5d381a5118002f15a334730fa40aec6
    Loom-Build: 0.19.868 ee904e1c151bc9cf15b0eb55dfe9d57ad6136cff clean
2026-10-08 docs(spec): DR-0019 statistical vs deterministic spec rows and Monte Carlo evidence plan (#71)
    Loom-Story: 2AMLogic/gf180-rcosc#71
    Loom-Trace-Id: 2e69cbb4fed5d2404e6fe67476c3f542
    Loom-Build: 0.19.898 3d55b9a1669c132d130d98f10a292c1325322c30 clean
2026-10-08 feat(sim): klt pex testbench inputs and single-corner probe for item 7 (#70)
    Part of #70. Full 27-point grid blocked: batch fleet runner klt 0.5.0 rejects every batch-capable client.
    Loom-Story: 2AMLogic/gf180-rcosc#70
    Loom-Trace-Id: 831dc6a997b77319f025b72d72bab529
    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
2026-10-08 docs: regenerate work plan against current forge state
2026-10-08 feat(sim): startup-time testbench for the 10 us row, partial evidence (#78)
    Adds sim/startup (klt sim corners requests reusing pvt_sweep corner
    definitions, post-processor), DR-0020 on the ambiguous trimmed-accuracy
    band, two single-corner probes, and the failed batch submissions. Row 10
    moves to partially evaluated; the 63-point factorial did not run (fleet
    runner klt 0.5.0 vs client 0.7.0). Signoff pins refreshed.
    Loom-Story: 2AMLogic/gf180-rcosc#78
    Loom-Trace-Id: b80ad920faf67a08106bc64ff44cdfec
    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
    [results.csv]
2026-10-09 feat(sim): item-6 Monte Carlo groundwork - mismatch-model feasibility verdict and per-sample trim-selection bench (#77)
    Verdict: gf180mcuC models expose local mismatch for MOS only; the design's
    ppolyf_u_1k resistors and cap_mim_1f0fF have no local mismatch term.
    Bench does per-die code search inside one session; zero-mismatch control and
    a 5-sample smoke run committed under sim/mc-groundwork/results/. No yield
    claim. Registered in signoff/testbench-inventory.md (envelope, manifest pin
    and report refreshed).
    Loom-Story: 2AMLogic/gf180-rcosc#77
    Loom-Trace-Id: 43bd678bbbf7f14d795eab8e73c43973
    Loom-Build: 0.19.868 ee904e1c151bc9cf15b0eb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
2026-10-09 feat(sim): runtime-discipline SOF loop model and trim-math note; DR-0021 (#79)
    Loom-Story: 2AMLogic/gf180-rcosc#79
    Loom-Trace-Id: f1f9639ff1999d4c59417d1bf71a44c8
    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
    [plant_checks.csv, results.csv, trace_ss_ext_cold_start.csv, trim_math.csv]
2026-10-09 ci(sim): append-only guard for sim/*/results (#84)
    Loom-Story: 2AMLogic/gf180-rcosc#84
    Loom-Trace-Id: c1bdddf0c79d9581a3dc23d74fac3379
    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
2026-10-09 docs: index DR-0020 and six un-indexed committed runs (#88)
    Loom-Story: 2AMLogic/gf180-rcosc#88
    Loom-Trace-Id: f93c4c0442279ad187431e2633b8b185
    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
2026-10-09 docs(spec): DR-0022 Monte Carlo matching model for trim-ladder resistors and MIM cap (#85)
    Loom-Story: 2AMLogic/gf180-rcosc#85
    Loom-Trace-Id: 2a4b6c722cf471397760ec63b03b5e36
    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
2026-10-09 docs(spec): place DR-0022 index row inside the table (#85)
    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
2026-10-09 docs(spec): DR-0022 measure monotonicity vs zero-mismatch baseline; cite DR-0021 (#85)
    Address Judge review on PR #94:
    - Monotonicity measured as step deviation from the 0x run; predictions
    restricted to transitions monotone at 0x (DR-0021 carries incl. 0x7F->0x80).
    - Injected-term sensitivity control passes on the ~10x step-sigma ratio,
    not on a nonzero non-monotonic fraction.
    - State the ideal-ladder assumption, add DR-0021 to Context, restate the
    ladder sigma at the realized 0.41-0.47 %/code (0.054-0.061 %).
    Loom-Build: 0.19.898 3d55b9a1669c132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
2026-10-09 chore: resync installed Loom surfaces
    <!-- loom:provenance v1 build=unknown 05dba463c5b293d38f0ca071725983862498b3f3 clean prompts=none sweep=none story=none trace=14298316053024bcf5120bff695771ab host=robb-pro base=15c0975e2e8404457999b6e2d944d43ed3917d8e run=loom-run/v1:timer:robb-pro/fleet-resync:2f384483-6d77-4ba2-9888-aa1e4b5be36c installs=0.19.953 b93d7a955d63411cb4c94b986fd5138d27dedb0f -->
    Loom-Trace-Id: 14298316053024bcf5120bff695771ab
    Loom-Build: unknown 05dba463c5b293d38f0ca071725983862498b3f3 clean
    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
2026-10-09 feat(signoff): doc-citation check for sim/ run dirs (#93)
    Loom-Story: 2AMLogic/gf180-rcosc#93
    Loom-Trace-Id: d7b7a30c6d5b176d302136592ff7f1fd
    Loom-Build: 0.19.950 72047016af9d66c08f900bb94c642a66dfd75fc5 clean
2026-10-09 chore: resync installed Loom surfaces
    <!-- loom:provenance v1 build=unknown 7f06b288b150f2fe0a4b24c331a9b3ec093d709d clean prompts=none sweep=none story=none trace=a90c217ff3a3bd9e3a30282b8cadc24d host=robb-pro base=1583e48d4105a6bd0d125cee76e9dfe77d2a41f4 run=loom-run/v1:timer:robb-pro/fleet-resync:6e5ec9f3-d6ef-4953-80f7-c93035e2d359 installs=0.19.967 cc9c6cf61d1aebc3153cd1588ca304445a6b9ced -->
    Loom-Trace-Id: a90c217ff3a3bd9e3a30282b8cadc24d
    Loom-Build: unknown 7f06b288b150f2fe0a4b24c331a9b3ec093d709d clean
    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
2026-10-09 docs: refresh activity log and current work plan
2026-10-09 feat(waveform): offline clk waveform-shape bench, request generator and analyzer (#91)
    Adds sim/waveform: prepare.py (27-point tt/ss/ff grid, calibration-source
    validation, provenance), analyze.py (pulse width, duty, rise/fall, period
    and cycle-to-cycle statistics with explicit failure modes), synthetic
    fixture tests, README and a discipline README cross-reference. No simulator
    or cloud operation; no measured evidence.
    Loom-Story: 2AMLogic/gf180-rcosc#91
    Loom-Trace-Id: 8f5117d9bd170d073e010eb0e662c2d3
    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
2026-10-09 ci: run offline waveform fixture suite (#101)
    Loom-Story: 2AMLogic/gf180-rcosc#101
    Loom-Trace-Id: 68bc0dc3dfc5d03c55315345f503f67e
    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
2026-10-09 sim: live trim-code transition bench (generator, analyzer, offline tests, CI) (#103)
    Part of the issue's deliverables; nine-corner results pending (batch runner
    version mismatch, see sim/trim-transition/README.md).
    Loom-Story: 2AMLogic/gf180-rcosc#103
    Loom-Trace-Id: c1be2be577b7f172d5fd79e21b142283
    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
    [results.csv]
2026-10-09 sim/trim-transition: rename probe results dir to bare timestamp
    Rename results/20261009T152100Z-probe-tt-v33-lsb-first/ to
    results/20261009T152100Z/ to match the bare-<ts> run-dir convention used
    by every other bench, so the doc-citations checker resolves the README
    citation. The probe label stays in the README. Refs #103.
    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
    [results.csv]
2026-10-09 sim/supply-transient: offline supply-step and ripple bench (generator, analyzer, synthetic tests, CI) (#92)
    Loom-Story: 2AMLogic/gf180-rcosc#92
    Loom-Trace-Id: 7787d39550790413b0e9f89aafaff07f
    Loom-Build: 0.19.972 113c7f31d7d16f75d30c470023e0b65b29b1fe94 clean
2026-10-09 chore: resync installed Loom surfaces
    <!-- loom:provenance v1 build=unknown 30c7a7ee2f74a6a2b5bb0f19fd9f049ec8ae8b5c clean prompts=none sweep=none story=none trace=7bc5ba399ff199d049d83d711920a157 host=robb-pro base=ab95b8394574ee5058735218f2a0327b7d5f0376 run=loom-run/v1:timer:robb-pro/fleet-resync:8e237160-c4d0-4ce3-85ac-c96aff5cf221 installs=0.19.982 2bc4cba624b9053535663441e6f0daf08a7acf2e -->
    Loom-Trace-Id: 7bc5ba399ff199d049d83d711920a157
    Loom-Build: unknown 30c7a7ee2f74a6a2b5bb0f19fd9f049ec8ae8b5c clean
    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
2026-10-10 chore: resync installed Loom surfaces
    <!-- loom:provenance v1 build=unknown a7d2b01d8eb7d09e597a4638e5cb3cdd8bab9156 clean prompts=none sweep=none story=none trace=35c1337ee84607e87ba2038523d63198 host=robb-pro base=ce60f93ac2535e3dfde33ec3e94861ed01b7c340 run=loom-run/v1:timer:robb-pro/fleet-resync:6bf32a81-6c4a-48c5-a51e-1ad65c6bedfd installs=0.19.1001 1c1131220b2f5950fe54b7cd02ebd3f1aae488dd -->
    Loom-Trace-Id: 35c1337ee84607e87ba2038523d63198
    Loom-Build: unknown a7d2b01d8eb7d09e597a4638e5cb3cdd8bab9156 clean
    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
2026-10-10 feat(sim): offline trim-pin DC selection and static-current harness (#106)
    Generator, analyzer, synthetic tests, README and CI for the trim-interface
    characterization. No simulation run; no design/spec/result changes.
    Loom-Story: 2AMLogic/gf180-rcosc#106
    Loom-Trace-Id: e3132f28304c8f0fd6f4e71f570c104b
    Loom-Build: 0.19.996 0d2be7e9ae05753e2c9232a83b7399d45de5396e clean
2026-10-10 ci: offline netlist consistency guard for pvt_tb, rcosc_top and bench DUT copies (#107)
    Loom-Story: 2AMLogic/gf180-rcosc#107
    Loom-Trace-Id: 87f0107c276732c820ed058872536a6c
    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
2026-10-10 docs: refresh work log and current queue plan
2026-10-10 test(sim): offline unit tests + CI for legacy driver analysis cores (#121)
    Loom-Story: 2AMLogic/gf180-rcosc#121
    Loom-Trace-Id: 5e70392039348a940f15e8dad7b63427
    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
2026-10-10 test(discipline): offline regression tests and CI job for DR-0021 model (#120)
    Loom-Story: 2AMLogic/gf180-rcosc#120
    Loom-Trace-Id: 3843b4cd93b4ad0ea628fbdb1bf5ba47
    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
2026-10-10 feat(waveform): offline clk output-load sensitivity sweep and comparison (#122)
    Loom-Story: 2AMLogic/gf180-rcosc#122
    Loom-Trace-Id: 60cd02a957c631029ae7ac6883fcb51c
    Loom-Build: 0.19.1009 8889f7bd1eccfb4bc8239e7f5669b65f9815c30e clean
2026-10-10 feat(sim): offline interior-temperature curvature harness (#125)
    Prepare (but do not run) a 36-point fixed-code campaign that measures
    frequency-vs-temperature curvature between the -40/27/85 C grid points.
    - sim/temperature/prepare.py: tt/ss/ff x 12 temperatures
    (-40..85 C incl. 27 C) x 3.3 V, zero added clk load, as three
    process-specific klt sim requests of 12 corners. Requires explicit
    --cal-run sim/pvt/results/20260923T030125Z, ratified 48 MHz target,
    held codes tt 0xA3 / ss 0xCD / ff 0x59; reuses sim/waveform/prepare.py's
    validated calibration loader, DUT extraction, bench and request builders.
    Manifest maps all 36 corners to code, calibration, target, settings and
    gener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
2026-10-10 chore: resync installed Loom surfaces
    <!-- loom:provenance v1 build=unknown c156f673e072832aaacb4cd1ec65b742e7f45867 clean prompts=none sweep=none story=none trace=9de99c124c651049199abe9a75070dc7 host=robb-pro base=347774515663c85288b77ad4a2b3a7e25701a33c run=loom-run/v1:timer:robb-pro/fleet-resync:f790885c-7154-4b3d-acd9-71fd537cd20b installs=0.19.1010 d1d5fcecb79550fe39658555a4419f98cec060fb -->
    Loom-Trace-Id: 9de99c124c651049199abe9a75070dc7
    Loom-Build: unknown c156f673e072832aaacb4cd1ec65b742e7f45867 clean
    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
2026-10-10 chore: resync installed Loom surfaces
    <!-- loom:provenance v1 build=unknown 52f79668bb5f93c1828b7f1ea4f7013b917b847b clean prompts=none sweep=none story=none trace=7057f3175071f1f6e34b354fab40a0ce host=robb-studio base=9068bc19b8248dc5a3e2f59a26fff63a11b9931d run=loom-run/v1:timer:robb-studio/fleet-resync:d8918779-1625-4202-b151-71f64465e8cd installs=0.19.1010 d1d5fcecb79550fe39658555a4419f98cec060fb -->
    Loom-Trace-Id: 7057f3175071f1f6e34b354fab40a0ce
    Loom-Build: unknown 52f79668bb5f93c1828b7f1ea4f7013b917b847b clean
    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
2026-10-10 feat(sim): model SOF reference loss and reacquisition offline (#128)
    Loom-Story: 2AMLogic/gf180-rcosc#128
    Loom-Trace-Id: 5bce77d44361810e8c150e8c0bf8a711
    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
    [outage_results.csv]
2026-10-10 fix(signoff): register discipline run 20261010T120000Z as a citation probe (#128)
    The SOF reference-loss run is a single-purpose extension of the DR-0021
    loop model; the cold-start evidence of record stays 20261009T010000Z.
    Mirrors the pvt-postlayout probe convention.
    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
2026-10-10 feat(sim): add offline DR-0022 mismatch-injection generator (#135)
    Loom-Story: 2AMLogic/gf180-rcosc#135
    Loom-Trace-Id: b77d61380a2db9eb7c21ab207c9e27e4
    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
2026-10-10 fix(sim): fail loudly on case/continuation gaps in mismatch injector (#135)
    Address Judge review on PR #137:
    - m=1 rewrite is case-insensitive (re.subn, re.I) and raises
    UnmappedCardError unless exactly one substitution happened, so the
    manifest can never list an instance whose card was not rewritten.
    - Covered model names (ppolyf_u_1k / cap_mim_1f0fF) are matched
    case-insensitively; the real-netlist coverage regex is re.I too.
    - A covered model named on a '+' continuation line now raises instead
    of being skipped (the old startswith("+") guard was dead code);
    excluded instances are still allowed.
    - Tests for M=1, double m=1, uppercase models, and continuation lines.
    Co-Authored-By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
2026-10-10 refactor(sim): share path-based module loader across request generators (#130)
    Loom-Story: 2AMLogic/gf180-rcosc#130
    Loom-Trace-Id: d3066988fea0fd9425e85bec604e35e7
    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
2026-10-10 ci: run sim/test_module_loader.py in a module-loader offline workflow (#130)
    Adds .github/workflows/module-loader-offline.yml following the existing
    offline-suite convention (python3 -I -m pytest -p no:cacheprovider), so
    signoff/verify-test-coverage.py (#134) finds the new test. Like every other
    workflow here it has no paths: filter, so it and the four dependent
    generator suites already re-run on every PR touching sim/_module_loader.py.
    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
2026-10-10 ci: consolidate five offline pytest workflows into one matrix workflow (#119)
    Loom-Story: 2AMLogic/gf180-rcosc#119
    Loom-Trace-Id: 25b4eb54c048f62cd9959c279b7e5ee1
    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
2026-10-10 chore: resync installed Loom surfaces
    <!-- loom:provenance v1 build=unknown 525fe43b7b1b2a0271084bba444c934a1541a8d8 clean prompts=none sweep=none story=none trace=0d4424bd058cf912b74934ec0e7bf37e host=robb-pro base=e7bc068a6160d4f81381d5f3e1834e83b1a999f1 run=loom-run/v1:timer:robb-pro/fleet-resync:4812047c-8b9b-4da2-a5dc-13e6f6420a04 installs=0.19.1018 13e54f1cfc513507a7ef84ec6908085638d9c187 -->
    Loom-Trace-Id: 0d4424bd058cf912b74934ec0e7bf37e
    Loom-Build: unknown 525fe43b7b1b2a0271084bba444c934a1541a8d8 clean
    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
2026-10-10 ci: align netlist-consistency action pins to v7 and split pytest install (#140)
    Bump actions/checkout v4 -> v7 and actions/setup-python v5 -> v7 to match
    the sibling workflows, keep fetch-depth: 0, and move the pytest install into
    its own 'Install pytest' step. What is tested is unchanged.
    Loom-Story: 2AMLogic/gf180-rcosc#140
    Loom-Trace-Id: f64dae7ca0d31077c669f45e0e61317b
    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
2026-10-10 docs: refresh work log and current backlog plan
2026-10-10 chore: resync installed Loom surfaces
    <!-- loom:provenance v1 build=unknown 525fe43b7b1b2a0271084bba444c934a1541a8d8 clean prompts=none sweep=none story=none trace=d4059def94f46d8d158946acddd4d602 host=robb-studio base=a1359ec893ace46efb85d1f69a7db0cfe50e6dc4 run=loom-run/v1:timer:robb-studio/fleet-resync:4a4d1995-968e-44c5-b5fe-804b4d477795 installs=0.19.1019 febfc4335d0554865fadbecba718245cd88c6678 -->
    Loom-Trace-Id: d4059def94f46d8d158946acddd4d602
    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
2026-10-10 feat(sim): record PDK revision in campaign manifests via shared helper (#65)
    Loom-Story: 2AMLogic/gf180-rcosc#65
    Loom-Trace-Id: ea7a576707aa2d5db835a41528b0bdfe
    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
2026-10-10 fix(sim): append-only guard fails when git comparison fails (#146)
    Loom-Story: 2AMLogic/gf180-rcosc#146
    Loom-Trace-Id: 56dc9a95ee00aebf615e39207c92c99c
    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
2026-10-10 docs(readme): reconcile accuracy summary and ST comparison with DR-0017 (#143)
    The explanatory paragraph under the spec table still quoted DR-0003's
    ~±1% / ~±8-9% figures and listed supply drift as an assumption. Restate
    the DR-0017 budgets with their conditions (27 °C, 3.0-3.6 V: -2.9%/+2.0%;
    -40..+85 °C, same supply: -10.8%/+8.8%), link DR-0017 as the current
    derivation, keep DR-0003 as background, and separate the measured supply
    span from the still-flagged trim-DAC mismatch and comparator offset
    assumptions. Fix the reversed ACC_HSI48 comparison in the calibration row.
    Closes #143
    Loom-Story: 2AMLogic/gf180-rcosc#143
    Loom-Trac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
2026-10-10 chore: resync installed Loom surfaces
    <!-- loom:provenance v1 build=unknown 5d5f41d89eef35adf478b92b96af06c6d86d27a6 clean prompts=none sweep=none story=none trace=05d2a40831b35ba1c48afada00c29519 host=robb-pro base=3462e2c40589b8dcc3fb1a08d9214badcd57b9c3 run=loom-run/v1:timer:robb-pro/fleet-resync:c58bb82e-a213-439d-b829-04234e141de9 installs=0.19.1029 eeede923872426614b8def90ca3cf6fd0a4ba07e -->
    Loom-Trace-Id: 05d2a40831b35ba1c48afada00c29519
    Loom-Build: unknown 5d5f41d89eef35adf478b92b96af06c6d86d27a6 clean
    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
2026-10-10 fix(sim): default legacy sweep --jobs to 2 via shared DEFAULT_JOBS (#139)
    Loom-Story: 2AMLogic/gf180-rcosc#139
    Loom-Trace-Id: 241b20b2e8c9218f7405d545f1eb9f86
    Loom-Build: 0.19.1026 09a449709f5a1c6ae81b471ef56d466247e50808 clean
2026-10-10 chore: resync installed Loom surfaces
    <!-- loom:provenance v1 build=unknown aa536103d6239818bb974a51d2f7f268eff38bad clean prompts=none sweep=none story=none trace=126a1328a3664e2119a0978086db9bea host=robb-studio base=1d691ac35ddb862a75f082c58d66980e98b50004 run=loom-run/v1:timer:robb-studio/fleet-resync:fbc4e361-e290-4d81-ae3a-8b5fde796815 installs=0.19.1032 13ca937a7d6ba8768c296b0c126f2ce48f5f7ca4 -->
    Loom-Trace-Id: 126a1328a3664e2119a0978086db9bea
    Loom-Build: unknown aa536103d6239818bb974a51d2f7f268eff38bad clean
    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
2026-10-11 refactor(sim): route analyzer/test loaders through _module_loader (#155)
    Loom-Story: 2AMLogic/gf180-rcosc#155
    Loom-Trace-Id: 4030cf548b7574e43926ac3d66bc1179
    Loom-Build: 0.19.1039 e83d19dc0a9b217339ea2f14040c50ad6f46700d clean
2026-10-11 design(sim): attribute extracted slow-down and propose re-centred trim ladder (DR-0023, proposed) (#66)
    Attribution of the 18.8-36.9 % extracted slow-down (93 serial single-corner
    runs), proposed sizing P3 (trim-ladder R x0.70, MiM unchanged) with range,
    calibration and T/V-extreme probes under two substrate models, and the 27-point
    klt sim requests. The batch submission failed (runner klt 0.5.0 vs client 0.7.0,
    klayout-tools#2851); no 27-point result is claimed.
    Part of #66
    Loom-Story: 2AMLogic/gf180-rcosc#66
    Loom-Trace-Id: 14fd3a5a0a1057e9ff2e44a8bb9a88e0
    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
2026-10-11 fix(sim/recentre): flat results/<ts> layout, corner in raw-log names, re-run collided points (#66)
    Address the PR #158 Judge review.
    1. doc-citations: flatten sim/recentre/results/{attribution,p3-27pt,
    explore/<ts>-<mode>,summary}/<ts> (all new in this PR) to the repo-wide
    sim/<bench>/results/<ts>/ layout the verifier resolves; update the
    drivers, README, DR-0023 and the batch-record summary. The mode stays
    in results.csv / command.txt; raw logs stay in corners/.
    signoff/verify-doc-citations.py now passes.
    2. Raw-log collisions: explore.py now names logs
    <cand>_<mode>_<proc>_<T>C_<V>V_0x<code>.log and pexlib.run refuses to
    overwrite a log. The 27 rows (of 44, in 6 poin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
2026-10-11 chore: resync installed Loom surfaces
    <!-- loom:provenance v1 build=unknown cf08873555e2eb95da295dcbee98b0dc34473381 clean prompts=none sweep=none story=none trace=67fbc483c3ca3e442d7928804c11ff06 host=robb-pro base=bf5a01ccba253080a5bccf10806dc70ad364ce9f run=loom-run/v1:timer:robb-pro/fleet-resync:e3f97888-2b26-404a-bd47-86fd28a4eced installs=0.19.1041 b65c266b47d796bf37d1c04c6f616be0bc699056 -->
    Loom-Trace-Id: 67fbc483c3ca3e442d7928804c11ff06
    Loom-Build: unknown cf08873555e2eb95da295dcbee98b0dc34473381 clean
    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
2026-10-11 chore: resync installed Loom surfaces
    <!-- loom:provenance v1 build=unknown e91831edf7b55b29d3a2d88e266916fab9ce2563 clean prompts=none sweep=none story=none trace=f72dd67520a2c3802aa0495b80ac65a5 host=robb-studio base=791fc379abe794f210a2dc2bac5c6f092b46402b run=loom-run/v1:timer:robb-studio/fleet-resync:91d2434e-eae5-45de-9305-d78c43fc7c7a installs=0.19.1043 1f414afc0388fba3ddd4b792d653b22230c33389 -->
    Loom-Trace-Id: f72dd67520a2c3802aa0495b80ac65a5
    Loom-Build: unknown e91831edf7b55b29d3a2d88e266916fab9ce2563 clean
    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
2026-10-11 test: add offline regression suite for guard scratch-protection denials
    Cover the two installed destructive-guard scratch-work decisions from
    issue #150 — rm-scope-unresolved-var (recursive removal rooted at an
    unexpanded variable) and stash-scope:create-redirect (raw stash create
    from a linked managed issue-N worktree) — with a standalone suite that
    invokes the real staged guard with PreToolUse JSON, asserts decision,
    schema, and telemetry records, proves state preservation and
    non-execution via before/after digests and a canary, and includes
    worktree-scoped and read-only allow controls. Pins the two new
    repo-owned paths in .loom/resync-ignore (#7995 disposition).
    Closes #150
    Loom-Sto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
2026-10-11 chore: resync installed Loom surfaces
    <!-- loom:provenance v1 build=unknown 5ec729b9f7dd55a2082752611e4c4964f49661fb clean prompts=none sweep=none story=none trace=efc2abc8b72538df6d1a6ea9d329603d host=robb-pro base=e1b112051298bb059870df138d5c1b58d2888ae1 run=loom-run/v1:timer:robb-pro/fleet-resync:0d396c06-f26e-423e-97ac-6d3ac04a8e51 installs=0.19.1056 4e44d8f5faa6c6c58d2a3436ce3a983613cf375a -->
    Loom-Trace-Id: efc2abc8b72538df6d1a6ea9d329603d
    Loom-Build: unknown 5ec729b9f7dd55a2082752611e4c4964f49661fb clean
    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
2026-10-11 chore: resync installed Loom surfaces
    <!-- loom:provenance v1 build=unknown 745f69d0daad6c23e76cc006720fa4fbeaa3d887 clean prompts=none sweep=none story=none trace=3baabc4a039fd85029fff227a6ae690a host=robb-studio base=d4314c78f516378f45e2200d6cd970331be223b2 run=loom-run/v1:timer:robb-studio/fleet-resync:3b3207d7-055d-49b5-a387-db375213668d installs=0.19.1061 5f9bd7c9c14c4557db7de006b6e0cd318ba7e72d -->
    Loom-Trace-Id: 3baabc4a039fd85029fff227a6ae690a
    Loom-Build: unknown 745f69d0daad6c23e76cc006720fa4fbeaa3d887 clean
    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
2026-10-11 ci: never cancel a started signoff run (cancel-in-progress: false)
    Refresh item-10 evidence (envelope, manifest pin, report) and add a
    workflow configuration check to signoff/verify-report.py.
    Loom-Story: 2AMLogic/gf180-rcosc#153
    Loom-Trace-Id: 0570c84660d33e3e9295c2bb9c20f057
    Loom-Build: 0.19.1055 4737928b703aa8a4c87d04eefbf7299fb933eab4 clean
2026-10-11 docs: correct per-run open_pdks record and 'pinned grader' wording (#68)
    Loom-Story: 2AMLogic/gf180-rcosc#68
    Loom-Trace-Id: 694ce86ad80cbc6c7ba6e46b4ecda810
    Loom-Build: 0.19.1065 33bb950d65b9038d5cf119a252820edca1192edf clean
2026-10-11 signoff: reject duplicate item keys in grade_drift (#163)
    Loom-Story: 2AMLogic/gf180-rcosc#163
    Loom-Trace-Id: c8a5b322243662bf2c7901ca94f4fb40
    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
2026-10-11 sim/trim-dense: offline dense trim-code batch request generator and step analyzer (#98)
    Offline preparation only: request emission for codes 0..255 per variant and
    corner, validated report analysis with synthetic fixtures. No simulation run.
    Loom-Story: 2AMLogic/gf180-rcosc#98
    Loom-Trace-Id: 83065ffd6582445fe1b1c6fc0a578f6e
    Loom-Build: 0.19.1068 fcc4454e112d13e088464bb0a178b75c0dc96c0f clean
2026-10-11 ci: run sim/trim-dense offline suite in offline-suites workflow (#98)
    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
2026-10-11 signoff: offline negative fixtures for artifact provenance and binding guards (#165)
    Loom-Story: 2AMLogic/gf180-rcosc#165
    Loom-Trace-Id: f33f2ea4144e2a636bf97723023bf157
    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
2026-10-11 docs: refresh work log and current queue
2026-10-11 chore: resync installed Loom surfaces
    <!-- loom:provenance v1 build=unknown b37a005ac1889262fb9e5338f7cff4e9ed4987da clean prompts=none sweep=none story=none trace=25c158d7e9591610b251780caaff1c5f host=robb-pro base=f1f12441fdad3442258e896b26187d1c997ed142 run=loom-run/v1:timer:robb-pro/fleet-resync:7f020bca-6920-47f7-a5e4-bbd5c82d9bb8 installs=0.19.1072 29b48db1ead9c4501304e0114a5c33310e1d589f -->
    Loom-Trace-Id: 25c158d7e9591610b251780caaff1c5f
    Loom-Build: unknown b37a005ac1889262fb9e5338f7cff4e9ed4987da clean
    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
2026-10-11 chore: resync installed Loom surfaces
    <!-- loom:provenance v1 build=unknown 81a6b4499cb57b3620785bc1625c300da34f0735 clean prompts=none sweep=none story=none trace=d08bbd290651d7bcbda8b216c0dfbcdf host=robb-studio base=f0fce82b74a5563390d455b573bd325195347173 run=loom-run/v1:timer:robb-studio/fleet-resync:71e05e3d-931c-46b4-b6d2-5f3f992c1e19 installs=0.19.1074 3f77416f918ffc23fb54dccf18d864073f99b142 -->
    Loom-Trace-Id: d08bbd290651d7bcbda8b216c0dfbcdf
    Loom-Build: unknown 81a6b4499cb57b3620785bc1625c300da34f0735 clean
    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
2026-10-12 chore: resync installed Loom surfaces
    <!-- loom:provenance v1 build=unknown ddfb67ccf9a5115d62dd86924613a468b9328f44 clean prompts=none sweep=none story=none trace=772605234b9d8cafd6a4049200f7425c host=robb-pro base=461228fcd7fbd17318d53a3f87784c6bb821d434 run=loom-run/v1:timer:robb-pro/fleet-resync:1ef28ffc-0277-424f-9224-7ee6eca46377 installs=0.19.1083 77a174ea7fcaddbb25d0082956cd25d8633fc2df -->
    Loom-Trace-Id: 772605234b9d8cafd6a4049200f7425c
    Loom-Build: unknown ddfb67ccf9a5115d62dd86924613a468b9328f44 clean
    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
2026-10-12 chore: resync installed Loom surfaces
    <!-- loom:provenance v1 build=unknown be358990895362019614bd207bcbe36bc9eeff2c clean prompts=none sweep=none story=none trace=f1dc643b95859c8f26e892ddb5e2c5d7 host=robb-studio base=26040e21f92a5bcc88795350b117d7c1e33204b7 run=loom-run/v1:timer:robb-studio/fleet-resync:da486ca2-3e94-4a85-abd3-88707942489a installs=0.19.1087 51ac271f990b317a52ebf27cc21f34561e1179fb -->
    Loom-Trace-Id: f1dc643b95859c8f26e892ddb5e2c5d7
    Loom-Build: unknown be358990895362019614bd207bcbe36bc9eeff2c clean
    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
2026-10-12 chore: resync installed Loom surfaces
    <!-- loom:provenance v1 build=unknown a579728c137cc11d08a48b178e0ff9aa21683e72 clean prompts=none sweep=none story=none trace=10832f2750dbcd63f6c6f301a6f4da9b host=loom-worker-2 base=85cd73297d0341f0de7b49b67e5b9666277ce133 run=loom-run/v1:timer:loom-worker-2/fleet-resync:180f6d5054f0479ab3990b86ab4522a5 installs=0.19.1087 51ac271f990b317a52ebf27cc21f34561e1179fb -->
    Loom-Trace-Id: 10832f2750dbcd63f6c6f301a6f4da9b
    Loom-Build: unknown a579728c137cc11d08a48b178e0ff9aa21683e72 clean
    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
2026-10-12 chore: resync installed Loom surfaces
    <!-- loom:provenance v1 build=unknown 02ecafe7734bf5faa945ce88940589f00eca78e9 clean prompts=none sweep=none story=none trace=5f71c537126994dc4c45179122427514 host=robb-pro base=dc853c800b15d2087ae554bc9543ea082d86e59c run=loom-run/v1:timer:robb-pro/fleet-resync:6293e6da-8a67-45aa-b277-c9ef85ddb810 installs=0.19.1102 c27d15b77f4cde3ec9ccad2d751107eee9c55a04 -->
    Loom-Trace-Id: 5f71c537126994dc4c45179122427514
    Loom-Build: unknown 02ecafe7734bf5faa945ce88940589f00eca78e9 clean
    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
2026-10-12 chore: resync installed Loom surfaces
    <!-- loom:provenance v1 build=unknown 5918da96dcd60c9a677a195737c86ea38972d215 clean prompts=none sweep=none story=none trace=49bb7a8942d6a23bf41754ca27ff2368 host=loom-worker-2 base=700954fe4300f7759f082f99aba079bd9da2359d run=loom-run/v1:timer:loom-worker-2/fleet-resync:2e973f04abd1447d8ee4b696c2e7d2b4 installs=0.19.1108 72427939d156341080a7006ae6fbb5ec96b2368e -->
    Loom-Trace-Id: 49bb7a8942d6a23bf41754ca27ff2368
    Loom-Build: unknown 5918da96dcd60c9a677a195737c86ea38972d215 clean
    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
2026-10-12 chore: resync installed Loom surfaces
    <!-- loom:provenance v1 build=unknown 01467247f32c59822968bf02d3214d9a3d613452 clean prompts=none sweep=none story=none trace=0e97e9733eef09a33959cf96e6271f40 host=robb-studio base=a334018a96d321bbb97e4994dc1a4d8be711b8fd run=loom-run/v1:timer:robb-studio/fleet-resync:53a4d390-3842-4216-9018-5dced9d0ea17 installs=0.19.1109 d9498fcd419776b2517e30b99c88e76bbe92d2f4 -->
    Loom-Trace-Id: 0e97e9733eef09a33959cf96e6271f40
    Loom-Build: unknown 01467247f32c59822968bf02d3214d9a3d613452 clean
    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
2026-10-12 chore: resync installed Loom surfaces
    <!-- loom:provenance v1 build=unknown acadc2b4b0e852f2d889ac9dec616e1548705802 clean prompts=none sweep=none story=none trace=a69edb348af7f0e67b3bc77bc33b1bfc host=loom-worker-2 base=50a90e70287433c68039bbd346c0dbddb71a129e run=loom-run/v1:timer:loom-worker-2/fleet-resync:0923627ffda84cf69ec2486475772b10 installs=0.19.1126 7736d1276b6d01778fba3461114c858ef1bf5e2d -->
    Loom-Trace-Id: a69edb348af7f0e67b3bc77bc33b1bfc
    Loom-Build: unknown acadc2b4b0e852f2d889ac9dec616e1548705802 clean
    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
2026-10-12 chore: resync installed Loom surfaces
    <!-- loom:provenance v1 build=unknown 8d832cc8035d4ba07872510416468da0790332cd clean prompts=none sweep=none story=none trace=09a53bf60e96fc30a753caffd1de8c92 host=robb-studio base=63fccef3e884506852d74c5e45e30e81484e8649 run=loom-run/v1:timer:robb-studio/fleet-resync:baf4c30c-65d9-4d4e-a740-f6a80cbb975c installs=0.19.1134 6bde81b9a2c0b5d36d10ba4cedb6a3bb0a564100 -->
    Loom-Trace-Id: 09a53bf60e96fc30a753caffd1de8c92
    Loom-Build: unknown 8d832cc8035d4ba07872510416468da0790332cd clean
    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
2026-10-12 chore: resync installed Loom surfaces
    <!-- loom:provenance v1 build=unknown aa1ed0d7d5499d2705977d971673d919dbbbaf4e clean prompts=none sweep=none story=none trace=2522608826ef5d5e4a88a9667055aeb7 host=loom-worker-2 base=b9715ab0f5f1f4cc476c2430d60d4f583c2b7c66 run=loom-run/v1:timer:loom-worker-2/fleet-resync:8f26b719c712455381744111c50e90b4 installs=0.19.1142 b91ae5d1b5204f499a1abb875a6cf5bffc1d90b1 -->
    Loom-Trace-Id: 2522608826ef5d5e4a88a9667055aeb7
    Loom-Build: unknown aa1ed0d7d5499d2705977d971673d919dbbbaf4e clean
    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
2026-10-12 chore: resync installed Loom surfaces
    <!-- loom:provenance v1 build=unknown 8b64614d017d6ce7491c3a2ac9da51e5e2901c97 clean prompts=none sweep=none story=none trace=66044c049ba635bcd6a4797c3a77e84b host=robb-pro base=222b0ea8f2268d171f90a6a10d9ec2a9902e4ac4 run=loom-run/v1:timer:robb-pro/fleet-resync:68f56594-05d0-4cc0-9c07-36263359d698 installs=0.19.1144 9e4381cbbd2386393e44c7a979583252948a3998 -->
    Loom-Trace-Id: 66044c049ba635bcd6a4797c3a77e84b
    Loom-Build: unknown 8b64614d017d6ce7491c3a2ac9da51e5e2901c97 clean
    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
2026-10-13 chore: resync installed Loom surfaces
    <!-- loom:provenance v1 build=unknown e66f00108a9519331aa981da8a01c6569ca623a9 clean prompts=none sweep=none story=none trace=d3e476cf8c03d5ed37f8e146b3632190 host=robb-studio base=cb8b6ec2ea2164ec5fe3d4238b52c527b5b205f3 run=loom-run/v1:timer:robb-studio/fleet-resync:1d7ace45-2daf-4c92-a752-67b11e982245 installs=0.19.1148 1448fdfa79ac2dcab7fad6b95b72697b450f2a4a -->
    Loom-Trace-Id: d3e476cf8c03d5ed37f8e146b3632190
    Loom-Build: unknown e66f00108a9519331aa981da8a01c6569ca623a9 clean
    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
2026-10-13 chore: resync installed Loom surfaces
    <!-- loom:provenance v1 build=unknown 98d08ab78cc223361354ee9947d996b1cb914b30 clean prompts=none sweep=none story=none trace=8b73addcdeaa8fbd65998649f42a8c50 host=loom-worker-2 base=be9f4b04d67cc3f64aefb46534df289738419f3d run=loom-run/v1:timer:loom-worker-2/fleet-resync:3bfb13d52fca425f9cfced4541954cb6 installs=0.19.1148 1448fdfa79ac2dcab7fad6b95b72697b450f2a4a -->
    Loom-Trace-Id: 8b73addcdeaa8fbd65998649f42a8c50
    Loom-Build: unknown 98d08ab78cc223361354ee9947d996b1cb914b30 clean
    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
2026-10-13 chore: resync installed Loom surfaces
    <!-- loom:provenance v1 build=unknown d0bfbbc7ac309581d7abe02c4a269c7704010ee0 clean prompts=none sweep=none story=none trace=0ad6d167235000f3b5648cbd63d761ce host=robb-pro base=cc7c90e0a1bc8f862623275cfaaecd84ae65030d run=loom-run/v1:timer:robb-pro/fleet-resync:4f7cbe22-40b6-49ff-8811-003ae8577c28 installs=0.19.1151 021b947d121929157cd83df0576e7f2aa12500d7 -->
    Loom-Trace-Id: 0ad6d167235000f3b5648cbd63d761ce
    Loom-Build: unknown d0bfbbc7ac309581d7abe02c4a269c7704010ee0 clean
    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
2026-10-13 chore: resync installed Loom surfaces
    <!-- loom:provenance v1 build=unknown 7916c4043a1b57e97a53bc5c111e74c5038a1091 clean prompts=none sweep=none story=none trace=20b27ffb08c4130dc9836ee8d9d97b97 host=loom-worker-2 base=56caafb8dcf40e66a8fa4f6fbd23d1bdbf6b97e0 run=loom-run/v1:timer:loom-worker-2/fleet-resync:d34532ec625a4162ae8b58dde1a6738f installs=0.19.1151 f7d1deaab02a9c483fce1ced33fadb1af6d86f59 -->
    Loom-Trace-Id: 20b27ffb08c4130dc9836ee8d9d97b97
    Loom-Build: unknown 7916c4043a1b57e97a53bc5c111e74c5038a1091 clean
    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
2026-10-13 chore: resync installed Loom surfaces
    <!-- loom:provenance v1 build=unknown ac0bbcf6eda99918e88a0b8893d9762b106a2e45 clean prompts=none sweep=none story=none trace=8597ab8a51d68f9f8ee864fa71904bff host=robb-studio base=37ba949873e63860f4b1df79c9da9b1d7735f1a9 run=loom-run/v1:timer:robb-studio/fleet-resync:2ea9dd71-a6b2-4d0c-86aa-859a0728c9b3 installs=0.19.1151 f7d1deaab02a9c483fce1ced33fadb1af6d86f59 -->
    Loom-Trace-Id: 8597ab8a51d68f9f8ee864fa71904bff
    Loom-Build: unknown ac0bbcf6eda99918e88a0b8893d9762b106a2e45 clean
    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
2026-10-13 chore: resync installed Loom surfaces
    <!-- loom:provenance v1 build=unknown 7916c4043a1b57e97a53bc5c111e74c5038a1091 clean prompts=none sweep=none story=none trace=773e9e41a5730d2f79f2381ad2cde068 host=robb-pro base=23c0b7172b3bc7f1ee6abc523d7d78a41712af5f run=loom-run/v1:timer:robb-pro/fleet-resync:b7ca0d34-434e-4536-85b9-57adfa603a8d installs=0.19.1151 1ec34f9bb79942506958a3c18a31368f4e065508 -->
    Loom-Trace-Id: 773e9e41a5730d2f79f2381ad2cde068
    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
2026-10-13 chore: resync installed Loom surfaces
    <!-- loom:provenance v1 build=unknown f57244868aa20ef22c18aa8025972184aaea43e4 clean prompts=none sweep=none story=none trace=8e03b78fe6cb43a017c4a4823362ffa7 host=loom-worker-2 base=773caace451335921ef2bf7553828f60e87692d9 run=loom-run/v1:timer:loom-worker-2/fleet-resync:eb553d2fc2a54589aa37879f12b18ed5 installs=0.19.1151 a9d9bfc13e966655d6d847cb6876af523bc4a4c4 -->
    Loom-Trace-Id: 8e03b78fe6cb43a017c4a4823362ffa7
    Loom-Build: unknown f57244868aa20ef22c18aa8025972184aaea43e4 clean
    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
2026-10-13 chore: resync installed Loom surfaces
    <!-- loom:provenance v1 build=unknown 6fe43c87955e02019c2bc8dfad4fbd160b89170c clean prompts=none sweep=none story=none trace=49a4590bf54e81899c26d965f682504c host=robb-studio base=79f1decff18e0e04a4ef6451e992508b51fdc671 run=loom-run/v1:timer:robb-studio/fleet-resync:459197b3-0050-4335-893e-e47b638eb819 installs=0.19.1151 4bba3857a22eb3081c693ff4c5953e9ffb74072b -->
    Loom-Trace-Id: 49a4590bf54e81899c26d965f682504c
    Loom-Build: unknown 6fe43c87955e02019c2bc8dfad4fbd160b89170c clean
    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
2026-10-13 chore: resync installed Loom surfaces
    <!-- loom:provenance v1 build=unknown 5dc3a07d084d0ec4034f0782d572925dcad86af7 clean prompts=none sweep=none story=none trace=cbc11657acadf58858409fe543c342e1 host=robb-pro base=d89da4b0051dea1ef4194f5ffc17d4f2dce3ea3a run=loom-run/v1:timer:robb-pro/fleet-resync:be586137-d91e-4e2c-82d6-3164d43aa9de installs=0.19.1152 2d5fe17958dca799058f16bdd74a12336990bec0 -->
    Loom-Trace-Id: cbc11657acadf58858409fe543c342e1
    Loom-Build: unknown 5dc3a07d084d0ec4034f0782d572925dcad86af7 clean
    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
2026-10-13 chore: resync installed Loom surfaces
    <!-- loom:provenance v1 build=unknown 27a266d5a27885323290840d2a837d73fcf4bcc6 clean prompts=none sweep=none story=none trace=e77cdd5477ef6bfc65fba6cc233788e0 host=loom-worker-2 base=dfd5cc572d177e5fe216e70276c8eb3363386b5c run=loom-run/v1:timer:loom-worker-2/fleet-resync:7fac7d82f298441a91761382ac989183 installs=0.19.1152 8d16eec5f10d705602ac4d1ab871c57266f1aa45 -->
    Loom-Trace-Id: e77cdd5477ef6bfc65fba6cc233788e0
    Loom-Build: unknown 27a266d5a27885323290840d2a837d73fcf4bcc6 clean
    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
2026-10-13 chore: resync installed Loom surfaces
    <!-- loom:provenance v1 build=unknown f2b62a2cf576d7d37092147b2281da809f8b5cf5 clean prompts=none sweep=none story=none trace=8adfa75521c72dded43e2932febb6329 host=loom-worker-3 base=eecbdd638aa2e704790c52762ab72f90e367eb4d run=loom-run/v1:timer:loom-worker-3/fleet-resync:8a8198f8f80e4703bc7365a5e10595e0 installs=0.19.1152 a7c20e591a04d4acaeeca29fadd7fa4be7ca3122 -->
    Loom-Trace-Id: 8adfa75521c72dded43e2932febb6329
    Loom-Build: unknown f2b62a2cf576d7d37092147b2281da809f8b5cf5 clean
    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
2026-10-13 chore: resync installed Loom surfaces
    <!-- loom:provenance v1 build=unknown 84d11f248d368cae5e04a2255f6897a406c50089 clean prompts=none sweep=none story=none trace=8e50b4ccc3dc58f709a732f69d58fd44 host=robb-studio base=abf1798af559394b84d01ee40fe8844f873dd38c run=loom-run/v1:timer:robb-studio/fleet-resync:05c9f3b1-eee2-412f-8996-5fbf02793d9e installs=0.19.1153 d8429a4fabdc955107af1cbc22c548e23eecf9b1 -->
    Loom-Trace-Id: 8e50b4ccc3dc58f709a732f69d58fd44
    Loom-Build: unknown 84d11f248d368cae5e04a2255f6897a406c50089 clean
    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
2026-10-14 sim: batch klt pex campaign attempt for item 7 (blocked: fleet lacks gf180mcuC) (#70)
    Loom-Build: 0.19.1157 3e3ff8aa9b674281336009ed9b92693dd038f9e9 clean
    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
2026-10-15 docs(spec): DR-0024 rcosc_top stays free-running, no enable pin (#131)
    Records the operator ruling (option a): no enable/standby pin, Iq-off not a
    specified quantity. Startup origin stays with #82 / DR-0020, not amended.
    Closes #131
    Loom-Story: 2AMLogic/gf180-rcosc#131
    Loom-Trace-Id: 25c2a055a6496e9b5d96842ec993e4bc
    Loom-Build: 0.19.1166 8a9aad12e32504cea9a7c7d2ed774749c487f875 clean
2026-10-17 docs: update WORK_PLAN from current label state
    Automated document maintenance by Guide triage agent.
2026-10-17 feat(mc-groundwork): add --inject-mismatch flag wiring the DR-0022 injector into gen_bench
    Default-off flag writes _inj-suffixed benches/requests and per-bench
    mismatch manifests; offline tests added to the mc-groundwork CI job.
    Includes the diagnostic from the failed batch smoke (runner lacks PDK).
2026-10-17 docs(signoff): record item-6 groundwork status and list the MC diagnostic as a probe
2026-10-17 sim(mc-groundwork): record retried batch smoke as a second diagnostic
    Retry of the injected-mismatch smoke on the batch fleet still fails before
    ngspice: the runner image has no gf180mcuC PDK. Committed as an append-only
    diagnostic and listed as a probe; no local multi-sample fallback was run.
    Part of #186
2026-10-23 feat(sim): store new campaign evidence via klt artifact, commit only manifests
    Port the fail-closed evidence writer and manifest checker; the pvt, iq,
    pvt-postlayout and recentre drivers now stage raw output in git-ignored
    scratch and commit only a manifest and the run summary. Adds a CI check.
2026-10-27 chore: move klt pins to 0.8.0 and refresh signoff evidence
    Bumps the signoff workflow install, the ERC step in run_checks.sh, and the
    signoff docs/install hints to klayout-tools 0.8.0. The workflow bytes changed,
    so the repo-hygiene envelope, manifest pin and report are refreshed together.
2026-11-04 refactor: share git HEAD/dirty capture across sim drivers via git_provenance
    Replace seven per-driver rev-parse/status copies with sim/git_provenance.py:
    explicit 60 s timeout, failure is exactly 'unknown' (sha) / dirty=True,
    never an empty string. Manifest key names are unchanged.
2026-11-06 feat(sim): 63-point startup factorial on batch fleet, DR-0020 ratified
    Ran sim/startup requests v30/v33/v36 through klt sim on the batch backend
    (runner v11, gf180mcuC). Under the ratified relative-settling definition the
    result is 61/63 PASS; ff/-40C at 3.3 V and 3.6 V fail the settled-tail
    steadiness check. Adds append-only results, updates README, inventory and
    DR-0020 status. Relative settling does not imply a target-accurate or
    USB-ready clock.
2026-11-06 sim(item5): run 15-envelope corner campaign on the settled P3 netlist, cite in manifest, regrade
    Regenerate the item-5 requests on the DR-0023 P3 extracted netlist (code 0xA9),
    run them on the batch fleet (315 points), add per-row verdicts with binding
    corners, cite the envelopes with per-citation rows and declared gaps in
    signoff/block-manifest.json, and regenerate signoff-report.json. Item 5 stays
    unmet (check_failed): fs/-40C does not oscillate at VDD>=3.3V, and rows 2, 4,
    5, 8 fail on the ratified numbers (no spec relaxed).
2026-11-06 Address review: refresh signoff evidence for new startup run
    - citations.json: startup current -> 20261106T052948Z (prior dir kept as probe)
    - testbench-envelope.json + block-manifest.json: re-pin testbench-inventory.md hash
    - signoff-report.json: re-graded with pinned klayout-tools 0.8.0; grade unchanged (8/11 met)
2026-11-06 sim(startup): root-cause fs/-40 C no-oscillation on settled netlist, run settled startup bench
    Single-corner probes show the stall is a real failure of the settled P3
    netlist (comparator-H output stage), not a simulator artifact; startup
    bench on the settled netlist run on the batch fleet (61/63, 2 NON-START).
    Row 9 of the item-5 map now cites measured evidence.
2026-11-06 sim(trim-transition): converge lsb_first bench with 50 ohm select drivers, run nine-corner x three-skew campaign, add DR-0027
2026-11-06 sim(trim-dense): accept permuted DUT pin order, record Step 0 batch gate on gf180mcuC
    prepare.py now builds the testbench instance from the netlist's own pin order
    (P3 is vdd vss clk t0..t7). Step 0 single-corner batch job klt-sim-9f035a0aab64
    passed on the klt 0.9.0 runner. The 1536-job campaign is not run.
2026-11-06 fix(comparator): narrow the comparator-H output pull-down so a logic high is produced at fs / -40 C
    At fs / -40 C and VDD >= 3.3 V the comparator-H output inverter landed at
    0.5-0.7 V, the SR latch never set and the oscillator never started. Bisecting
    the settled netlist shows none of the three DR-0023 changes is the cause (the
    committed extraction already fails); the stuck state is a coexisting stable
    point of the output stage. MBUFN W 2u -> 1u raises the inverter trip point.
    - design: schematic + regenerated netlists (klt netlist), tracked schematic
    bench copies and their provenance pins refreshed
    - layout: comparator and top GDS rebuilt with the pinned toolchain; DRC clean,
    LVS match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
2026-11-06 fix(signoff): re-pin layout evidence to the rebuilt GDS and regenerate mc-groundwork default benches
    - signoff: respell the nwell tie (tap_layer 22/0 + tap_requires 32/0) so the pinned
    klt 0.8.0 erc grades it instead of skipping it as degenerate; regenerate the ERC
    report, re-pin items 2/3/11 to the new GDS hash, re-grade (8/11 met, unchanged)
    - sim/mc-groundwork: regenerate the three tracked default benches (MBUFN W=1u);
    archived results/ copies untouched
2026-11-06 sim(mc): run the item-6 Monte Carlo campaign on the P3 netlist and grade it with klt yield
    500 samples per process corner (tt/ff/ss), seed 20261008, DR-0022 injected
    ladder/MIM mismatch plus PDK MOS mismatch, per-die calibration then hold over
    3 supplies x 3 temperatures; zero, 3x-inflated and injected-term sensitivity
    controls; klt yield reports per row set cited in the signoff manifest.
2026-11-06 docs(signoff): cite the item-6 campaign, add DR-0029, merge main
    Cites the nine klt yield reports under evidence 6 with spec_rows 2/4/5,
    re-pins the testbench envelope for the new inventory rows, regenerates
    signoff-report.json with the 0.8.0 pin (item 6: unmet,
    negative_control_not_detected), and records the campaign in sim/mc/README.md
    and DR-0029 (ratified spec unchanged).
    Loom-Issue: 2AMLogic/gf180-rcosc#202
2026-11-06 sim(item5): re-centre calibration code to 0xA4 after the comparator-H fix and re-run the campaign (DR-0029)
2026-11-06 fix(signoff): point item5 citations sidecar at the new 20261106T071555Z run
    The pre-fix run moves to probes so ROWS.md can keep citing it.
2026-11-06 sim(trim-dense): add resumable batch driver for the 1536-request dense campaign
2026-11-07 sim(trim-dense): run campaign slice 10 on batch fleet (jobs 262-289 of 1536)
    28 more single-corner jobs on the batch fleet (ext / ss / -40C / 3.0V,
    codes 0x05..0x20), all done; append-only into the frozen-manifest campaign
    directory. Run stopped by the host time limit before the 40-job slice
    completed; 12 jobs deferred. No step/monotonicity claim.
    Part of #87
2026-11-07 refactor(sim): share sha256, evidence banner and new-run guard in sim/evidence_common.py
    Replaces per-driver copies with one stdlib-only module next to git_provenance.
    Banner string is byte-identical; the trim-dense empty-dir exception stays local.
2026-11-08 docs(startup): address ratification-key feedback on DR-0020 / row 10
    - say 'simulated', not 'measured' (DR-0020, inventory, startup README)
    - label run 20261106T052948Z as the pre-re-centre schematic at 0xA3 (history)
    - record current-design startup evidence (sim/startup-settled, 0xA9) in row 10
    - state both trim codes (0xA3 ruled, 0xA9 current) and leave the choice to the operator
    - update characterization report row 10 / sec 7, sim/README, signoff README
    - re-pin envelope/manifest hashes and regrade signoff report (klt 0.8.0)
2026-11-08 docs(spec): renumber the item-6 Monte Carlo record 0029 -> 0030
    main already holds 0029-calibration-code-after-comparator-h-fix (#235).
    Rename only: filename, title, spec/README index row and the DR-0029
    citations that refer to the Monte Carlo record (signoff/README.md,
    signoff/testbench-inventory.md, sim/README.md, sim/mc/README.md).
    Record content and results are unchanged; no ratified row touched.
2026-11-08 signoff: re-pin testbench-inventory hash after the DR renumber
    The 0029 -> 0030 citation edit changed testbench-inventory.md bytes; the item-9
    envelope, manifest pin and signoff-report.json are refreshed together
    (klayout-tools==0.8.0). Grade unchanged: 8/11 T1 items met.
2026-11-09 sim(trim-dense): commit slice 23 per-job reports (jobs 480-495)
    Address review feedback on #278: the 16 ledger entries reference
    reports/report_ext_ss_m40C_3p0V_c{DF..EE}.json, which were left
    untracked. Pure additions; no rerun.
2026-11-09 sim(trim-dense): run campaign slice 25 on batch fleet (jobs 512-527 of 1536)
    Completes the ext ss/-40C/3.0V curve (0xFF) and starts ext tt/27C/3.3V
    (0x00..0x0E). Per-job reports committed with the ledger entries.
2026-11-10 spec: correct DR-0030's every-die claim and link DR-0029
    The operator ratified DR-0030 in the attended /fleet:decide round
    20261110-r12 q22 (2026-11-10), with two text fixes first.
    - 'exceeds +2.0 % on every die' is false: the ss results show 477 of
    500 dies above +2.0 % (minimum +1.82 %). Both keys flagged it, and the
    market key made it a required change. The conclusion stands, because
    every die still violates the window on one side or the other.
    - Link DR-0029, which re-grades rows 4 and 5 on the DR-0028 netlist at
    code 0xA4 and finds them still failing.
    No number, verdict or other text changes. Both keys are at 3f0ae9c.
2026-11-11 refactor(layout): remove unused Composer.wire_l and wire_z helpers
    Both were only used by the superseded planar trim bank (#13); no callers
    remain. wire_segment is kept. README history sentence reworded.
2026-11-11 fix(signoff): re-pin testbench-inventory hash after DR-0020 prose edit
    Refresh contract (signoff/README.md): inventory edit re-audited (prose only),
    new sha256 written to the item-9 envelope and manifest pin, report re-graded
    with klayout-tools==0.8.0. verify-report.py exits 0; 8/11 met unchanged.
2026-11-12 feat(sim/mc): add --dut and --out to the campaign generator
    The Monte Carlo generator hard-coded the pre-DR-0028 P3 netlist and wrote
    next to itself. --dut selects another netlist (recording its path and
    sha256 in the mismatch manifest) and --out redirects the output, so a
    campaign on the DR-0028 netlist no longer rewrites the tracked inputs of
    the DR-0030 evidence. Defaults are byte-identical; run-campaign.sh gains
    --dut and uses --wait-for-capacity 600.
2026-11-12 docs(spec): record rows 4/5 Monte Carlo on the DR-0028 netlist (DR-0032)
    Per-die-calibrated campaign on sim/cmph-fix: row 4 still fails at ss
    (0 %, span 5.5-6.7 vs 4.9 points) and row 5 at ff (92.6 %, 85 C / 3.0 V).
    Adds the new evidence runs, the decision record, index row and README
    pointer. No ratified row is changed.
2026-11-12 fix(signoff): move mc citation sidecar to the DR-0032 campaign
    Set mc current to 20261112T060000Z (graded yields on the DR-0028 netlist),
    list 20261112T025135Z (raw reports) and the prior 20261106T072000Z as probes.
    python3 signoff/verify-doc-citations.py passes.
2026-11-12 docs(spec): stage-level attribution of rows 4/5 on the DR-0028 netlist (DR-0033)
    Probed-DUT stage-event benches (27 points, batch fleet), exact per-stage
    frequency attribution, and one candidate lever per failing cell.
    Closes #314
2026-11-12 spec,sim: record that doubling the bank pass-gate widths cuts the ss supply span only 0.69 pt
    Adds the sim-only variant re-run (calibration scans, 9-request stage re-run) and DR-0034;
    no design change is adopted.
    Part of #317
    Loom-Issue: 2AMLogic/gf180-rcosc#317
2026-11-12 fix(doc-citations): resolve suffixed run-dir names; cite w/calib/stage dirs in full (DR-0034)
    The checker's timestamp token stopped at the bare <ts>, so a cite of a
    suffixed run dir (20261112T083000Z-w2) was checked as the nonexistent
    bare dir. The token now carries the dir suffix and the full name is
    checked. Brace shorthand (-w{1.5,2,3}) in the row4-ron README and DR-0034
    is spelled out as explicit dir names. No sim evidence touched.
2026-11-12 sim(row4-nonron): isolate the ss supply term to the bank pass gates; record re-centred 3x-W candidate (DR-0036)
    Knock-outs show parasitic C is not the cause, ideal switches remove the RC-term
    span, and DR-0034's weak 2x-W result was a per-die code shift. Simulation-only;
    no design change.
2026-11-12 sim,spec: record that comparator-H mirror-load L and tail current are the row-5 ff hot/low-V lever
2026-11-12 sim: row-5 comparator-H mirror-load L 0.7 um stage re-run clears ff hot/low-V (+6.93 -> +1.65 pt); DR-0038
    Part of #321
2026-11-12 feat(design): comparator-H mirror-load L 1.0 -> 0.7 um in schematic and regenerated netlists (DR-0039)
    MLOADA/MLOADB L=1u -> 0.7u in design/rcosc_comparator.sch; netlists
    regenerated via klt netlist; five tracked bench copies and two provenance
    pins refreshed so netlist-consistency passes. Layout/LVS not rebuilt and no
    new SPICE run (stated in DR-0039). Part of #321.
2026-11-12 sim: regenerate mc-groundwork benches for comparator-H L 0.7 um (DR-0039)
    gen_bench.py inlines the DUT from design/netlist/pvt_tb.spice, so the
    committed generated benches must follow the netlist change. Only the
    XMLOADA/XMLOADB lines change (L=1u -> L=0.7u); results/* untouched.
    DR-0039 now enumerates the three regenerated benches.
2026-11-12 sim: re-confirm comparator-H mirror-load L 0.7 um on the real schematic netlist (DR-0040)
2026-11-12 sim: row-5 comparator-H L 0.7 um trim range and running Iq on the schematic netlist (DR-0041)
2026-11-12 layout: rebuild comparator-H for mirror-load L 0.7 um; DRC clean, LVS match, re-pin signoff (DR-0042)
    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
2026-11-12 sim: re-confirm comparator-H L 0.7 um on the extraction of the rebuilt layout, ff 85 C / 3.0 V +1.66 pt (DR-0043)
    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
2026-11-14 refactor(layout): collapse the trim bank's duplicate MOS reference-card writer
    `_trim_mos_ref_card` was byte-identical to `_mos_ref_card` apart from its
    final f-string: it re-emitted `W`/`L` from the parsed micrometre value
    (`:.6g` + `"u"`) where `_mos_ref_card` passed the schematic literal through
    verbatim. Both applied the same two disclosed reference-form rewrites (NMOS
    body -> `vsubs`, `nf=1` at the schematic's total W), so the design carried
    two copies of the same card writer across five call sites — a drift hazard
    for the LVS references that the whole layout sign-off compares against, and
    that are hashed evidence under `signoff/`.
    Unify on the re-emitted spelling, which is a measure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
